JeffreyLiang3449/HFCV-Website/README.md

# Swarthmore College Shell Eco-Marathon Team

Welcome to the Quarto website for Swarthmore College's Shell Eco-Marathon team! This website is documentation for all of the work that has been done to build and maintain the hydrogen fuel cell vehicle (HFCV) that belongs to Swarthmore College's Shell Eco-Marathon team.
