JeffreyLiang3449/HFCV-Website/2024 E90 work/Chassis Model/Chassis Drawn Design.qmd

---
title: Chassis Drawn Design
resources:
  - "Chassis Drawn Design.pdf"
---

{{< pdf "Chassis Drawn Design.pdf" width="100%" height=700 >}}
