JeffreyLiang3449/HFCV-Website/Chassis/Drawings/Rear Connector Dimensions and Quantities.qmd

---
title: Rear Connector Dimensions and Quantities
resources:
  - "Rear Connector Dimensions and Quantities.pdf"
---

{{< pdf "Rear Connector Dimensions and Quantities.pdf" width="100%" height=700 >}}
