JeffreyLiang3449/HFCV-Website/2025 E90 work/Proposal/Salas.Moran.Draft_Project_Proposal.qmd

Engineering Design Project Proposal (draft)

Hydrogen Fuel-Cell Vehicle

Swarthmore College Engineering

December 2024

By Michael Moran Bojorquez '25, Gabriel Salas Carrillo '25

Advisor: Carr Everbach

**Abstract**

This project aims to revitalize the Hydrogen Fuel-Cell Vehicle through its redesign and reconstruction in preparation for the 2025 Shell-Eco Marathon competition. This work will provide key experience in vehicle designing with an emphasis in optimization and fuel-efficiency. It will also further the work into alternative fuel sources and their effectiveness. The project will be accomplished through a mix of literature review, design planning, manufacturing, assembly, and testing. This work will also make use of the research and work done in the previous year to improve the design of the vehicle while also adapting it to the 2025 competition standards. All to create the most safe, simple to drive, and fuel-efficient vehicle possible within the project's time. This project also continues the previous goal of attracting interest and participants to the Hydrogen Fuel-Cell vehicle effort and the creation of a competitive team to annually enter the Shell-Eco Marathon.

**Introduction**

Climate change has progressively become a significant crisis in today\'s world due to a councering increase in the amount of carbon dioxide emissions due to fossil fuel combustion. Gasoline powered vehicles are a major contributor to the acceleration of global warming, leading to extreme weather conditions, rising sea levels, and other economical concerns. The automotive sector being a big contributor has resulted in the advent transition into renewable energy sources, one of them being hydrogen powered vehicles. This greener alternative is a promising solution and a great alternative to gasoline and diesel engines. Through the usage of hydrogen powered vehicles, it can be expected that the contribution to climate change would be lowered.

Hydrogen fuel cells convert hydrogen gas into electricity through an electrochemical reaction. The byproduct of this energy source is water vapor, which is a great alternative to the byproduct of gasoline and fuel which results in carbon dioxide. By converting hydrogen fuel cells it targets to reduce the amount of greenhouse gasses being released into the atmosphere. This urgent

Discussion points (cont talk):

- What is the shell eco marathon competition

- What is focus of the project

- Approach we will take

- Project objective

- Long term vision/expectations (what does it mean to meet expectations)

**Discussion**

The shell eco marathon competition has changed due to new restrictions and rules implemented for the 2025 race. The hydrogen vehicle that Swarthmore College is currently in does not meet the requirements to be able to compete and be successful. To begin, there are many safety issues with the vehicle that will be addressed as the new design of the car is implemented. The vehicle is also very heavy along with having outdated design. The car is able to drive, however in order to compete and strive to win, a lot of new mechanisms need to be set in place that are lightweight and more efficient. The objective of the project is remodel the vehicle with a new design that will ensure success. The following are a list of objectives to be designed and implemented over the given time-line.

- **Chassis and Cowl**

<!-- -->

- **Steering**

<!-- -->

- **Suspencion**

<!-- -->

- **Hydraulic Breaking**

<!-- -->

- **Safety requirements**

**Requirements and Constraints**

The requirements and constraints for the Hydrogen Fuel-Cell Vehicle are defined not only by the physical constraints involved in building a vehicle, but also by the safety and regulations outlined by the Shell-Eco Marathon rules. Below is a list of the major requirements and constraints.

- ***Timeline:*** This is a semester long project, as such, we only have approximately three and a half months to complete the design and construction of the vehicle. The project completion deadline is by the end of April 24, giving enough time to prepare a presentation and a report of the results.

- ***Vehicle Dimensions Constraint:*** The vehicle must be within the specified dimensions for the Shell-Eco Marathon

- ***Vehicle Mechanics:***

  - **Power -** The vehicle is equipped with a 2019 model of Horizon's H-1000 Fuel Cell stack, due to budget and design constraints this fuel cell will not be altered throughout the project. This serves as a limiting factor on the speed and power produced by the vehicle.

  - **Suspencion -** The Shell-Eco Marathon regulations require the integration of suspensions for each wheel of the vehicle. The suspensions were already ordered during previous year's and summers project, so no other suspension will be used for this project.

  - **Steering -** The steering system has been designed, however, it has not been integrated. As such, this will be a constraint due to the need of designing the other components around the already existing steering. However, modifications for the steering system are not out of the question.

  - **Hydraulic Breaking -** Two out of the three vehicle wheels still need the integration of a hydraulic braking system.

- ***Weight Constraint:*** an objective of the project is to lower the weight of the vehicle by a minimum of \~50 lbs. The competition has weight restrictions that must be met.

- ***Budget Constraint:*** As a team of two, our budget is a combined total of 800 dollars.

- ***Safety Constraints:*** Vehicle should be able to break within a determined range and speed. Cowl and roll cage should be rigidly attached to the vehicle and not deform under pressure. Front of the vehicle must be able to crumple to a certain extent to reduce forces on the driver. A fire shield must be implemented between the driver and power cell. Vehicle must also be equipped with a fire extinguisher. Finally, the driver must be able to swiftly and safely exit the vehicle.

**Project Plan**

Timeline (Broad: exact dates TBD):

- Test if fuel-cell works

<!-- -->

- Gain experience soldering + 3D design as well as machining

- We have the chassis design, we need to construct it (important for further implementation)

  - Test integrity of chassis (is it able to hold the driver without crumbling?)

- Design suspension and steering attachments to chassis (can be done while constructing chassis)

  - Test design of suspension before integrating

- Attach the suspension to vehicle

- Integrate braking system after suspension has been implemented

  - Test design for braking systems before attaching to the car - how well does it work? How much friction does it apply before car fully stops

- Attach steering design

  - Test vehicle as a whole (is it able to run? Turn? Break?)

- Design vehicle cowl (and roll cage if needed)

  - Use cad and software to test aerodynamics of vehicle and cowl design. wind-tunnel ?

- Attach vehicle cowl and roll cage

- Run general vehicle tests

- If all is well - work on comfortability and aesthetics.

**Plan Evaluation of Prototypes:**

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

*Summary / Overview:*

- Run multiple trial laps around Whittier parking

  - See if vehicle is able to complete the lap without damage

  - Make necessary adjustments

  - Bumps around the path surrounding Singer will allow for testing suspension

    - If the bottom of the car touches the floor the suspension fails the test

- Test rigidity of suspension and wheels

  - Apply decent force to make sure neither part wiggles too much or detaches from frame

- Build a design with a goal in mind, assemble it, and check if it works

  - Minimum of 3 designs before choosing final product

  - Each design must address a different target/issue

  - Try to aim for simple design that meets requirements

- Communicate with J from the machine shop to get advice given his knowledge on ATV vehicle assembly.

- Steering system must be able to attach to suspension, frame, and wheels

  - Comfortability of use is a must given the limited space available to the driver.

  - Different heights for the steering wheel. Can it be adjusted as needed?

**Project Qualifications**

**Gabrial salas:**

Relevant coursework:

- ENGR 006

- ENGR 012

- ENGR 059

- ENGR 086

Relevant experiences:

- Soldering experience

- CAD design

- Truss Design

- Vehicle Dynamics

- Mechanical Vehicle work

Goal: Design and construct the necessary components for the vehicle to be driven safely. Also improve the performance of the vehicle, with the baseline being the end design from last year. Finally, gain experience in manufacturing and design with an emphasis on efficiency.

**Michael Moran:**

Relevant coursework:

- ENGR 006

- ENGR 012

- ENGR 060

- ENGR 086

- ENGR 087 (Future class)

- ENGR 093 (Directed Reading - Dynamical systems continuation from E86)

Relevant experiences:

- CAD design

- Knowledge on mechanics (vehicle work)

- Welding

- 3D design and printing

- Truss design

Goal: construct the necessary mechanical components of the steering for the vehicle along with the overall design of the vehicle for optimal implementation and aerodynamics of the vehicle. A minor goal is to apply knowledge of mechanics of objects to increase performance of the vehicle.

**Costs and Budget**

+:-----------------------------------------------+:------------------+:------------------+:------------------------------------------------------------------------------------------------+
| **Item**                                       | **Quantity**      | **Price**         | **Notes**                                                                                       |
+------------------------------------------------+-------------------+-------------------+-------------------------------------------------------------------------------------------------+
| Misc materials for testing and implementation: |                   | *200*             | Aluminum and carbon fiber components, bolts, and other misc materials                           |
+------------------------------------------------+-------------------+-------------------+-------------------------------------------------------------------------------------------------+
| Carbon fiber wrap                              | **20 sheets**     | *500*             | Need to wrap car in carbon fiber for lighter weight implementation (replaces aluminum chassis). |
+------------------------------------------------+-------------------+-------------------+-------------------------------------------------------------------------------------------------+
| New helmet                                     | **1**             | **\~**100         | Old helmet is missing and does not meet safety standards.                                       |
+------------------------------------------------+-------------------+-------------------+-------------------------------------------------------------------------------------------------+
| **Total Cost**                                 | **800**                                                                                                                                 |
+------------------------------------------------+-----------------------------------------------------------------------------------------------------------------------------------------+

Appendix A: source on suspension

- [[https://books.google.com/books?id=L_dqjIjOGBcC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]{.underline}](https://books.google.com/books?id=L_dqjIjOGBcC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)
