JeffreyLiang3449/HFCV-Website/2025 E90 work/Designs/Brake/Brake Stand Drawing v1.qmd

---
title: Brake Stand Drawing v1
resources:
  - "Brake Stand Drawing v1.pdf"
---

{{< pdf "Brake Stand Drawing v1.pdf" width="100%" height=700 >}}
