JeffreyLiang3449/HFCV-Website/2025 E90 work/Designs/Suspension/Suspension Plate Drawing v1.qmd

---
title: Suspension Plate Drawing v1
resources:
  - "Suspension Plate Drawing v1.pdf"
---

{{< pdf "Suspension Plate Drawing v1.pdf" width="100%" height=700 >}}
