JeffreyLiang3449/HFCV-Website/2026 Shell Eco Marathon/HFCV_ Instuctions for 11_5_.qmd

2 people will continue to drill holes to clear supports in the clips.

> Make sure drill bits are the right size. Small holes and the big holes in the middle of the bottom floor clips are different sizes

Install new suspension into frame

Top floor is placed on top of the car

Bottom floor is set on the side

Line all floor pieces with \~2in. blue tape border to mark where to drill holes for clips

Mark where flat cowl connectors will go between bottom floor pieces approx 1 connected every 3 ish inches. See diagram below

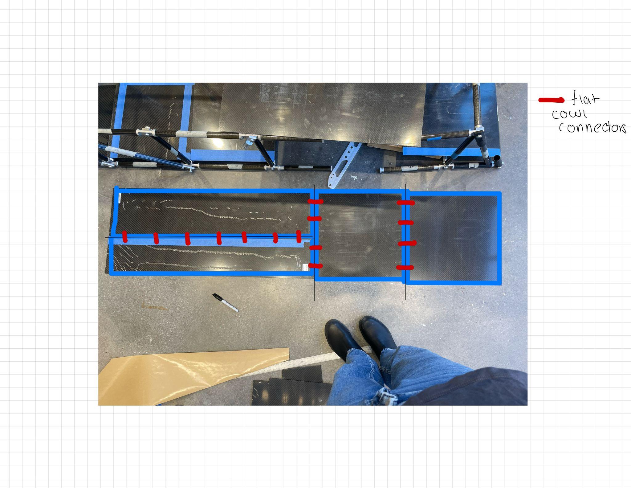
[picture p19: 2026 Shell Eco Marathon/media/media/image1.jpg]
