JeffreyLiang3449/HFCV-Website/2026 Shell Eco Marathon/HFCV_ Freshman Interviews.qmd

Notes about individuals

Questions:

Ask about themselves

Where are you from

How your classes

What are you interested in

Actual Content

What are you interested in

What prior experience do you have

How well do you take direction

How well do you work by yourself or in a team

What do they prefer

Reiterate commitment (2-3 hrs per week) (multi year)

1.  ~~Bowen Shi~~

- F1 in school - testing engineer

- Mechanical Engineering

  - aero/fluids

  - ANSIS experience

- Little to no fabrication experience

  - Some materials testing

- More interested in design

- Potentially an option for a driver

2.  **Rawasy Almaksoudi (6)**

- Not a freshman

- Career goal: Biomechanical

- Mechanical interest

- Robotics Background FRC Mojo 8085

- Interested in running the club

- Fabrication experience

  - Epoxy resin

- Would be willing to do the admin/sbc work

3.  Isabella Hemler (Izzy)

- Freshman

- Career goal: Civil Engineering

- Moldable background

  - Fabrication experience

- Maybe have joining just see if engineering is a fit

- Odyssey of the Mind (Car problem)

- Maybe driver, needs a driver license

  - We can figure that out

- Buddy

4.  **Kinley Zangmo**

- Bhutan

- E17, Physics 5, Math 15

- Engineering + Physics

  - Mechanical + Aero very moldable

- Panoptis Project

  - Build telescope

  - **Hardware + wiring**

- Driver, but is perhaps too light

- Willing to explore admin

- Jano replacement

5.  **Sean Tian**

- Freshman

- Chem 11, E17, Math 27

  - At multi

- Engineering + Physics

  - Robotics

  - Mech + Computer + Electrical

  - But doesn't really know

- FRC 6907

6.  **Stella Saad**

- Freshman

- Engineering School Background

- Engineering, Chem bio double minor, maybe neuro

  - Want to take more mechanics

  - Elecrtrical background

- Soldering experience

- Chem 10, Math 15, Econ 1, E17

- Soccer player

- Willing to contribute time

7.  Avian Pham (?)

- Texas

- Freshman

- Engineering and Astrophysics

  - Space research

  - Aero

- Fabrication

  - Engineering in HS

  - Set Crew

  - Scene Student Tech

  - Wood

  - Metal

- Has time

- Fire safety experience

8.  Magnus Julin

- Freshman

- Engineering + CS

  - ambiguous

  - Electrical - like the puzzle aspect

  - Motorsport interest

- Circuits + EE course

- Design with CAD

  - Went andover

- Rockets (?) + robotics

  - FRC

- Not a lot of work in a team

- Fabrication

  - Power tools

  - CNC

  - Epoxy resin

  - Works on cars

9.  **Matthew Kim**

- Engineering and CS

  - Mechanical + aero

- Irving California

- Swim team

  - Chooses to do IM

- Discipline

- No "prior" experience

  - Admin work (HUGE)

10. David Nuth

- Quiet

- Engineering and Japanese (minor)

  - Mechanical/Aero

- Highschool Robotics

  - Build Captain for VEX

  - FRC 6833 + VEX (VRC)

  - Cutting and bending metal

    - standard , no cnc

- Aerodynamics

- Fencing on campus

- Working on more of the car parts

  - Braking

  - Steering

11. Ben Greenberg

- Chem 11, E17, Math 25, FYS

- Mechanical Engineering

  - Just generally for now

  - No idea what career, maybe hardware

- Highschool

  - FRC 5490

    - Small team

    - Showed up everyday

    - Take direction weel

  - Ceramics + Photography

  - Tennis - Doubles

- Ceramics club here

- Research with Towles

  - Opera

- Boxing Club

- Modeling/3D printing focused

12. Jose Quiroz Mariche

- E17, Math 15, PHYS 003, Logic

- Mechanical

  - Things that move

  - Not super analytical

- Just engineering

- Prior Experience

  - EPICS projects

  - ASU

  - Build project that supports community

  - Figure out more seating arrangements

  - Made bench, materials research, budgeting

  - Woodworking

  - 3D modeling

  - Laser

- Some team sport

- Wanted to get involved in photography

13. Nathan Schwarz

- PHYS 005, Linear Algebra, Communism Class

- Physics and Engineering

  - Electrical

  - Energy science - Plasma Physics

- Prior

  - Heavy physics background

  - Circuits backgrounds

    - Radios, etc.

  - Fusion

  - Power lifting

    - Not really a team sport

  - Soccer

- All around a "good" person

- Preference for work

  - LOOKING FOR WORK

  - Fuel Cell

- Interested in how the fuel cell works

14. Auden Seigel

- E17, E11, Linear, Literature and Law (Engl)

- Engineering and Econ

  - More management

- Mechanical Design,

- Want hands on experience in a group

- Willing to admin work

- Prior Experience

  - Electrical foundations but not super interested

  - Sheet metal factory work

    - Floor worker, on **machinery**

    - Shadow main engineers, CAD design

- Highschool

  - Editor of newspaper -\> time sink, staff of 100

  - Sports: Soccer, Lacrosse, Cross Country

- Ok with commitment, expects multi year

- Receptive to how I give work

15. Fate MacAlasdair -no

16. Jasper Goldstein

- E11, E17, Linear, Philosophy

- Engineering + Physics and Math

  - Focus in aerospace/mechanical

    - Interested in space exploration

    - F1

- Prior Experience

  - Engineering and Robotics club

    - Not competitive

  - Hands on experience

  - Design and prototyping

- Aerowork + learning about fuel cell works

- Electrical experience

  - E+M in HS

- Free and happy to learn

- Highschool

  - Community Center Volunteer

  - Track and Field

- Will do track here

17. Nolan Weygandt

- In a History under Stalin and Lenin

- Swimmer 200 IM, 200 back, 200 free

- Engineering + Minor in Math or Physics

  - Nuclear (Fission)

  - Mechanical

- Likes creating

  - Ceramics

  - Leatherworking

- Woodshop certified

- 3D modeling

- Highschool

  - Rocket Club ? Robotics?

  - Swam

  - F1

  - Coaching (6-15)

- Feel comfortable putting things together

- Manufacturing

- Open to most things

18. [[Jasper Mosley]{.underline}](mailto:jmosley1@swarthmore.edu) -yes

    a.  Interested steering and other mechanical aspects

        i.  Experience with calculating steering parameter (steering radius, etc) but this work was done on a tank so slightly different, regardless good experience

        ii. Experience with machining in Jays shop (was working in there all summer) and lots of 3d printing experience

    b.  Lots of planning with multiple iterations, will build and see if it works and if it doesn\'t will rebuild, always keeps lots of documentation etc. (big into and picture taking)

    c.  Lots of engineering projects where he collaborated with people, (the tank he built was with a group),

    d.  Can dedicate several hours a week

    e.  Looking to work on this project junior and senior year and compete

19. Hans

    a.  Interests are more mechanical

        i.  Found interest when building stuff at home and he found it very fun and wanted to continue hands on stuff, excited about the chance to work on a team and have a product he and the team can be proud of

        ii. Excited to learn from others on the team

    b.  Previous projects, built multiple PC's, basic stuff

        i.  Like mounts for stuff

    c.  Skills

        i.  3d printers, soldering

    d.  Has worked on a project where he worked with a group to find an idea, design, and then execute -\> modeled it all in solid works

    e.  Just try something new and experience it, and if he enjoys it he would definitely do it the whole time, hes pretty confident he would work on it a lot

    f.  He is pretty free right now, weekend free

    g.  No preference on what to work on

20. Jonas (freshman)

    a.  Works on cars already

        i.  Usually just mainteneces

        ii. Widebody kit, cold air intake

    b.  Interested in mechanical

        i.  Internship in electrical

            1.  Sustainability consultancy in electrical engineering

            2.  Troubleshooting at project sites, testing hvac site, performed tested

        ii. More interested in elecrtriacl engineerings

        iii. No shop experience

    c.  3d modeling in school,

        i.  Over the summer modeled a prototype for a cash clock

        ii. Small alarm clock with lcd screen, outershell and front shell,

        iii. Design process, asked for a budget

        iv. Then designed it, already knew what pieces to use in that project and them designed a shell on **OnShape** and 3d printed

    d.  Teamwork work in the company that he worked in team with the company

    e.  Available in the evenings after 5pm cause of labs, 4/5 days of week available and weekend too

    f.  He looked into the club and other similar schools and is very interested in working on this for several years

    g.  Interested in aero

21. Jeffery Liang - strong maybe

    a.  Engineering major, potentially physics or cs double major

    b.  Why interested in this club?

    c.  Interested in electrical engineering

        i.  Background in arduino stuff

        ii. 

    d.  Robotics team in highschool

        i.  Vex as coder and builder

        ii. Would sketch out blueprints, based off example and modified those examples to meet thei needs

    e.  Other engineering projects

        i.  Cardboard boat race (part of enigneering) won that race

            1.  Worked on a team

            2.  Helped with calculations

    f.  Engineering team in highschool

        i.  Built lots of things there

    g.  Some engineering modeling

        i.  3d water bottle holder, has had multiple interactions

    h.  Lots of availbailtiy, wants to be part of building team but more interested in electrical componenet, looking to work on this for several years

    i.  Went to poster presentation

22. Evan 10/2

    a.  Not

    b.  No real engineering projects outside of swarthmore class

    c.  Made minesweep in a cs project

    d.  Wordshop certified

    e.  3d printing,

        i.  Mostly callibration stuff

    f.  Interested in anything

    g.  Sophomore year

23. Alex Lyu - ask judah about him

    a.  Thought project was cool, gain engineering experience

    b.  Interested in [electrical part]{.underline}

        i.  No experience

    c.  Highschool anti earthquake design

        i.  Design

            1.  Starting looking at real life models and how they work and how they could be implemented into our models

            2.  Then lots of sketching

            3.  Then started building

        ii. Group of four

            1.  All collaborative

            2.  Likes working in a group, different opinions can learn a lot from other people

    d.  3d printing

        i.  Some experience with 3d printing

    e.  CS experience, some python, some C++

        i.  Might minor in cs

    f.  Pretty much always free at night

    g.  On golf team

    h.  Could work on it all four years
