JeffreyLiang3449/HFCV-Website/2026 Shell Eco Marathon/HFVC Indiana Logistics.qmd

**Hotel:**

[[Holiday Inn Express & Suites Indianapolis W - Airport Area]{.underline}](https://www.google.com/travel/search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)

3 Rooms 4/6/2026 - 4/11/2026

1 Rooms 4/6/2026 - 4/12/2026

[Drivers]{.underline}

Mathew

Eric

Kaw

Kimaru

To Indianapolis: AA 4637, 4/6/2026 6:40pm

> Nora
>
> Kinsley
>
> Izzy H.
>
> Place Holder
>
> Driver 3
>
> Driver 4

*Two separate bookings back to Philadephia:*

AA 5285 4/11/2026 3:54pm

Nora

> Kinsley
>
> Izzy H.
>
> Place Holder
>
> Driver 1
>
> Driver 2

AA 3097 4/12/2026 7:15pm

Alexander Vasquez-Jaffe

Supplemental Funding Request

Hello,

We have recently decided to attend the Shell Eco Marathon Competition in Indianapolis this spring. The competition dates are April 7th to April 11th. The Swarthmore Engineering department has agreed to cover the cost of all flights to and from Indianapolis and all hotels in Indianapolis. They would like SBC to cover the cost of the per diems.
