JeffreyLiang3449/HFCV-Website/Editable Documents/HFCV_Goals and Expectations.qmd

1.  A permanent standing meeting per week.

- I don't see the need to meet if everyone has nothing new to share

- Will figure out a time that works for everyone

2.  Progress over the summer

- Fine tuned manufacturing techniques

- New design because Ben and Justin's did not work

- New suspension, steering, and wheels

3.  Overall Goals for this year

- Chassis

  - At least in the first semester this means mainly structural and mechanical engin. less focused on electrical

    - If have friends interested have them talk/email me

  - Electrical will come into play when chassis is built and we need to wire the new car

- Cowl

  - I have no idea if Roe still wants to do it

  - If not, someone else will

4.  Requirements for now

- Please read the literature in the folder shared

- Talk to J and get used to the manufacturing techniques that are written up

- Any questions, comments, or concerns ask me

  - Try not to bother Jano, let the guy live

5.  Things to work on

- When wheels come in, designing axel to work with suspension and steering

- Fabricating chassis
