JeffreyLiang3449/HFCV-Website/2024 E90 work/Fall _23 Prework/Prototype Rules - Hydrogen Carr.qmd

**Key Things We need to add/test:**

- Mechanicals

  - Monocoque (advantage: crumple design) or chassis

  - Turn Radius Test and Adjustment (currently in compliance)

    - Might want to improve current tie rod system

  - Dimensions of current vehicle **(Sticking with current design)**

  - Hydraulic braking system (need full outfit - possibly bike parts if routing is feasible

    - Potential frame modifications for hydraulic design

  - Single wheel suspension (thinking telescopic fork - think motorcycle suspension)

- Safety systems

  - Horn test

  - Safety belt

  - Roll bar

  - Bulkhead for division of energy and driver systems

- Competition Documentation

  - Energy supply and propulsion system block diagram

    - H2: Fuel cell, cylinder, solenoid valve, pressure regulator, flow meter, motor controller, motor, supercapacitor, vehicle cut-off mechanism

  - Electrical Schematic

  - Battery/BMS (If a Lithium-based accessory battery is included in the vehicle)

  - Brake Documentation

    - Brake Documentation: provide manufacturer's documentation at the lowest level of purchased components. See Articles 43 and 51.

  - Energy Supply and Propulsion System Diagram

  - Fuel Cell

Sources:

Steering systems - [[Steering (springer.com)]{.underline}](https://link.springer.com/content/pdf/10.1007/978-3-662-60835-7_3.pdf)

Goals: New body fuel cell vehicle running(even if crudely) by end of spring semester

- New Chassis

- Suspension + wheels

- Brakes

- Crude turning

- Electrical+Fuel Cell

Design Considerations + Constraints - Body:

Option for taller driver -\> Biomechanics for 6ft person + weight of 250+ minimum

Design for weight as well

All height/length/width specs met

Round tubing design preferred

10 cm Crumple Zone

Wiring and Hydraulic considered and space efficient

Center of gravity consistently low enough to avoid roll

Considerations for wheels + suspension:

Ideal system for speed

~~Current timelines/time estimation:~~

~~Body-\>1 month for execution~~

~~Brakes -\> 1 month for execution~~

~~Tuning -\> 2 weeks~~

~~Safety -\> 1 month for execution~~

~~Brakes/Suspension/Body/Safety/Tuning~~

Article 16: Radio Communication The use of hand-held communications is forbidden in the vehicle. However, the use of a "hands-free" kit is allowed if both hands of the driver remain on the steering system

Article 17: Overtaking a) Drivers are required to give clear passage for other vehicles wishing to overtake. b) Drivers in overtaking vehicles must sound their horn and pass with caution. The Driver of the overtaking vehicle is responsible for the safety of the manoeuvre. c) Drivers of the vehicles being overtaken must use their mirrors and must not change course suddenly. d) On the track, overtaking is authorised on both the right and the left, provided the above-mentioned safety rules are followed.

Article 20: Driver Weight a) **The minimum Driver Weight is: Prototype vehicles -- 50.0 kg**

The Driver Weight is defined as the weight of the person driving the vehicle including full driving gear and communication devices. If the Driver Weight does not meet the minimum weight requirement ballast needs to be fitted to the vehicle. This ballast must be provided by the Team, in form of weightlifting discs or rectangular metal plates. No other form of ballast is permitted. The ballast must be effectively secured to the vehicle to ensure Driver safety in the event of collision or roll-over. For Urban Concept vehicles the ballast must be outside the driver compartment. A seal will be installed around the ballast by a technical inspector and must remain in place during the event. If the seal has been tampered with or removed the vehicle will no longer be valid to compete. The ballast must be in a single pack. c) If a Team has two Drivers and one or both Drivers are underweight, the ballast weight will be based on the lightest driver.

Article 21: Helmets a) For practice and competition, Drivers must wear full-face or three-quarter helmets suitable for motorsport activities. Drivers in the Prototype category must use the three-quarter helmet variety. Helmet certification labels must be clearly readable. Helmets worn by all Drivers will be subject to inspection. Helmets should not have any indentations or cracks and should be in proper working condition as intended by the helmet manufacturer. b) All helmets must be affixed with a face shield (or visor). The face shield (or visor) must cover from the top of the face down to below the driver's nose. Tinted face shields or sunglasses to be worn under the face shield are permitted. The helmets must correctly fit the Driver and be secured by a chin strap. Visors should be free from major scratches and have clear visibility.

Article 22: Driver Clothing a) All Drivers must wear a one-piece racing suit as the outermost layer of clothing, and the racing suit must be classified as Flame Retardant Clothing (FRC) according to a recognised standard. Drivers are not allowed to wear synthetic clothing underneath the race suit because synthetic material may melt if exposed to flames. Cotton shirt and underwear are recommended. b) Socks (made from cotton or FRC material) and shoes are required. c) Fire retardant gloves are required and must completely cover all fingers. d) If Drivers wear balaclavas, they are required to be made from FRC material. e) No bare skin should be visible when the Driver is wearing the racing suit, gloves, socks and shoes.

Article 23: Driver Comfort Please note that in the event of hot weather conditions, high temperatures may affect Driver comfort and potentially cause heat stress. a) It is recommended to properly ventilate the inside of the vehicle to provide cooling to the Driver. b) It is recommended to provide sufficient drinking liquids to the driver for the duration of an attempt. **If fluid containers are provided to the driver(s), these containers must be hands-free. Camel-back style or bottles secured inside the driver's compartment with flexible feed straw are recommended.** c) It is recommended to equip the vehicle with an **effective shield from the sun**. d) For driver comfort, Teams can install fans or air-cooling type systems that are not included in the electrical measurement of the vehicle. Any fans or air-cooling systems must be self-powered by internal batteries. See Article 57i.

Article 24: Equipment and Materials Teams are required to provide and use at the event: a) Leather, canvas or other cut resistant gloves for general work, including movement of vehicle b) Chemical resistant gloves for fuel or motor oil handling c) Safety glasses for all Participants d) Hearing protection for all Participants e) Duct tape to secure cords or cables lying on the pit floor f) Lift stands or appropriate raised platform for vehicle tuning and repairs g) Tools and materials h) Effective equipment suitable to mitigate and/or control Lithium-based battery fires must be used during battery charging. The equipment must prevent or contain the spread of fire or battery event during charging. Equipment that may be used includes: i. A battery charging bag that is designed specifically for containment of a Lithium battery fire, or A fireproof blanket that can be placed over AND under the lithium battery being charged. The blanket must be big enough to fully cover and contain any potential battery fire.

) Electrical safety i. All electrical equipment used must be properly fused. ii. Electrical cables must be in good condition and appropriate for the equipment it is intended for. iii. Teams are only allowed to use the supplied single multi-plug strip with internal overcurrent protection. No further multi-plug strips or other adaptors may be used.

Article 25: Vehicle Design a) During vehicle design, construction and competition planning, participating Teams must pay attention to all aspects of safety, including the safety of the driver, participants, volunteers and spectators. i. Prototype vehicles must have three or four running wheels that are in constant contact with the road. ii. All vehicles must have a minimum crumple zone of 100 mm between the front of the vehicle body and the driver's feet

Aerodynamic appendages, which adjust or are prone to changing shape due to wind, are not allowed. c) Vehicle bodies must not include any external appendages that might be dangerous to participants; this includes pointed parts of the vehicle body. Sharp points must have a radius of 50 mm or greater or be covered with foam or a deformable material. d) Vehicle body panels and windows must be rigid and may not change shape due to wind. e) The vehicle interior must not contain any objects that might injure the Driver in the event of a collision. Windows must not shatter into sharp shards. Protective film covering the windows is allowed but must not distort the driver's visibility. f) The energy compartment (engine/motor/transmission/battery, etc.) should be easy to access for a quick inspection. g) All parts of the drive train, including fuel tank, hydrogen system components, etc. must be within the confines of the body cover. h) All objects in the vehicle must be securely mounted. Bungee cords or other elastic materials are not permitted for securing heavy objects. i) All vehicles must have a solid floor and frame that prevent any part of the driver's body from contacting the ground. j) All vehicles must be fully covered. Open top vehicles are not allowed. Vehicles that look like bicycles, tricycles or wheelchairs are not acceptable. k) The Organisers will provide all Urban Concept vehicles and selected Prototypes with a telemetry System and require them to install it in their vehicle for competition monitoring and result calculation (see Section 5). l) The use of asbestos and asbestos-containing materials is forbidden

Article 26: Chassis/Monocoque Solidity a) Teams must ensure that the vehicle chassis or monocoque will safely protect the driver's body, including crumple space in the event of a front, side, or rollover collision. A monocoque is a construction that supports structural load by using an object\'s external skin as opposed to using a frame. b) The vehicle chassis must be equipped with an effective roll bar that extends 50 mm around the driver's helmet when seated in normal driving position with the safety belts fastened. If this position impairs the driver visibility it will be deemed that the roll bar is not adequate. The effectiveness of the roll bar and driver's visibility will be validated simultaneously, i.e. the driver must not be in such position that he or she must raise their head or torso above the roll bar to pass the visibility test

**c) The roll bar must extend in width beyond the driver's shoulders whe**n seated in normal driving position with the safety belts fastened. Teams may use a tubular or panel roll bar. If a tubular roll bar is used, it must be metal. A panel roll bar is the rigid partition separating the cockpit from the energy compartment, and it must be integrated into the vehicle chassis or monocoque. d) The roll bar must be able to withstand a static load of 700 N applied in a vertical, horizontal, and/or perpendicular direction, without deforming in any direction. e) If the vehicle must be lifted at a specific place on its body, it should be clearly marked with a rectangular box stating, "LIFT HERE".

**Article 27: Propulsion and Energy Storage System Isolation a**) A rigid Bulkhead must safely isolate and seal the vehicle's propulsion and energy storage systems from the driver's compartment. A bulkhead is an upright partition separating the driver's compartment from the energy compartment. This means engines, fuel cells, fuel tanks, batteries (propulsion or accessary), hydrogen cylinders, supercapacitors, etc. must be placed outside the driver's compartment behind the bulkhead. The purpose of this bulkhead is that in the event of a fuel leak, fire or battery release incident, it prevents liquids and/or flames from reaching the driver. Avoid having any gaps or holes between the body and the bulkhead. It is recommended to seal gaps with materials such as metal/aluminium sheeting or aluminium tape. b) The bulkhead must be able to protect the driver from an open flame in the energy compartment. c) The bulkhead must prevent manual access to the energy compartment by the Driver. d) If holes are made in the bulkhead to pass through wires or cables it is essential that the wires and cables are protected by a grommet or similar protective material to prevent chafing or damage. All gaps and holes must be filled.

Article 28: Visibility a) The Driver must have access to a direct arc of visibility ahead and to 90° on each side of the longitudinal axis of the vehicle. The Driver's field of vision must be achieved without aid of any optical or electronic devices. Movement of the Driver's head within the confines of the vehicle body to achieve a complete arc of vision is allowed, but the driver's helmet must always be 50 mm below the roll bar. The side windows tinting must be light enough to allow the driver to be seen from outside the vehicle. b) The vehicle must be equipped with a rear-view mirror on each side of the vehicle, each with a minimum surface area of 2500 mm² (e.g. 50 mm x 50 mm). An electronic device may not replace a rear-view mirror

**Article 29: Safety Belts Roll Bar & Safety Belts a**) The Driver's seat must be fitted with an effective safety harness with at least five mounting points to maintain the Driver securely in his/her seat. The five independent belts must be firmly attached to the vehicle's main structure and be fitted into a single buckle, specifically designed for this purpose. b) The safety harness must prevent any upward or forward motion of the Driver's torso. Any slack in the harness must be adjusted by using the seat belt length adjuster. The adjustor must be located as close as possible to the connection point. The crotch strap mounting point must be underneath the body, and the topmost straps must be mounted below the top of the Driver's shoulder. c) The safety harness must always be worn sufficiently tight and fastened to prevent the Driver from having free movement when the vehicle is in motion. d) Each safety harness mounting point must be able to withstand a 200 N force in any direction. e) The Urban Concept vehicle safety harness must be specifically manufactured for motorsport use (e.g. certified or compliant with FIA standards).

Article 30: Vehicle Access a) It is imperative for Drivers, fully harnessed, to be able to vacate their vehicles at any time without assistance in less than 10 seconds. For Urban Concept vehicles, this is applicable for both doors. b) Prototype vehicles must be equipped with a sufficiently large opening for the cockpit. The driving position must be designed so that emergency services can easily extract the Driver from his/her vehicle, if necessary. c) The driver compartment must have a single opening mechanism per door, which must be easily and intuitively operable from both inside and outside the vehicle. The method of opening from the outside must be clearly marked by a red arrow and must not require any tools. d) It is forbidden to use adhesive tape to close the Driver's opening from the outside.

**Article 31: Horn a) Each vehicle must be equipped with an electrically powered horn typically used in current automobiles. Bike or cycling horns are no longer permitted. b) The horn must be mounted at the front of the vehicle without obstruction. c) The horn must emit sound greater than 85 dBA when measured 4 meters in front of the operating vehicle. The horn must produce a continuous single tone sound when activated \-- chirping or sirenlike tones are not permitted. d) The horn must be powered by the vehicle battery. The power consumed by the horn does not need to be measured by the Joulemeter (See Article 56:d)v).**

Article 34: Clutch and Transmission a) All vehicle propulsion must be achieved only through the friction between the wheels and the road. b) All vehicles with internal combustion engines must be equipped with a clutch system. c) For centrifugal/automatic clutches the starter motor speed must always be below the engagement speed of the clutch. d) Only Urban Concept Internal Combustion Engine vehicles are required to have idling capabilities. This means the vehicle must be able to remain stationary while the engine is running. e) For manual clutches the starter motor must not be operable with the clutch engaged. An interlock is required to facilitate this functionality. f) Please refer to Article 64:b) regarding starter motor requirements. g) Guards for transmission chains and/or belts are mandatory. This is required to protect driver or technician when working on the car in the event of the chain or belt breaking. It must be made of metal or composite material rigid enough to withstand a break.

Article 35: Exhaust System a) The exhaust gases must be evacuated outside the vehicle body. b) Exhaust pipes must not extend beyond the rear or the side of the vehicle body. c) Exhaust pipes must be solid with no signs of fatigue or leaks. d) Exhaust pipes must be appropriate for high temperatures

**Article 39: Dimensions a) The vehicle maximum height must be less than 1000 mm. b) The vehicle track width must be at least 500 mm, measured between the midpoints where the tyres of the outermost wheels touch the ground c) The ratio of height divided by track width must be less than 1.25. d) The vehicle wheelbase must be at least 1000 mm. e) The maximum total vehicle width must not exceed 1300 mm. f) The maximum total length must not exceed 3500 mm. g) The maximum vehicle weight, without the Driver is 140 kg. h) None of the body dimensions above must be achieved by design singularities such as 'stuck-on' appendages or cut-outs.**

a\) All types of tyres and wheels are allowed. b) Any type of wheel rim may be used. Rims must be compatible with the dimensions of the selected tyres to satisfy safety standards. Bicycle wheels are not generally designed to support substantial lateral cornering forces, such as may be found in Shell Eco-marathon vehicles at certain speeds. The wheel axles must be designed for cantilever loads (like in wheelchairs) rather than for load distributed equally on both sides (like in bicycles). c) Wheels located inside the vehicle body must be isolated from the Driver by a bulkhead and must not touch the chassis or body. d) Any handling or manipulation of wheels by the Driver is forbidden from the moment the vehicle is at the starting line until it crosses the finish line. e) All installations must be carried out in a way that there is no likelihood the wheels will touch other parts of the vehicle (i.e. cables, wires, hoses, and energy compartment components like batteries, etc.). These must be safely mounted/secured so that they cannot interfere with the turning wheel during driving and cause accidents.

**Article 42: Turning Radius and Steering** a) Only front wheel steering is permitted. If the Organisers are not satisfied with the effectiveness and/or control of a vehicles steering system, this vehicle will be removed from the competition. b) The turning radius must be 8 m or less. The turning radius is the distance between the centre of the circle and the external wheel of the vehicle. The external wheel of the vehicle must be able to follow a 90° arc of 8 m radius in both directions. The steering system must be designed to prevent any contact between tyre and body or chassis. c) Electrically operated indirect steering systems are permitted providing they are operated by a steering wheel or similar (rotary potentiometer), joystick operation is not permitted. If electronic steering systems are used, in the event of system failure, the vehicle must be equipped with manual steering override. d) The Organisers reserve the right to set up a vehicle handling course to verify the following when the vehicle is in motion: driver skills, turning radius and steering precision. For example, the Organisers will verify that steering is precise, with no play

**Article 43: Braking Braking a) Vehicles must have two hydraulic braking systems, one per axle. Brakes that act on the tyres a**re not permitted. i. The front brake(s) must have a single foot operated pedal controlling front wheel(s). ii. The rear brake(s) must have a single lever action attached to the steering wheel or a single pedal. iii. For each axle, a maximum of two master cylinders is allowed, but they must act on single hydraulic circuit to ensure a proper balance between right and left wheel. One master cylinder per wheel is not allowed. iv. It must be possible to activate the two brake systems at the same time without taking either hand off the steering system. b) The effectiveness of the braking systems will be tested during vehicle inspection. During the Technical Inspection, the whole brake system must be visible. The vehicle will be placed on a 20 percent incline with the driver inside. Each brake system will be activated separately, and each individual brake system must keep the vehicle immobile. c) During practice or competition runs, the brakes must be protected against any adjustments made by the driver. The effectiveness of the protection will be evaluated during technical inspection and rechecked before entering the track. In addition, vehicles will be checked at the start and/or finish area. Any system that has been compromised will invalidate that run and a penalty may be issued by the Organisers.

**Article 65: Hydrogen Fuel Cell Vehicles:**

1.  a\) Fuel system

    a.  i\. Participants must provide a description and a process flow diagram of the fuel supply system.

    b.  ii\. The fuel system must be easily accessible for inspection and measurements.

    c.  iii\. The fuel cell must run by itself. The electricity needed for temperature regulation, fan, compressor, electronic management system for the fuel cell and the electric motor must be supplied by the fuel cell and not by the accessory battery.

    d.  iv\. The hydrogen system must be designed as follows: H2 cylinder Pressure gauge Pressure regulator directly attached to the cylinder Pressure gauge Emergency shutdown valve directly attached to the outlet of the pressure regulator Flow meter Fuel Cell (note: pressure gauges may be an integral part of the regulator)

    e.  v\. The flow meter must be fixed at the inlet of the fuel cell. Both must be at the same pressure.

2.  b\) Hydrogen cylinders

    a.  i\. Fuel cell-powered vehicle must use a compressed hydrogen cylinder, referred to hereafter as a cylinder, as provided by the Organisers during the entire event. Only one cylinder may be fitted to a vehicle.

    b.  ii\. Teams must not bring their own hydrogen cylinders or cartridges. Cartridges and other means of hydrogen storage are not permitted.

    c.  iii\. The following cylinders will be provided by the Organisers: Europe and Africa: B1 cylinder, 1 litre of hydrogen at 200 bar (100 mm x 350 mm) 2.57 kg and B04 cylinder, 0.4 litres of hydrogen at 200 bar (60 mm/320 mm) 1.4 kg Americas: Exchange cylinder \~ 152 bar 5.3" x 17.1" (135 mm x 434 mm), 8.6 lbs. (3.9 kg) Aluminium Cylinder \~ 68 bar 2.5" x 9.5" (63 mm x 241 mm) Asia Pacific and Middle East: Catalina MD cylinder, 2.9 litres of hydrogen \@139 bar (111 mm x 424 mm), 2.4 kg

    d.  iv\. Only one hydrogen cylinder will be supplied at a time. A new cylinder will be provided in exchange for an empty one. All cylinders will be labelled with a specific number to ensure traceability. Cylinders must be returned to the Organisers before paddock closure. No cylinder shall remain in the pit area after paddock closure. It is recommended that a single team member, who has hydrogen experience, be identified as the person to be responsible for handling the hydrogen cylinders.

    e.  v\. All cylinders must be installed on the vehicle under the supervision of the Technical Team. Participants are not allowed to keep any cylinders in their possession overnight. The cylinders must be stored in a location designated by the Organisers suitable for hydrogen storage in the paddock. Upon arrival at the circuit, Team Managers must contact the Technical Team, who will organise all relevant logistics. A suitable location would include proper ventilation, distance away from any possible ignition sources, secured to avoid accidental damage.

    f.  vi\. The cylinder must be installed securely in the vehicle to minimise movement and stress on pipework when the vehicle is moving.

    g.  vii\. When the cylinder is not installed in the vehicle, a blind cap shall be installed on the cylinder outlet.

3.  c\) Ventilation The vehicle body must allow for ventilation at the highest point of the fuel cell compartment, providing an orifice with a minimum opening of 500 mm². Another 500 mm² opening must be provided at the highest point of the driver compartment.

4.  d\) Hydrogen detector

    a.  i\. A hydrogen sensor must be installed in the fuel cell compartment, near the main ventilation orifice mentioned above. This hydrogen sensor must drive the emergency shutdown valve and relay mentioned below. The trip level of the hydrogen sensor must be tuned to 25% of the LEL (Lower Explosive Limit) of hydrogen, i.e. 1% of hydrogen in air. A test will be carried out during the technical inspection. For commercial Fuel Cells with integrated H2 detector it is still required to fit a H2 sensor as described above.

    b.  ii\. The reset of the hydrogen detector, i.e., the hydrogen sensor and its electronics, must be done manually via a switch located in the fuel cell compartment. This switch must not be accessible by the Driver from the cockpit.

5.  e\) Emergency shutdown valve and relay

    a.  i\. The hydrogen supply circuit must be equipped with a solenoid emergency shutdown valve. This valve must be normally closed in the absence of electricity. ii. The power supply to the motor must be automatically cut off at the same time as the above emergency shutdown valve is activated. This is to be achieved by a suitable fail-safe relay.

    b.  iii\. The operation of the emergency shutdown must provide a physical removal of power to the emergency stop circuit. The use of a power controller or other logic systems to drive the emergency stop circuit is not permitted. The emergency stop circuit must be designed as failsafe. A fail-safe design makes the emergency shutdown system as tolerant as possible to likely wiring or component failures. The most common type of wiring and component failure is an "open" circuit, or broken connection. Therefore, a fail-safe design should default to its safest mode of operation in the case of an open circuit.

    c.  iv\. This valve and relay must be activated by any one of the following three scenarios: 1. Through hydrogen detection as explained above 2. Through the emergency push-button located on the outside of the vehicle. The emergency shutdown sticker provided by the Organisers must be positioned on the vehicle body to clearly indicate the place of this emergency push-button. (See Article 37:f). 3. Through another emergency push-button, accessible by the Driver in driving position

    d.  v\. In case of activation by one of these three scenarios, the valve and relay must act simultaneously.

    e.  vi\. These three scenarios will be tested during Technical Inspection and before each attempt.

6.  f\) Pipes and connections of the hydrogen circuit

    a.  i\. In all cases, piping and connectors of the hydrogen circuit must be designed for hydrogen use. The Team Manager must be able to present during the technical inspection the technical data sheets from the manufacturer of these piping and connectors to show that they are suitable for hydrogen use. The use of PTFE pipes is recommended. PU tubing should not be used as this tends to leak. Leak checks on all hydrogen piping and connectors will be performed in Technical Inspection.

    b.  ii\. If the pressure in the hydrogen circuit is higher than 1.5 bar absolute (= 0.5 bar above atmospheric pressure) piping must be made of steel and connectors must be screw/compression type.

    c.  iii\. If the pressure in the hydrogen circuit is lower than 1.5 bar absolute (= 0.5 bar above atmospheric pressure) flexible piping and unscrewed connectors are accepted.

    d.  iv\. No use of Teflon tape on the connections of the flowmeter. Teflon tape is only permitted upstream of the flowmeter if the connection to the regulator requires it for hydrogen sealing. In any case, Participants are responsible for damage to the flowmeter due to wrong connections.

    e.  v\. H2 piping and equipment must be protected from overpressure at 90% or lower of their maximum pressure rating. Documentation of the pressure settings of the relief valve must be provided, including internal relief valves built into regulators. In case of the use of pressure relief valves, they must be vented outside through the top, side, or back section of the vehicle. The exhaust tubing must be well secured to the vehicle. g) Purge pipe If a purge pipe is needed, its end must be located outside the vehicle.

7.  h\) Measurements and Equivalencies

    a.  i\. The consumption of hydrogen is measured by an embedded flow meter. The flow meter will be checked/calibrated by the Organisers before Technical Inspection.

    b.  ii\. The following calibrated flow meters are provided by the Organisers at the event: 1. For Prototype: Vögtlin Red-y compact series GCM-BIKA-BN00. 2. For Urban Concept: Vögtlin Red-y smart series Hi performance GSM-B9TA-BN00.

    c.  iii\. The volume of hydrogen consumed is posted in normal litres. The display of the flow meter must be easy to read from outside the vehicle when the vehicle body is closed. It must be inaccessible by the Driver in normal driving position.

    d.  iv\. The serial number on the hydrogen flow meter must not be covered or removed. i) Oxygen and air reserves Oxygen for the fuel cell's operation must be from the surrounding air, not from oxygen tanks or compressed air reserves.

8.  j\) Supercapacitors

    a.  i\. If an embedded electric storage device is part of the powertrain, it must be of capacitor type, referred to hereafter as 'Supercapacitor'. Other types of embedded electric storage device (Pb, NiMh, etc. batteries) are forbidden.

    b.  ii\. The state of charge of the Supercapacitor will be checked before and after each run by measuring the Supercapacitor voltage. Two measurement points (Supercapacitor voltage + and -- a labelled "Supercapacitor voltage") must be installed outside the vehicle to allow the voltage measurement on the starting line. For Urban Concept vehicles a joulemeter will be used to measure the Supercapacitor voltage. (See Article 56:d) iv)

    c.  iii\. The voltage registered after the run must be at least equal to the voltage registered before the run. In the event of the contrary, the Supercapacitor must be re-charged by running the fuel cell until their voltage is equal to the voltage registered before the run. The additional time required to recharge the Supercapacitor by running the fuel cell after the competition is added to the recorded time of the relevant run.

    d.  iv\. The maximum Supercapacitor voltage must not exceed that referenced in Article 57:a).

9.  k\) Fuel cell starter battery

    a.  i\. Accessory battery If the accessory battery can be electrically isolated from the fuel cell output, the accessory battery can be used to start the fuel cell. The battery is considered electrically isolated when energy from the accessory battery cannot contribute to vehicle propulsion.

    b.  ii\. External battery If the accessory battery cannot be isolated from the fuel cell output, an external battery must be used on the starting line to start the fuel cell system. 1. As soon as the vehicle starts to move, this battery must be unplugged. 2. Two connectors must be installed outside the vehicle to allow a quick connection and fuel cell system start on the starting line. These external connectors must be securely fastened to the vehicle.

    c.  iii\. As mentioned in Article 57:h)i, it is mandatory to power the hydrogen detector using the accessory battery when such battery is used. iv. Any battery must not be mounted directly adjacent to the hydrogen cylinder.

10. l\) Electrical circuit/Electronics

    a.  i\. All wiring associated with the accessory battery circuit must be clearly distinguishable from the propulsion system by physical isolation or the use of different wire colours.

    b.  ii\. A fuse must be installed on the positive terminal of the fuel cell stack. Its melting current (expressed in Amps) must be less than the active area (expressed in square centimetres) of one cell of the stack. For instance, if the active surface of one cell of a 20-cell stack is 60 cm², the melting current of the fuse must not exceed 60 A.

    c.  iii\. If a Supercapacitor is used in the circuit, a fuse must be installed on the positive terminal of the Supercapacitor pack. The fuse rating must be less than or equal to the maximum usable power divided by the rated voltage. m) Other equipment Compressors, fans and coolers for the fuel cell system must be powered by the fuel cell or Supercapacitor, not by the accessory battery.
