JeffreyLiang3449/HFCV-Website/2024 Summer Research/Chassis Sketches.qmd

---
title: Chassis Sketches
resources:
  - "Chassis Sketches.pdf"
---

{{< pdf "Chassis Sketches.pdf" width="100%" height=700 >}}
