JeffreyLiang3449/HFCV-Website/2024 Summer Research/Summer Notes.qmd

**[Talking to Ben and Justin]{.underline}**

Make bottom of chassis solid - giant sheet of carbon fiber or aluminum

Back half aluminium

Need

-foot break

-back break needs new spring (3 of them)

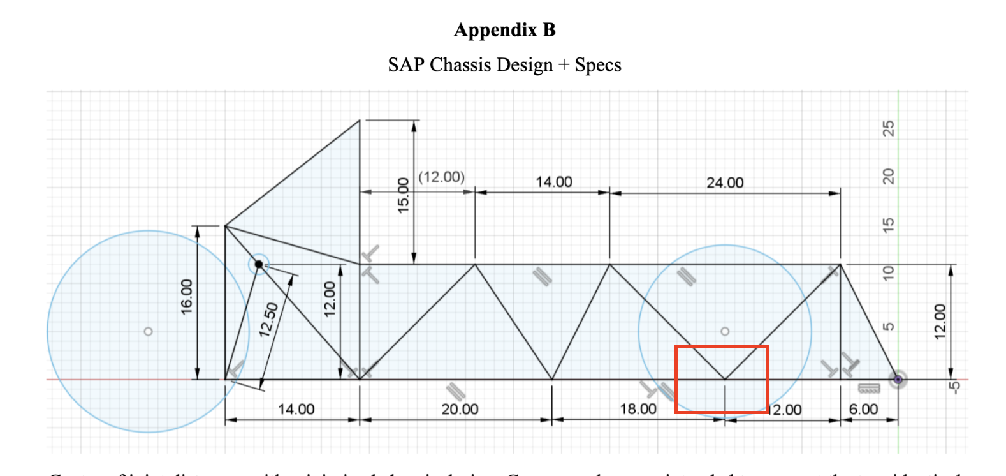
[picture p23: 2024 Summer Research/media/media/image3.png]
\-

Red box make aluminum joint and not 3D print

-tubes take a week

-mcmastercar 2 days max

-build simulation of front

-carbon fibre middle

-aluminum frame so that

-utm (ask carr/fiona)

Find diameter of wheels

Find how suspension connects onto the vehicle

Redesign front half to have suspension connect

- Most go-karts have suspension attached to one vertical member

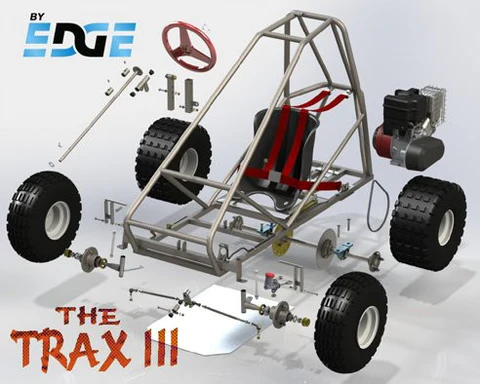
[picture p24: 2024 Summer Research/media/media/image1.png]
- 

[Steps to use markforged]{.underline}

0\. Login to computer 2

1.  Use a program called eiger.io

    a.  Pretend to be josh

2.  Export what you want to be printed in an [STL file]{.mark}

3.  Import into eiger ur stl file

4.  Have threads on z axis

5.  Material is onyx

    a.  No reinforcement necessary unless shape is wonky

6.  Export Build

7.  Put that file onto flashdrive

8.  Stick drive into printer

9.  Hit print from storage

Look into villanova sae

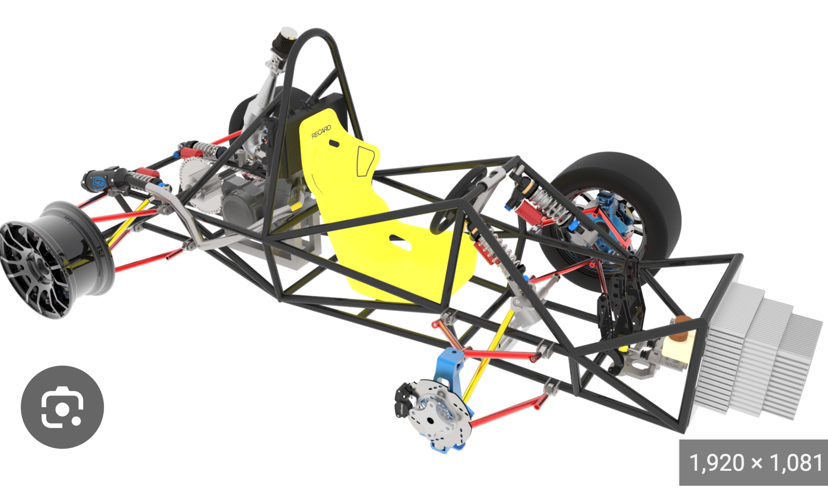
[picture p25: 2024 Summer Research/media/media/image2.png]


[[https://abhijeetscad.wordpress.com/2015/01/03/fsae-car/]{.underline}](https://abhijeetscad.wordpress.com/2015/01/03/fsae-car/)

Look into buying a...

- Gear and pinion steering system

  - [[https://www.amazon.com/dp/B0BBLRNKTD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]{.underline}](https://www.amazon.com/dp/B0BBLRNKTD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)

- Suspension system

  - https://www.amazon.com/s?k=go+kart+front+suspension+kit&ref=nb_sb_noss

  - 

- Pivot point for wheels

- Hydraulic disk brakes

- Wheels

  - \$450 [[https://www.trikexplor.com/products/20inch-completed-wheels-with-disc-brakes]{.underline}](https://www.trikexplor.com/products/20inch-completed-wheels-with-disc-brakes)

  - \$150

  - [[Aliexpress]{.underline}](https://www.aliexpress.us/item/3256806193317631.html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)

  - 

- Large piece of clear plastic for bottom trough

Progress Report for Carr

- Have learned necessary fabrication techniques

  - Welding

  - 3D print

  - Lathe

- Have started considering parts we want

  - Suspension and steering ordered

  - Wheel size and disk brake for the front wheels

  - Brakes?

- Very rough rudimentary design

- Working on powerpoint

> Final Report Notes
>
> Goals - Redesign and fabricate front half of HFCV Chassis
>
> Methods - Utilized E90 Research
>
> Results - Have part of the frame completed
>
> Significance - prepares for the fall semester and future E90s
