JeffreyLiang3449/HFCV-Website/2025 Summer Research/HFCV Summer 2025 Sigma Xi Abstract.qmd

This project continues the development of a hydrogen-powered vehicle for competition in the Shell Eco-marathon, an international program challenging students to design and build fuel-efficient vehicles. Our vehicle utilizes a hydrogen fuel cell as a clean energy source. Unlike combustion engines, which emit greenhouse gases and other pollutants, hydrogen fuel cells generate electricity through an electrochemical process whose only byproducts are water and heat. Fuel cell vehicles offer several advantages over gasoline-powered and electric vehicles, offering longer ranges than battery-powered vehicles while requiring only minutes to refuel. The primary barriers to the adoption of hydrogen fuel cell vehicles are the lack of infrastructure and the high cost of producing hydrogen.

The original vehicle, built by Swarthmore engineering students in 2013, utilized a welded aluminum chassis. The iteration of the vehicle currently in development features a primarily carbon fiber chassis, greatly reducing the vehicle's weight while maintaining strength. It is our hope that the reduced weight of the chassis will improve the vehicle's speed and fuel efficiency. The modular system of carbon fiber tubes and aluminum linkages used in the chassis also allows for the design to be modified more easily. At the time of writing, the carbon fiber chassis has been assembled, and the front and rear suspension systems are in the process of being attached. To meet competition requirements, near-term goals include completing the front and rear suspension; integrating steering and braking; installing the floor of the vehicle; mounting the power system; and building a low-drag exterior enclosure. We aim to enter the vehicle into the Shell Eco Marathon competition in the Spring.
