JeffreyLiang3449/HFCV-Website/2024 E90 work/E90 Final Report Chai Horvat 2024_.html

Shell Eco-Marathon Hydrogen Vehicle Revitalization Effort

ENGR 090 Final Design Project

Justin Chai ’24 & Benjamin Horvat ’24
Advised By: Professor Carr Everbach

Swarthmore College, Department of Engineering

May 2024

Abstract

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

Introduction

The advent of climate change pressures innovators to explore alternative energy methods beyond conventional renewable sources. As the world grapples with the urgent need to curtail global carbon emissions, transportation becomes a focal point, demanding innovative approaches to increase EV battery efficiency and disrupt industry reliance on natural gas and petroleum. This transportation imperative is emphasized by the transportation sector’s substantial emission contribution, accounting for approximately one-fifth of global carbon dioxide emissions and over a quarter of annual GHG emissions in the United States. [10]

Hydrogen vehicles powered by fuel cells offer a promising avenue for revolutionizing industrial and commercial transportation systems. A transition to hydrogen technology holds particular importance for heavy-duty applications, such as freight trains, cargo ships, or cranes, and the importance of this transition is fortified by the recognition that heavy-duty vehicles, although constituting a small fraction of the global vehicle fleet, contribute significantly to greenhouse gas emissions—23% in the case of the US. [7][15] Moreover, the continued adoption of hydrogen as a fuel could make impressive strides in transportation due to hydrogen’s energy density and versatility, surpassing that of traditional lithium batteries or diesel fuel. This specific characteristic is especially critical for long-haul transportation, where the high energy demands and weight considerations pose significant implementation challenges for alternative energy options. [16]

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

Theory

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

How Does a Hydrogen Fuel Cell Work

Understanding the mechanics of a hydrogen fuel cell vehicle provides insights into its potential as a sustainable transportation solution. At the heart of this technology lies the Proton Exchange Membrane Fuel Cell (PEMFC), a pivotal component in converting hydrogen into electricity. As pressurized hydrogen enters the anode side of the fuel cell, it undergoes a catalytic process, splitting into H+ ions and electrons (e-). Simultaneously, pressurized oxygen on the cathode side splits into oxygen atoms, each carrying a strong negative charge. The electrons released at the anode side then travel through an external circuit, generating an electric current that powers various components, ultimately returning to the cathode side. [5] Afterward, the hydrogen ions move through an electrolyte membrane that permits only positively charged ions to pass. As a result, on the cathode side, the oxygen atoms attract the H+ ions, forming water (H2O) as a byproduct of the reaction. Figure 1 depicts this hydrogen-to-electricity conversion process. 

To harness the electricity produced, individual fuel cells are combined into a stack, connected by bipolar plates. This stack is the power source for the electric motor of the vehicle. The fuel cell stack sends electricity to the motor, allowing it to turn the wheels and propel the vehicle forward.[8] For reference, the fuel cell stack typically used for the Shell-Eco Marathon is the Horizon XP PEM fuel cell which features 30 fuel cells stacked together for an advertised max power of 1000W [17]. This stack implementation showcases the versatility of hydrogen fuel cell technology in delivering power for practical transportation needs as fuel cell units are incredibly small and can compound on top of one another to meet electricity demands compared to battery electric vehicles [18]. See Figure 2 for a diagram of how a fuel cell vehicle’s systems typically interact with each other to propel it forward. [4] The pros of hydrogen fuel cell vehicles are noteworthy. Beyond offering emission-free driving and quick refueling, these vehicles provide an extended range compared to some battery-powered counterparts. However, challenges persist, such as the limited hydrogen fueling infrastructure, high production costs of high-efficiency fuel cells, and unsustainable hydrogen production methods. 

Physics of Fuel-Efficient Design

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

As our focus will be primarily on mechanical systems attached to the chassis, such as the suspension and brakes, putting in the necessary effort to get all systems right is critical. Suspension systems play a role in both the stability and the energy return when the vehicle faces uneven conditions. Minimizing flex and fatigue in the chassis material will help receive more out of the suspension system and allow it to act more ideally. When designing a successful suspension and steering system, the vehicle must be able to adapt and respond to impulses while also maintaining the reaction of the vehicle to mitigate large amounts of energy loss in the process. With modern Shell-Eco Marathon rules now requiring suspension on the rear wheel, we have taken the opportunity to design the full system to our liking. Explored suspension systems were inspired by modern motorbikes’ telescopic fork suspension, modern Formula One vehicles’ wishbone system, and recumbent trike suspension. Regardless of methods, the interaction between the suspension system and the steering system must be considered to ensure safety and high performance. [11] [19] 

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

Strain and Stress on Tubes

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

\(\tau = \frac{F}{A}\)

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

Additionally, the shear modulus can be calculated using the equation below.

\(G = \frac{F/A}{\bigtriangleup x/l} = \frac{Fl}{A \bigtriangleup x}\)

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

\(D = \frac{PL^{3}}{48EI}\)

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

Hydraulic Brakes 101

As stated in the Shell Eco-Marathon rules, the HFCV must have two hydraulic brakes acting on the two axles of the vehicle. The HFCV, with the driver inside of it, must also be able to come to a full stop with the front and rear brakes, individually, at a 20° incline. These rule changes emphasize the need for a safety update from the current Swarthmore HFCV, a vehicle that still uses mechanical rim brakes. In previous iterations of the vehicle, mechanical rim brakes were rational choices to hydraulic disc brakes because of their easy maintenance and installation, aerodynamic nature, and lighter weight. Furthermore, although the vehicle is incredibly unlikely to be running in wet conditions or high-speed scenarios, mechanical rim brakes are known for sporting reduced energy dissipation after unideal contact with the bike rim, either by slipping or rim deterioration from friction heating [20]. Comparatively, hydraulic disc brake systems are widely adopted in mountain bikes and cars due to their numerous advantages [3]; specifically, the ability to modulate the braking force with minimal effort is particularly advantageous. In cars, hydraulic brake systems provide efficient and reliable braking, contributing to safety and stability. See Figure 4 of the schematic of a disk brake system acting on a standard automobile. [9] 

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

Methods

Design Constraints & Goals

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

Benchmarking the Current Vehicle

During the beginning of the development process, we were eager to begin calculations on new design changes concerning chassis weight, fuel cell power, and the efficiency ratings of the current HFCV. As the Shell Eco-Marathon focuses on testing fuel efficiency in miles per cubic meter of hydrogen, we knew that we would want to start with an understanding of how new designs may affect efficiency before beginning any fabrication or materials research. However, we quickly learned that because previous teams focused on completing any design constraints hindering them from entering the current HFCV into the competition, they never had the opportunity to do any quantitative benchmarking of the vehicle’s capabilities. Thus, the team decided to begin the project by revitalizing the current HFCV into its former glory, making it operational and running for the first time in 4 years. 

The original goals of the baseline tests were to establish a final weight of the current HFCV in its competition state, to test the front and rear mechanical rim brake responses, to find the maximum speed the current vehicle can traverse in outside and inside conditions, and to find the maximum power exerted by the 2019 Horizon H-1000 Fuel Cell. As seen in Figure 5, the current HFCV was weighed on a heavy-duty scale built for measuring the weight of concrete blocks. This was done after clearing old electrical wiring and cleaning up the floor of the car’s chassis. Additionally, a current sophomore, Jano Vasquez ’25, assisted in revitalizing the current HFCV by installing a steering column and swapping out denser springs into the front suspension system to realize additional final design changes from the 2018 team. The vehicle was then able to be weighed after being propped onto a basket on its center of gravity which was the location of its firewall. This weight of the square aluminum chassis can now be compared with other theoretical chassis built out of alternative materials such as round chrome-moly, round aluminum, wrapped carbon fiber tubes, and round stainless steel. 

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

However, in the act of running these speed tests to ascertain the fuel cell stack’s capabilities, the team had to readjust the rear wheel to stop potential startup errors from the car’s safety system. By adjusting the wheel, the rear wheel did not have enough clearance from the chassis to safely reattach the rear mechanical rim brake, so the team decided to remove the rear mechanical rim brake entirely from the current vehicle. The team concluded that current 2024 and 2025 Eco-Marathon rules dictated the replacement of the mechanical rim brakes with hydraulic disc brakes, and as a result, we did not move forward with testing the mechanical rim brake responses in the outside and inside scenarios as there was no need to do quantitative comparisons with the disc brakes in the future. 

Building a Fuel Efficiency Comparison & Prediction Model

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

\(D = \frac{⍴v(Cd)A}{2}\)

Eq 4. The formula used for the drag forces. ⍴ is the density of air. V is the average velocity of the vehicle. Cd is the coefficient of drag of the vehicle. A is the frontal area of the vehicle.

\(F = \mu N\)

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

\(V = \frac{E}{⍴*J}\)

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

\(E = \frac{D}{V}\)

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

Load Determination with SAP Model

To estimate the approximate forces that the members of a chassis will take on, we will treat the entire system as a truss with the primary purpose of supporting the load of the driver. In this model, wheels will act as our anchor, as in true application the loads that are being supported by the chassis frame must be supported from the ground. To avoid static indeterminacy in our model, we will treat the points where the wheel is likely to connect to the body as fixed attachment points with moment resistance. While we realize that the wheelbase likely has slight shifts in position depending on the load and the elongation or shortening of the individual members, we will treat these points in space to be entirely fixed so that we can develop a practical baseline. 

Tensile Testing with Carbon Fiber Members

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

3-Point Beam Bending Analysis

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

Designing a New Rear Suspension System

As the back suspension with constant contact is a new requirement for the competition, we decided to take inspiration from bike suspension and other single-wheel suspension systems for our design. We considered using a prefabricated fork suspension intended for the front of a mountain bike, however, we believed that this design would allow for wobble along the axis or uneven suspension response between the two sides. For this reason, we continued to search. We eventually settled on a lever arm suspension design similar to a motorbike. This type of suspension is active as soon as the driver sits in the vehicle and is intended for a drive wheel, so the parallels in function fit our vehicle model well. 

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

Hydraulic Disc Brake Installation

As stated in the hydraulic disc brake theory section, the Shell Eco-Marathon requires us to install hydraulic disc brake systems to pass technical inspections moving forward. Because we had no prior experience with installing hydraulic brakes or using disc brakes, the team decided to buy a Shimano Deore RT66 6-Bolt 180mm disc rotor because of its ease of installation onto the current rear wheel hub motor. The hydraulic brake system was explored near the end of the E90 design timeline, so the team could not justify an exploration of a pedal brake system or learn how to bleed the hydraulic brake systems. As a result, the team decided to also purchase a Shimano Bl-Mt200(R) Hydraulic brake system that was pre-bled and made for down-hill trikes. With both of these quick purchases and installations, the team was able to effectively remove the rear mechanical rim brake and replace it with a handle-lever hydraulic disc brake system. Moreover, the installation of the disc brakes coincided with the implementation of the new rear suspension system, so there was necessary maneuvering to ensure that the disc brake calipers would have a stable place to be bolted to while having enough clearance to not fully interfere with free tire movement. As seen in Figure 9, an external piece was 3D printed to fit on top of the left lever arm of the suspension system. The piece was designed to extend off of the lever arm to allow the brake calipers to rest perpendicular to the disc rotor. 

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

Results & Discussion

Current Vehicle Benchmarks

To compare any new vehicle with the current vehicle, the current vehicle’s base capabilities were quantified. As the team hypothesized that weight reduction would be one of the most important aspects for increased efficiency for the new vehicle, Table 2 reveals the weight breakdown of the most important components of the current HFCV. The table reveals that there are two main components that future designs should address for weight reduction: the front suspension system and the chassis. The front suspension system is currently 19.11% of the current vehicle’s weight which is over 50% of the non-chassis related weight. Nonetheless, a redesign of the front suspension could be a viable next option for weight reduction after swapping out the square aluminum chassis with a different lighter-weight material. The table makes it clear that it is still a top priority that chassis weight needs to be reduced in a redesign of the vehicle.  

This leads us to Figure 10 which compares the total weight of a new chassis made of 4 different materials. We are comparing 4 different types of round tubing against the current 0.75-inch square tubing. The simulated weight comparisons reveal that our intuition of swapping the square tubes for round tubes already shaves off considerable weight, but the comparison also reveals that similar “lighter” metals like stainless steel and chrome moly also provide a rough 33% chassis weight reduction. We were then able to properly confirm that wrapped carbon fiber tubing would be a significant weight reducer, dropping the weight of a new chassis by almost 66%. This helped build even more confidence that if a new chassis could be made out of carbon fiber, the new vehicle could be incredibly effective. 

Finally, both Tables 3 and 4 reveal the inside and outside top speeds of the current vehicle. We were able to find that the vehicle averages 6.53 meters per second in inside conditions and 9.57 meters per second in outside conditions. This roughly translates to 14.6 miles per hour and 21.1 miles per hour, respectively. This is likely due to the differing amount of grip the inside and outside flooring provided for the car to accelerate. We were also able to confirm using the acceleration data that the hydrogen fuel cell is outputting power slightly under its 1000W rating which provides a higher amount of confidence for continued usage of the 2019 fuel cell stack. We hope that with a weight reduction and newer tires, the top speed of the car should increase as we can capitalize on the fuel cell’s power. 

Comparisons of Design Choice Effects on Efficiency

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



The results from the simulation model as seen in Figure 12’s waterfall chart also display the compounding effect that a chassis weight reduction would have on the vehicle's overall fuel efficiency. While the weight reduction would yield great efficiency gains, the additional fuel efficiency gains that can be realized from other potential changes make the weight reduction design more enticing as a first focus point for an HFCV overhaul. We want to point out that the (1) +(2) synergized efficiency gain is nearly the same magnitude as the efficiency gain of just implementing (2) by itself. In this case, the pursuit of chassis weight reduction almost doubles the gains that can be realized by a frontal area decrease, and although the synergy effect is less prominent for a (1) +(3) implementation, an increase by 45 MPGe is still nearly a third of the increases realized by (3) alone. 

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

SAP Model Analysis and Chassis Shape Analysis 

The loading that we used for our SAP model was a 200 lb driver sitting at the ideal location within the chassis. The “X” cross along the bottom indicates where the driver is seated. The load was simulated to be applied as 100 lbs on each member at the point that they crossed. The wheels’ attachment points are modeled as fixed supports with internal moment resistance. This assumption helps avoid static indeterminacy in the structure and is fairly accurate to the anticipated construction of the chassis with plate attachment points for suspension and wheels. 

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

Maximum moments occur at the wheels and the center of gravity of the driver. The maximum positive moment that must be resisted is approximately 500 lb-in and the maximum negative moment is approximately 600 lb-in. Many of the vertically oriented members experience lower moments in comparison to the horizontal members. 

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

Comparisons of Carbon Fiber Configurations in Tension





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



For the 3D-printed collar with drilled holes and an M3 bolt running through it, we were able to survive the epoxy loss of strength and begin to load directly on the aluminum bolt once the epoxy let go. The sharp drops in the profile for the test on the right show points where the epoxy lets go, and then it proceeds to load directly onto the bolt itself. The somewhat flat behavior is due to mild crushing or internal shear of the carbon fiber tube, something that was also found to occur in a cylinder compression test. Below is an image of the shear region caused by the bolt. 

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

3-Point Beam Bending Results 

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

Chassis Joint Member Cost Analysis

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



Notably, as expected, the 3D printed collar connectors are more than double the weight reduction effectiveness of the aluminum inserts for every combination of the prints and carbon fiber type. Furthermore, the following Table 8 displays the potential mileage gain for the combinations of different connection types. We noted that the potential fuel efficiency gains from the 3D printed connectors more than any aluminum insert counterpart quadrupled. Thus, the 3D printed collars should not be ruled out as a connection method as they are heavily beneficial towards the design goal of reducing weight and increasing the fuel efficiency of the overall vehicle. Even when considering the cost per pound saved and cost per mileage gained, two key metrics for the cost-effectiveness of the new vehicle, the 3D prints heavily outperformed the aluminum inserts. This led us to believe that a hybrid connection method would be the best line of action to pursue. We could take advantage of the structural strengths of the aluminum inserts and the weight reduction of the 3D-printed units. 

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



Rear Suspension Forces and Design 

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

In the process of fabrication, there was a realization that the bolt for the suspension would not be able to be fed into the eye of the suspension in its current triangular shape. Additionally, the angles of coping for triangular shapes were extremely difficult to get to proper dimensions. There was a mid-fabrication audible to have a ladder support structure, adding only the weight of another 5” large diameter chrome moly tube. This change gives us the flexibility to use multiple springs on the lever arm while improving the design's maintenance and flexibility. Additionally, the attachment brackets intended to connect the rod end eyes of the suspension to the chassis were intended to be welded aluminum plates, but the large filler rod and the difficult heat behavior of small aluminum pieces proved to make the task impossibly difficult. J. Johnson was incremental in helping CNC the parts out of aluminum blocks to provide the design specifications without needing to weld. 

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

Hydraulic Braking Installation 

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

Conclusion & Future Considerations

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

Acknowledgments

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

Appendix

Appendix A

Technical Drawings for Aluminum Inserts and 3D Printed Collars



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

Appendix B

SAP Chassis Design + Specs



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

Appendix C

Compact Design of Fuel Cell & Tank Area



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

Appendix D

Shell Eco-Marathon Technical Inspection Review [19]

Braking

- Vehicles must have two hydraulic braking systems, one per axle.

- Front brake(s) must have a single foot-operated pedal controlling the front wheel(s).

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

- Each brake system must keep the vehicle immobile on a 20% incline during inspection.

Turning Radius

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

- The steering system must prevent any contact between tire and the body or chassis.

Dimensions

- Maximum vehicle height: Less than 1000 mm.

- Minimum vehicle track width: At least 500 mm.

- Maximum height divided by track width ratio: Less than 1.25.

- Minimum wheelbase: At least 1000 mm.

- Maximum total vehicle width: Not exceed 1300 mm.

- Maximum total length: Not exceed 3500 mm.

- Maximum vehicle weight (without the Driver): 140 kg.

Hydrogen Fuel Cell Vehicle

- Fuel System

- Participants must provide a description and process flow diagram of the fuel supply system.

- Fuel system must be easily accessible for inspection and measurements.

- Fuel cell must run independently.

- Hydrogen system design specifications.

- Hydrogen Cylinders

- Use of supplied hydrogen cylinders only.

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

- Ventilation

- Vehicle body must allow for specific ventilation points in the fuel cell and driver compartments.

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

- Hydrogen Detector & Emergency Shutdown

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

- Operation and activation requirements for emergency shutdown valve and relay.

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

- Vehicle Design

- Vehicle bodies must not include any external appendages that might be dangerous to participants;

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

or be covered with foam or a deformable material.

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

contacting the ground.

- Prototype vehicles must have three or four running wheels that are in constant contact with

the road.

Appendix E

E14 Report Results and Discussion (Noah Edgar ’25)

     

 

Resources

1. “About Shell Eco-marathon.” Shell Eco-marathon, https://www.shellecomarathon.com/about.html. Accessed 15 December 2023.
2. Constant, Charlie. “Suspension design: definitions and effects on vehicle behavior – Car Engineer.” Car Engineer, https://www.car-engineer.com/suspension-design-definitions-and-effects-on-vehicle-behavior/. Accessed 15 December 2023.
3. Dille, Ian, and Step Guide. “How Your Hydraulic Disc Brakes Work | Bicycling.” Bicycling Magazine, 30 April 2010, https://www.bicycling.com/repair/a20019608/how-your-hydraulic-disc-brakes-work/. Accessed 15 December 2023.
4. Di Paolo, M. “Hydrogen: What's the Attraction?” EE Times Asia, 16 March 2020, https://www.eetasia.com/hydrogen-whats-the-attraction/. Accessed 15 December 2023.
5. Fulcher, Jonathan. “How do hydrogen fuel cells produce electricity?” Lexology, 23 July 2019, https://www.lexology.com/library/detail.aspx?g=af37fe74-4987-4116-a861-8d2ebc210138. Accessed 15 December 2023.
6. “H-1000 XP Fuel Cell Stack.” Horizon Educational, https://www.horizoneducational.com/h-1000-xp-fuel-cell-stack/p1407. Accessed 15 December 2023.
7. “Heavy-duty vehicles an ideal entry into hydrogen fuel cell use | ORNL.” Oak Ridge National Laboratory, 23 April 2021, https://www.ornl.gov/news/heavy-duty-vehicles-ideal-entry-hydrogen-fuel-cell-use. Accessed 15 December 2023.
8. “How does a hydrogen vehicle work?” Renault Group, https://www.renaultgroup.com/en/news-on-air/news/how-does-a-hydrogen-vehicle-work/. Accessed 15 December 2023.
9. “Hydraulic Braking | Definition, Components, Applications | by Vehicle Parts Supplier.” Medium, 12 February 2023, https://medium.com/@andrew_85986/hydraulic-braking-definition-components-applications-cc96c500aaae. Accessed 15 December 2023.
10. “Hydrogen's Role in Transportation.” Department of Energy, 25 February 2022, https://www.energy.gov/eere/vehicles/articles/hydrogens-role-transportation. Accessed 15 December 2023.
11. Mees, Huibert. “Our Suspension Engineer Explains Why This One Suspension Design Parameter Has Such A Huge Effect On Ride, Handling, And Body Roll.” The Autopian, 3 March 2023, https://www.theautopian.com/our-suspension-engineer-explains-why-this-one-suspension-design-parameter-has-such-a-huge-effect-on-ride-handling-and-body-roll/. Accessed 15 December 2023.
12. Mercer, Liam. “How do hydraulic brakes work? | off-road.cc.” off.road.cc, 18 October 2023, https://off.road.cc/content/feature/how-do-hydraulic-brakes-work-13655. Accessed 15 December 2023.
13. Muir, Alex. “How the braking system works.” How a Car Works, https://www.howacarworks.com/basics/how-the-braking-system-works. Accessed 15 December 2023.
14. “Technical Data Sheet.” 3M, https://multimedia.3m.com/mws/media/2365743O/3M-Scotch-Weld-Epoxy-Adhesive-DP420-Black.pdf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. Accessed 9 May 2024.
15. Ritchie, Hannah. “Cars, planes, trains: where do CO2 emissions from transport come from?” Our World in Data, 6 October 2020, https://ourworldindata.org/co2-emissions-from-transport. Accessed 15 December 2023.
16. “Why Study Fuel Cells.” Department of Energy,
17. “Horizon XP PEM Fuel Cell – 500W |,” Horizon Fuel Cell. Available: https://www.fuelcellearth.com/fuel-cell-products/horizon-xp-500w-pem-fuel-cell/. [Accessed: May 10, 2024]
18. Office of Energy Efficiency & Renewable Energy, “Fuel Cells,” Energy.gov. Available: https://www.energy.gov/eere/fuelcells/fuel-cells
19. “Shell Eco-marathon Global Rules & Regulations | Shell Eco-marathon,” www.shellecomarathon.com. Available: https://www.shellecomarathon.com/about/global-rules.html
20. “Disc Brake vs Rim Brake: Is There A Clear Winner?,” Disc Brake vs Rim Brake: Is There A Clear Winner? Available: https://www.lightbicycle.com/newsletter/Disc-brake-vs-rim-brake--is-there-a-clear-winner-.html
21. C. H. | T. Writer, “Disc brakes vs. rim brakes: Everything you need to know,” Cyclist, Nov. 17, 2022. Available: https://www.cyclist.co.uk/buying-guides/disc-brakes-vs-rim-brakes-everything-you-need-to-know
