JeffreyLiang3449/HFCV-Website/2025 E90 work/E90 Mid-Semester Presentation (GS, MM).pptx

## E90 Project: Hydrogen Fuel Cell Vehicle

Gabriel Salas, Michael Moran

## Table of Contents

Purpose and Background

Requirements and Constraints

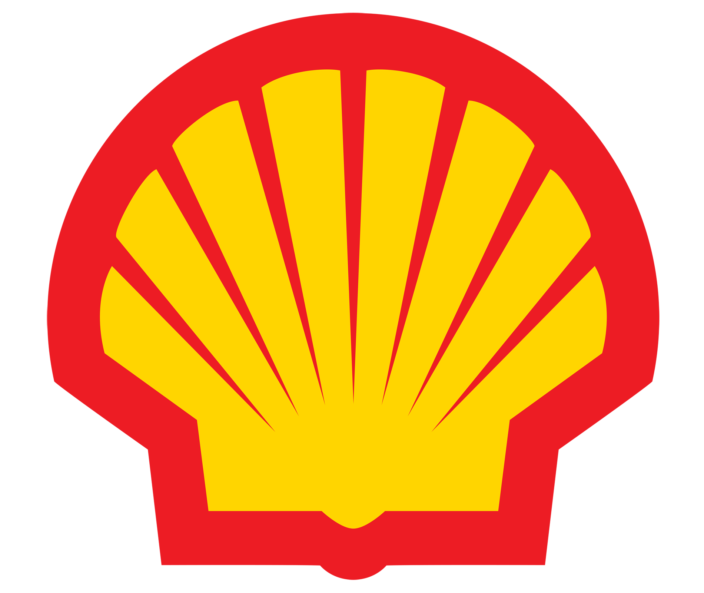
[picture p115: figure]
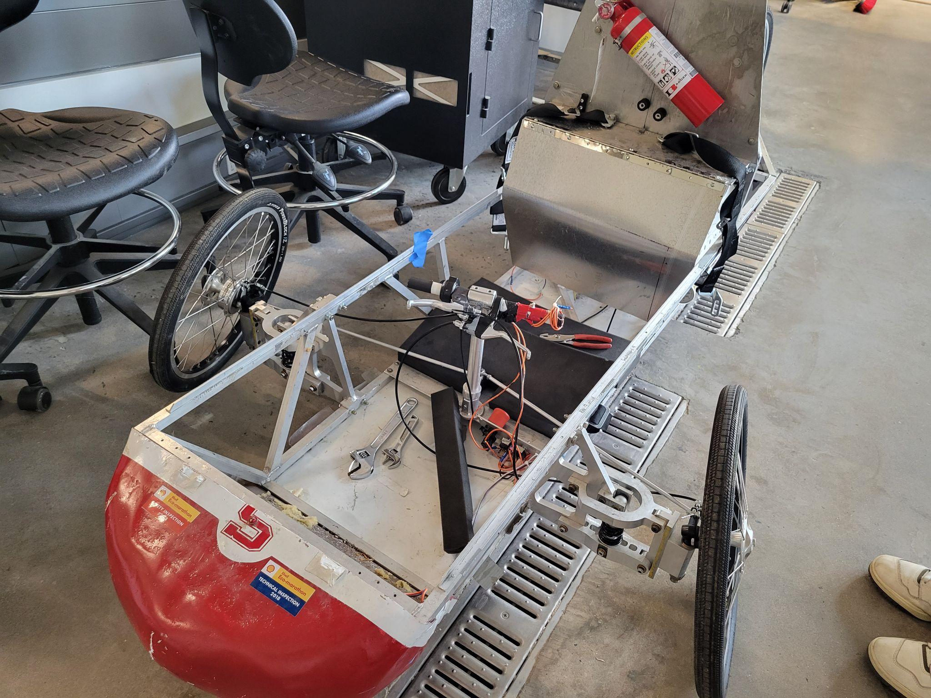
[picture p116: figure]

Goals and Current Work

Next Steps

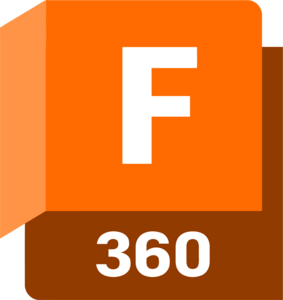
[picture p117: figure]
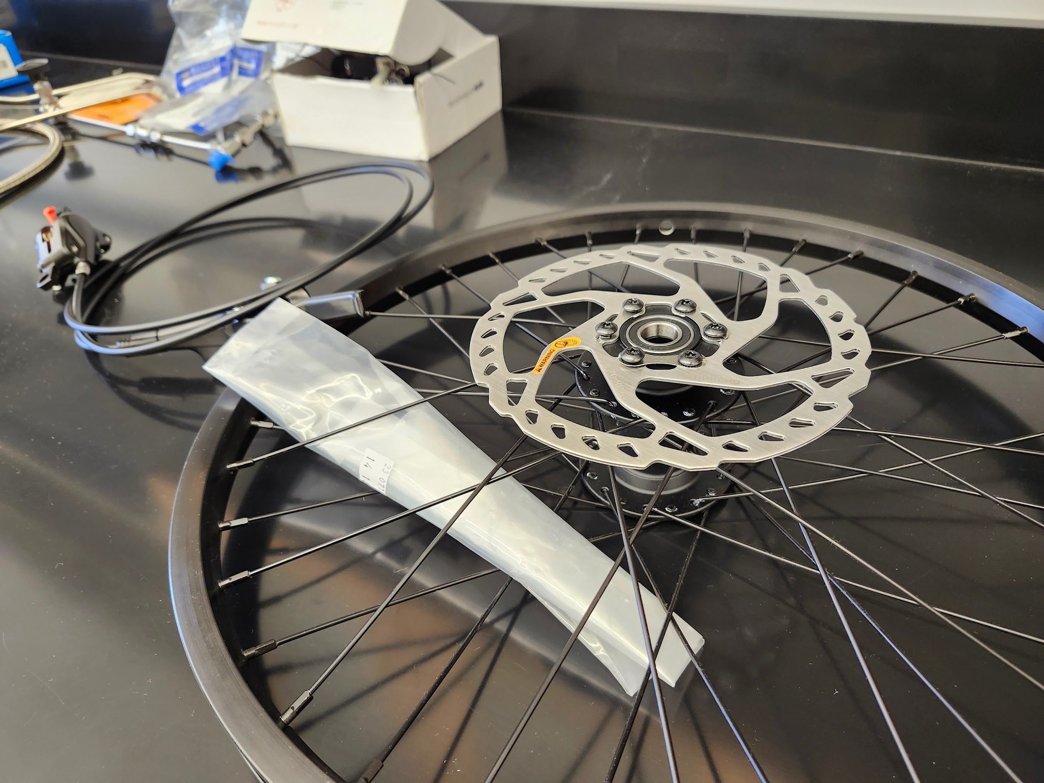
[picture p118: figure]

## PURPOSE

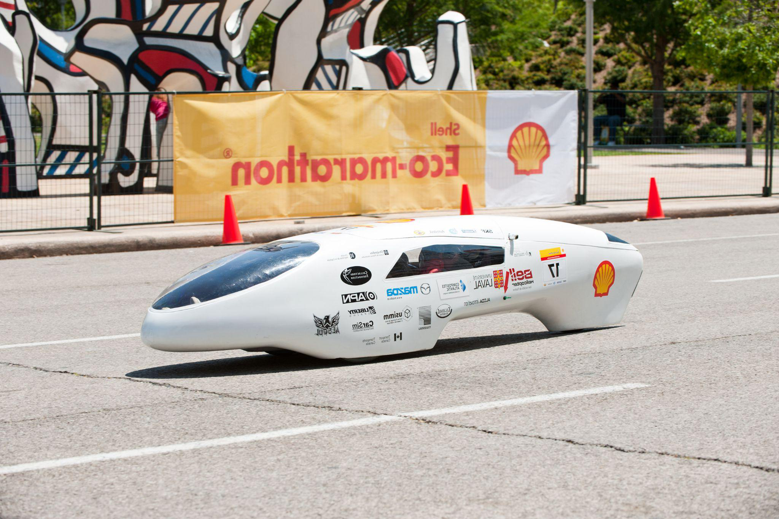
[picture p119: figure]

The goal is to continue the work of past senior classes as well as research done by underclassmen.
Deep interest in motosport, vehicle development, and the search for alternative fuel sources

## REQUIREMENTS & CONSTRAINTS

Requirements | Constrains
CAD / Fusion 360 Design and Development | Ordering materials + Arrival
MIG Welding | Machine Shop Availability
Manufacturing / Machining | Current Frame
3D Print RULES OF RACE | Prior Development(s) + Parts

## CURRENT WORK

Suspension

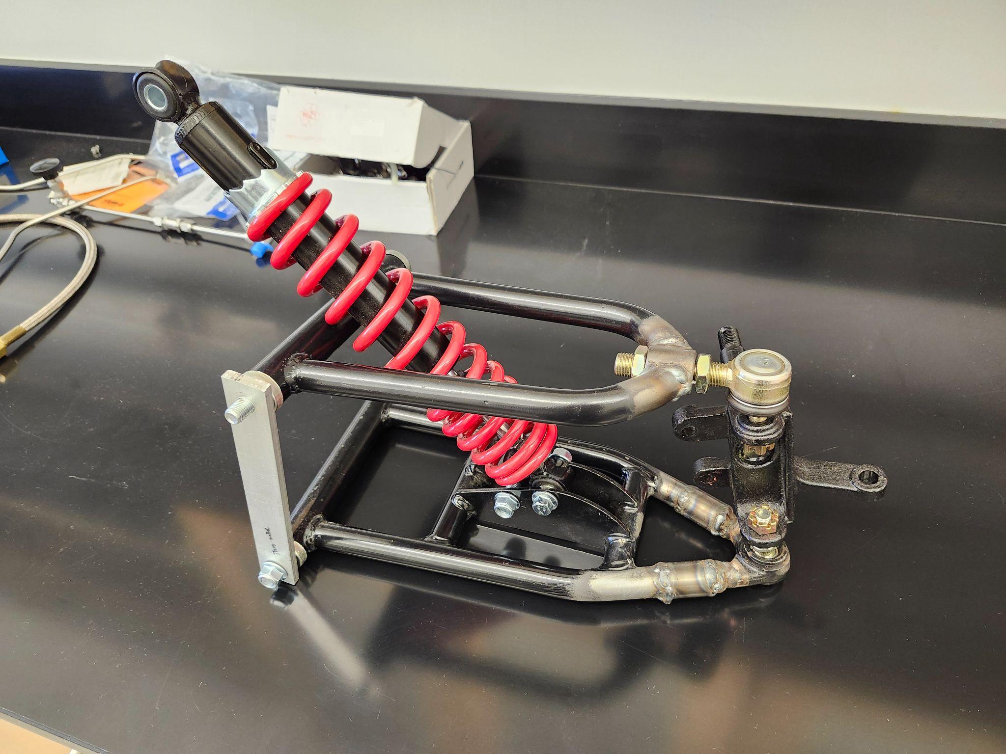
[picture p120: figure]
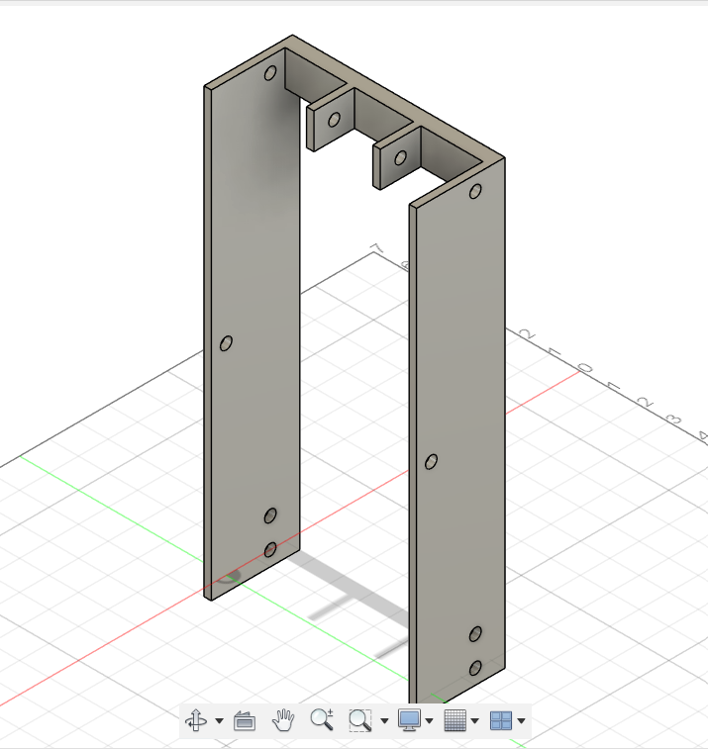
[picture p121: figure]
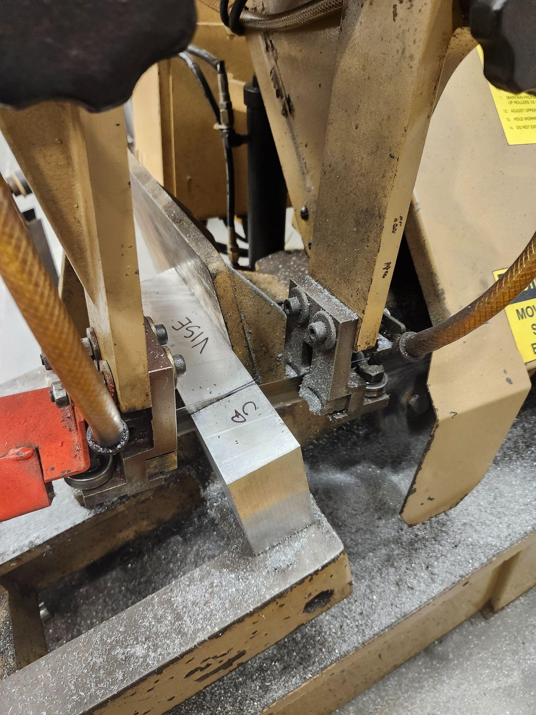
[picture p122: figure]
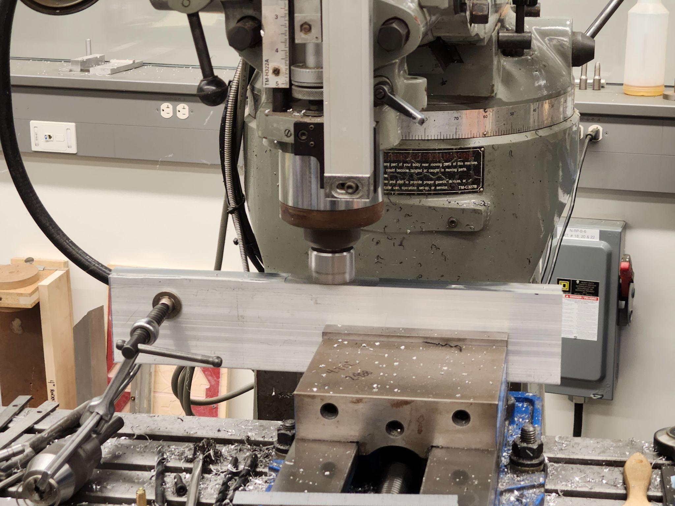
[picture p123: figure]

## CURRENT WORK

Brakes

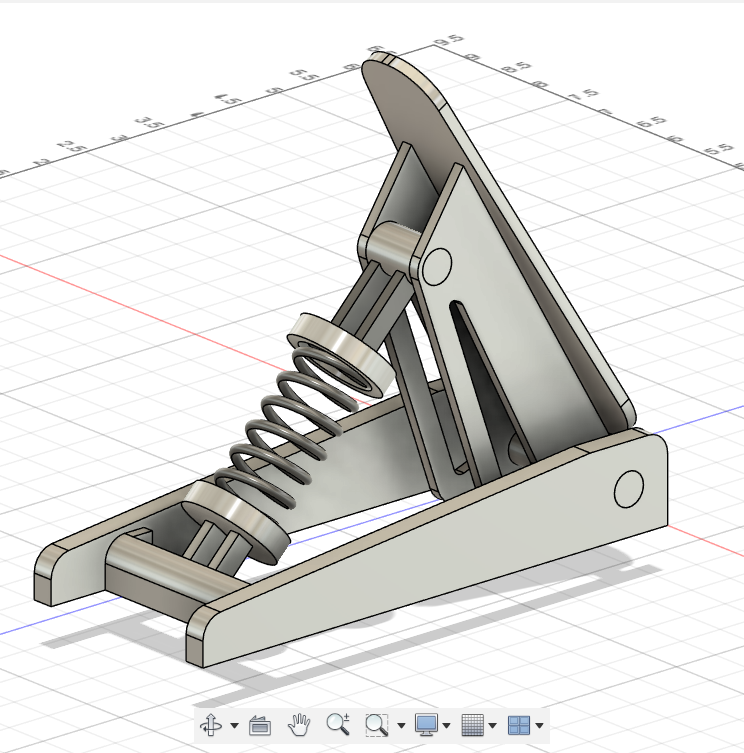
[picture p124: figure]
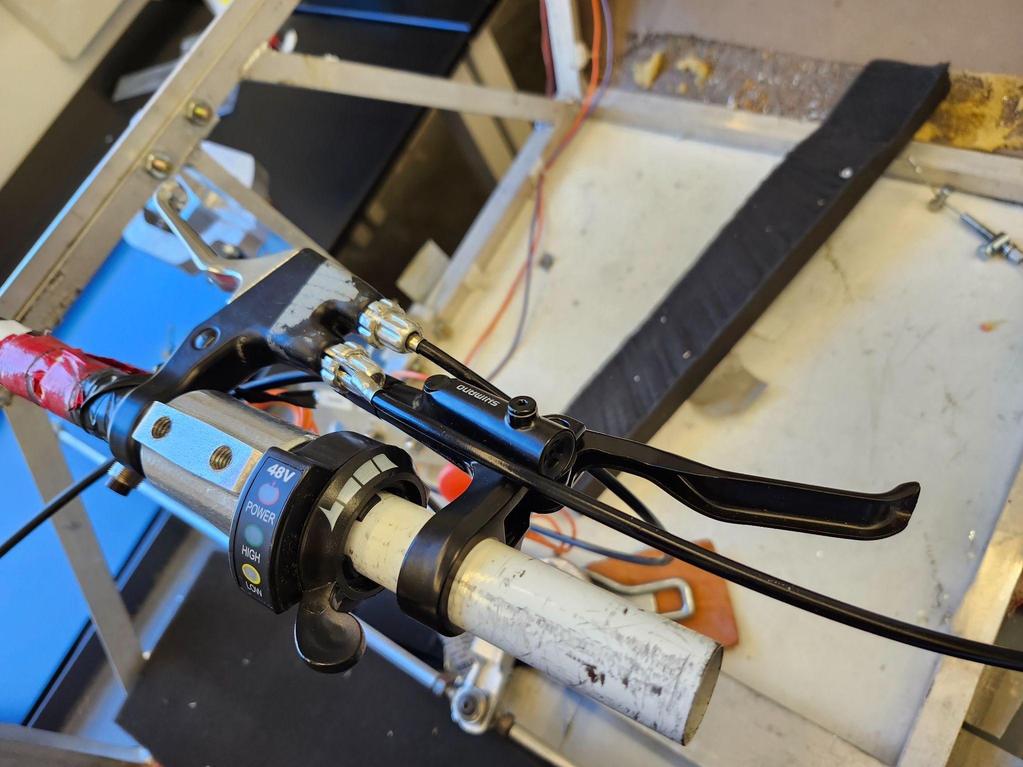
[picture p125: figure]
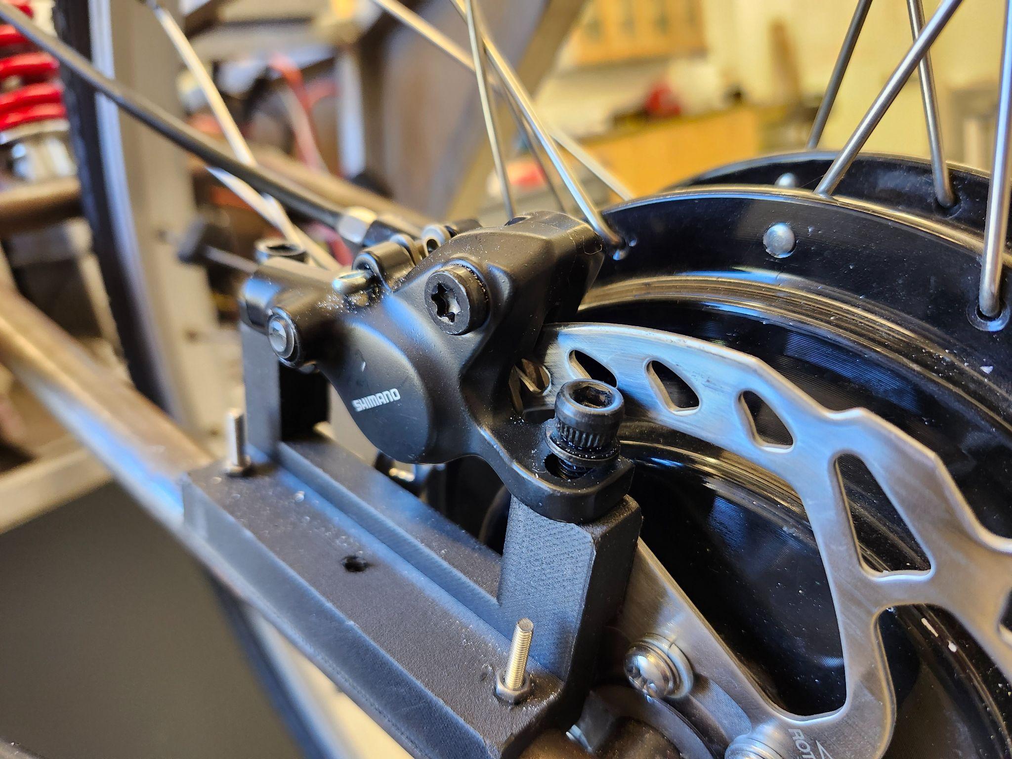
[picture p126: figure]

## CURRENT WORK

Steering: Rack + pinion

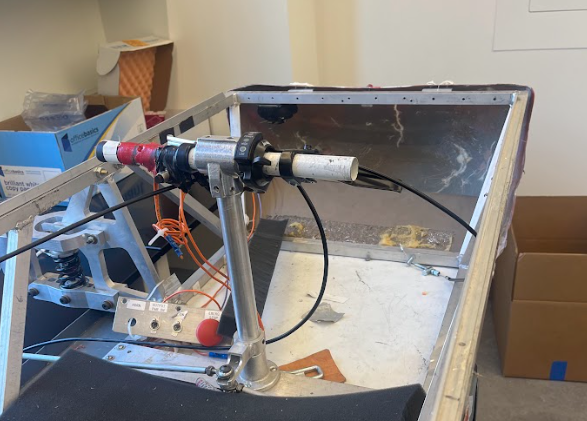
[picture p127: figure]
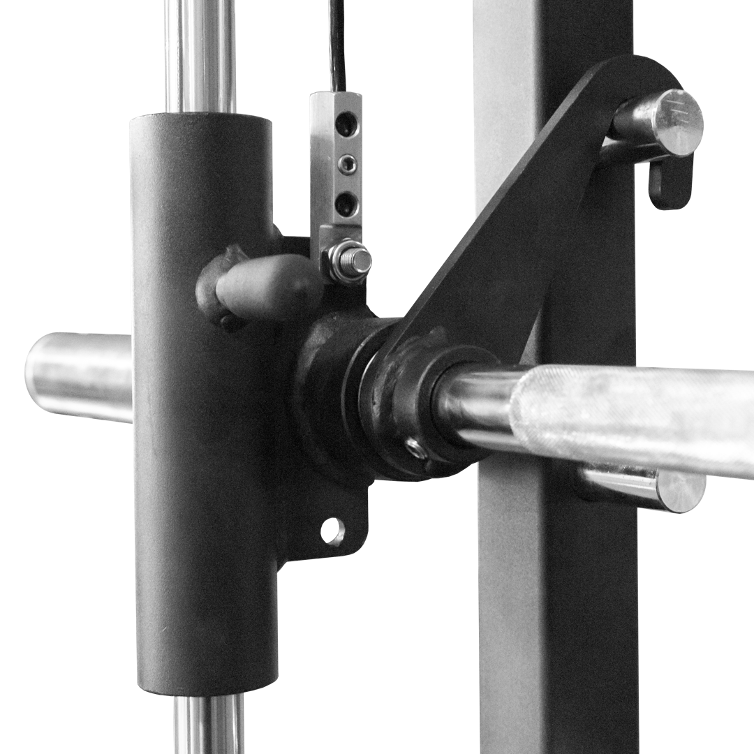
[picture p128: figure]

Rack + pinion support inspiration: Link_Image (https://www.renouffitnessequipment.com.au/product/functional-trainer-smith-machine-3/)

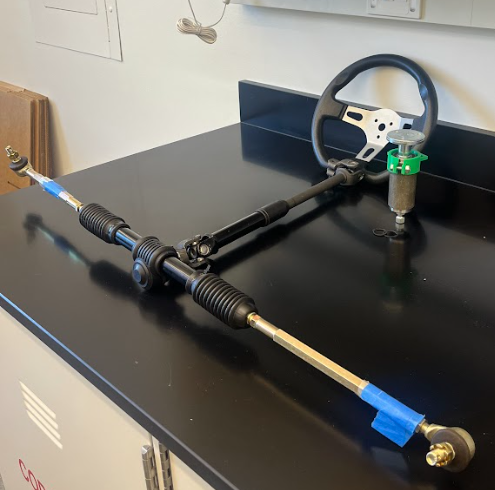
[picture p129: figure]

## CURRENT WORK

Steering Wheel: Quick Release

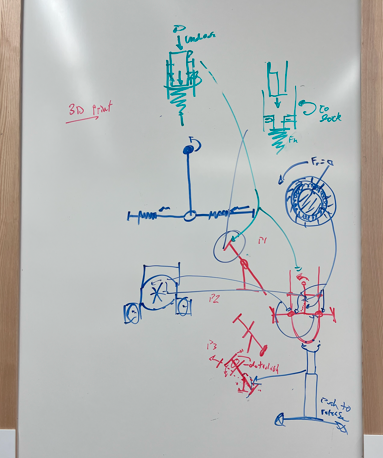
[picture p130: figure]
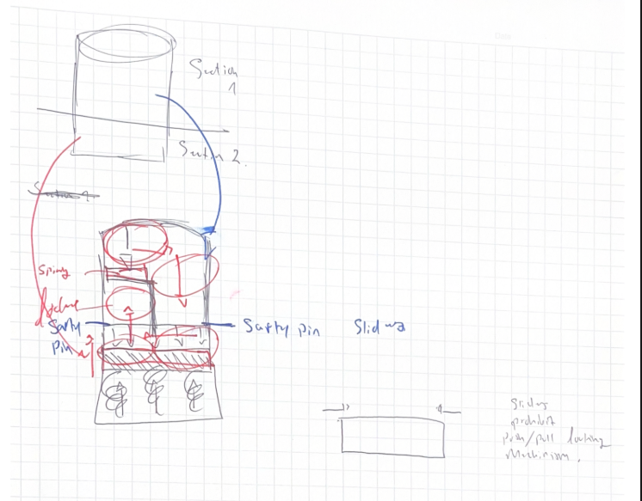
[picture p131: figure]
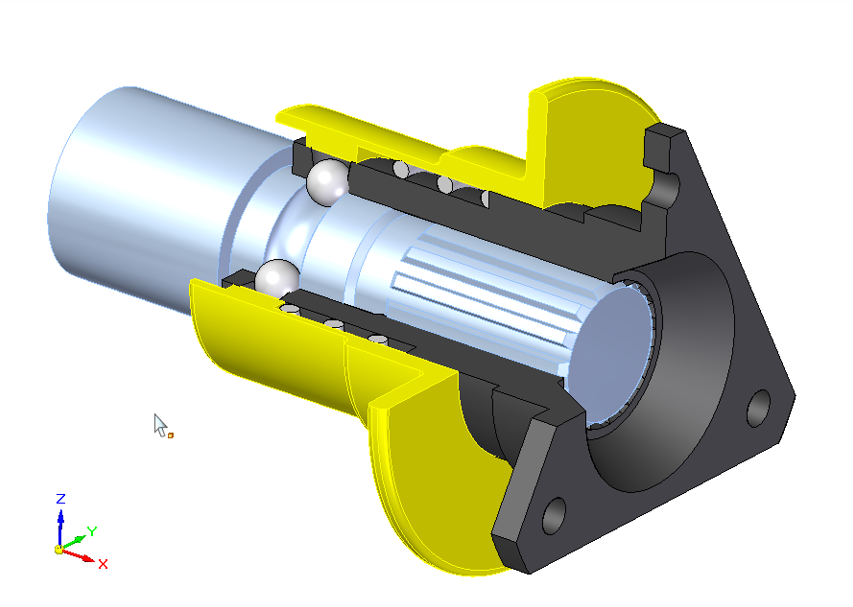
[picture p132: figure]

Frank Miller (https://grabcad.com/library/quick-release-steering-hub--1)

## NEXT STEPS

Finish brake system

Fit Rack & Pinion System + Steering Wheel

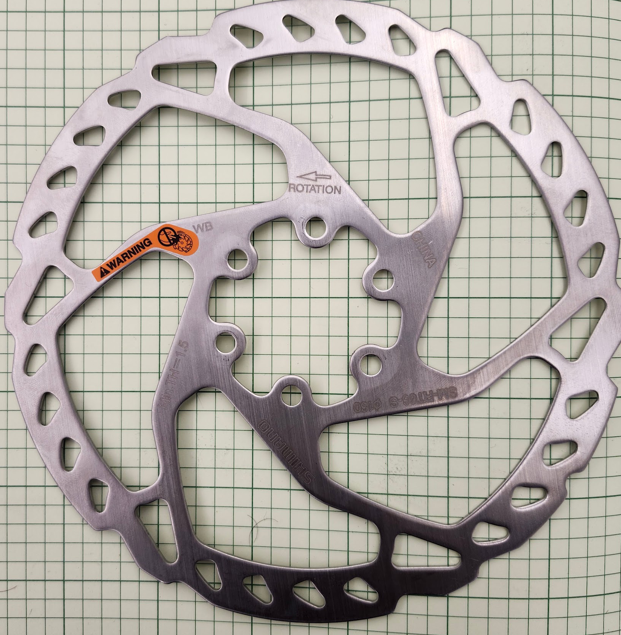
[picture p133: figure]
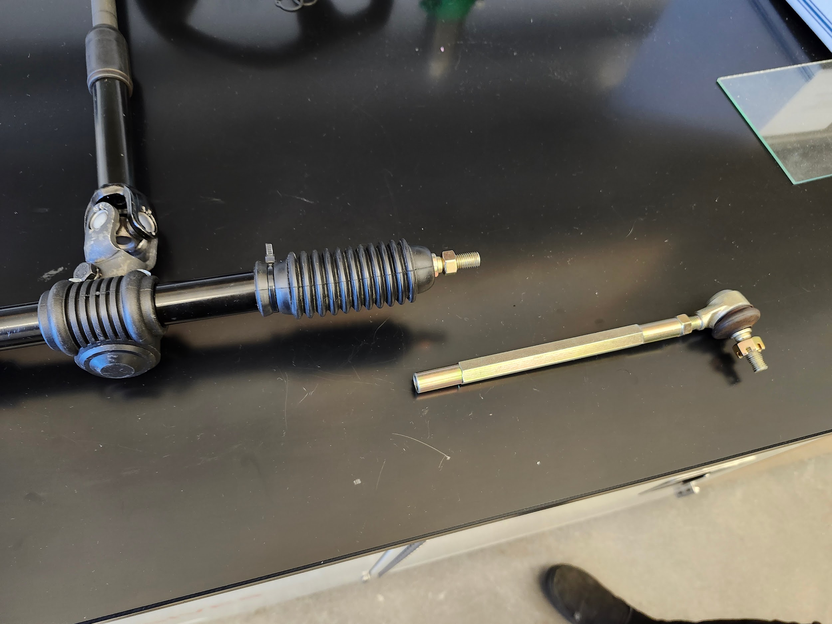
[picture p134: figure]
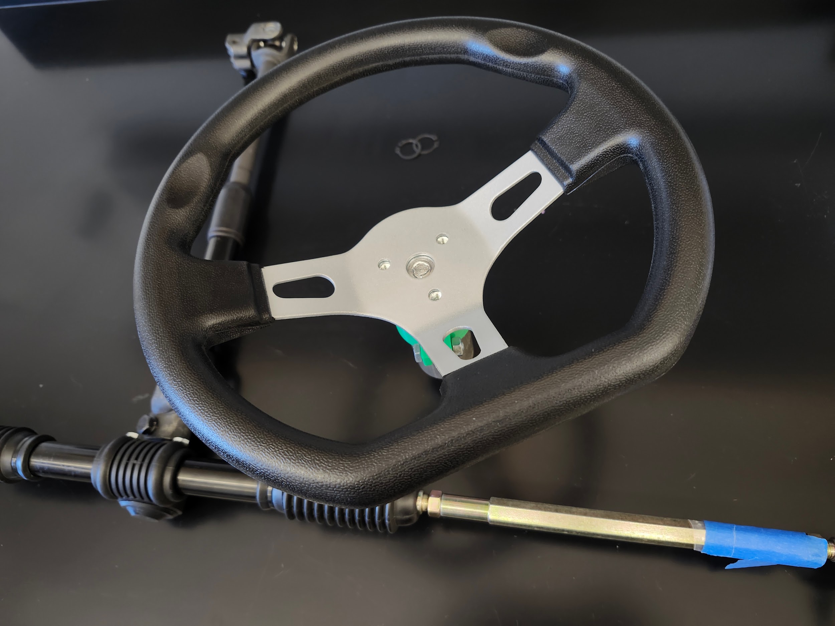
[picture p135: figure]

Modify Power into Pedal

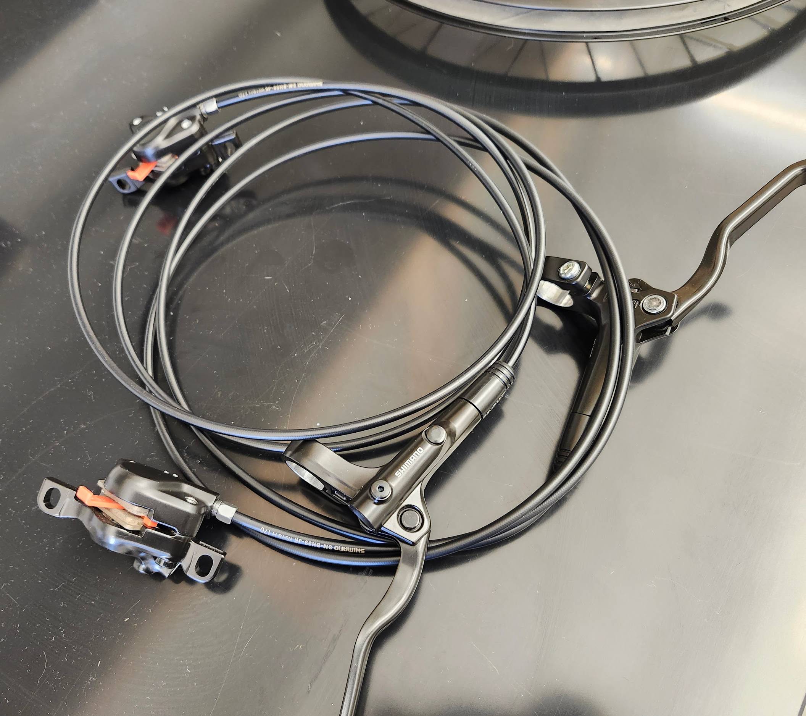
[picture p136: figure]
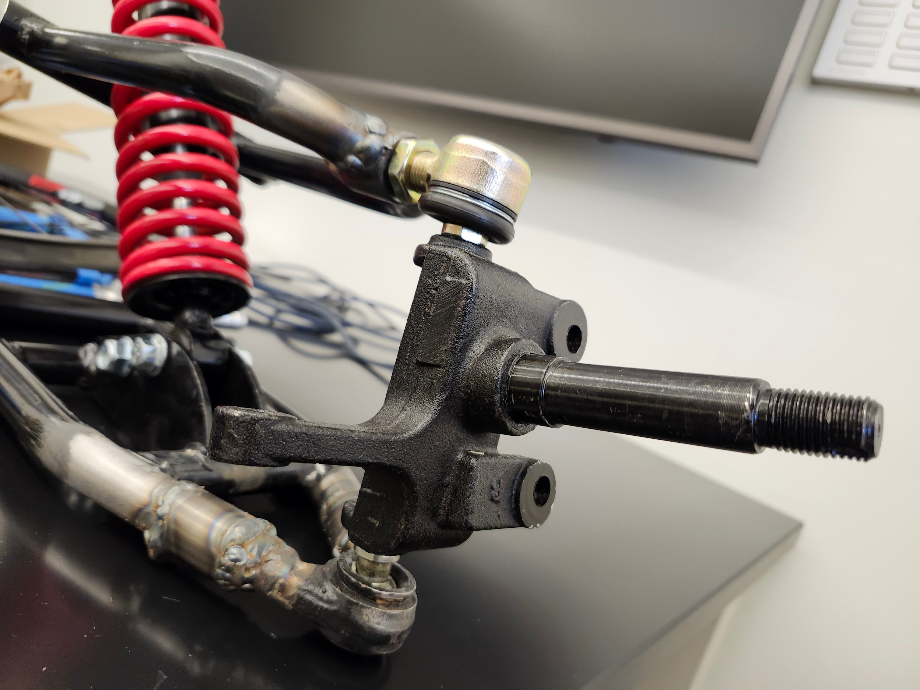
[picture p137: figure]
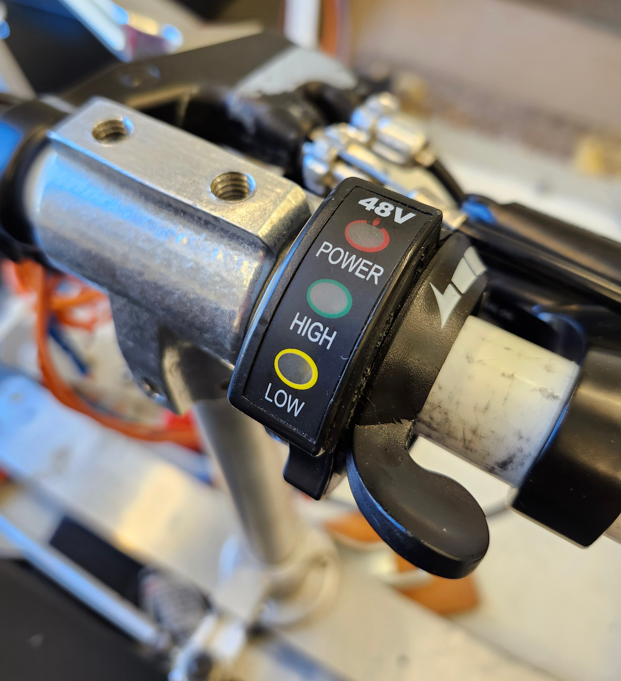
[picture p138: figure]

Finish Suspencion

## Questions?

Thank You
