JeffreyLiang3449/HFCV-Website/2024 Summer Research/HFCV SummerPresentation.pptx

## Hydrogen Fuel Cell Vehicle

Nora Jiang
Professor Carr Everbach

## Table of contents 03 01 02

Introduction

Current
Project

Future
Considerations

## Introduction 01

What is a HFCV? And why is there one sitting in the High Bay?

## What you need to know first

Hydrogen (H2) as a fuel?

- H2 is an energy carrier (like gasoline)
- Energy is produced through electrolysis
- Stored as a liquid before entering the fuel cell

Why switch to H2

- H2 is incredibly energy dense
- Clean in comparison to gas
- Large range before needing to refuel

## Slide 5

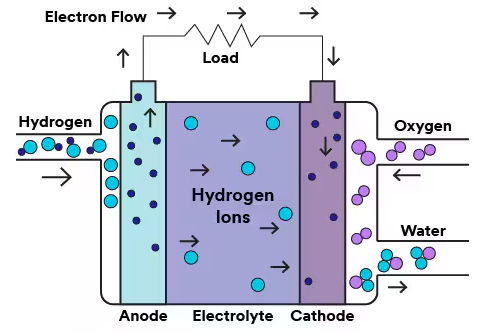
[picture p141: figure]

Inside the Fuel Cell

Our Actual Fuel Cell

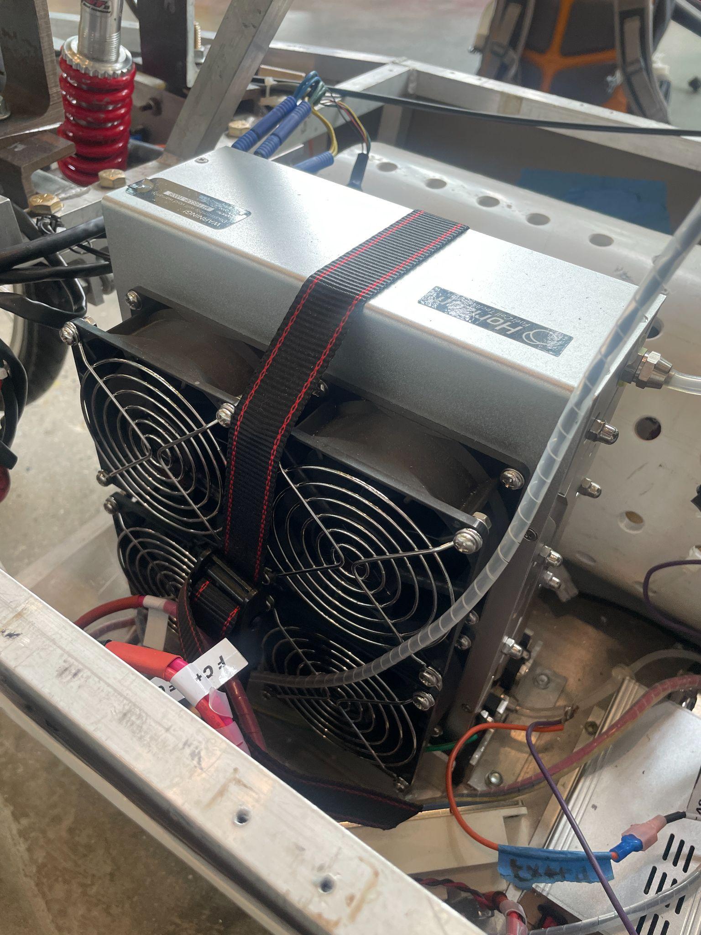
[picture p142: figure]

Photo Courtesy of 3M

## Shell Eco Marathon

What Is It?

Competition to make the most energy efficient vehicle

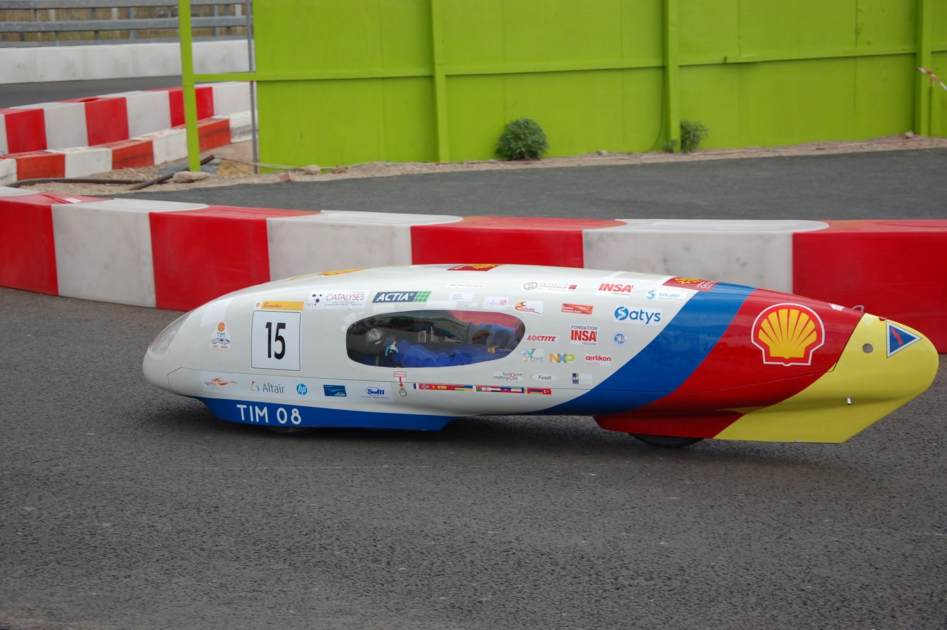
[picture p143: figure]

Why Compete?

Gives a target for our work on the vehicle

Photo Courtesy of Shell Eco Marathon

## Current Project 02

Rebuilding the Chassis

## Before This Summer

- Previous vehicle
  - No longer adheres to Shell’s safety standards
  - Needs a complete rebuild before competition ready
- Revitalization w/ Ben, Jano, and Justin
  - Materials testing
  - Preliminary Chassis Design
  - Rear Brakes and Suspension system


## Rough Design From Ben and Justin


## Goal: New Front End

## What will that take?

Choosing Components

What suspension to use? What size of wheels to use?

Construction

Actually putting together the front end

2

4

1

Fabrication Techniques

Learning how to weld, 3D print, and Lathe

3

Front Chassis Design

Using the general idea left by Ben and Justin, create a new design

5

Completion

## Future Considerations 03

Rebuilding the rest of the HFCV

## Fall 2024

Rear of Chassis

Build and fit the rear wheel + suspension system

Floor of Vehicle

Purchase components and assemble

Electrical Components

Wire the new car and put in the hydrogen system

## Spring 2025

Cowl Design and Build

Compete

Transport Team and Car to Indiana

Build the Cowl for the vehicle so that its not a skeleton

Testing

Testing entire system to the Shell Eco Marathon Requirements

## Thank you for listening

Questions, Comments, Concerns?

njiang1@swarthmore.edu
avasque1@swarthmore.edu
ceverba1@swarthmore.edu
