JeffreyLiang3449/HFCV-Website/2025 Summer Research/HFCV SummerPresentation_Jun25.pptx

## Hydrogen Fuel Cell Vehicle

Nora Jiang and Matthew Shiley
Professor Carr Everbach

## Table of contents 03 01 02

Introduction

Current
Project

Future
Considerations

## Introduction 01

What is a HFCV? And why is there one sitting in the hallway?

## What you need to know first

Hydrogen (H2) as a fuel?

- H2 is an energy carrier (like gasoline)
- Energy is produced through electrolysis
- Stored as a liquid before entering the fuel cell

Why switch to H2

- H2 is incredibly energy dense
- Clean in comparison to gas
- Large range before needing to refuel

## Slide 5


Inside the Fuel Cell

Our Actual Fuel Cell


Photo Courtesy of 3M

## Shell Eco Marathon

What Is It?

Competition to make the most energy efficient vehicle


Why Compete?

Gives a target for our work on the vehicle

Photo Courtesy of Shell Eco Marathon

## Current Project 02

Rebuilding the Chassis, pt. 2

## Before This Summer

- Previous vehicle
  - No longer adheres to Shell’s safety standards
  - Needs a complete rebuild before competition ready
- Revitalization: 2023-2025
  - Materials testing
  - Preliminary Chassis Design
  - Rear Brakes and Suspension system
  - New Braking system
  - Steering components


## Progress So Far!

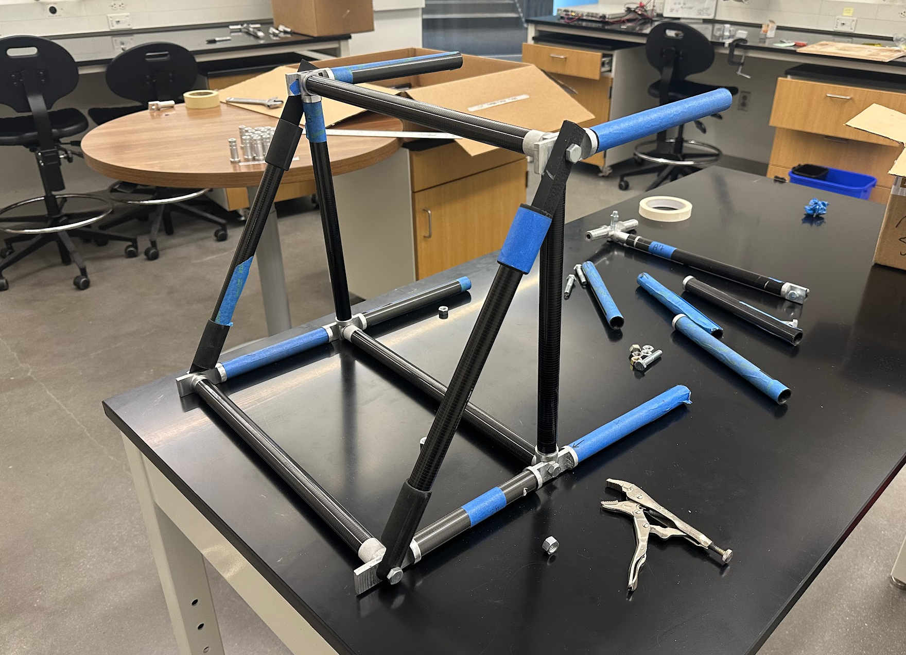
[picture p148: figure]

## Rough Chassis Design Plan

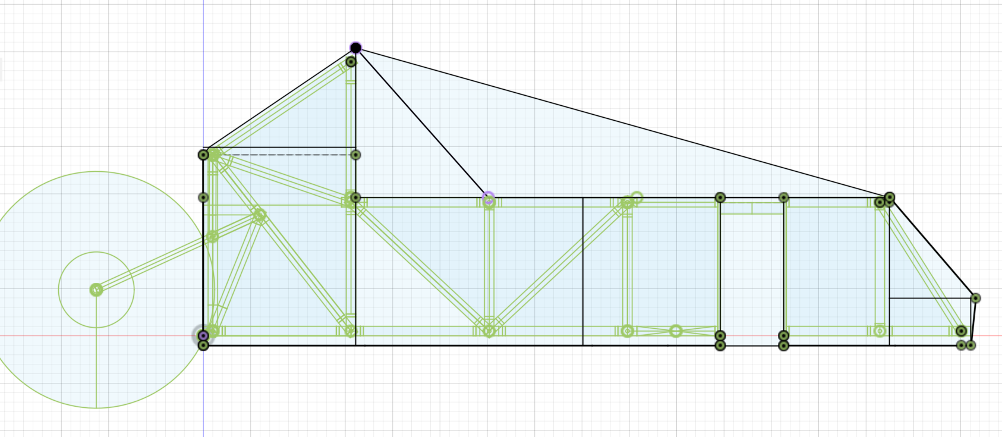
[picture p149: figure]

## 3D Printed Clips

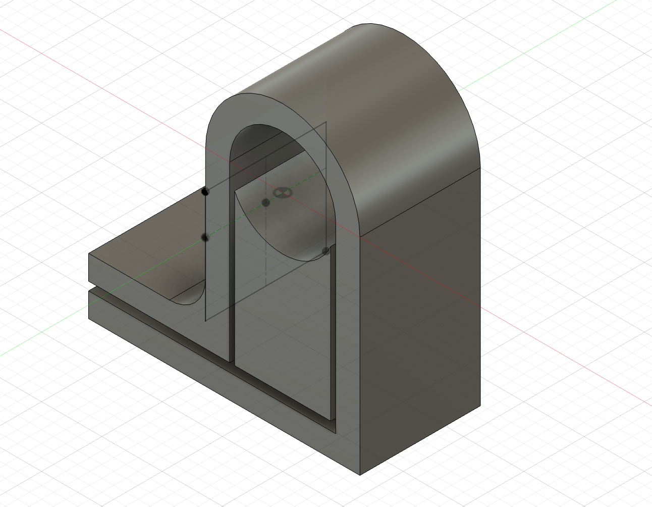
[picture p150: figure]
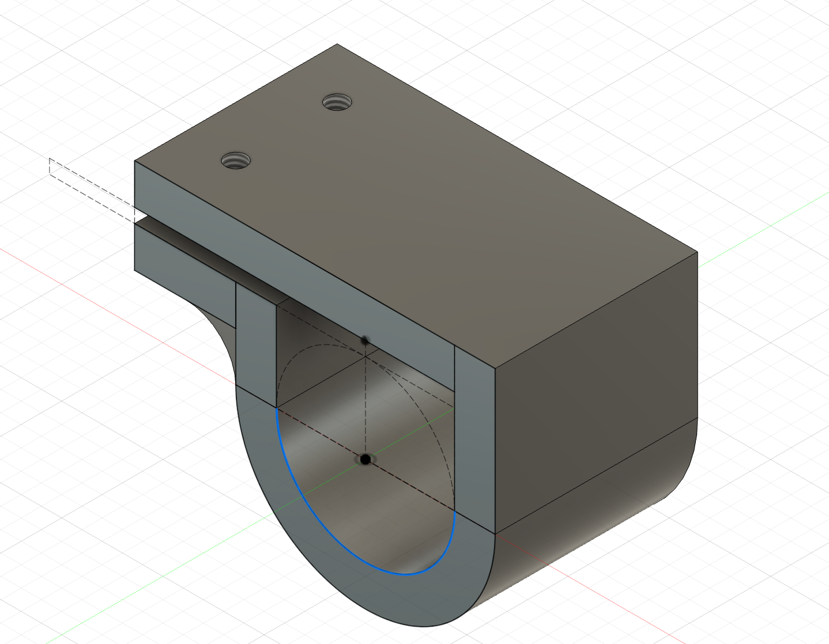
[picture p151: figure]

## Future Considerations 03

Rebuilding the rest of the HFCV

## The Next Year (or so)

Putting it all together

Compete

Transport Team and Car to Indiana

Chassis + Cowl
+
Mechanical Components

Testing

Testing entire system to the Shell Eco Marathon Requirements

## Thank you for listening

Questions, Comments, Concerns?

njiang1@swarthmore.edu
mshiley1@swarthmore.edu
avasque1@swarthmore.edu
ceverba1@swarthmore.edu
