JeffreyLiang3449/HFCV-Website/docs/2026 E90 work/Mid-Semester Presentation.pdf

# Shell Eco-Marathon

# Jano Vasquez-Jaffe & Kimaru Boruett

# Shell Eco-Marathon

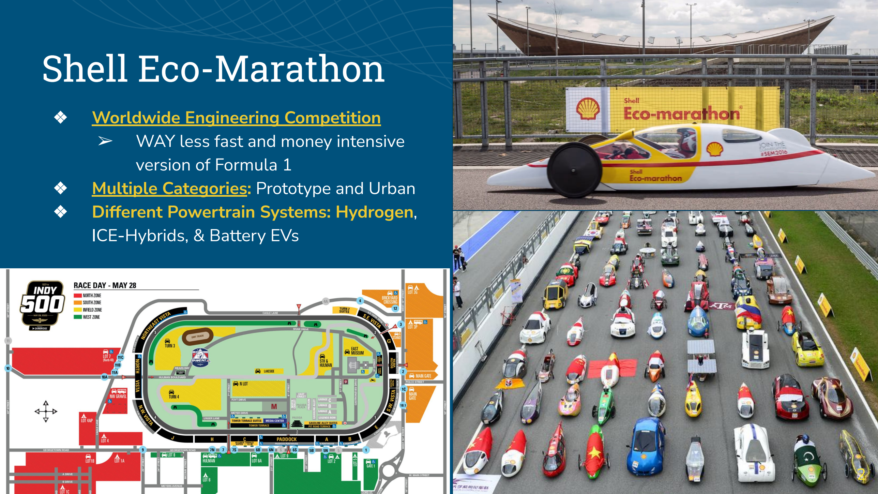
[picture p159: page 2]

2

❖ | Worldwide Engineering Competition
| ➢ WAY less fast and money intensive
| version of Formula 1
❖ | Multiple Categories: Prototype and Urban
❖ | Different Powertrain Systems: Hydrogen,
| ICE-Hybrids, & Battery EVs

# Prior

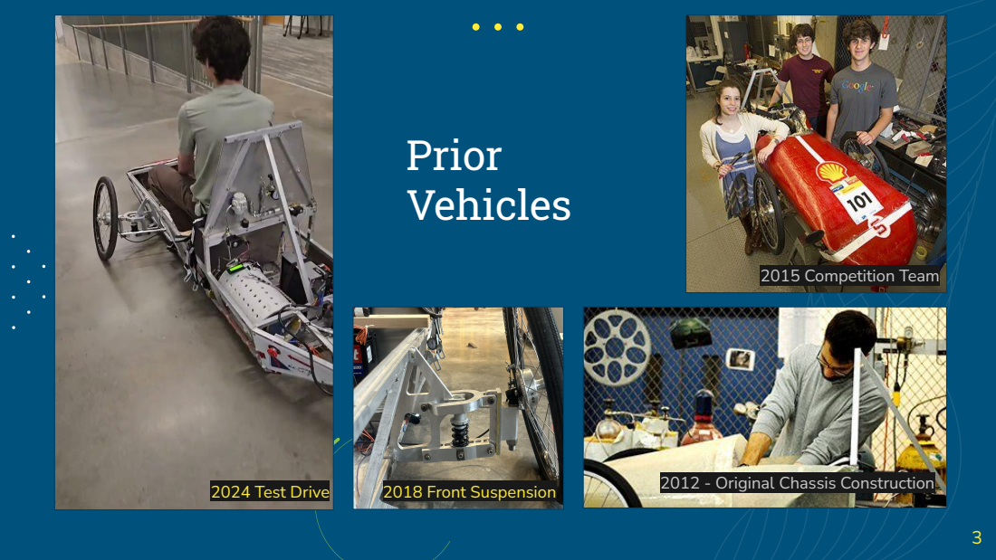
[picture p160: page 3]
Vehicles; 2015 Competition Team; 2012 - Original Chassis Construction 2024 Test Drive; 2018 Front Suspension

# Past 3

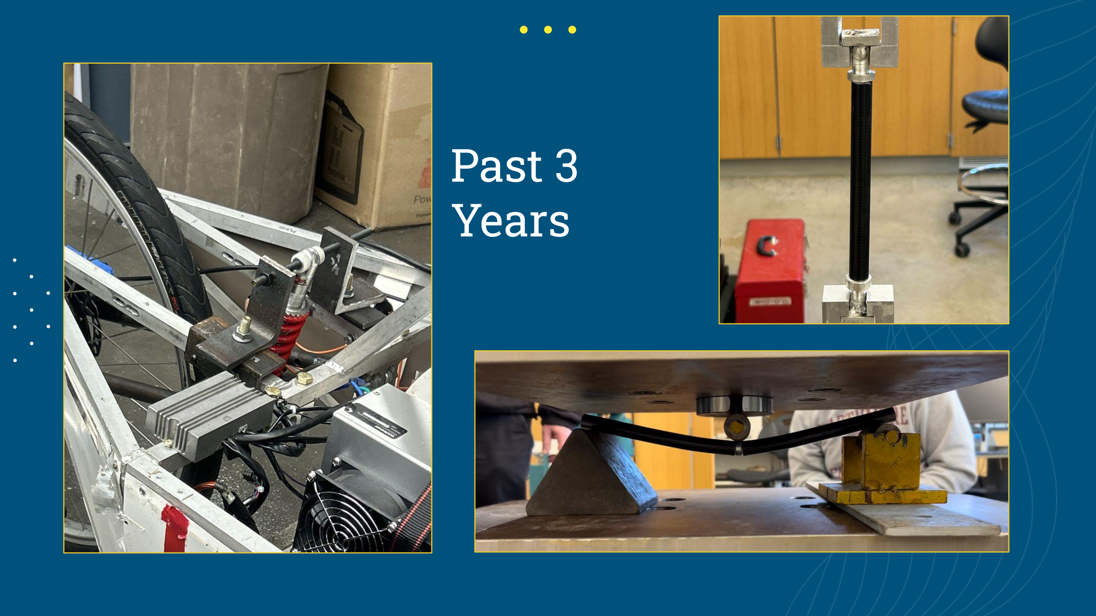
[picture p161: page 4]

# Years

# Current

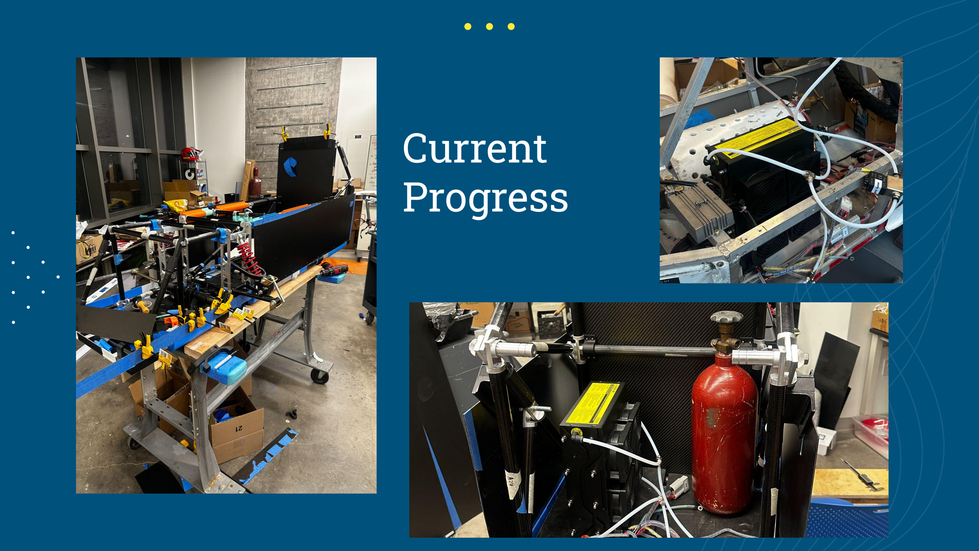
[picture p162: page 5]

# Progress

# Motivation

We need a telemetry system that is simple to operate, fast to iterate, and tailored to the signals that matter.

- Competition software introduces overhead: setup complexity, extra dependencies, and workflow friction for a student team.
- The car produces raw data streams that still need decoding and interpretation before they become useful engineering information.
- We need one pipeline that supports development now with simulation data and then transitions cleanly to live sensors already installed on the car.

Design requirements

Low
overhead

No unnecessary platform complexity — just capture, decode, process, and display.

Structured
telemetry

Convert raw hex data into consistent fields for fuel-cell health, dynamics, driver input, and position.

Real-time
streaming

Push updates quickly enough for a live dashboard and future testing sessions.

Sensor-ready
architecture

Keep the transport and frontend stable so only the input layer changes when real sensors are connected.

Motivation Summary: Build a lean telemetry workflow the team can control end-to-end.

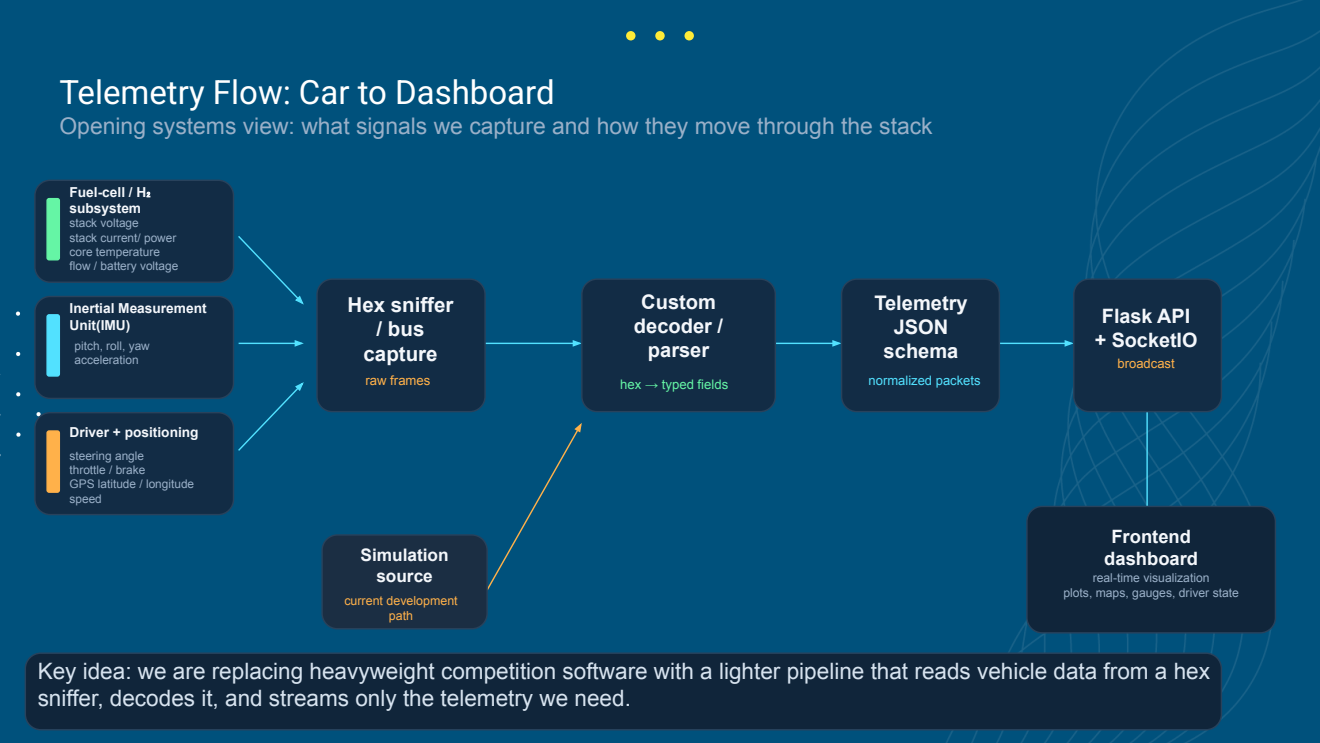
[picture p163: page 7]
Inertial Measurement Unit(IMU); Hex sniffer / bus capture; raw frames; Custom decoder / parser; Telemetry JSON schema; normalized packets; Flask API + SocketIO; broadcast; Frontend dashboard; Simulation source; current development path

Telemetry Flow: Car to Dashboard
Opening systems view: what signals we capture and how they move through the stack

Fuel-cell / H₂

subsystem
stack voltage stack current/ power core temperature flow / battery voltage

pitch, roll, yaw
acceleration

hex → typed fields

Driver + positioning

steering angle throttle / brake GPS latitude / longitude speed

real-time visualization
plots, maps, gauges, driver state

Key idea: we are replacing heavyweight competition software with a lighter pipeline that reads vehicle data from a hex
sniffer, decodes it, and streams only the telemetry we need.

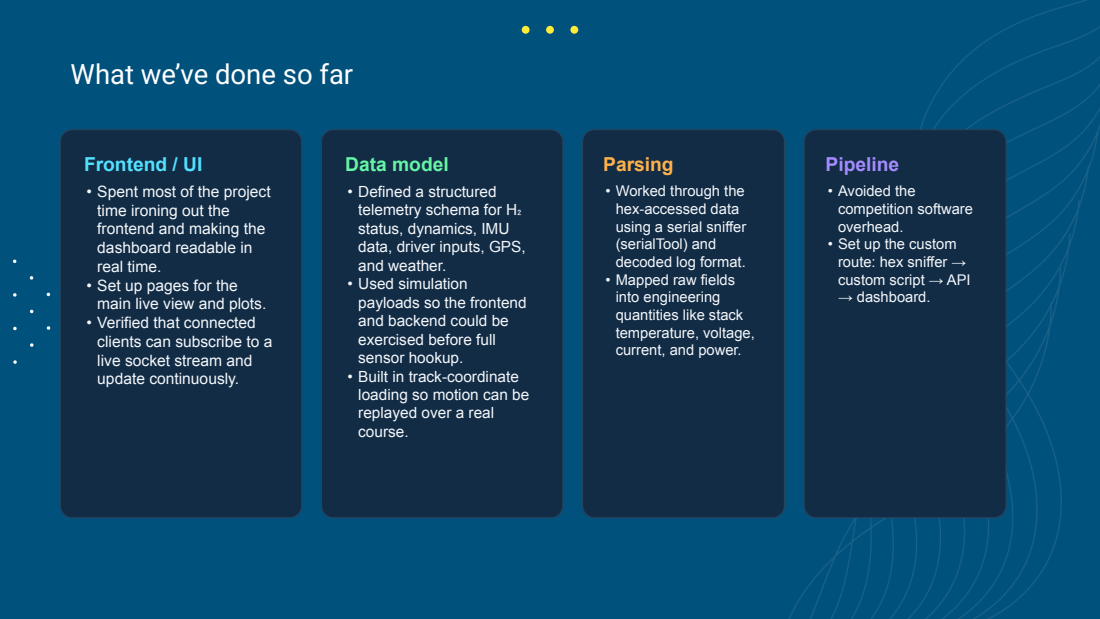
[picture p164: page 8]
Frontend / UI; Data model; Parsing; Pipeline

What we’ve done so far

• Spent most of the project
time ironing out the
frontend and making the
dashboard readable in
real time.
• Set up pages for the
main live view and plots.
• Verified that connected
clients can subscribe to a
live socket stream and
update continuously.

• Defined a structured
telemetry schema for H₂
status, dynamics, IMU
data, driver inputs, GPS,
and weather.
• Used simulation
payloads so the frontend
and backend could be
exercised before full
sensor hookup.
• Built in track-coordinate
loading so motion can be
replayed over a real
course.

• Worked through the
hex-accessed data
using a serial sniffer
(serialTool) and
decoded log format.
• Mapped raw fields
into engineering
quantities like stack
temperature, voltage,
current, and power.

• Avoided the
competition software
overhead.
• Set up the custom
route: hex sniffer →
custom script → API
→ dashboard.

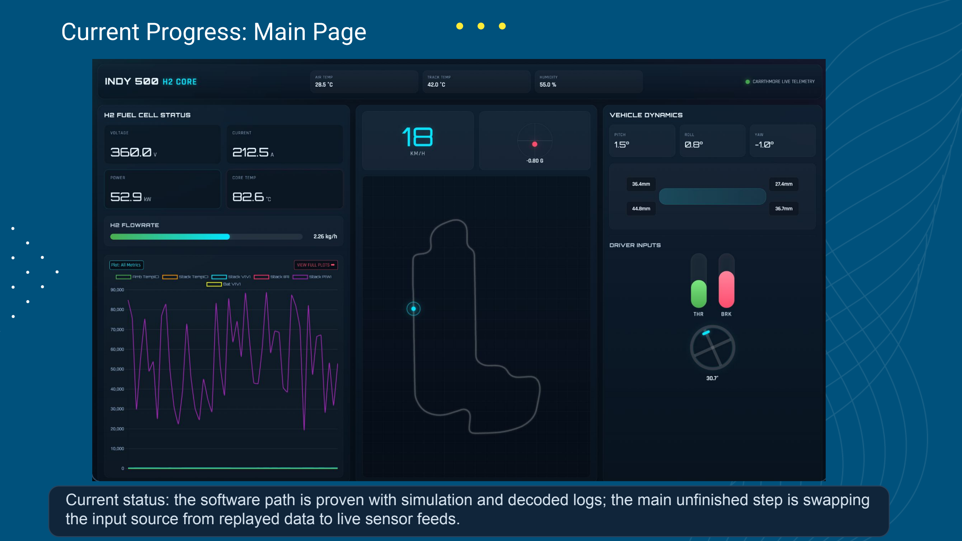
[picture p165: figure]
Current Progress: Main Page

Current status: the software path is proven with simulation and decoded logs; the main unfinished step is swapping the input source from replayed data to live sensor feeds.

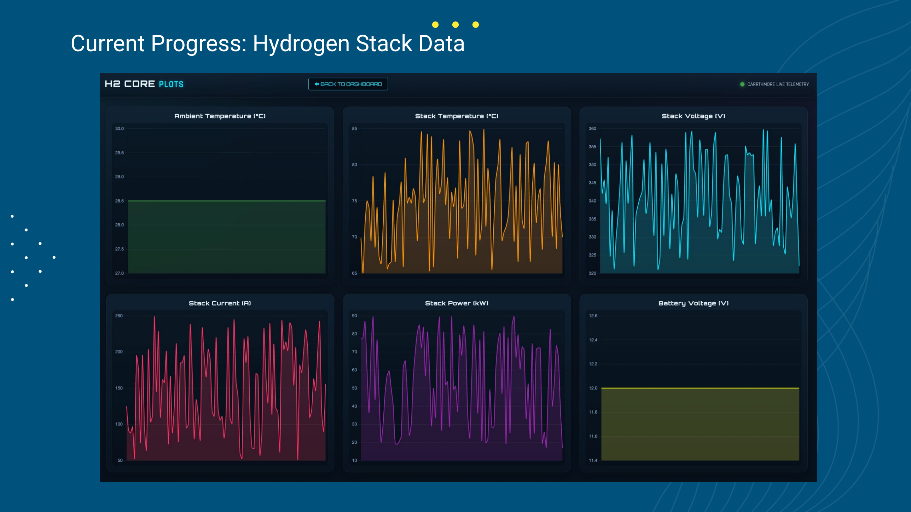
[picture p166: page 10]

Current Progress: Hydrogen Stack Data

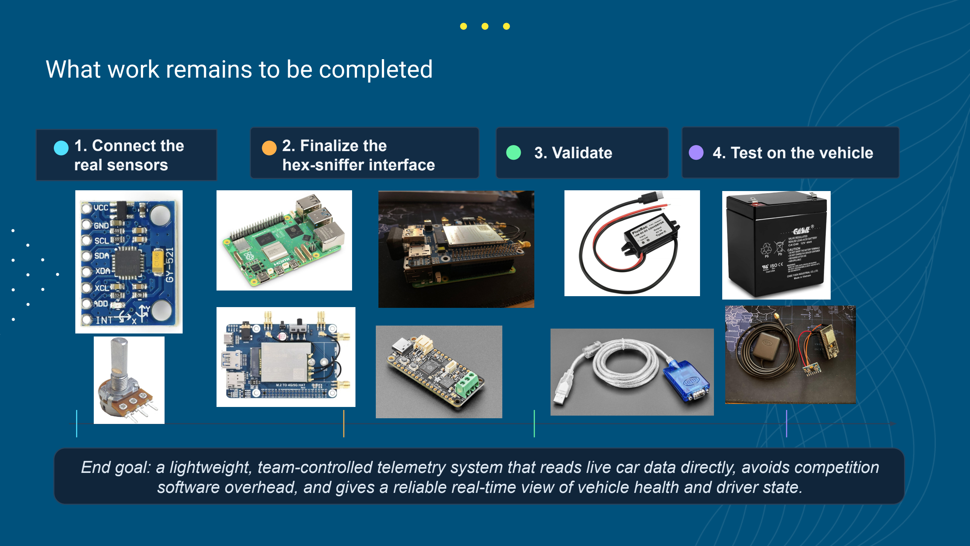
[picture p167: figure]
What work remains to be completed; 1. Connect the real sensors; 2. Finalize the hex-sniffer interface; 3. Validate; 4. Test on the vehicle

End goal: a lightweight, team-controlled telemetry system that reads live car data directly, avoids competition software overhead, and gives a reliable real-time view of vehicle health and driver state.

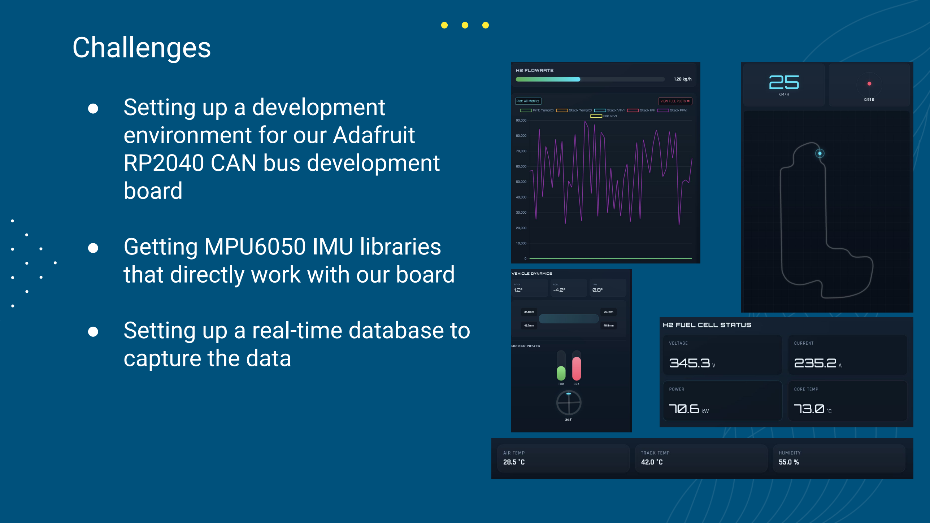
[picture p168: page 12]

### Challenges

- Setting up a development environment for our Adafruit RP2040 CAN bus development board
- Getting MPU6050 IMU libraries that directly work with our board
- Setting up a real-time database to capture the data

- Finish moving power train to new vehicle
- Add tires
- Perform mock inspection

# Preparation for Race Day

- April 7-11th
- Vehicle Transport by van, others by air
- Rotating van drivers/ air travelers
- Hotel near track
- Meals paid for by OSE

# This Year’s Race: Logistics
