JeffreyLiang3449/HFCV-Website/2026 Shell Eco Marathon/Fall 25 Budget HFCV.qmd

**Fall 2025 Budget Request for Shell-Eco Marathon Club**

\[Student 2\] Treasurer

> Alexander Vasquez-Jaffe
>
> President

  ----------------------------- --------------------- ------------------------------------------
   **Subcode Number and Name**   **Requested Funds**   **Actual Allocation (For SBC Use Only)**

      7310: Food/ Catering              \$50          

         7011: Supplies              \$2,482.18       

                                                      

            **Total**                \$2,532.18       
  ----------------------------- --------------------- ------------------------------------------

**GROUP INFORMATION**

  --------------------------------------------------------------------------------- ------------
  Total Number of Members in Group (approx.)                                        5

  Of that number, how many participate in all or most of your group's activities?   5

  How many participate in some of your group's activities?                          5

  About how many non-members participate in your regular activities?                5

  How much time, per week, do your most active members spend on group activities?   \-

  How much time, per week, does your average member spend on group activities?      \-
  --------------------------------------------------------------------------------- ------------

In brief, can you describe what the regular activities of your group are?

Our club is focused on designing, building, and refining a hydrogen fuel cell vehicle to compete in the Shell Eco-marathon. Members gain hands-on experience in engineering areas such as hydrogen systems, electrical design, aerodynamics, and vehicle mechanics. The club emphasizes innovation, collaboration, and sustainability, providing opportunities for students to contribute to cutting-edge renewable energy projects while developing technical and problem-solving skills.

[\[\*\*\*\*\] \_\_\_\_ Group APPROVED for - -]{.mark}

- \[7310\]: \[Food/Catering\]:

**\$50 - Snacks for the team**

- \[7011\]: \[Supplies\]:

+---------------------------------------------------------------------------------------------------------------------------------------------------------------------------------------------------------------------------------------------------------------------------------------------------------------------------------------------------------------------------------------------------------------------------------------------------------------------------------------------------------------------------------------------------------------------------------------------------------------------------------------------------------------------------------------------------------------------------------+
| **Supplies Budget**                                                                                                                                                                                                                                                                                                                                                                                                                                                                                                                                                                                                                                                                                                             |
+-------------------------------------------------------------------------------------------------------------------------------------------------------------------------------------------------------------------------------------------------------------------------------------------------------------------------------------------------------------------------------------------------------------------------------------------------------------------------------------------------------------------------------------------------------------------------------------------------------------------------------------------------------------------------------------------+-------------------------------------+
| **Product**                                                                                                                                                                                                                                                                                                                                                                                                                                                                                                                                                                                                                                                                               | **Cost (USD)**                      |
+-------------------------------------------------------------------------------------------------------------------------------------------------------------------------------------------------------------------------------------------------------------------------------------------------------------------------------------------------------------------------------------------------------------------------------------------------------------------------------------------------------------------------------------------------------------------------------------------------------------------------------------------------------------------------------------------+-------------------------------------+
| [[Hydration Pack]{.underline}](https://www.backcountry.com/b/osprey-packs-katari-3l-backpack-osp00d4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)                         | 74.99                               |
+-------------------------------------------------------------------------------------------------------------------------------------------------------------------------------------------------------------------------------------------------------------------------------------------------------------------------------------------------------------------------------------------------------------------------------------------------------------------------------------------------------------------------------------------------------------------------------------------------------------------------------------------------------------------------------------------+-------------------------------------+
| [[Walkie Talkie]{.underline}](https://www.rei.com/product/895968/midland-t10-2-way-radios-pair?sku=8959680001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)                                                                                                                                                                                                                                                            | 30.00 x 5                           |
+-------------------------------------------------------------------------------------------------------------------------------------------------------------------------------------------------------------------------------------------------------------------------------------------------------------------------------------------------------------------------------------------------------------------------------------------------------------------------------------------------------------------------------------------------------------------------------------------------------------------------------------------------------------------------------------------+-------------------------------------+
| [[Clip-on Battery Fan]{.underline}](https://www.amazon.com/Treva-Inch-Battery-Powered-Multi-Directional/dp/B075QP4Q17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)                                                                                                                                                                                                                                                     | 18.99                               |
+-------------------------------------------------------------------------------------------------------------------------------------------------------------------------------------------------------------------------------------------------------------------------------------------------------------------------------------------------------------------------------------------------------------------------------------------------------------------------------------------------------------------------------------------------------------------------------------------------------------------------------------------------------------------------------------------+-------------------------------------+
| [[Fire Extinguisher]{.underline}](https://www.homedepot.com/pep/Kidde-Home-and-Workshop-5-B-C-Class-BC-2-35-lb-Fire-Extinguisher-21031882-21031882/312602847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) | 21.97                               |
+-------------------------------------------------------------------------------------------------------------------------------------------------------------------------------------------------------------------------------------------------------------------------------------------------------------------------------------------------------------------------------------------------------------------------------------------------------------------------------------------------------------------------------------------------------------------------------------------------------------------------------------------------------------------------------------------+-------------------------------------+
| [[Heat Shrink Butt Connectors]{.underline}](https://www.homedepot.com/p/Lukyamzn-330-Pieces-Heat-Shrink-Butt-Connectors-Copper-Insulated-Marine-Grade-Waterproof-Electrical-Crimp-Wire-Connectors-Kit-SA17-227B04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)                                                                                                                                                                                                                                                                                                                                                                                                                                                             | 135.65                              |
+-------------------------------------------------------------------------------------------------------------------------------------------------------------------------------------------------------------------------------------------------------------------------------------------------------------------------------------------------------------------------------------------------------------------------------------------------------------------------------------------------------------------------------------------------------------------------------------------------------------------------------------------------------------------------------------------+-------------------------------------+
| [[Heat Shrinking Tubing]{.underline}](https://www.homedepot.com/p/K-Tool-International-Heat-Shrink-Tube-Assortment-235-Piece-KTI07740/207038145)                                                                                                                                                                                                                                                                                                                                                                                                                                                                                                                                          | 18.69                               |
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
