JeffreyLiang3449/HFCV-Website/Chassis/Drawings/Rear Connector Dimensions and Quantities.html

Connector Dimensions Legend Quantity Dimensions (in)

                                                                                                        ·

Encard Chole 0 5 from Ended (hole edgel center)

                                                                                                          able
                                                                                                                                                     Lathe

                                                                                                                   in

~ .

                                                                                away
                                                                                                                                                     Mill
                                                                                 0 5 in
                                                                                  .

              III                                                               T                                                MisC
                                      Length
                                                                                                                             g    cross   member
          Quantity                Length                                        Sin)

               2                  3 25            .
                                                                                                                                   III
               1                      2                   .       5

               3                      2 3             .

                                      2                       0

               ↳
                                                          .

                                      1 90    .

               1                 1 75 .
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
