JeffreyLiang3449/HFCV-Website/2024 E90 work/Chassis Model/0b11f6816497d8c7261c3bc484ae6491.png

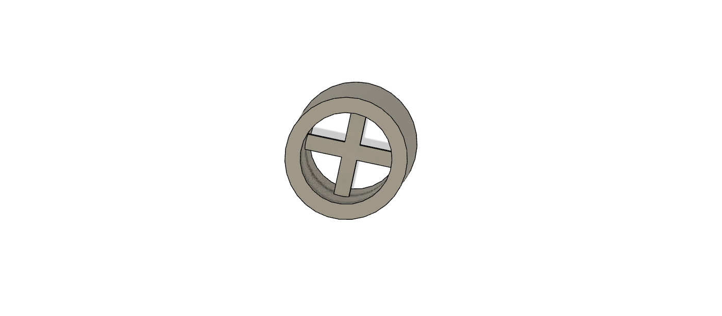
2024 E90 work/Chassis Model/0b11f6816497d8c7261c3bc484ae6491.png
