JeffreyLiang3449/HFCV-Website/2024 E90 work/Chassis Model/8ed2c39a44c8dd76476ae3f5b32cedae.png

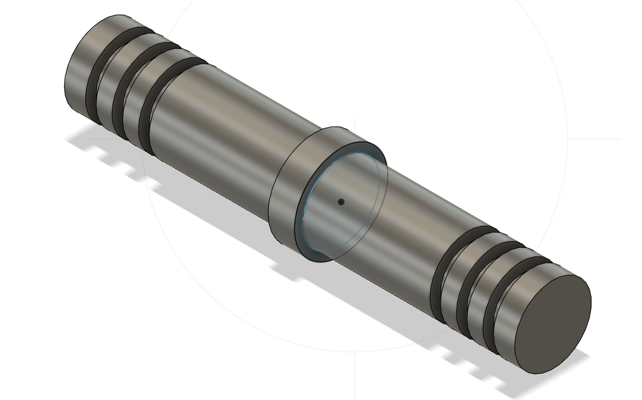
2024 E90 work/Chassis Model/8ed2c39a44c8dd76476ae3f5b32cedae.png
