JeffreyLiang3449/HFCV-Website/2024 E90 work/Chassis Model/309eee8e1b35b9fa25cdcde8a360374b.png

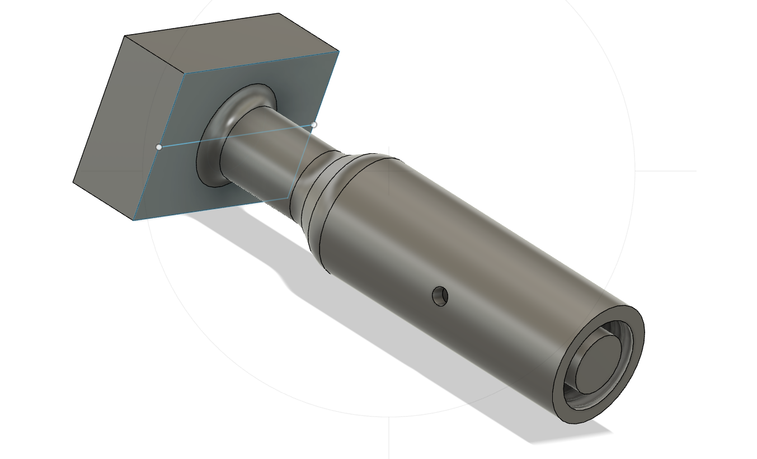
2024 E90 work/Chassis Model/309eee8e1b35b9fa25cdcde8a360374b.png
