JeffreyLiang3449/HFCV-Website/2024 E90 work/Chassis Model/282411266173532de2b6b86b18ff9c15.png

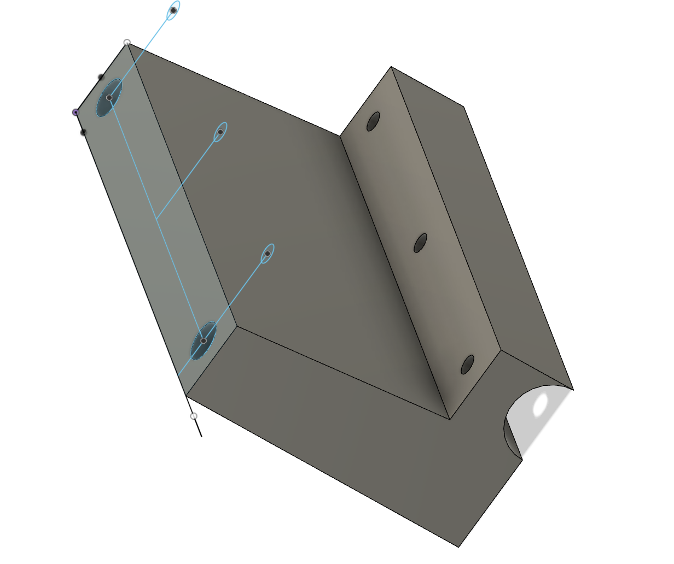
2024 E90 work/Chassis Model/282411266173532de2b6b86b18ff9c15.png
