JeffreyLiang3449/HFCV-Website/2024 E90 work/Chassis Model/b25c7bee6291727c5879477805d6510c.png

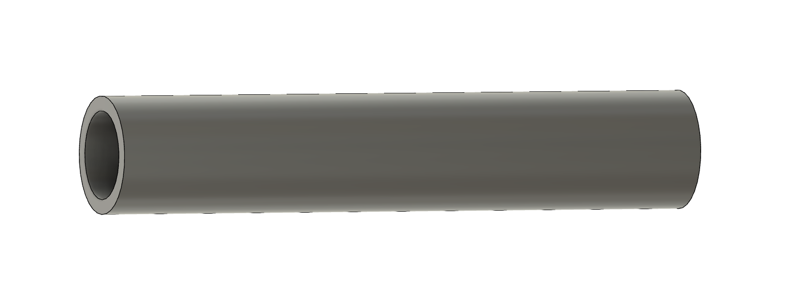
2024 E90 work/Chassis Model/b25c7bee6291727c5879477805d6510c.png
