JeffreyLiang3449/HFCV-Website/2024 E90 work/Chassis Model/brake attachment.png

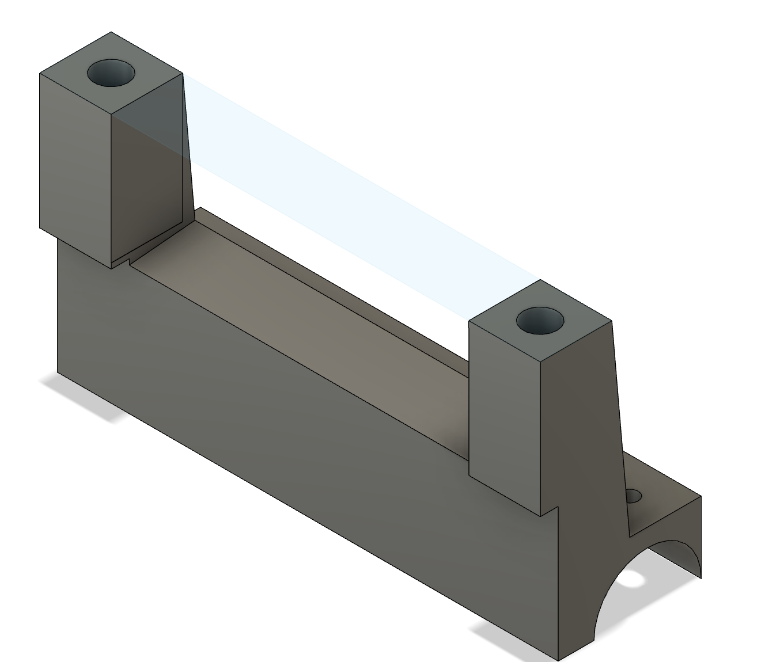
2024 E90 work/Chassis Model/brake attachment.png
