JeffreyLiang3449/HFCV-Website/2024 E90 work/Chassis Model/f8249817b7cf0b21c43965e5375a44eb.png

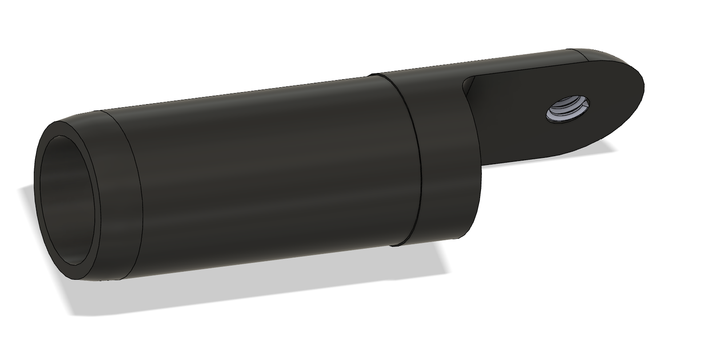
2024 E90 work/Chassis Model/f8249817b7cf0b21c43965e5375a44eb.png
