JeffreyLiang3449/HFCV-Website/2024 E90 work/Chassis Model/FrameJoints.PNG

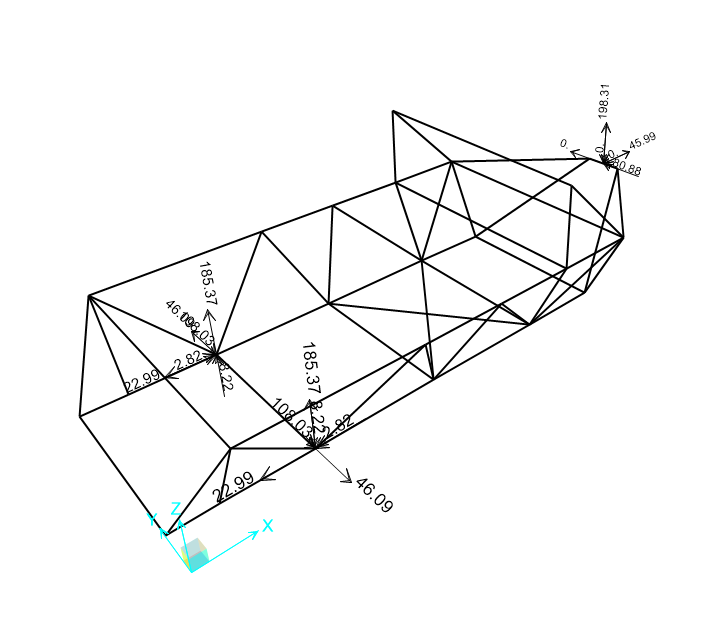
2024 E90 work/Chassis Model/FrameJoints.PNG
