JeffreyLiang3449/HFCV-Website/2024 E90 work/Chassis Model/Numbers.PNG

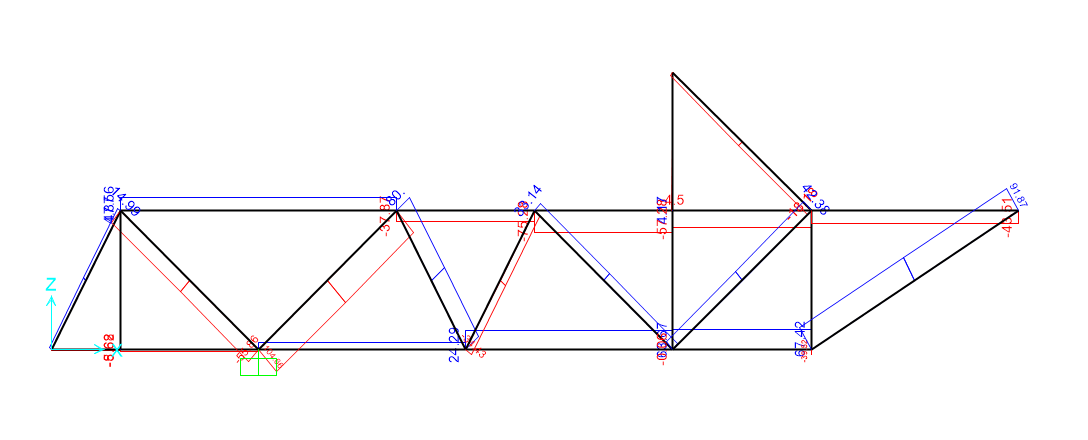
2024 E90 work/Chassis Model/Numbers.PNG
