JeffreyLiang3449/HFCV-Website/2024 E90 work/img/E90 HFCV Final Presentation2.jpg

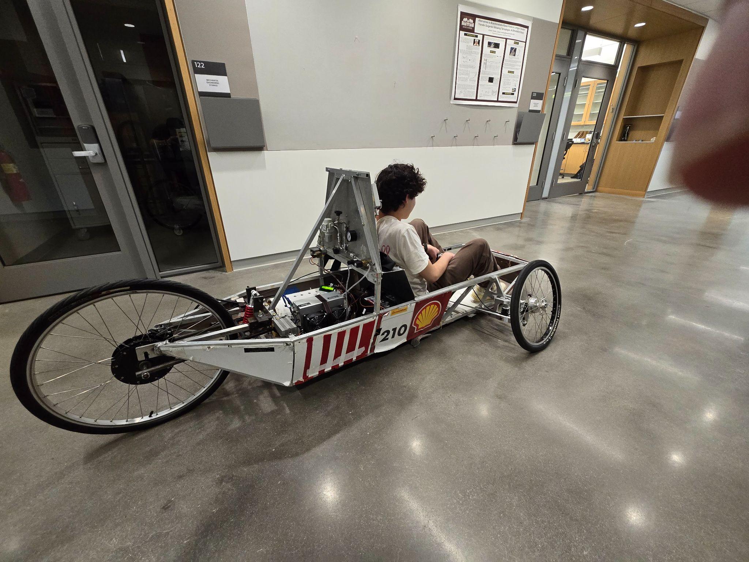
2024 E90 work/img/E90 HFCV Final Presentation2.jpg
