JeffreyLiang3449/HFCV-Website/2024 E90 work/Photos and videos/20240308_135947.jpg

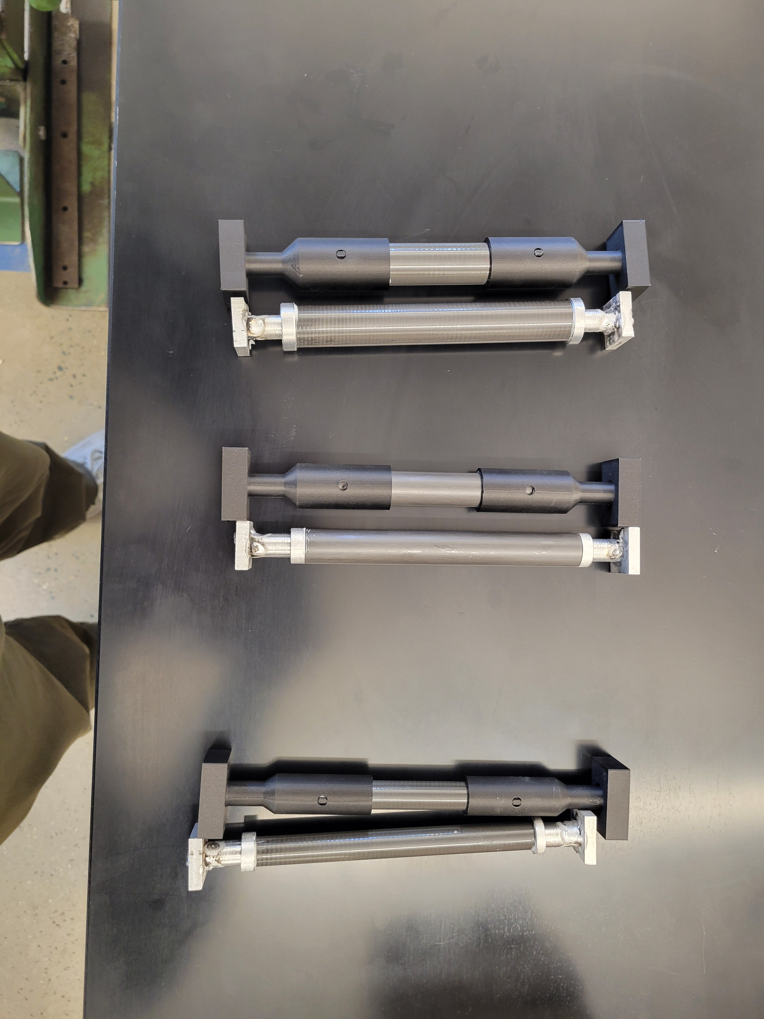
2024 E90 work/Photos and videos/20240308_135947.jpg
