JeffreyLiang3449/HFCV-Website/2024 E90 work/Photos and videos/20240430_174115.jpg

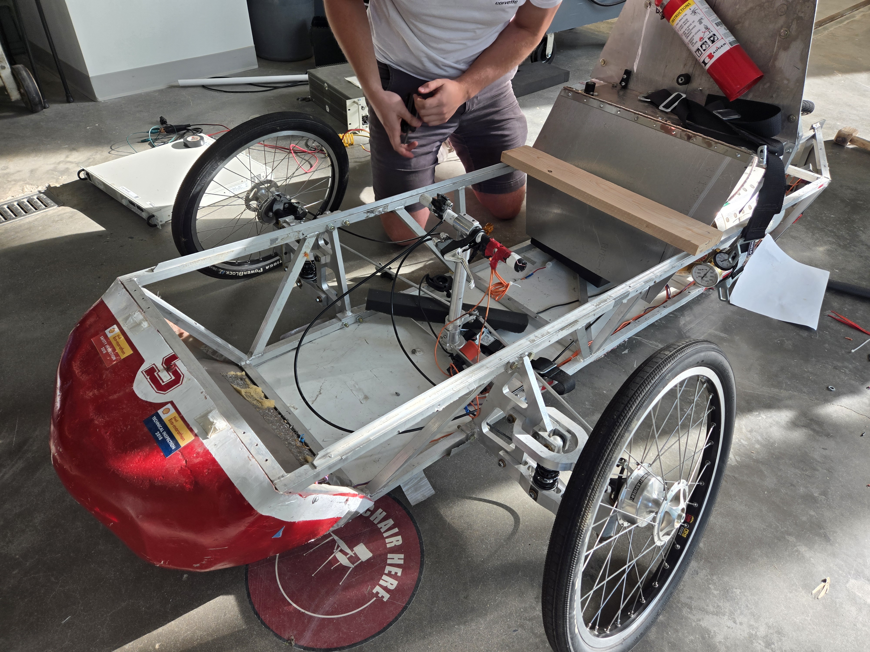
2024 E90 work/Photos and videos/20240430_174115.jpg
