JeffreyLiang3449/HFCV-Website/2024 E90 work/Photos and videos/Final pres/IMG-20240507-WA0007.jpg

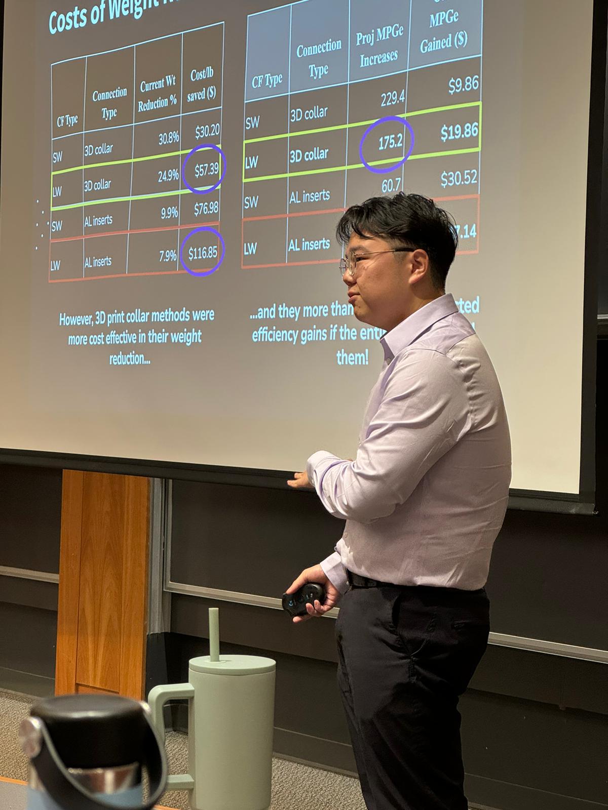
2024 E90 work/Photos and videos/Final pres/IMG-20240507-WA0007.jpg
