JeffreyLiang3449/HFCV-Website/2024 E90 work/She_ll eco marathon/IMG_8493.JPG

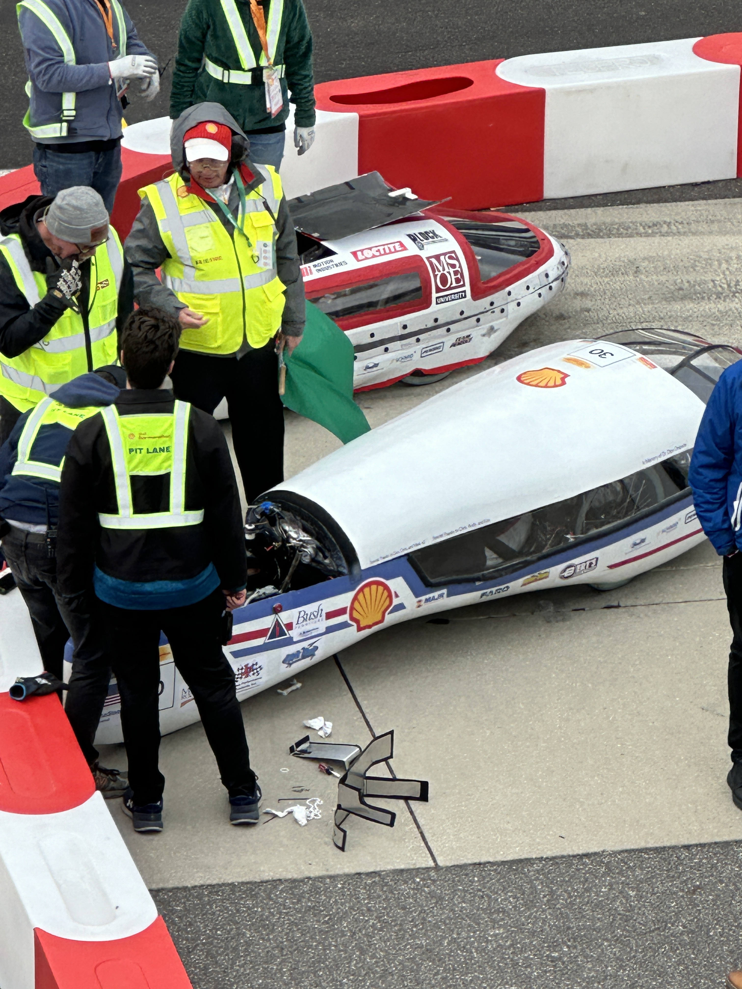
2024 E90 work/She_ll eco marathon/IMG_8493.JPG
