JeffreyLiang3449/HFCV-Website/2024 Summer Research/img/HFCV SummerPresentation0.png

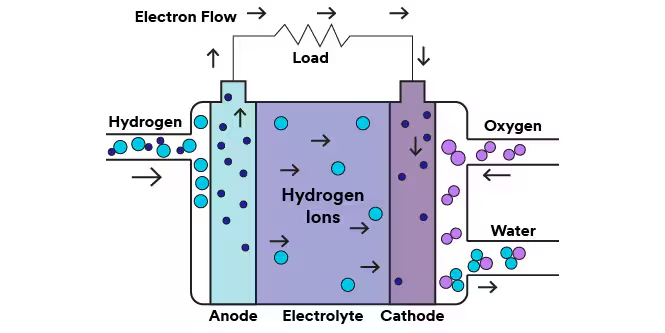
2024 Summer Research/img/HFCV SummerPresentation0.png
