JeffreyLiang3449/HFCV-Website/2025 E90 work/img/E90 Mid-Semester Presentation (GS, MM)21.jpg

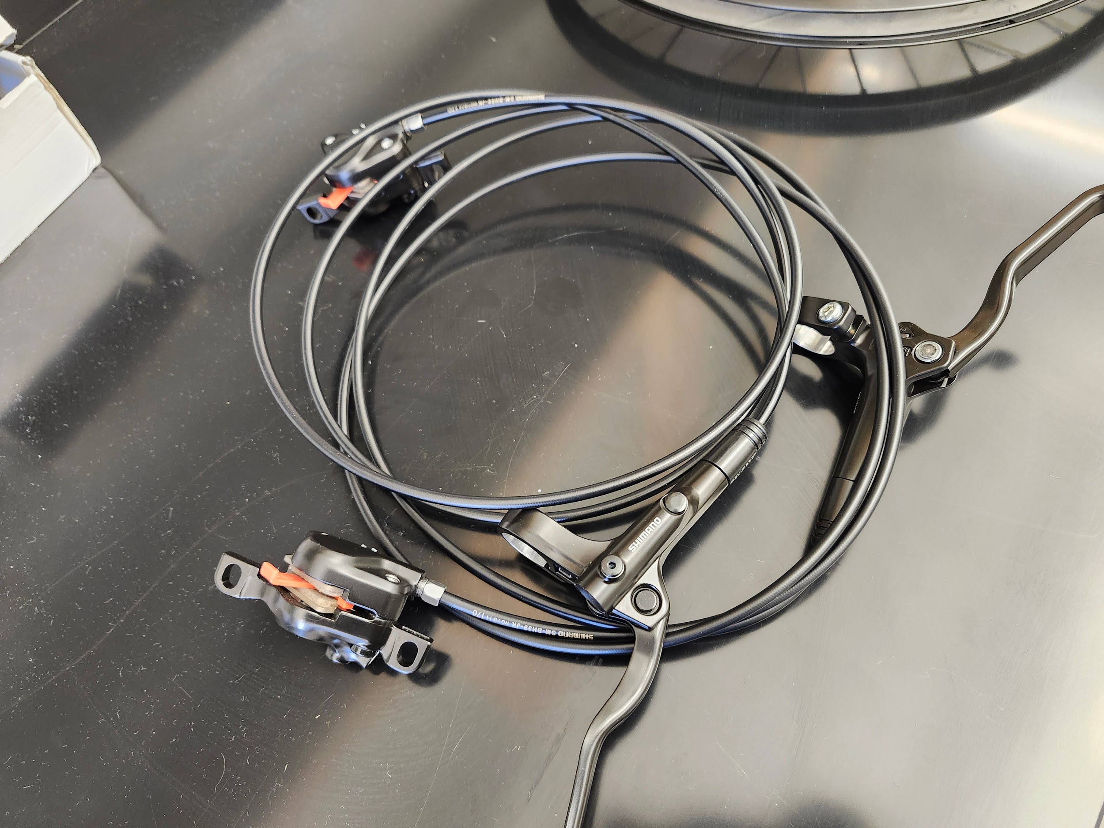
2025 E90 work/img/E90 Mid-Semester Presentation (GS, MM)21.jpg
