JeffreyLiang3449/HFCV-Website/2025 E90 work/media/media/image8.png

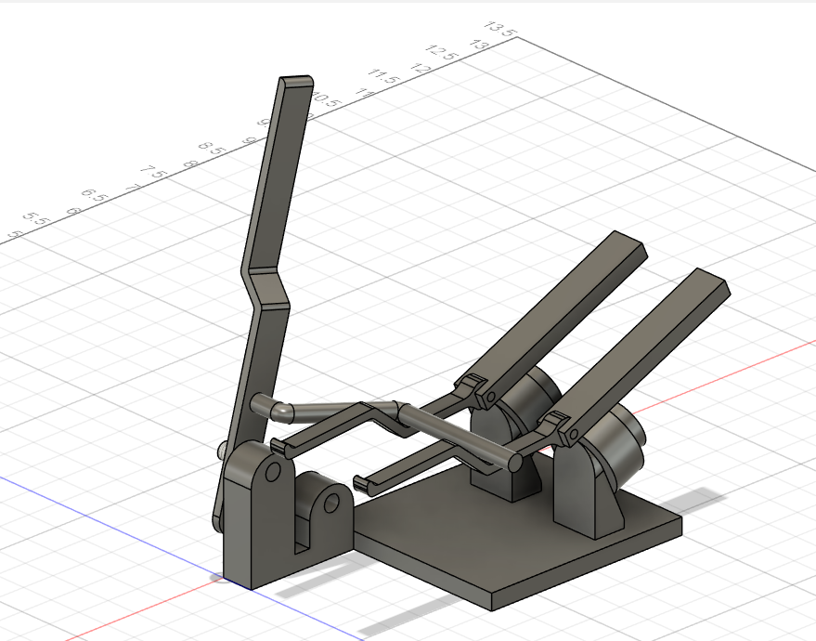
2025 E90 work/media/media/image8.png
