JeffreyLiang3449/HFCV-Website/2025 E90 work/media/media/image9.png

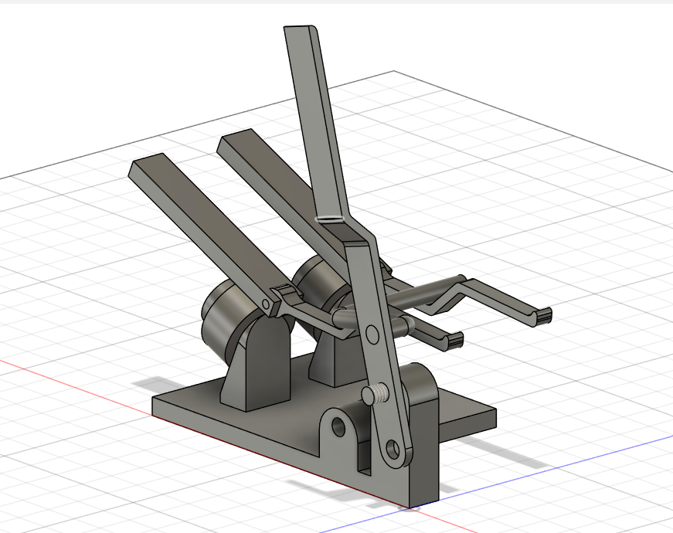
2025 E90 work/media/media/image9.png
