JeffreyLiang3449/HFCV-Website/2025 E90 work/media/media/image14.png

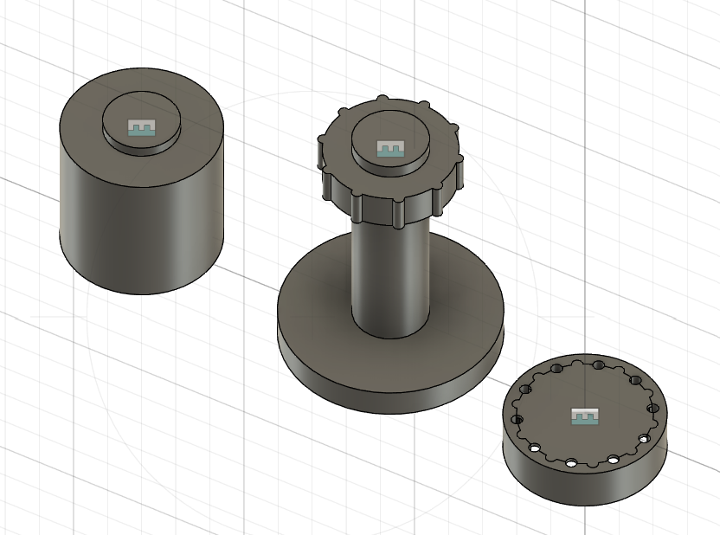
2025 E90 work/media/media/image14.png
