JeffreyLiang3449/HFCV-Website/2025 E90 work/media/media/image25.png

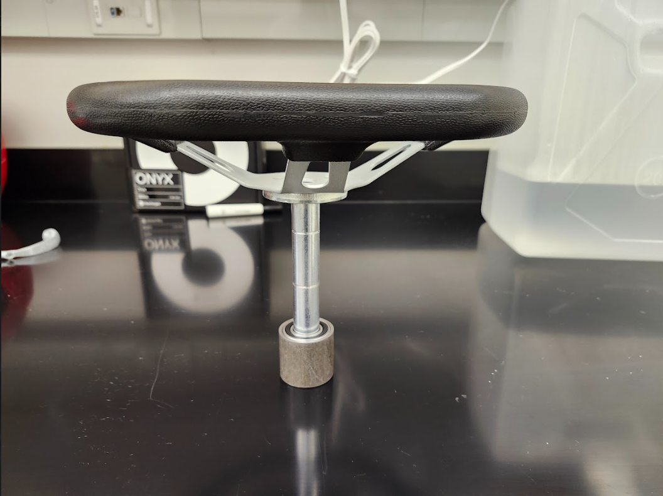
2025 E90 work/media/media/image25.png
