JeffreyLiang3449/HFCV-Website/2025 E90 work/media/media/image42.jpg

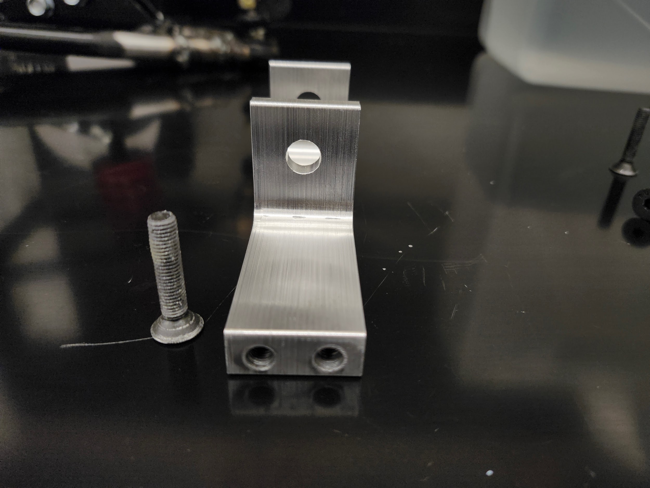
2025 E90 work/media/media/image42.jpg
