JeffreyLiang3449/HFCV-Website/2025 E90 work/media/media/image45.jpg

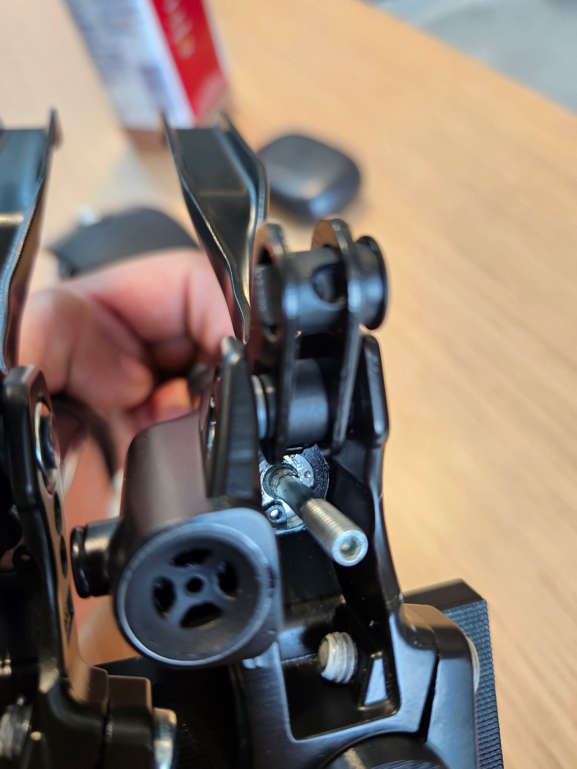
2025 E90 work/media/media/image45.jpg
