JeffreyLiang3449/HFCV-Website/2025 E90 work/Photos/20250502_114422.jpg

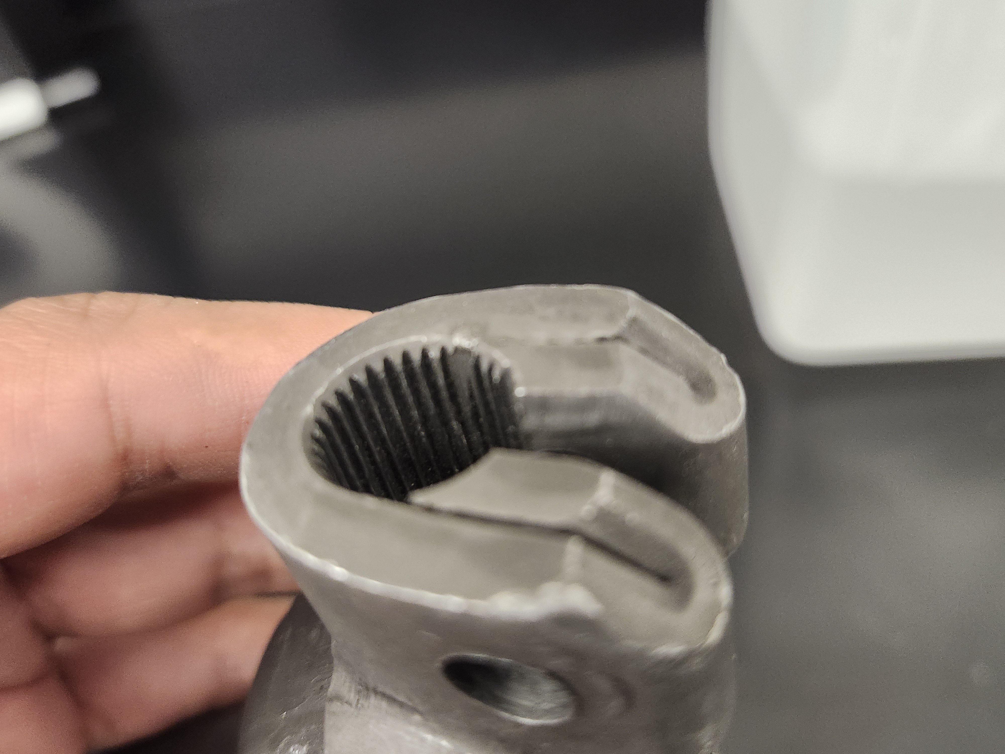
2025 E90 work/Photos/20250502_114422.jpg
