JeffreyLiang3449/HFCV-Website/2025 E90 work/Photos/20250504_131611.jpg

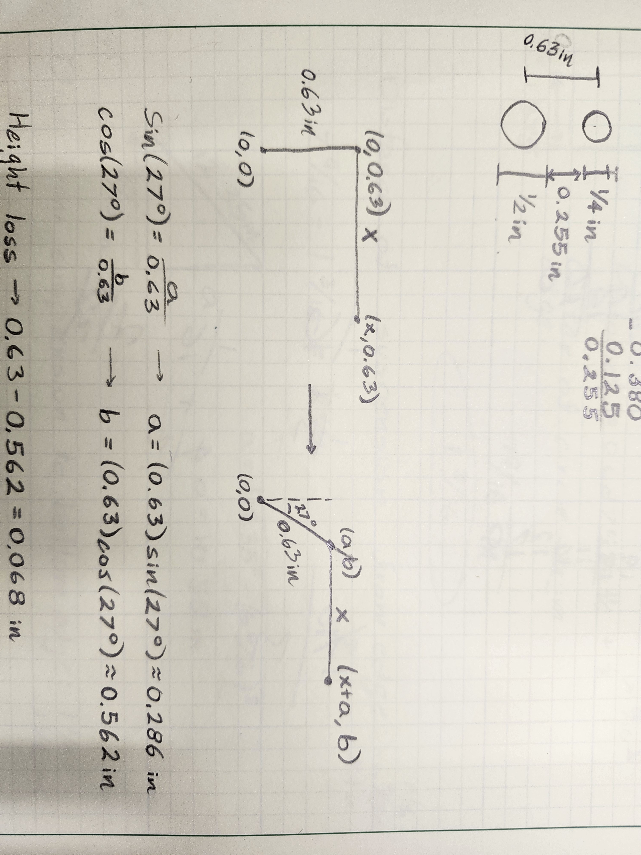
2025 E90 work/Photos/20250504_131611.jpg
