JeffreyLiang3449/HFCV-Website/2025 E90 work/Photos/20250513_150839.jpg

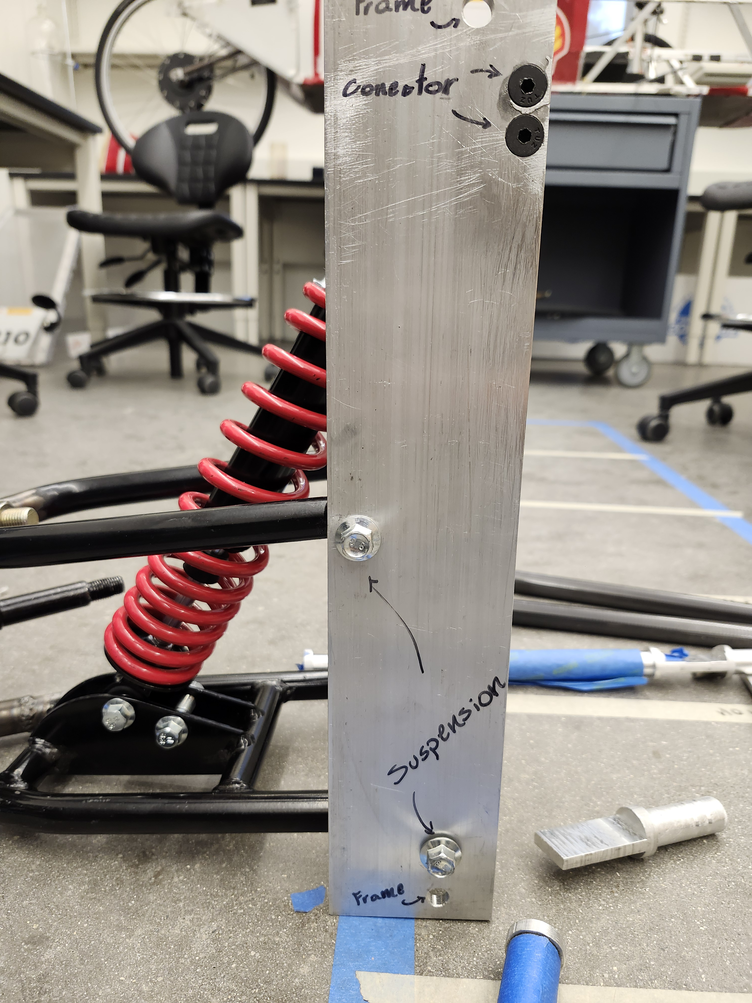
2025 E90 work/Photos/20250513_150839.jpg
