JeffreyLiang3449/HFCV-Website/2025 E90 work/Photos/20250513_150859.jpg

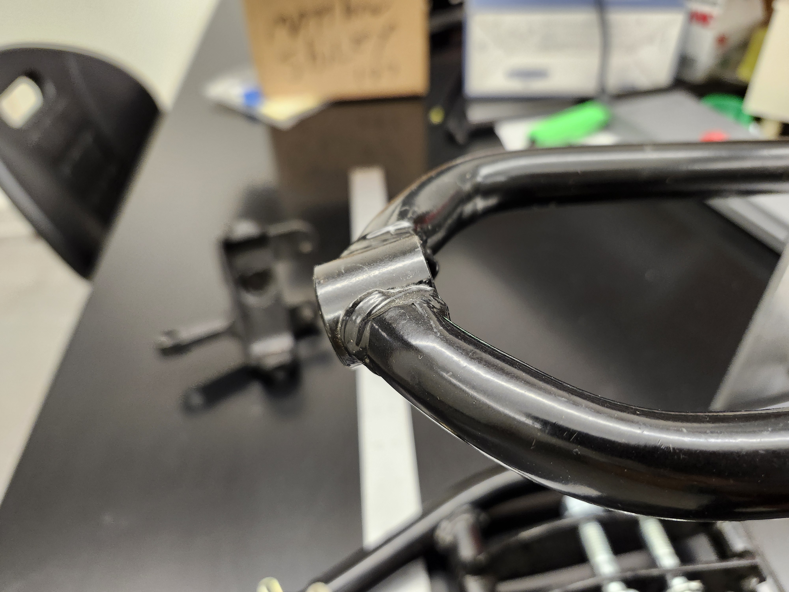
2025 E90 work/Photos/20250513_150859.jpg
