JeffreyLiang3449/HFCV-Website/2025 E90 work/Photos/IMG_9595.PNG

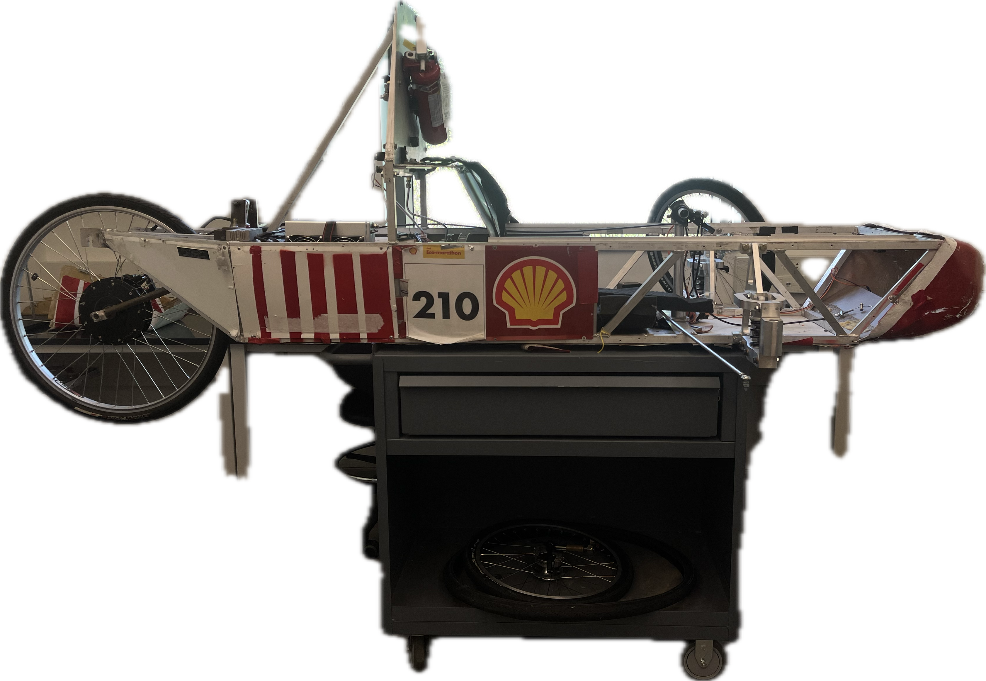
2025 E90 work/Photos/IMG_9595.PNG
