JeffreyLiang3449/HFCV-Website/2025 Summer Research/img/HFCV SummerPresentation_Jun255.png

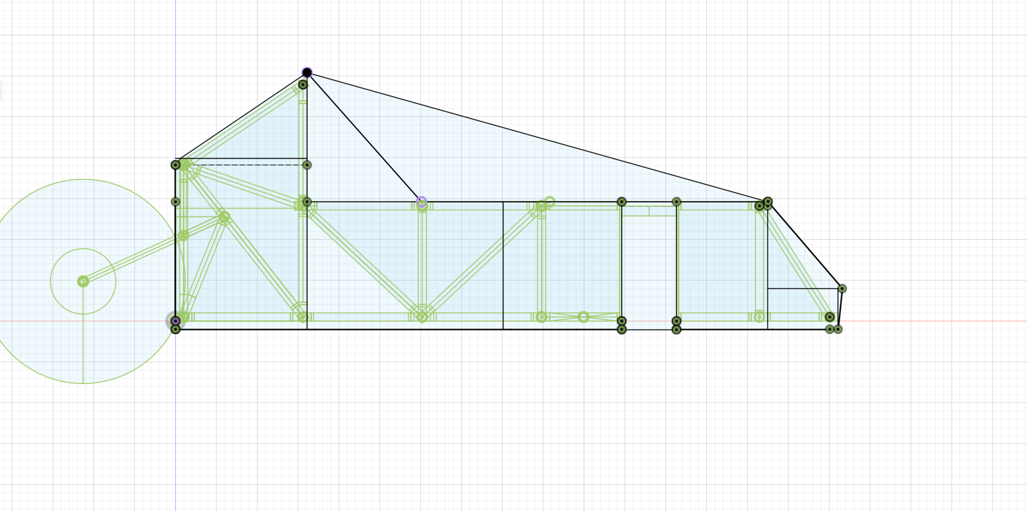
2025 Summer Research/img/HFCV SummerPresentation_Jun255.png
