JeffreyLiang3449/HFCV-Website/2026 E90 work/img/Mid-Semester Presentation1.png

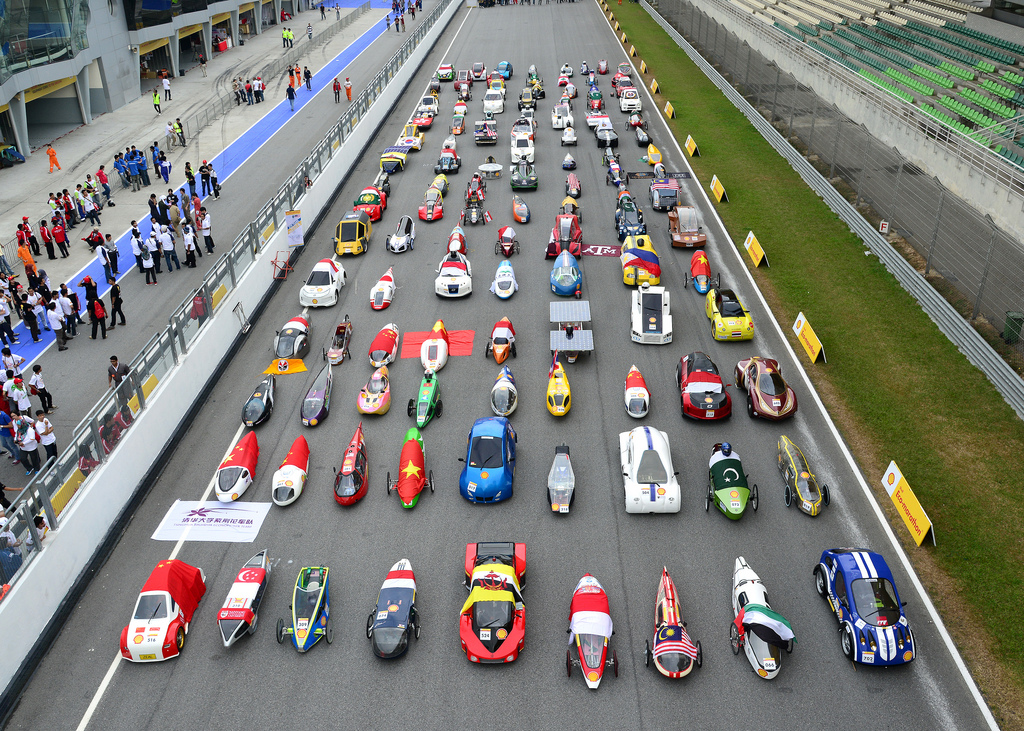
2026 E90 work/img/Mid-Semester Presentation1.png
