JeffreyLiang3449/HFCV-Website/2026 E90 work/img/Mid-Semester Presentation4.jpg

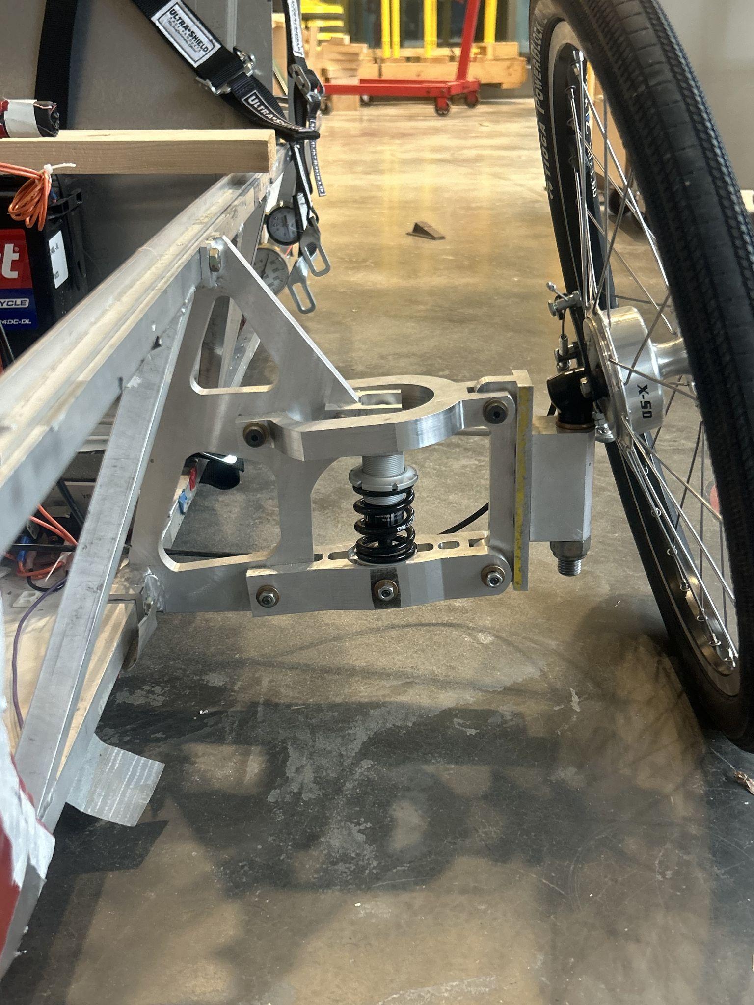
2026 E90 work/img/Mid-Semester Presentation4.jpg
