JeffreyLiang3449/HFCV-Website/docs/Literature/media/image2.png

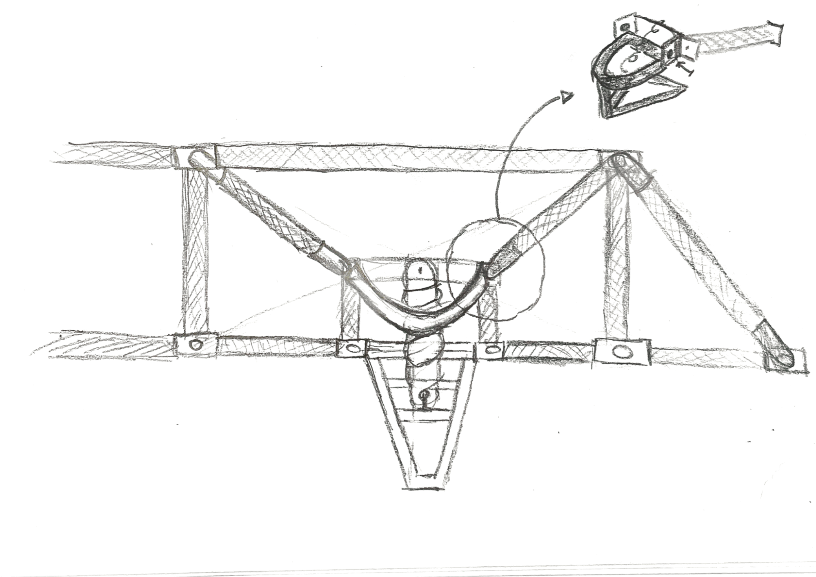
docs/Literature/media/image2.png
