JeffreyLiang3449/HFCV-Website/docs/Literature/media/media2/image3.jpg

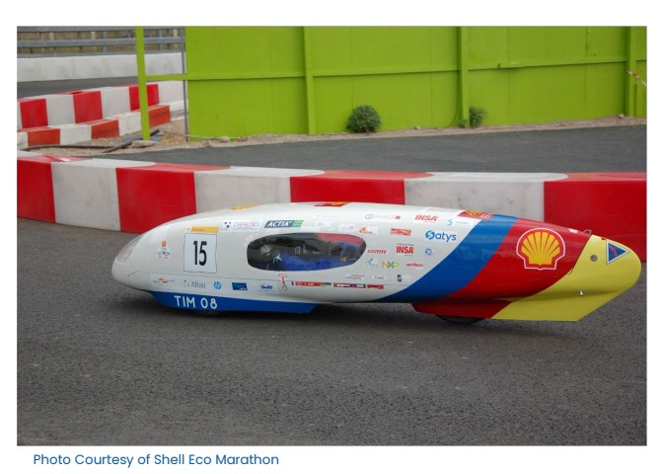
docs/Literature/media/media2/image3.jpg
