JeffreyLiang3449/HFCV-Website/Literature/media/media2/image4.jpg

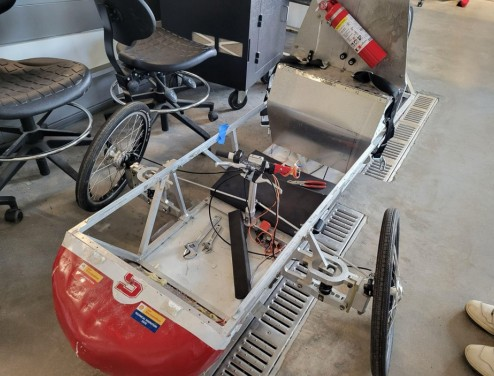
Literature/media/media2/image4.jpg
