JeffreyLiang3449/HFCV-Website/media/media/image4.png

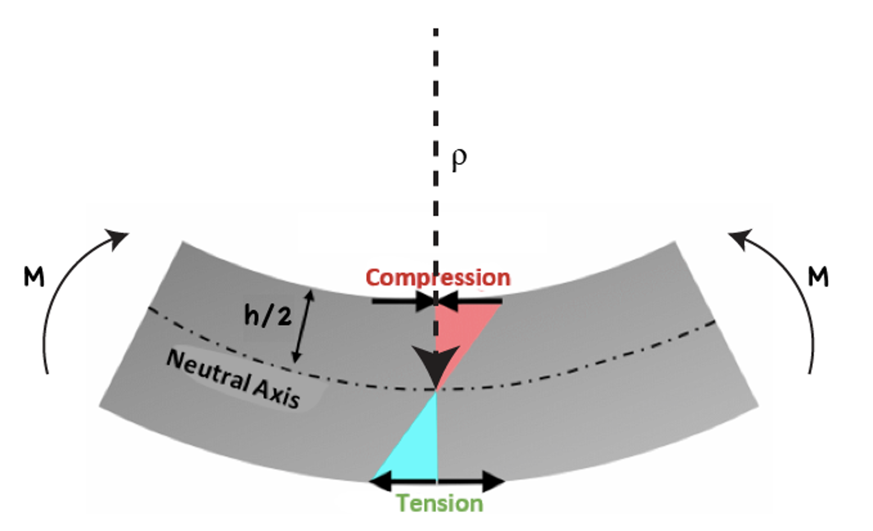
media/media/image4.png
