JeffreyLiang3449/HFCV-Website/HFCV PartsList.xlsx

Sheet: Items
Type | Manufacturer/Company ordered from | Item Name | Item Number | Link | Notes
Carbon Fibre Tubes | Goodwinds Composites | WCT .750" x 60" Wrapped Carbon Tube | WCT750060 | https://goodwinds.com/product/wct-750-x-60-wrapped-carbon-tube/
Aluminium Connectors | Swarthmore | 1 in Stock Round |  |  | If need more ask J to order
Suspension | Amazon | 2'' Front Suspension Shock Swing Arm Full Kit Upper Lower Steering Knuckle Spindle Kit For ATV Quad Bike Go Kart Buggy DIY Parts Front Suspension Swingarm Assembly 3 Holes Flange |  | https://www.amazon.com/gp/product/B0CH77CL6Y/ref=ox_sc_act_title_3?smid=AEJS3TTKF0L7A&th=1 | Not custom, so that in future if need be can replace
Suspension (new) | Amazon | Front Suspension Swingarm Assembly Upper & Lower Swing Arm Suspension Shock Kit For DIY Buggy Electric ATV Quad Bike Buggy Go Kart Parts 220mm |  | https://www.amazon.com/Front-Suspension-Swingarm-Assembly-Electric/dp/B0BL18TYFT?th=1 | Smaller and lighter than the previous kit
Steering Kit | Amazon | 270mm Steering Wheel Steel Kit Gear Rack Pinion Adjustable Shaft Set DIY Parts for Go Kart Go Cart Golf Cart ATV UTV 110cc 125cc 140cc 150cc Buggy Drift Trike Off Road Kart (440mm Gear Rack) |  | https://www.amazon.com/gp/product/B0CM9HDGXD/ref=ox_sc_act_title_1?smid=A3882WZCJFKWU8&th=1 | Not custom, so that in future if need be can replace
Wheels | Cycle Sport (Media) | Custom 20in Wheels fit for hydraulic disk brakes |  |  | Phone: 610-565-6023 or 610-565-9535
Bolts for Suspension | McMaster Carr | High-Strength Class 10.9 Steel Hex Head Screw M10 x 1.50 mm Thread, 140 mm Long | 90447A370 |  | So that we can attach the suspension through a one inch aluminium sqaure tube
Carbon Fibre Plates for floor | Dragon plate | DPL High Performance Twill 0/90 Lam. ~ 1/16" Satin |  | https://dragonplate.com/solid-carbon-fiber-sheets-plates#/pagesize=90&orderby=5
Carbon Fibre Plates for Cowl | Elevate | Carbon fiber sheet, plain weave, 1/16" thick | Sizes starting at 12130051 | https://www.elevatedmaterials.com/product-category/carbon-fiber-sheet/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
Polycarbonate
Screws for floor and cowl | McMaster Carr | Passivated 18-8 Stainless Steel Pan Head Phillips Screw | 91772A911
Taps for floor and cowl | McMaster Carr | Press-Fit Studs | 93580A721
Hardware for windshield (Hinge)
Hardware for windshield (Bracket)
Hardware for windshield (Latch)
Shoulder Screw | McMaster Carr | 1/2" Shoulder Diameter, 4 and 1/4" Shoulder length. For connecting pedal to pedal stand. | 91259A729 (https://www.mcmaster.com/91259A729)
Ball Joint Rod | McMaster Carr | M4 internally threaded shoulder screw. For directly connecting pedal to Shimano brakes. Need two. | 59935K14 (https://www.mcmaster.com/59935K14)
Screws | McMaster Carr | 6-32 Screws 1/2" long. For attaching all components of the pedal itself together. | 91263A516 (https://www.mcmaster.com/91263A516)
Screws | McMaster Carr | 1/4" Screws 1/2" long. For attaching the brake holder to the base of the pedal. | 91263A560 (https://www.mcmaster.com/91263A560)
Shoulder Screw for Ball Joint Rod | McMaster Carr | 12 mm long shoulder screw with 4mm shoulder diameter. For attaching the 4mm Ball joint to the pedal. Need two. | 92981A143 (https://www.mcmaster.com/92981A143)
 |  |  |  |  | For plastic to metal
Epoxy | McMaster Carr | Epoxy, 3M DP110, 1.64 FL. oz. Cartridge, Gray | 7467A23

Sheet: Cost
Item | Quatity | Price per unit | Shipping/Misc Fees | Total Cost
Carbon Fibre tubes | 17 | varies | 44.10+72.95 | 970.31
Suspension | 1 | 124.99 | approx 24.78 | 149.77
Steering | 1 | 135.99 | 8.16 | 144.15
Epoxy | 2 | 32.98 | 12.64 | 78.6
Bolts | 1 | 14.42 | 10.3 | 24.72
 |  |  |  |  | Final Cost | 1367.55
