JeffreyLiang3449/HFCV-Website/2024 E90 work/E90 Budget + Cost Analysis.xlsx

Sheet: Sheet1
Item | Project | Cost
Goodwinds - Carbon Fiber Tubing | Materials | $228.69
Amazon - Tips + Dispenser | Materials | 40.38
McMaster Carr - Metal Rods + Plates | Materials | $71.08
McMaster Carr - Epoxy + Gap Filler + Dispensing Gun | Materials | $74.35
Chassis Engineering - Chrome Moly Tubing | Materials | 77.48
Suspension and back brake | Materials | 140
 | TOTAL | $631.99
 | REMAINING | $168.01
Potential Buys | QTY | COST | TOTAL
Tube ends | 2 | 5 | 10
Eyes | 2 | 10 | 20
Bolts | 1 | 10 | 10
Nuts | 1 | 10 | 10
Wrapped CF | 1 | $61.36 | $61.36
Aluminum Rod - 3ft | 1 | 23.69 | 23.69
Top Bolt - Suspension (M8) | 1 | 5 | 5
~~Bottom Bolt - Suspension (M8)~~ | ~~1~~ | ~~5~~
Brake | 1 | 34.75 | 34.75
Rotor | 1 | 30 | 30
TOTAL |  |  | 204.8
WITHOUT E14 |  |  | $119.75

Sheet: Itemized Breakdown
Item | Purchased from | Subtotal | Additional Fees | Total | Total Volume (in^3) | Cost per in^3 | Surface Area | Volume of 6" | Cost of 6" member | Volume of 2" | Cost of 2" member | Weight of Each member
.5" x 60" Wrapped Carbon Tube | Goodwinds Composite | $37.68 | $11.97 | $49.66 | 19.43 | $2.56 | 0.3238333333 | 1.943 | $4.97 |  |  | 0.027202
.750" x 60" Wrapped Carbon Tube | Goodwinds Composite | $61.36 | $11.97 | $73.33 | 41.63 | $1.76 | 0.6938333333 | 4.163 | $7.33 |  |  | 0.058282
.5" x 48" Pultruded Carbon Tube | Goodwinds Composite | $35.75 | $11.97 | $47.73 | 13.54 | $3.52 | 0.2334482759 | 1.400689655 | $4.94 |  |  | 0.01960965517
.750" x 48" Pultruded Carbon Tube | Goodwinds Composite | $46.00 | $11.97 | $57.98 | 44.71 | $1.30 | 0.9124489796 | 5.474693878 | $7.10 |  |  | 0.07664571429
.750" x 24" Aluminium Rod | McMaster Carr | $12.28 | $2.26 | $14.54 | 43.09 | $0.34 | 1.795416667 |  |  | 3.590833333 | $1.21 | 0.3590833333
.500" x 24" Aluminium Rod | McMaster Carr | $4.10 | $2.26 | $6.36 | 19.69 | $0.32 | 0.8204166667 |  |  | 1.640833333 | $0.53 | 0.1640833333
Multipurpose 6061 Aluminum | McMaster Carr | $47.92 | $2.26 | $50.18
Toughened Epoxy | McMaster Carr | $49.28 | $2.26 | $51.54
Glass Resin FIller | McMaster Carr | $20.55 | $2.26 | $22.81
Dispensing Gun | McMaster Carr | $135.23 | $2.26 | $137.49 |  |  |  |  |  |  | Density of Pultruded CF | 0.015
Dispensing Gun | Amazon | $18.59 | $1.01 | $19.60 |  |  |  |  |  |  | Density of Wrapped CF | 0.014
Application Tips | Amazon | $21.79 | $1.01 | $22.80
M3 x 0.5 mm Thread, 40 mm Long | McMaster Carr | $3.95 |  | $3.95
Low-Strength, M3 x 0.5 mm Thread | McMaster Carr | $2.23 |  | $2.23
3/4" OD, .058" Chrome Moly | Chassis Engineering | $33.20 | $7.14 | $40.34
1/2" OD, .058" Chrome Moly | Chassis Engineering | $30.00 | $7.14 | $37.14

Sheet: Test Unit Costs
Tension Units |  |  |  |  | Density of AL (lb/in^3) | 0.1 |  |  | Density of Onyx (lb/in^3) | 0.043 |  |  |  | (1-5)
Sizing | Type | Subtotal | With Carbon Fiber Tube | With Epoxy/Resin | Total | Volume of Unit (cm^3) | 75% of max Tensile Load | Cost/lbf | V in (in^3) | Volume/Cost (in^3/$) (OF 6" MEMBERS) | Cost/Volume | Weight of Member (OF 6" MEMBERS) | Time Taken (hrs) | Effort Needed | Learning Curve Rating | TimexEffort Rating
SP | 3D prints | $3.38 | $4.94 | $5.41 | $13.72 | 14.24 |  |  | 0.868977488 | 0.06 | $15.79 | 0.05697568716 | 3.76 | 1 | 1.5 | 5.26
LP | 3D prints | $3.89 | $7.10 | $5.41 | $16.39 | 16.39 |  |  | 1.000178443 | 0.06 | $16.39 | 0.1196533873 | 4.63 | 1.5 | 1.5 | 8.445
SW | 3D prints | $3.64 | $4.97 | $5.41 | $14.01 | 15.31 | 167.175 | $0.08 | 0.934272847 | 0.07 | $15.00 | 0.06737573242 | 3.92 | 1 | 1.5 | 5.42
LW | 3D prints | $4.16 | $7.33 | $5.41 | $16.90 | 17.51 | 96.79 | $0.17 | 1.068524987 | 0.06 | $15.82 | 0.1042285744 | 4.8 | 1.5 | 1.5 | 8.7
SP | AL | $1.21 | $4.94 | $5.41 | $11.55 |  |  |  | 3.590833333 | 0.31 | $3.22 | 0.3786929885 | 2 | 4 | 3 | 11
LP | AL | $1.21 | $7.10 | $5.41 | $13.72 |  | 316.75 | $0.04 | 3.590833333 | 0.26 | $3.82 | 0.4357290476 | 2 | 3 | 3 | 9
SW | AL | $1.21 | $4.97 | $5.41 | $11.58 |  | 420.87 | $0.03 | 3.590833333 | 0.31 | $3.23 | 0.3862853333 | 2 | 4 | 3 | 11
LW | AL | $1.21 | $7.33 | $5.41 | $13.95 |  | 447.27 | $0.03 | 3.590833333 | 0.26 | $3.89 | 0.4173653333 | 2 | 3 | 3 | 9
Compression
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
SP | AL | 0.3786929885 | 60.59087816 | 107.5908782 | 25.29102184 | 19.03%
LP | AL | 0.4357290476 | 69.71664762 | 116.7166476 | 16.16525238 | 12.17%
SW | AL | 0.3862853333 | 61.80565333 | 108.8056533 | 24.07624667 | 18.12%
LW | AL | 0.4173653333 | 66.77845333 | 113.7784533 | 19.10344667 | 14.38%
