JeffreyLiang3449/HFCV-Website/2024 E90 work/E90 Calc Excel NEW.xlsx

Sheet: Material Deflection
Material (rods) | Modulus (GPa) | Density (grams/cm^3) | Thickness | OD (inches) | I (in^4) | Pressure (Psi) | Displacement (inches) | Weight(per member) | Total W of Chassis (lbs) | Total Weight | Difference in weight(lbs) | Reduction | Weight with Driver (lbs)
Chrome Moly (4130) | 210 | 7.85 | 0.03 | 0.75 | 0.03741913665 | 30457924.98 | 0.02632250271 | 2.354487269 | 37.67179631 | 84.7 | 48.2 | 36.28041418% | 194.9
Aluminum (6061) | 69 | 2.7 | 0.1 | 0.75 | 0.1082515 | 10007603.92 | 0.02769218493 | 2.57086872 | 41.13389952 | 88.1 | 44.7 | 33.67501554% | 198.4
Wrapped CF | 260 | 0.388289 | 0.2 | 0.625 | 0.0941705625 | 37709811.88 | 0.008447957577 | 0.5545778025 | 8.873244839 | 55.9 | 77.0 | 57.95270474% | 166.1
S. Steel (304) | 193 | 7.93 | 0.03 | 0.75 | 0.03741913665 | 27992283.43 | 0.02864106512 | 2.378482044 | 38.05571271 | 85.1 | 47.8 | 35.99149869% | 195.3
CURRENT (Square Aluminum) | 193 | 7.93 | 0.125 | 0.75 | 0.03515625 | 27992283.43 | 0.03048459177 | 5.36761875 | 85.8819 | 132.9 |  |  | 243.1
Current Total (lbs) | 131.9
Fuel Cell | 7.5
Tires | 7 |  |  |  |  |  |  |  |  |  | Chrome Moly (4130) | 194.9217963
Electronics | 2.5 |  |  |  |  |  |  |  |  |  | Aluminum (6061) | 198.3838995
Suspension | 25 |  |  |  |  |  |  |  |  |  | Wrapped CF | 166.1232448
Safety+Etc | 5 |  |  |  |  |  |  |  |  |  | S. Steel (304) | 195.3057127
Rest of Vehicle (lbs) | 47 |  |  |  |  |  |  |  |  |  | CURRENT (Square Aluminum) | 243.1319
Member Length (in) | 60
Load (lbs) | 400
Estimate Chassis Tubing (ft) | 80
Estimated Length
Min Weight (Driver) | 110.25
Max Weight (Car) | 308.7
NO MIN WEIGHT
Suspension Weight Calculations | Chrome Moly | Weight (lbs)
Conservative Amt of Material (ft) | 20 | 9.417949078
Aggressive Amt of Material (ft) | 15 | 7.063461808
Component of the Current Vehicle | Estimated Weight (lbs) | Percentage of Total Weight |  |  |  | Test Trial | Max Velocity (m/s) | Max Acceleration (m/s^2) | Power Exerted
Fuel Cell | 7.2 | 5.46% |  |  |  | 1 | 6.25 | 1.28 | 408.4312005
Tires | 6.8 | 5.16% |  |  |  | 2 | 6.62 | 4.04 | 1103.399375
Electronics | 1.5 | 1.14% |  |  |  | 3 | 6.75 | 3 | 867.3426618
Suspension | 25.2 | 19.11% |  |  |  | 5 | 6.5 | 6.2 | 1598.847531
Safety+Etc | 2.3 | 1.74% |  |  |  | Average | 6.53 | 3.63 | 994.505192
Non-Chassis Systems | 43 | 32.60% |  |  |  |  |  |  | 0.55%
Chassis | 88.9 | 67.40% |  |  |  | Test Trial | Max Velocity (m/s) | Max Acceleration (m/s^2) | Estimated Power Rating (J/s)
Total Vehicle Weight | 131.9 |  |  |  |  | 1 | 9.205 | 0 | 168.9712
 |  |  |  |  |  | 2 | 10.6 | 0.1 | 233.4941515
 |  |  |  |  |  | 3 | 8.9 | 4.1 | 1503.026818
 |  |  |  |  |  | Average | 9.568333333 | 1.4 | 635.1640565
 |  |  |  |  |  |  |  |  | 36.48%

Sheet: Cost Analysis
 | Cost of Single Joint Members | Aluminum | Cost of Epoxy | Collar Material Cost | Cost of Glass Resin | Cost of Welding * | *Referencing Tension Tests | Cost vs Tensile Strength
 |  | SW
 |  | LP
 |  | LW
 |  | 3D printed | Cost of Epoxy | Cost of Print Material | Cost of Glass Resin
 |  | SW
 |  | LP
 |  | LW
 |  | SP
*Referencing Comp Tests | Cost vs Compressive Strength |  |  |  |  |  |  | Cost Vs Time of Production
 | Cost Vs Effort

Sheet: Spring Calculations
Control Panel (front) |  | Control Panel (back)
Total Current Weight (lbs) | 243.1 | Total Current Weight (lbs) | 243.1
Total Current Carbon Weight (lbs) | 166.1 | Total Current Carbon Weight (lbs) | 166.1
% weight carried by front | 0.6 | % weight carried by back | 0.4
Unsprung weight of front (lbs) | 16 | Unsprung weight of back (lbs) | 16
Distance from chassis to spring (in) |  | Distance from chassis to spring (in)
Distnace from chassis to center of wheel (in) |  | Distnace from chassis to center of wheel (in)
Spring Angle |  | Spring Angle
Chosen Natural Frequencies (Hz) |  | Chosen Natural Frequencies (Hz)
Current |  | Current
Corner Weights (lbs) | 72.93957 | Corner Weight (just back wheel) (lbs) | 97.25276
Individual Corner Sprung Weight (lbs) | 36.469785 | Individual Corner Sprung Weight (lbs) | 97.25276
Motion Ratio of Front | #DIV/0! | Motion Ratio of Back | #DIV/0!
Front Wheel Spring Rate (N/mm) | #NAME? | Back Wheel Spring Rate (N/mm) | #NAME?
Effective Spring Rate Needed (N/mm) | #NAME? | Effective Spring Rate Needed (N/mm) | #NAME?
Carbon |  | Carbon
Corner Weights (lbs) | 49.83697345 | Corner Weight (just back wheel) (lbs) | 33.22464897
Individual Corner Sprung Weight (lbs) | 24.91848673 | Individual Corner Sprung Weight (lbs) | 33.22464897
Motion Ratio of Front | #DIV/0! | Motion Ratio of Back | #DIV/0!
Front Wheel Spring Rate (N/mm) | #NAME? | Back Wheel Spring Rate (N/mm) | #NAME?
Effective Spring Rate Needed (N/mm) | #NAME? | Effective Spring Rate Needed (N/mm) | #NAME?

Sheet: Fuel Model (v2)
MODEL 2
 | Control Panel |  |  | Fuel Efficiency Calculations | CF | Current
 | % of hydrogen leaked | 0 |  | Required energy from fuel cell (kJ) | 1856.398206 | 2465.746716
 | Fuel Cell Thermo-Efficiency | 35% |  | Hydrogen Needed (m^3) | 0.1848019875 | 0.2454618263
 | Distance Traveled (m) | 15330 |  | Gasoline Equivalency (kJ/m^3 of gas) | 32801340 | 32801340
 | Average Speed (kph) | 30 |  | Amount of equivalent unlead. Gas consumed (m^3) | 5.659519416e-05 | 7.517213371e-05 |  |  |  | 0.01547901448
 | Density of hydrogen (kg/m^3) | 0.0838 |  | Fuel Efficiency (mi/m^3) (IN GASOLINE) | 168311.4189 | 126717.4012
 | Asphalt Kinetic Friction Coefficient | 0.5000 |  | Fuel Efficiency (MPGe) | 637.1281546 | 479.677639
 | Estimated Drag Coefficient | 0.6500 |  | Fuel Efficiency (km/m^3) (H2) | 82.95365328 | 62.45370302 | 12.36062126
 | Esimtated Frontal Area (m^2) | 0.5000 |  | Fuel Efficiency (mi/m^3) (of H2) | 51.54499449 | 38.8069199
 | Density of Unlead. Gas (kg/L) | 0.765
 | Net Caloric Value (H2) (kJ/kg) | 119930 |  |  |  |  |  | BASE | 479.677639
 | Maximum power of HFC (J/s, W) | 1000 |  | Increased Efficiency (mi/m^3) (H2) | 12.73807459 |  |  | 1 | 637.1281546 | 157.4505156
 | Density of air (kg/m^3) | 1.294 |  | Increased Efficiency (mpge) | 157.4505156 |  |  | 1+2 | 697.2463826 | 217.5687436
 | Net Caloric Value (Unlead. Gas) (kJ/kg) | 42900 |  |  |  |  |  | 1+2+3 | 896.4596347 | 416.7819957
 | Total Mass of Wrapped CF (lbs) | 162.0879333 |  |  |  |  |  | 2 | 512.9958882 | 33.3182492
 | Total Mass of Current (lbs) | 243.13 |  |  |  |  |  | 3 | 616.728393 | 137.050754
 |  |  |  |  |  |  |  | 2+3 | 659.566142 | 179.888503
 | Energy Used Calculations | CF | Current |  |  |  | Increased fuel efficiency | 1+3 | 819.1647702 | 339.4871312
 | Mass (kg) | 73.52 | 110.28 |  | Chrome Moly (4130) | 194.9217963 | 82.7
 | KE at avg vel. (J) | 2552.84 | 3829.26 |  | Aluminum (6061) | 198.3838995 | 75.8
 | Time taken until avg kph (secs) | 2.55 | 3.83 |  | Wrapped CF | 166.1232448 | 147.2
 | Acceleration of vehicle (m/s^2) | 1.63 | 1.09 |  | S. Steel (304) | 195.3057127 | 81.9
 | Distance accelerated(m) | 5.32 | 7.98 |  | CURRENT (Square Aluminum) | 243.1319
 | Distance at avg vel (m) | 15324.68 | 15322.02
 | Drag Force Losses (J/s) | 121.69 | 121.69 |  |  | Fuel Efficiency Increase (MPGe)
 | Friction losses (J/s) | 229.76 | 344.63 | Chassis Weight Reduction 33% | (1) | 157.45 | 32.8%
 | Time to complete track (sec) | 1841.51 | 1842.47 | Frontal Area Reduced by 25% | (2) | 33.32 | 6.9%
 | Total Frictional energy lost (J) | 647186.53 | 859182.09 | Thermal Efficiency Increased by 10% | (3) | 137.05 | 28.6%
 | Total energy used(J) | 649739.37 | 863011.35 |  | (1) + (2) | 217.57 | 45.4%
 |  |  |  |  | (2) + (3) | 179.89 | 37.5%
 |  |  |  |  | (1) + (3) | 339.49 | 70.8%
 |  |  |  |  | (1) + (2) + (3) | 416.78 | 86.9%
 |  |  |  |  | W/o synergy | Synergy increases |  |  | (1) | 157.5
 |  |  |  | (1) + (2) | 190.77 | 26.80 |  |  | (2) | 33.3
 |  |  |  | (1) + (3) | 294.50 | 44.99 |  |  | (1)+(2) Synergy | 26.8
 |  |  |  | (2) + (3) | 170.37 | 9.52 |  |  | (3) | 137.1
 |  |  |  | (1) + (2) + (3) | 327.82 | 88.96 |  |  | (1) + (3) Synergy | 45.0
 |  |  |  |  |  |  |  |  | (2) + (3) Synergy | 9.5
 |  |  |  |  |  |  |  |  | All Synergy | 7.66

Sheet: COST ANALYSIS AND EFFICIENCY AN
Tension Units |  |  |  |  | Density of AL (lb/in^3) | 0.1 |  |  | Density of Onyx (lb/in^3) | 0.043 |  |  |  | (1-5)
Sizing | Type | Subtotal | With Carbon Fiber Tube | With Epoxy/Resin | Total | Volume of Unit (cm^3) | 75% of max Tensile Load | Cost/lbf | V in (in^3) | Volume/Cost (in^3/$) (OF 6" MEMBERS) | Cost/Volume | Weight of Member (OF 6" MEMBERS) | Time Taken (hrs) | Effort Needed | Learning Curve Rating | TimexEffort Rating
SP | 3D prints | $3.38 | $4.94 | $5.41 | $13.72 | 14.24 |  |  | 0.868977488 | 0.06 | $15.79 | 0.05697568716 | 3.76 | 1 | 1.5 | 5.26
LP | 3D prints | $3.89 | $7.10 | $5.41 | $16.39 | 16.39 |  |  | 1.000178443 | 0.06 | $16.39 | 0.1196533873 | 4.63 | 1.5 | 1.5 | 8.445
SW | 3D prints | $3.64 | $4.97 | $5.41 | $14.01 | 15.31 | 167.175 | $0.08 | 0.934272847 | 0.07 | $15.00 | 0.06737573242 | 3.92 | 1 | 1.5 | 5.42
LW | 3D prints | $4.16 | $7.33 | $5.41 | $16.90 | 17.51 | 96.79 | $0.17 | 1.068524987 | 0.06 | $15.82 | 0.1042285744 | 4.8 | 1.5 | 1.5 | 8.7
SP | AL | $1.21 | $4.94 | $5.41 | $11.55 |  |  |  | 3.590833333 | 0.31 | $3.22 | 0.3786929885 | 2 | 4 | 3 | 11
LP | AL | $1.21 | $7.10 | $5.41 | $13.72 |  | 316.75 | $0.04 | 3.590833333 | 0.26 | $3.82 | 0.4357290476 | 2 | 3 | 3 | 9
SW | AL | $1.21 | $4.97 | $5.41 | $11.58 |  | 420.87 | $0.03 | 3.590833333 | 0.31 | $3.23 | 0.3862853333 | 2 | 4 | 3 | 11
LW | AL | $1.21 | $7.33 | $5.41 | $13.95 |  | 447.27 | $0.03 | 3.590833333 | 0.26 | $3.89 | 0.4173653333 | 2 | 3 | 3 | 9
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
 |  |  |  |  |  |  | LW | AL | 769.0448327 | 47.35445944 | 2.478843754 | $47.14
 | CF Type | Connection Type | Chassis + Driver Weight (lbs) | Current Wt Reduction % | Cost/lb saved ($)
 | SP | 3D collar | 170.5 | 29.9% | $35.32
 | LP | 3D collar | 183.6 | 24.5% | $54.99
 | SW | 3D collar | 168.3 | 30.8% | $30.20
 | LW | 3D collar | 182.5 | 24.9% | $57.39
 | SP | AL inserts | 217.8 | 10.4% | $73.10
 | LP | AL inserts | 227.0 | 6.6% | $135.76
 | SW | AL inserts | 219.1 | 9.9% | $76.98
 | LW | AL inserts | 224.0 | 7.9% | $116.85
 | CF Type | Connection Type | Proj. Mi/M^3 Increases | Proj MPGe Increases | Cost/MPGe Gained ($)
 | SP | 3D collar | 17.8 | 220.6 | $11.64
 | LP | 3D collar | 13.9 | 171.3 | $19.11
 | SW | 3D collar | 18.6 | 229.4 | $9.86
 | LW | 3D collar | 14.2 | 175.2 | $19.86
 | SP | AL inserts | 5.2 | 64.0 | $28.86
 | LP | AL inserts | 3.2 | 39.7 | $55.32
 | SW | AL inserts | 4.9 | 60.7 | $30.52
 | LW | AL inserts | 3.8 | 47.4 | $47.14

Sheet: Copy of Itemized Breakdown
Item | Purchased from | Subtotal | Additional Fees | Total | Total Volume (in^3) | Cost per in^3 | Surface Area | Volume of 6" | Cost of 6" member | Volume of 2" | Cost of 2" member | Weight of Each member
.5" x 60" Wrapped Carbon Tube | Goodwinds Composite | $37.68 | $11.97 | $49.66 | 19.43 | $2.56 | 0.3238333333 | 1.943 | $4.97 |  |  | 0.027202
.750" x 60" Wrapped Carbon Tube | Goodwinds Composite | $61.36 | $11.97 | $73.33 | 41.63 | $1.76 | 0.6938333333 | 4.163 | $7.33 |  |  | 0.058282
.5" x 48" Pultruded Carbon Tube | Goodwinds Composite | $35.75 | $11.97 | $47.73 | 13.54 | $3.52 | 0.2334482759 | 1.400689655 | $4.94 |  |  | 0.01960965517
.750" x 48" Pultruded Carbon Tube | Goodwinds Composite | $46.00 | $11.97 | $57.98 | 44.71 | $1.30 | 0.9124489796 | 5.474693878 | $7.10 |  |  | 0.07664571429
.750" x 24" Aluminium Rod | McMaster Carr | $12.28 | $2.26 | $14.54 | 43.09 | $0.34 | 1.795416667 |  |  | 3.590833333 | $1.21 | 0.3590833333
.500" x 24" Aluminium Rod | McMaster Carr | $4.10 | $2.26 | $6.36 | 19.69 | $0.32 | 0.8204166667 |  |  | 1.640833333 | $0.53 | 0.1640833333
Multipurpose 6061 Aluminum | McMaster Carr | $47.92 | $2.26 | $50.18
Toughened Epoxy | McMaster Carr | $49.28 | $2.26 | $51.54
Glass Resin FIller | McMaster Carr | $20.55 | $2.26 | $22.81
Dispensing Gun | McMaster Carr | $135.23 | $2.26 | $137.49 |  |  |  |  |  |  | Density of Pultruded CF | 0.015
Dispensing Gun | Amazon | $18.59 | $1.01 | $19.60 |  |  |  |  |  |  | Density of Wrapped CF | 0.014
Application Tips | Amazon | $21.79 | $1.01 | $22.80

Sheet: Fuel Efficiency (v1)
MODEL 1 | Control Panel |  | Fuel Efficiency Calculations (total energy expended)
 | Amount of hydrogen used (m^3) | 0.001 | Energy from H2 (kJ) | 10.05
 | % hydrogen leaked | 0% | Gasoline Conversion (kJ/m^3 of gas) | 32801340.00
 | Fuel Cell Thermo-efficiency | 15% | Amount of equivalent unlead. Gas consumed (m^3) | 3.06247757e-07
 | Time (min) | 30 | Fuel Efficiency of CF (km/m^3 of gasoline) | 1175331.83
 | Density of hydrogen (kg/m^3) | 0.0838 | Fuel Efficiency of Current (km/m^3 of gasoline) | 971166.22
IN KG/L | Density of Unlead. Gas (kg/L) | 0.765 | Increased Effiency (km/m^3): | 204165.61
 | Net Caloric Value (H2) (kJ/kg) | 119930
 | Net Caloric Value (Unlead. Gas) (kJ/kg) | 42900 | CF in MPG | 2762.03
 | Total Mass of Wrapped CF (lbs) | 166 | Current in MPG | 2282.24 | 603767.3601
 | Total Mass of Current (lbs) | 243.1319 | Increased Effiency (in MPG): | 479.79
 | Distance Traveled Calculations
 | Hydrogen Into Fuel Cell (m^3) | 0.001
 | Potential Energy into Fuel Cell (kJ) | 0.0100453368
 | Converted Energy to Electrical (kJ) | 0.00150680052
 | Time Ran (seconds) | 1800
 | Weight Conversion (CF) (kg) | 75.364
 | Weight Conversion (Alum) (kg) | 110.3818826
 | Distance by CF (km) | 0.3599427357
 | Distance by Current (km) | 0.297417477
