JeffreyLiang3449/HFCV-Website/Chassis/Drawings/Parts Implementation Drawing ROUGH.qmd

---
title: Parts Implementation Drawing ROUGH
resources:
  - "Parts Implementation Drawing ROUGH.pdf"
---

{{< pdf "Parts Implementation Drawing ROUGH.pdf" width="100%" height=700 >}}
