JeffreyLiang3449/HFCV-Website/2024 E90 work/Presentation materials (old)/E90 Mid-Semester Reivew.pptx

## Hydrogen Car Renewal

Justin Chai and Ben Horvat
Advisor: Prof. Everbach
Swarthmore College E90
Spring 2024


Notes: JC add advisor

## Presentation Outline 01 02 04 03 05 06

Shell Eco-Marathon/ Previous Projects

Existing Conditions/ Motivation

Relevant Theory

Progress

Struggles

Future Plans

Notes: JC
Shell and existing -> 2 minutes each
Relevant theory and progress -> ~3 mins each
Struggles and future plan-> ~1 min each

## Shell Eco-Marathon


- Worldwide Engineering Competition for Energy Efficiency and Low Carbon Transportation Solutions!
  - NA: Indianapolis Motor Speedway
  - Like the less fast innovation F1
- Multiple Categories: Prototype and Urban
- Different Powertrain Systems: Hydrogen, Combustion, Battery EVs

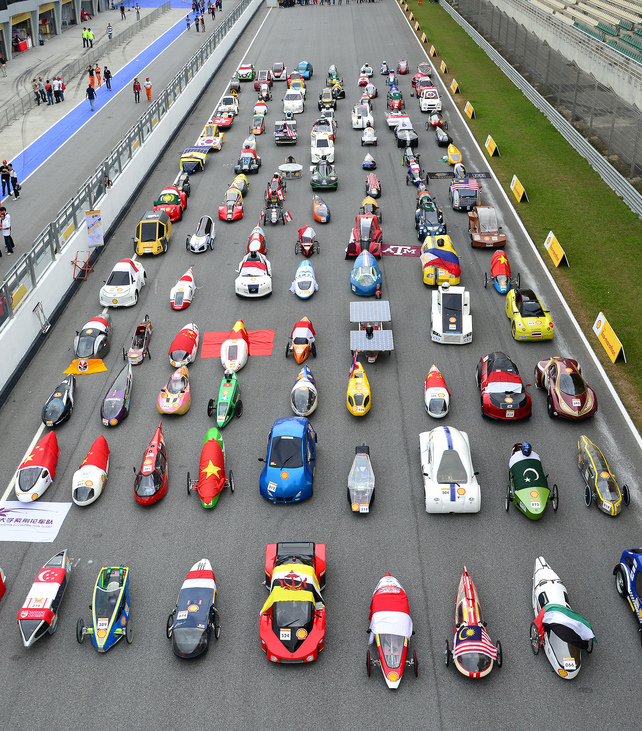
[picture p255: figure]

Notes: JC: What is the shell eco marathon(specifically for hydrogen fuel cell!) Motivation and cool opportunities
Pedagogical benefits of the shell eco marathon ADD WAY MORE REASONS FOR THE INTERDISCIPLINARY NATURE OF THE PROJECT

## Technical Inspections

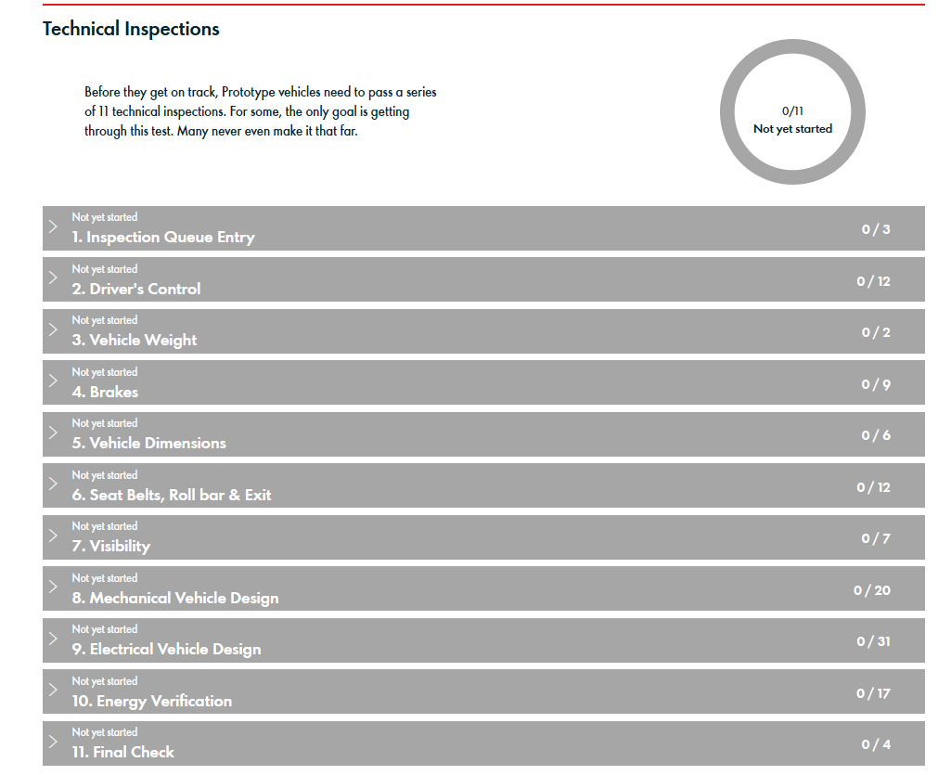
[picture p256: figure]

BEFORE RACING, need to pass the 11 rounds of testing -> lots of design constraints:
- Turning radius
- Dimensions of car
- Hydrogen FC integration
- Braking tests at different intensity
- Safety/Visibility of driver

Notes: JC: What is the shell eco marathon(specifically for hydrogen fuel cell!) Motivation and cool opportunities
JUMP INTO HOW THE INTERDISCPLINARY ASPECTS

## Prior Vehicles and Past Troubles


2015 Competition Team

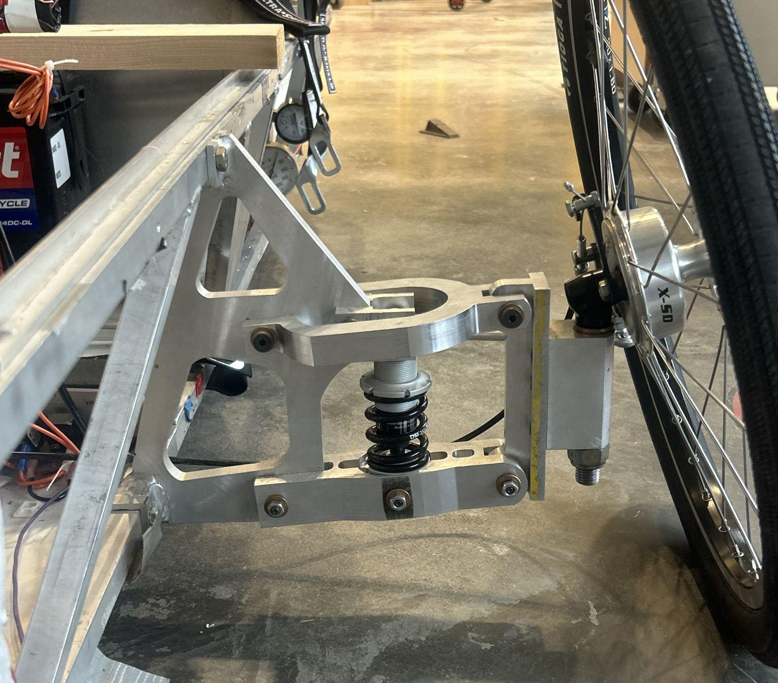
[picture p257: figure]

Current Status

2018 Front Suspension

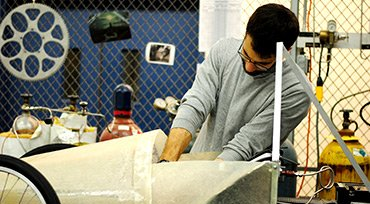
[picture p258: figure]

2012 - Original Chassis Construction

Notes: BH -> i’ll add pics if needed (by sunday/monday)

## Motivations for an Overhaul

Outdated Chassis Model | Current chassis was made in ‘13 No aerodynamic considerations New size requirements
Hydraulic Brakes | Hydraulic disk-pad brakes are standardized and required
Outdated Materials | Aluminum chassis adds unnecessary weight and is restricting performance
New front and rear suspension | Front suspension is hefty and complicates steering No rear suspension system
Steering and Driver Safety Systems | Steering columns need to be redesigned for turning radius requirements Safety electronics need an update
Fuel Cell Woes | Current FC is inconsistent and needs to be assessed for further use

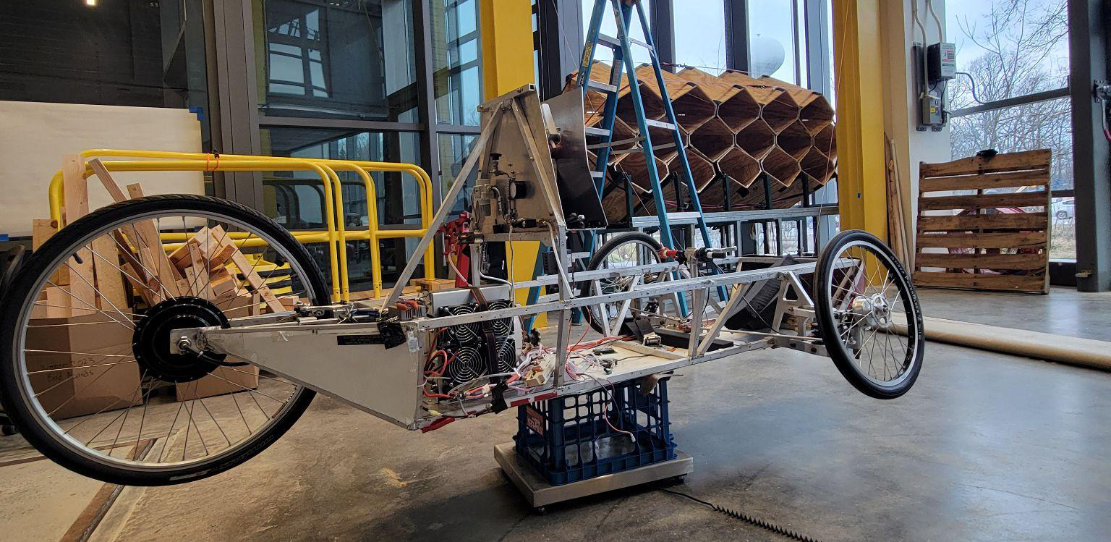
[picture p259: figure]
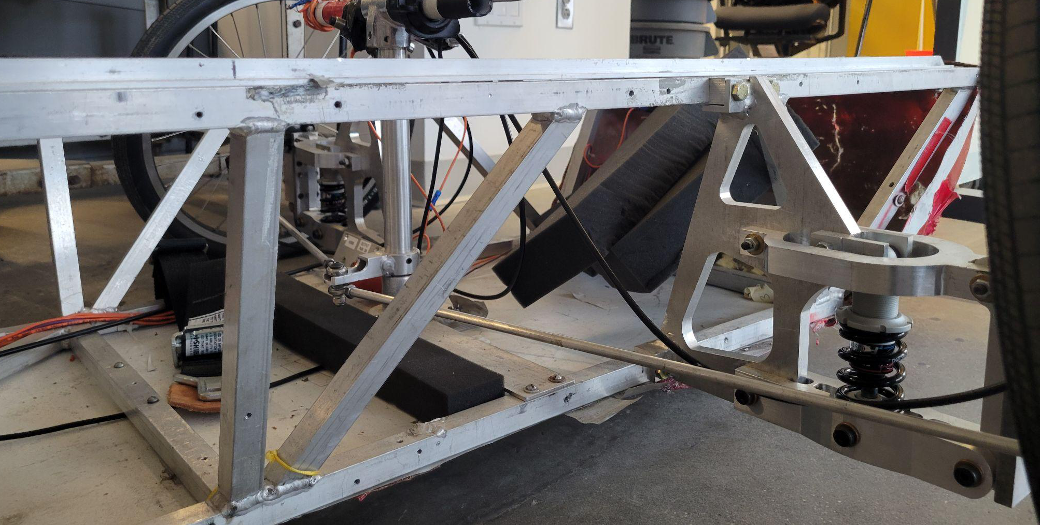
[picture p260: figure]
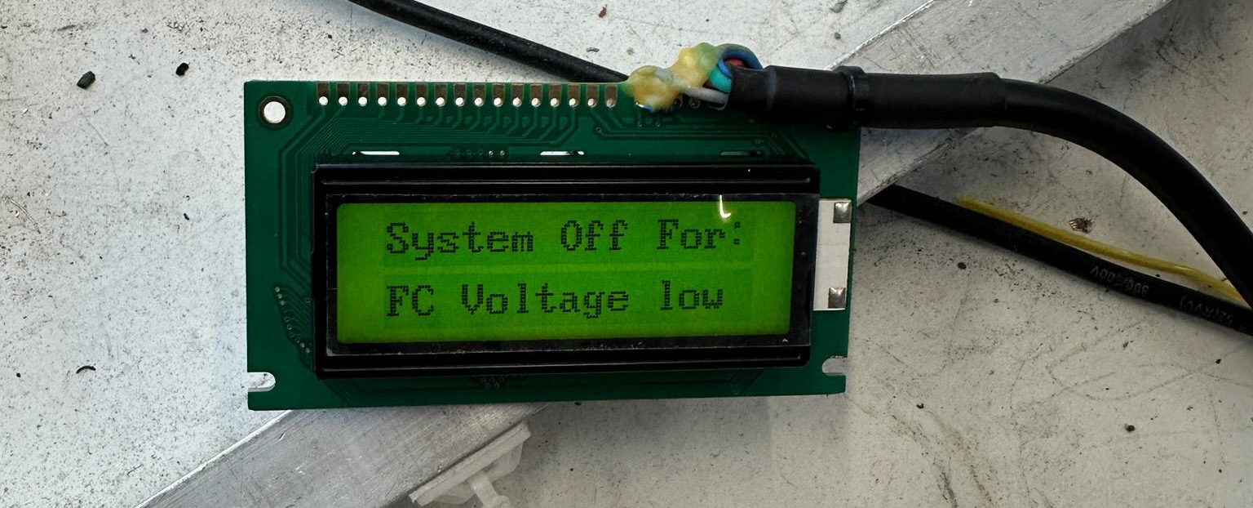
[picture p261: figure]

Notes: BH-> Ben will probably mention a bunch of stuff concerning the problems with the old car -> this is to connect the new design constraints, the trends for redesigns of the vehicles, and parts of the old car that needed to be rebuilt
-> ALSO ADD Motivations for learning how to design a vehicle, 3D printing + machining, how to design for energy efficiency -> where the world is going sustainability wise

## Main Goals: How do we get more efficient? 01

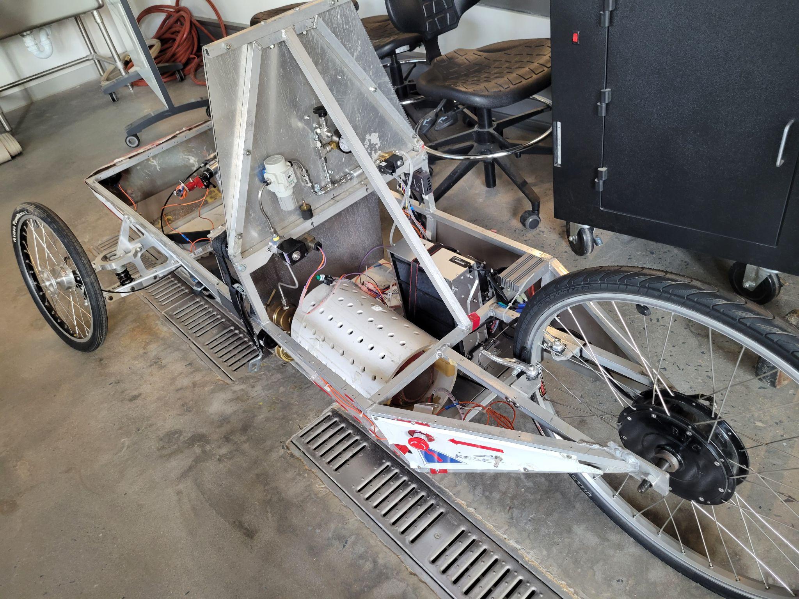
[picture p262: figure]

FROM CURRENT


Work cut out for us?

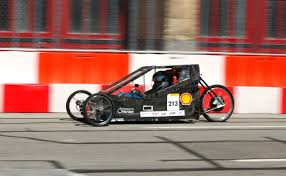
[picture p263: figure]
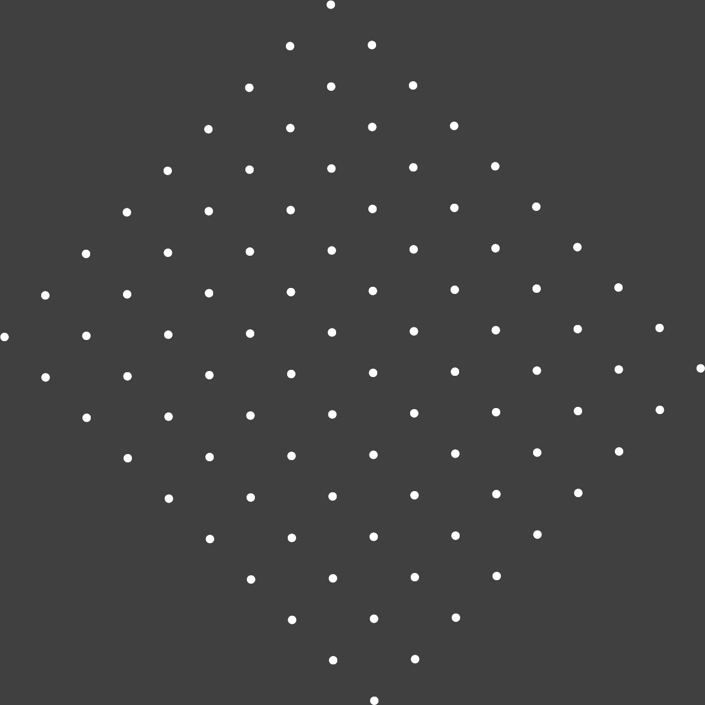
[picture p264: figure]

To New Standard

Notes: -> speaking JC

## Fuel Cell Renewal & Feasibility Assessment

How does a HFCV work?

- H2 gas moves along a membrane where it merges with O2 gas to make water and electricity
- An electric motor powers the vehicle -> 0 emission kinematic propulsion!

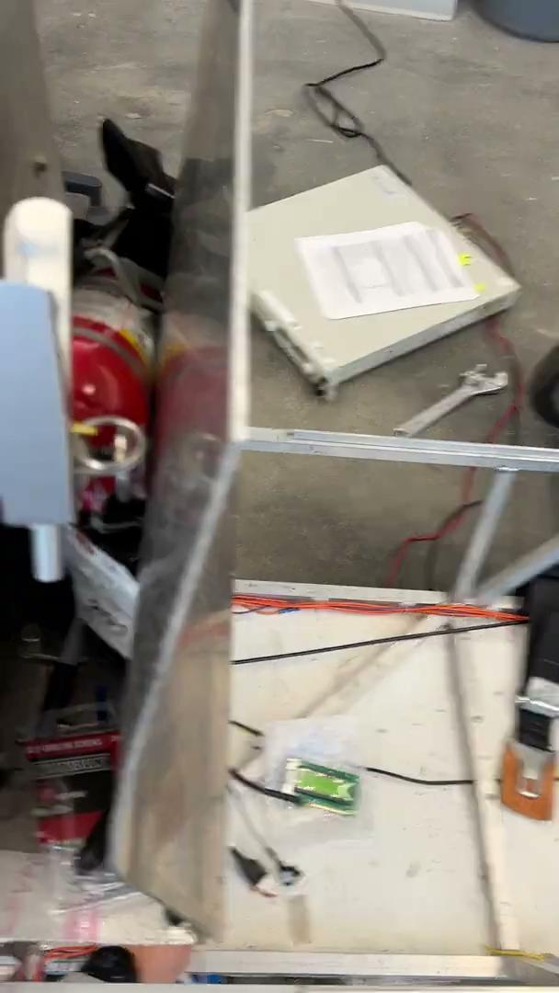
[picture p265: figure]

Current FC woes

- FC was bought in ‘19 and has had multiple start-up issues
- Possible need for FC rehydration & system renewals
- No benchmarking of potential power

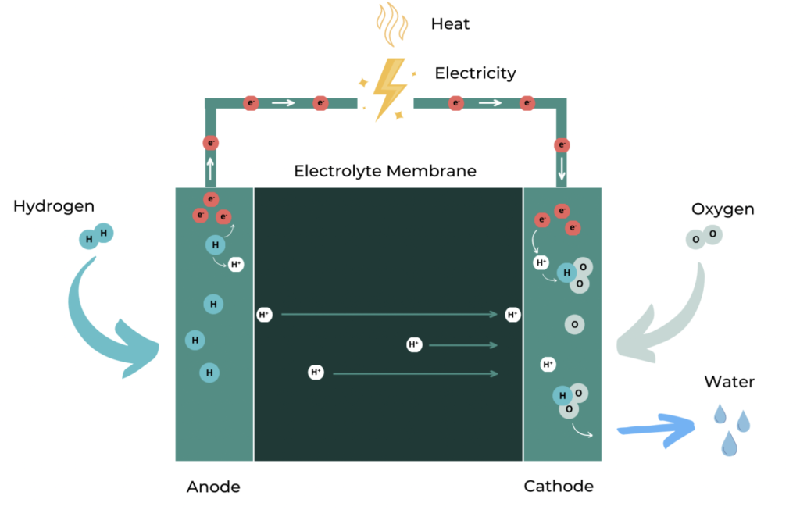
[picture p266: figure]

Notes: JC [how a hydrogen fuel cell works + necessary checks/troubleshooting with the fuel cell engine works]

TALK MORE ABT THE SUSTAINABILITY ASPECTS AND ELECTRONICS

## Weight kills efficiency Fuel Efficiency is King! 240+ MPG Gained

Shell Eco-Marathon measures the amount of hydrogen used to drive 3.9kms in less than 35 mins.

Our fuel efficiency model estimates ~3-4 MPGe gained per pound reduced.

A potential >20% fuel efficiency increase by swapping to lighter material!

Notes: JC [how fuel efficiency is calculated for the competition and how the model works + future plans for complications if needed] -> would be a good place to link the fuel efficiency calculations to the material changes/joint change [maybe next slide in next iteration]

## Material Impacts CF Tube Δ Suspension

Overall Weight (Including Driver):
243 ➔ 166 lbs (31% Decrease)
Fuel Efficiency:
1288➔ 1598MPGe (24% Increase)

Overall Weight:
25 ➔ ~12 lbs (With Added Back)

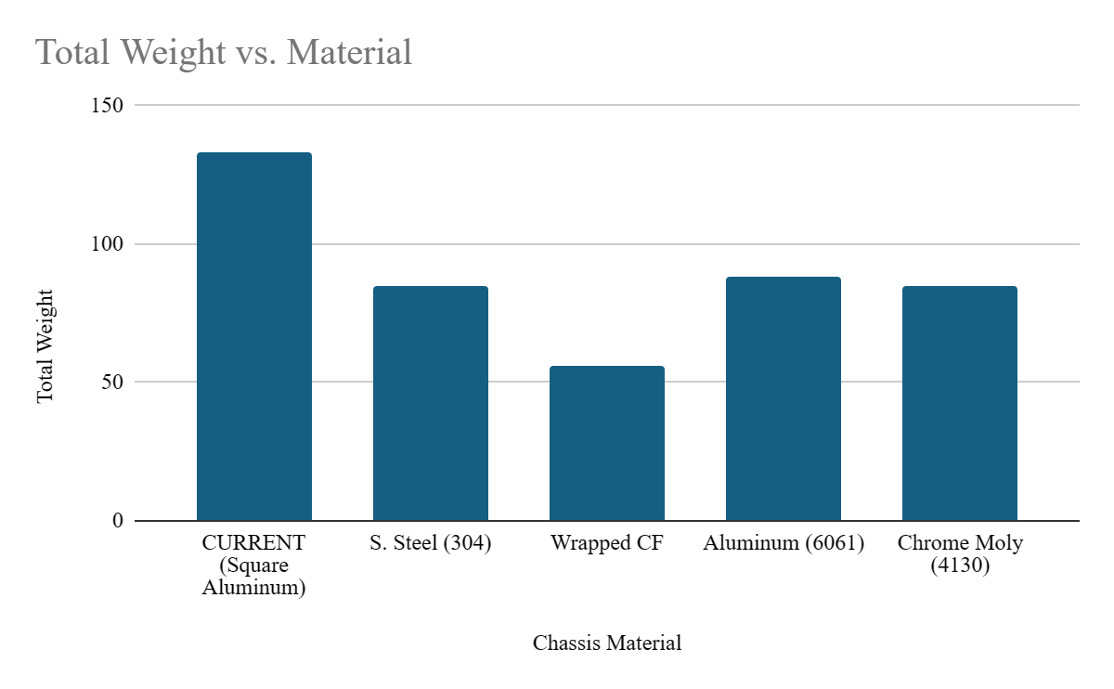
[picture p267: figure]

Notes: BH

## 2: New Chassis & Materials Research


Notes: BH - Insert SAP model

## Connection Methods: Carbon Fiber Tubes

Aluminum Inserts

Benefits:
- Reliable material strength
- Machining Constraints
Drawbacks:
- Heavier
- Welding is difficult
Potential Additional Strength:
- Cable/String through rod

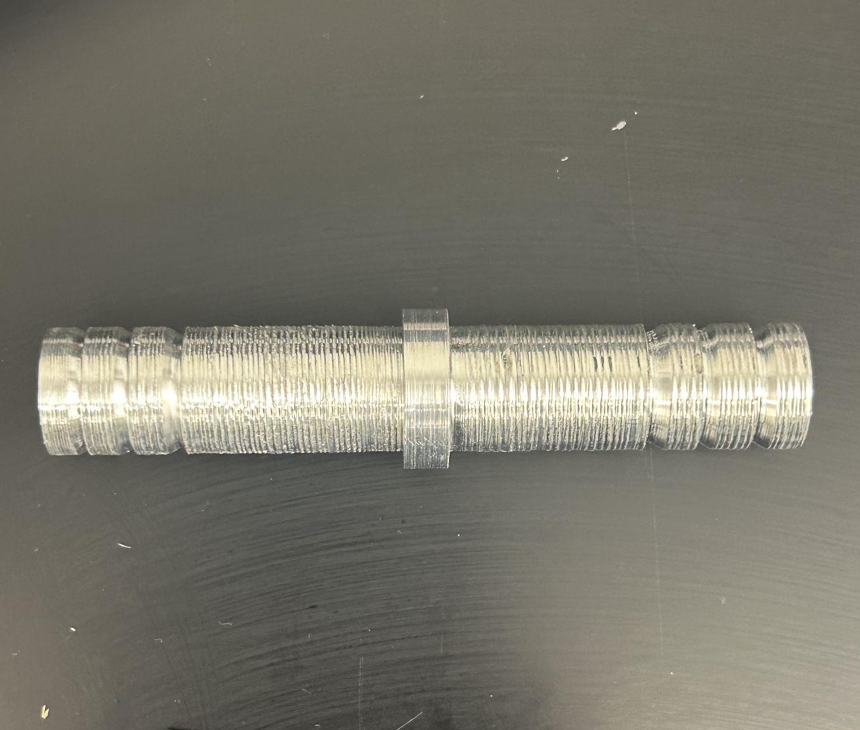
[picture p268: figure]
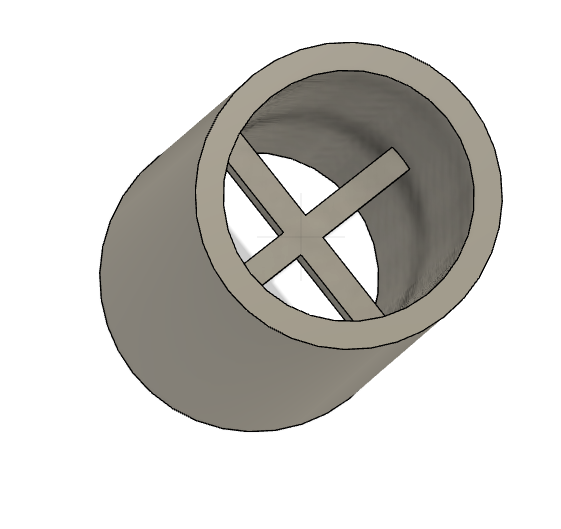
[picture p269: figure]

3D Printed Collars

Benefits:
- Lightweight and strong
- Flexible in design
Drawbacks:
- Layer Shear Failure
- Misprints
Potential Additional Strength:
- Screw Connections

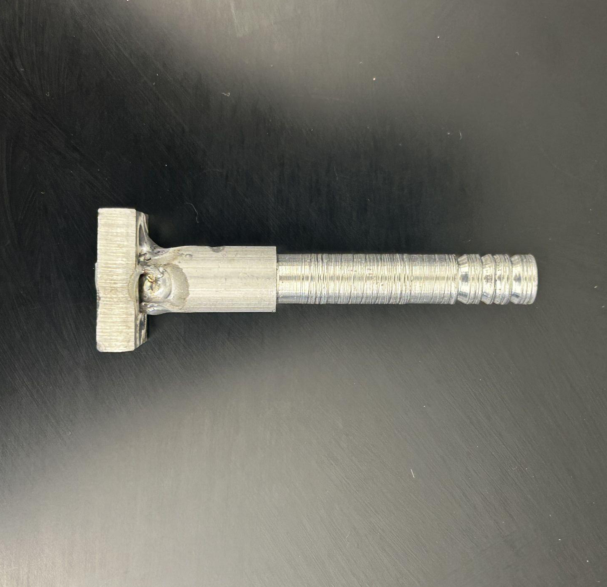
[picture p270: figure]
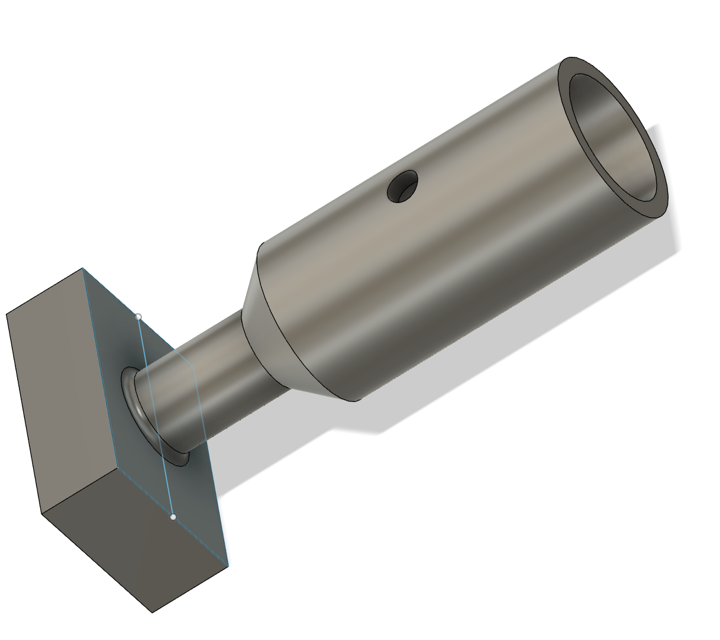
[picture p271: figure]

Notes: BH

## Tension Tests

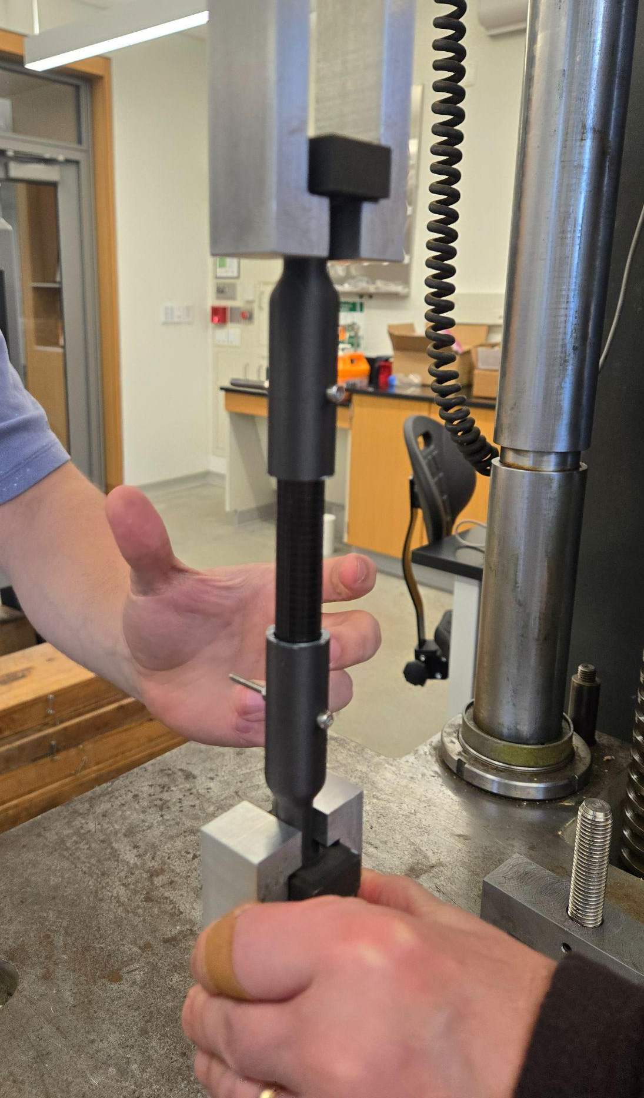
[picture p272: figure]
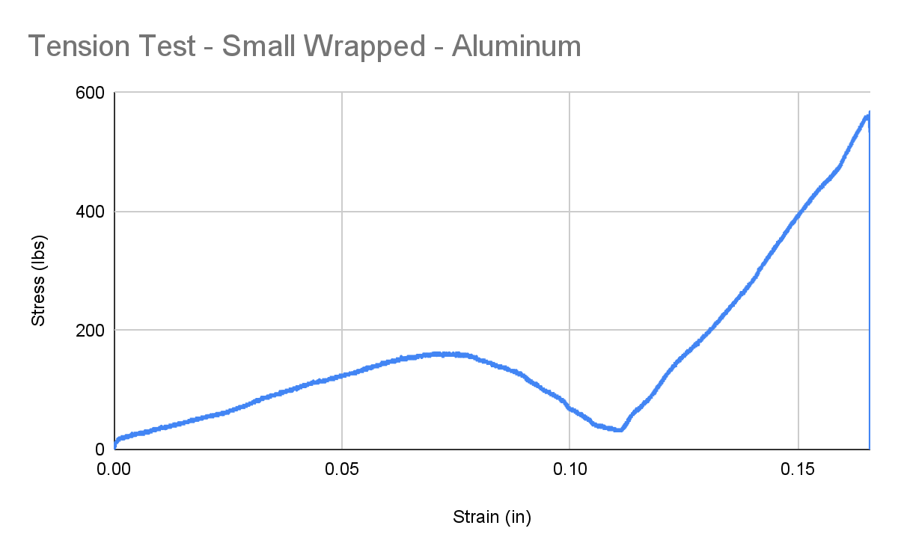
[picture p273: figure]
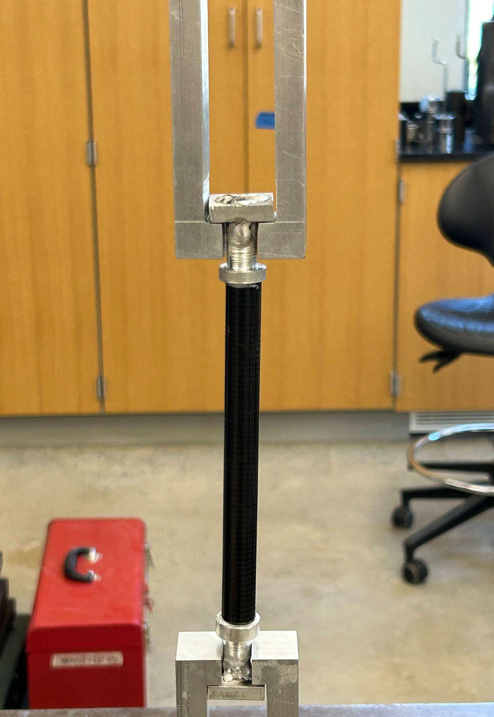
[picture p274: figure]
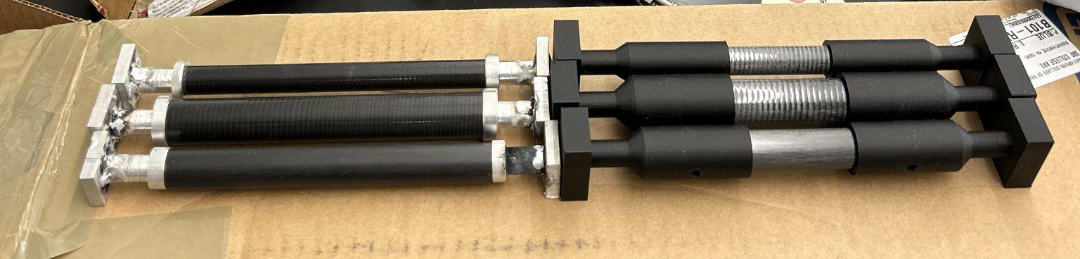
[picture p275: figure]

Notes: BH - 2 versions of carbon fiber - similar results with just epoxy. More confidence in the wrapped CF with how it is made. Approximately 400 lbs to rip out metal insert, initially 100-200 for plastic -> at least 400 lbs with hardware. Sloppy weld

## Failures so far

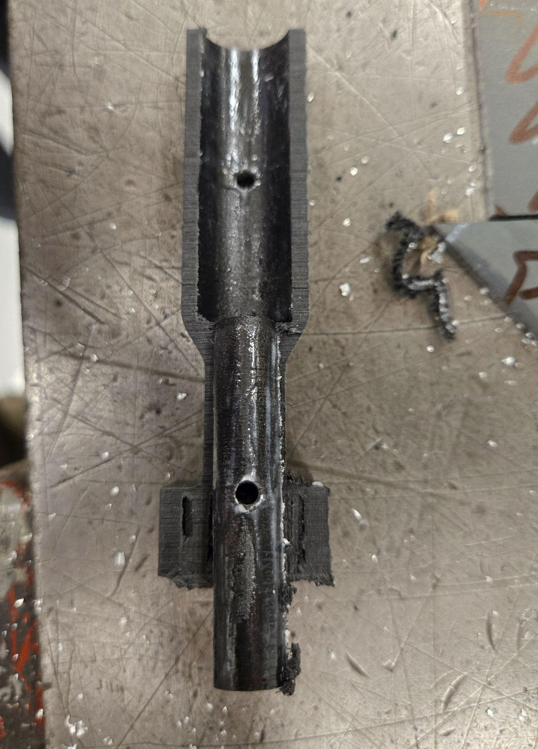
[picture p276: figure]
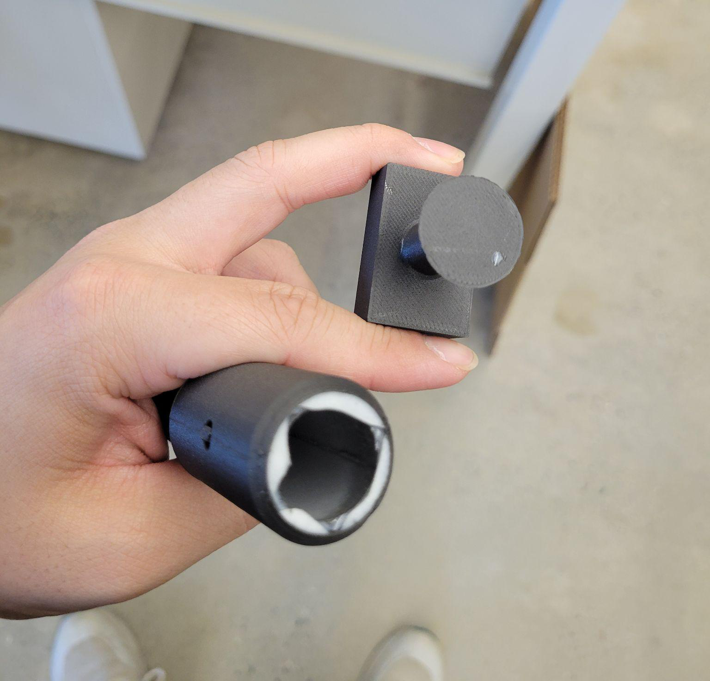
[picture p277: figure]
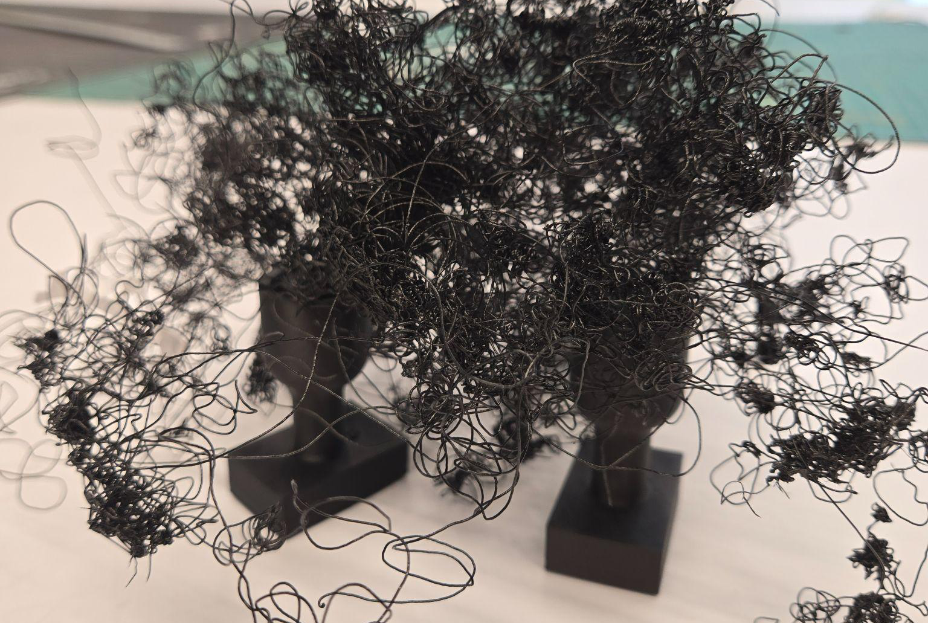
[picture p278: figure]
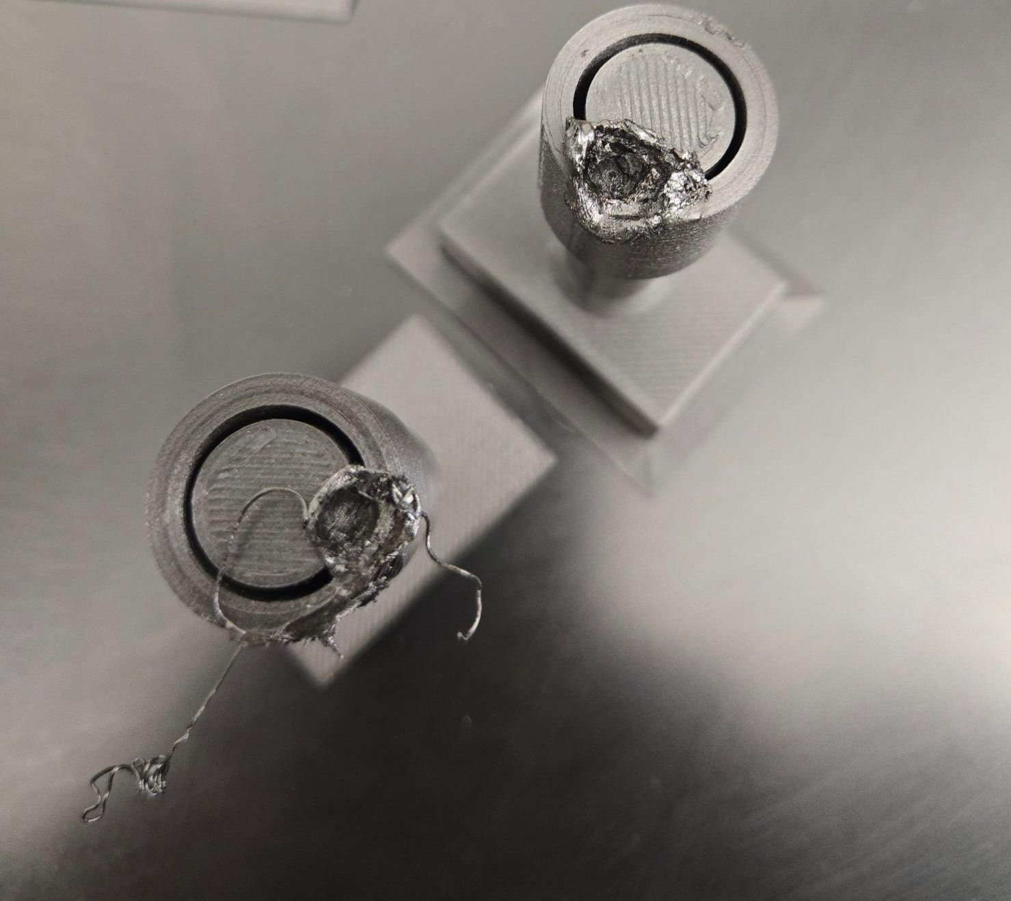
[picture p279: figure]

Notes: JC -> pictures of failed prints, failures from the fuel cell troubleshoots, testing moments

## Timeline and Next Steps

Conduct joint compression test/ 2nd round of material iterations

CAD design for back and front suspension of current vehicle

Fabricate suspensions from Chrome Moly tube

Final Joinery Designs

Draft Report

Installation + Adjustments to Previous Vehicle

Practice Presentations + Final Report

Graduate!

Notes: BH

## Thanks!

Do you have any questions?

Please keep this slide for attribution
