JeffreyLiang3449/HFCV-Website/2024 E90 work/Presentation materials (old)/E90 Mid-Semester Reivew.qmd

---
title: E90 Mid-Semester Reivew
resources:
  - "E90 Mid-Semester Reivew.pdf"
---

{{< pdf "E90 Mid-Semester Reivew.pdf" width="100%" height=700 >}}
