JeffreyLiang3449/HFCV-Website/2024 E90 work/Chassis Model/brake attachment v8.stl

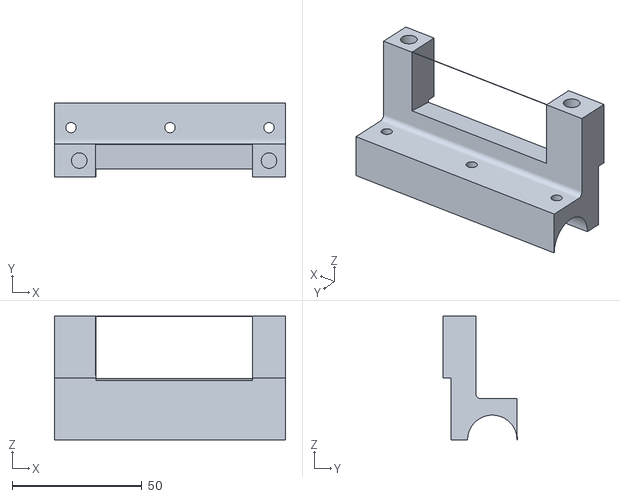
[picture p280: CAD file, 2026-09-14]
2024 E90 work/Chassis Model/brake attachment v8.stl
88.9 x 28.6 x 47.6
