JeffreyLiang3449/HFCV-Website/Chassis/Components/Angle Connectors/Interior Angle Connector v2.stl

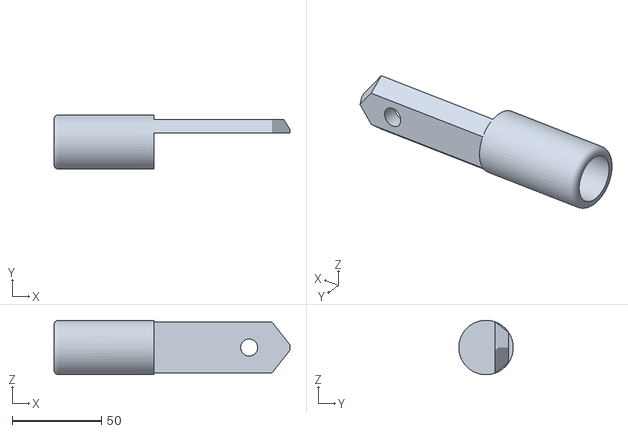
[picture p281: CAD file, 2026-09-14]
Chassis/Components/Angle Connectors/Interior Angle Connector v2.stl
132.1 x 30.5 x 30.5
