JeffreyLiang3449/HFCV-Website/Chassis/Components/Cowl Corners/STL/corner_rearmost v1.stl

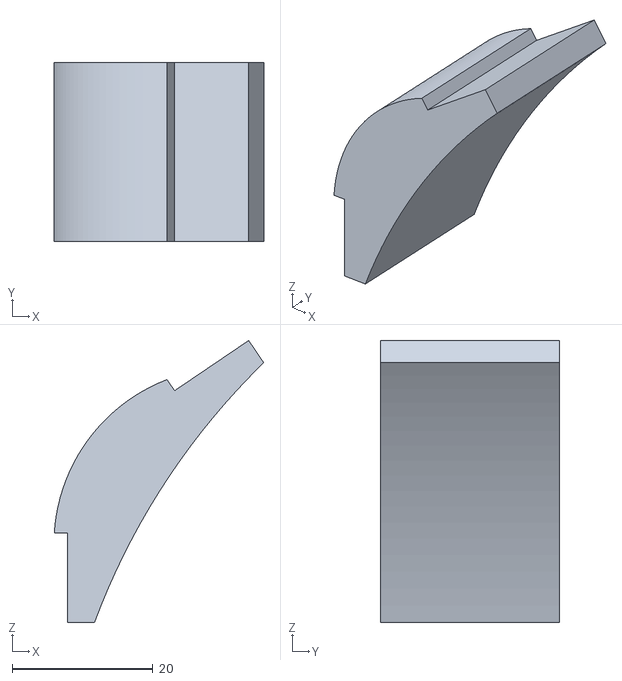
[picture p282: CAD file, 2026-09-14]
Chassis/Components/Cowl Corners/STL/corner_rearmost v1.stl
29.7 x 25.4 x 40.0
