JeffreyLiang3449/HFCV-Website/Chassis/Components/Floor Chassis Clips/Individual STL/floorcowl_flat_2.stl

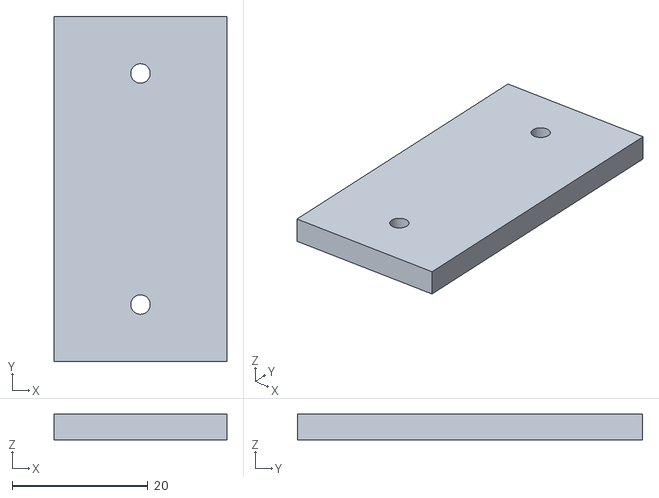
[picture p283: CAD file, 2026-09-14]
Chassis/Components/Floor Chassis Clips/Individual STL/floorcowl_flat_2.stl
25.4 x 50.8 x 3.81
