JeffreyLiang3449/HFCV-Website/Chassis/Components/Steering Bracket/Steering bracket v2.stl

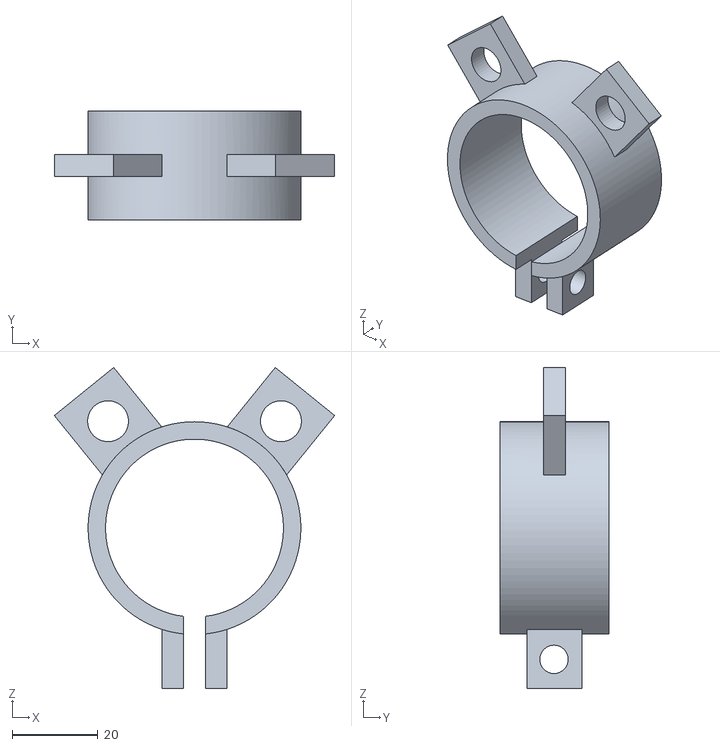
[picture p284: CAD file, 2026-09-14]
Chassis/Components/Steering Bracket/Steering bracket v2.stl
65.3 x 25.4 x 74.7
