JeffreyLiang3449/HFCV-Website/Chassis/Components/Angle Connectors/Regular modular tube connectors v2_Jun4 v3.stl

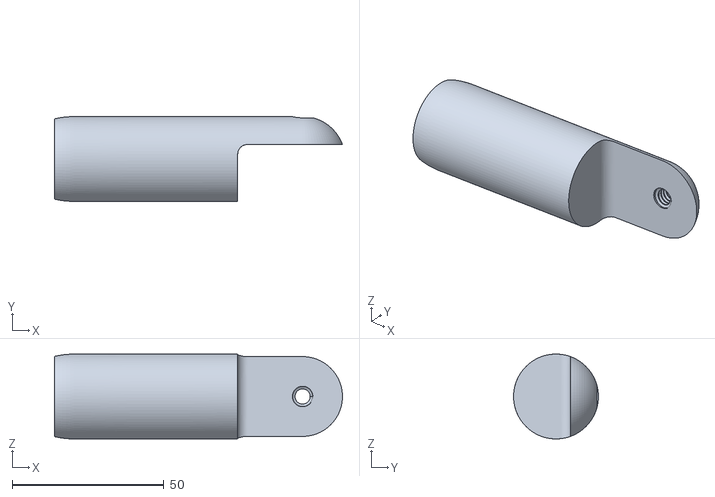
[picture p285: CAD file, 2026-09-14]
Chassis/Components/Angle Connectors/Regular modular tube connectors v2_Jun4 v3.stl
94.8 x 27.9 x 27.9
