JeffreyLiang3449/HFCV-Website/Chassis/Components/Cowl Corners/STL/corner_frontmost v1.stl

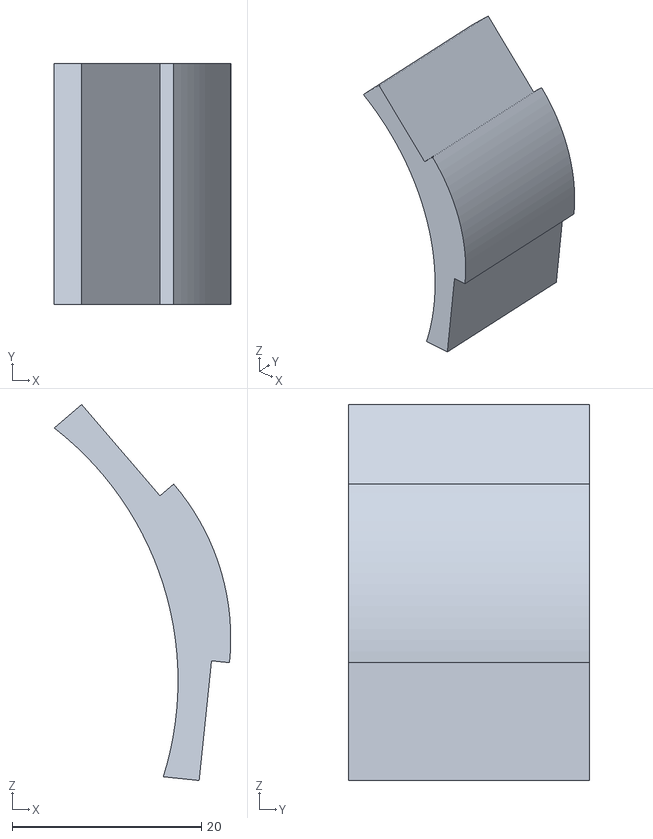
[picture p286: CAD file, 2026-09-14]
Chassis/Components/Cowl Corners/STL/corner_frontmost v1.stl
18.6 x 25.4 x 39.7
