JeffreyLiang3449/HFCV-Website/Chassis/Components/Cowl Corners/STL/corner_90deg v3.stl

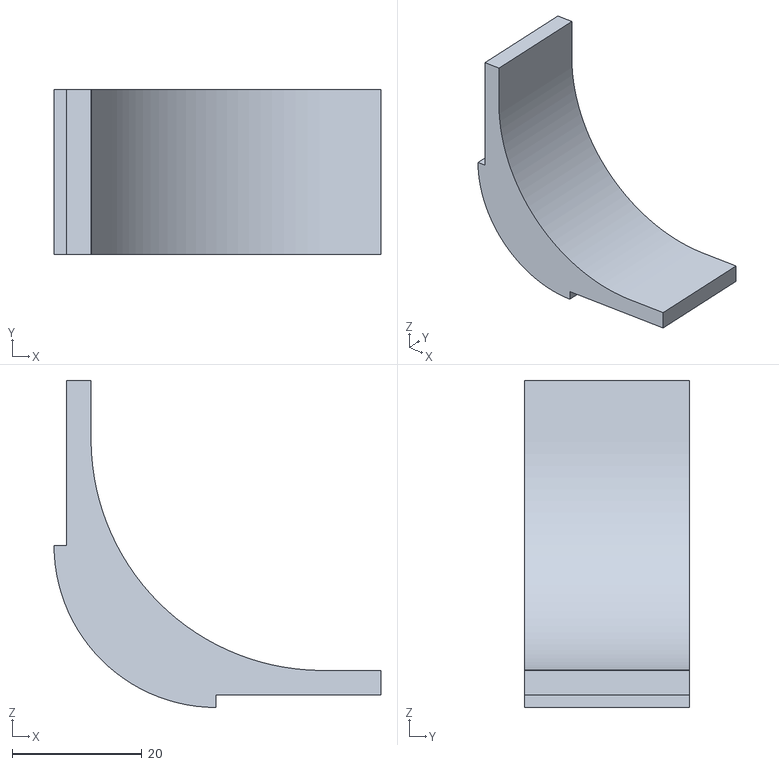
[picture p288: CAD file, 2026-09-14]
Chassis/Components/Cowl Corners/STL/corner_90deg v3.stl
50.4 x 25.4 x 50.4
