JeffreyLiang3449/HFCV-Website/Chassis/Components/Floor Chassis Clips/Individual STL/floorcowl_bottomfloor_2.stl

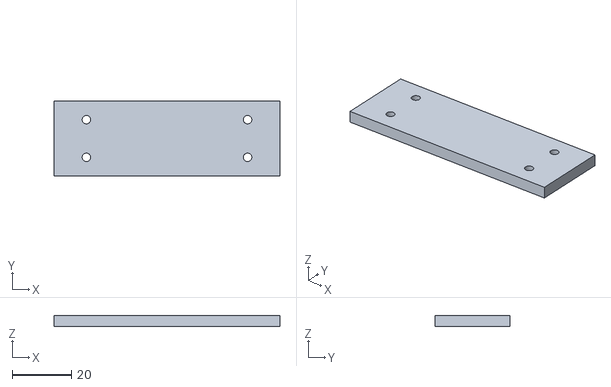
[picture p289: CAD file, 2026-09-14]
Chassis/Components/Floor Chassis Clips/Individual STL/floorcowl_bottomfloor_2.stl
76.2 x 25.4 x 3.81
