JeffreyLiang3449/HFCV-Website/Chassis/Components/Cowl Corners/STL/corner_frontbottom v1.stl

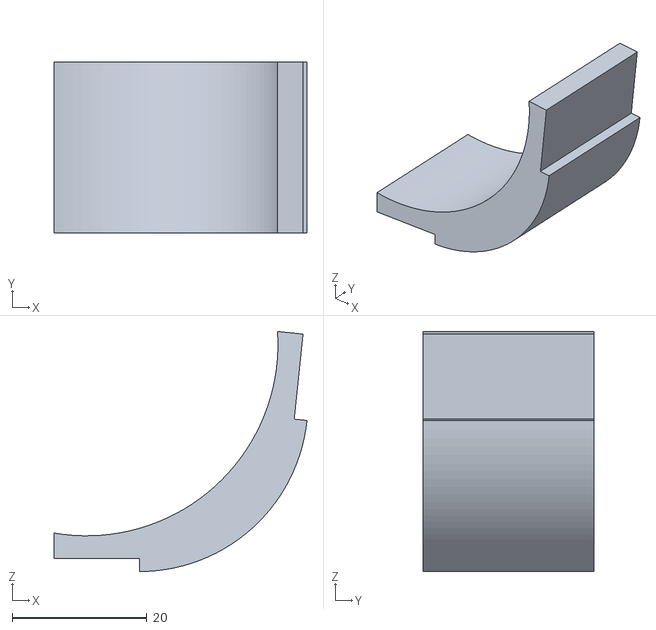
[picture p290: CAD file, 2026-09-14]
Chassis/Components/Cowl Corners/STL/corner_frontbottom v1.stl
37.6 x 25.4 x 35.6
