JeffreyLiang3449/HFCV-Website/Chassis/Components/Floor Chassis Clips/Individual STL/floorcowl_bottomfloor_edge_3.stl

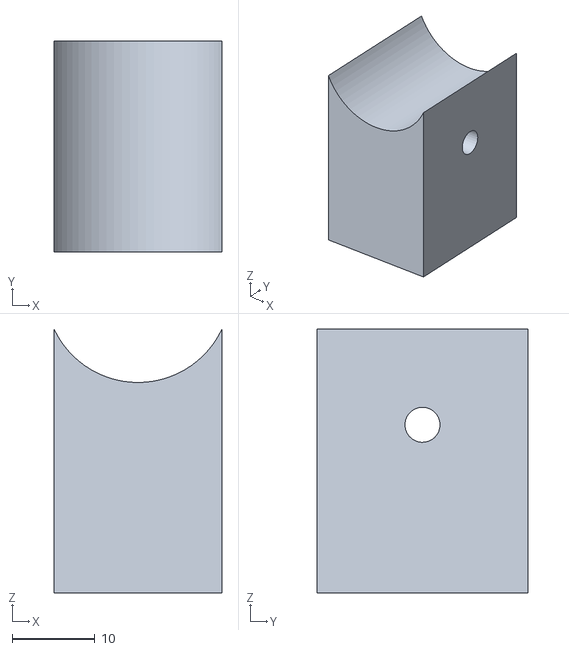
[picture p291: CAD file, 2026-09-14]
Chassis/Components/Floor Chassis Clips/Individual STL/floorcowl_bottomfloor_edge_3.stl
20.3 x 25.4 x 31.9
