JeffreyLiang3449/HFCV-Website/Chassis/Components/Floor Chassis Clips/Individual STL/floorcowl_topfloor_edge_1.stl

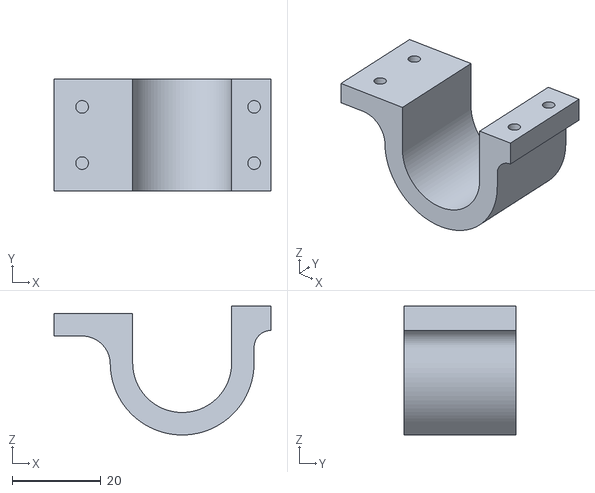
[picture p292: CAD file, 2026-09-14]
Chassis/Components/Floor Chassis Clips/Individual STL/floorcowl_topfloor_edge_1.stl
49.0 x 25.4 x 29.1
