JeffreyLiang3449/HFCV-Website/Chassis/Components/Floor Chassis Clips/Individual STL/floorcowl_topfloor_2.stl

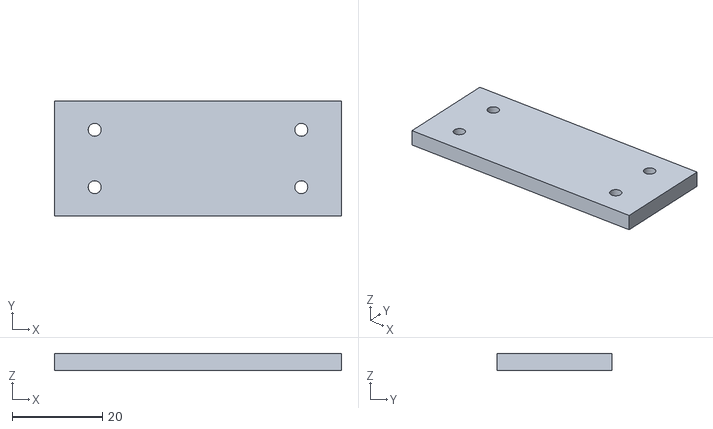
[picture p293: CAD file, 2026-09-14]
Chassis/Components/Floor Chassis Clips/Individual STL/floorcowl_topfloor_2.stl
63.5 x 25.4 x 3.81
