JeffreyLiang3449/HFCV-Website/Chassis/Components/Floor Chassis Clips/Individual STL/floorcowl_bottomfloor_3.stl

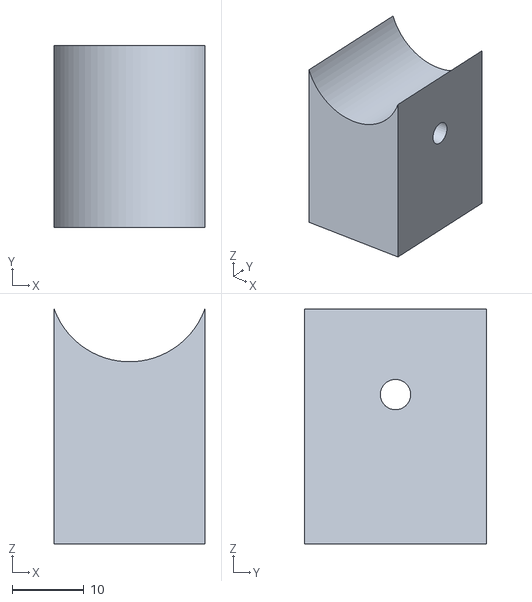
[picture p294: CAD file, 2026-09-14]
Chassis/Components/Floor Chassis Clips/Individual STL/floorcowl_bottomfloor_3.stl
21.0 x 25.4 x 32.8
