JeffreyLiang3449/HFCV-Website/Chassis/Components/Floor Chassis Clips/Individual STL/floorcowl_bottomfloor_edge_2.stl

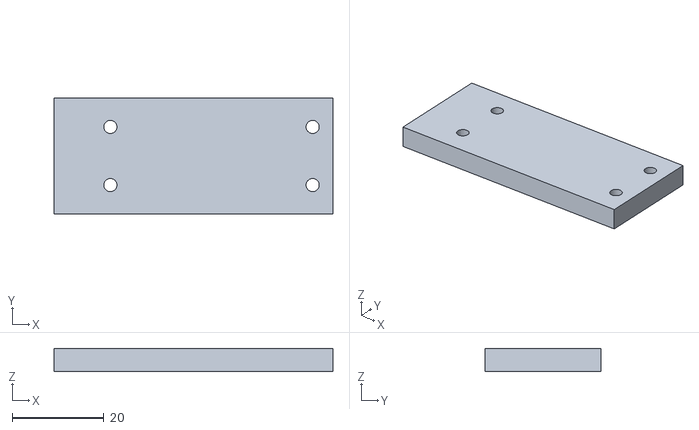
[picture p295: CAD file, 2026-09-14]
Chassis/Components/Floor Chassis Clips/Individual STL/floorcowl_bottomfloor_edge_2.stl
61.0 x 25.4 x 5.08
