JeffreyLiang3449/HFCV-Website/Chassis/Components/Floor Chassis Clips/Individual STL/floorcowl_bottomfloor_1.stl

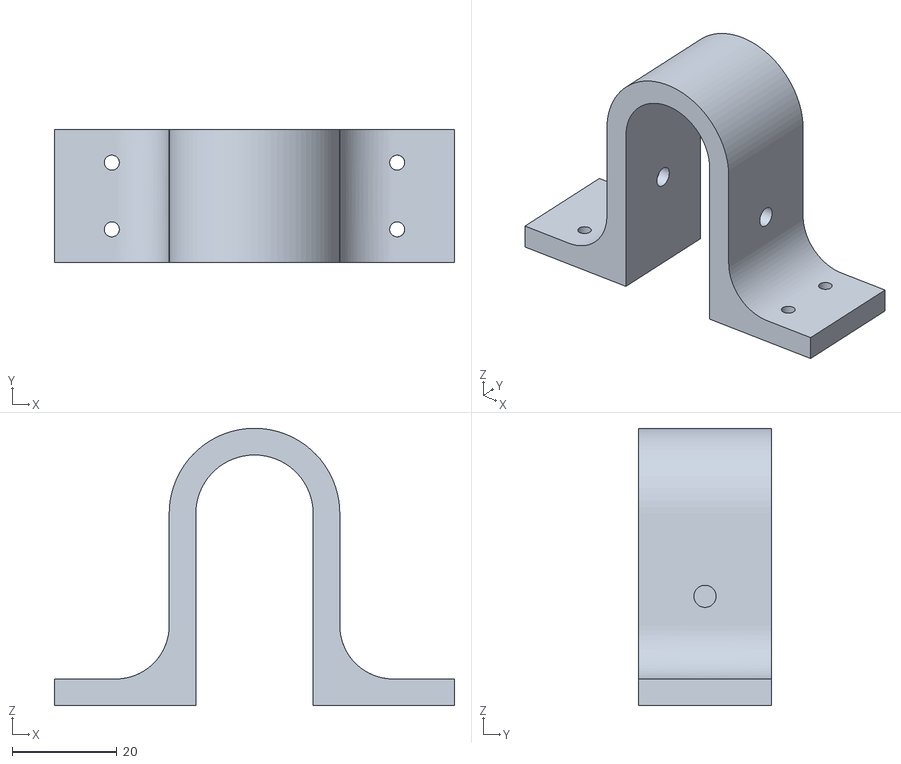
[picture p296: CAD file, 2026-09-14]
Chassis/Components/Floor Chassis Clips/Individual STL/floorcowl_bottomfloor_1.stl
76.2 x 25.4 x 52.8
