JeffreyLiang3449/HFCV-Website/(list of files, cad)

Other CAD files:
Chassis/Components/Floor Chassis Clips/Individual STL/floorcowl_flat_1.stl
2024 E90 work/Chassis Model/3D collar Large Wrapped with clevis v1.f3d
2024 E90 work/Chassis Model/Angled Modular Tube Connectors v1 v1.f3d
2024 E90 work/Chassis Model/Plate w hole v2.f3d
2024 E90 work/Chassis Model/Regular modular tube connectors v1 v1.f3d
2024 E90 work/Chassis Model/Small wrapped collar design _24 v3.f3d
2024 E90 work/Chassis Model/brake attachment v2.f3d
2024 E90 work/Chassis Model/brake attachment v7.f3d
2024 E90 work/Chassis Model/plate with trench v1.f3d
2025 E90 work/Designs/Brake/Brake Stand v22.f3d
2025 E90 work/Designs/Brake/FINAL BRAKE ASSEMBLY v4.f3z
2025 E90 work/Designs/Brake/FINAL PEDAL v7.f3d
2025 E90 work/Designs/Brake/Pedal Stand v39.f3d
2025 E90 work/Designs/Steering/Rack + Pinion v2.f3d
2025 E90 work/Designs/Steering/Steering_Quick_Release v3.f3d
2025 E90 work/Designs/Suspension/Suspension Assembly v14.f3z
2025 E90 work/Designs/Suspension/Suspension Plate v10.f3d
Chassis/Components/Angle Connectors/Interior Angle Connector v1.f3d
Chassis/Components/Angle Connectors/Regular modular tube connectors v2_Jun4.f3d
Chassis/Components/Cowl Corners/f.3d/corner_90deg v3.f3d
Chassis/Components/Cowl Corners/f.3d/corner_frontbottom v1.f3d
Chassis/Components/Cowl Corners/f.3d/corner_frontmost v1.f3d
Chassis/Components/Cowl Corners/f.3d/corner_rearmost v1.f3d
Chassis/Components/Floor Chassis Clips/F3D/floorcowl_bottomfloor v13.f3d
Chassis/Components/Floor Chassis Clips/F3D/floorcowl_bottomfloor_edge v14.f3d
Chassis/Components/Floor Chassis Clips/F3D/floorcowl_flat v7.f3d
Chassis/Components/Floor Chassis Clips/F3D/floorcowl_topfloor v17.f3d
Chassis/Components/Floor Chassis Clips/F3D/floorcowl_topfloor_edge v11.f3d
Chassis/Components/Steering Bracket/Steering bracket v2.f3d
Chassis/Components/Suspension Plate/Suspension Plate (2).f3d
Chassis/Components/Suspension Plate/Suspension+Plate.f3d
Chassis/Whole Car CAD/Cowl_Jul18.f3d
Chassis/Whole Car CAD/Cowl_Jun23.f3d
Chassis/Whole Car CAD/HFCV Chassis_Jun23.f3d
Chassis/Whole Car CAD/Sketch of Rear of HFCV v48.f3d
Jeffrey Liang 3D Models/L hold.f3d
Jeffrey Liang 3D Models/L shape elbow.f3d
Jeffrey Liang 3D Models/T connector.f3d
Jeffrey Liang 3D Models/Tube Holder.f3d
Jeffrey Liang 3D Models/Ziptied T connector.f3d
Jeffrey Liang 3D Models/battery mount.f3d
Jeffrey Liang 3D Models/box for hfcv.f3d
Jeffrey Liang 3D Models/car scoop.f3d
Jeffrey Liang 3D Models/e button holder.f3d
Jeffrey Liang 3D Models/tank holder.f3d
