JeffreyLiang3449/HFCV-Website/Literature/Markforged Printer Instructions.qmd

---
title: Markforged Printer Instructions
resources:
  - "Markforged Printer Instructions.pdf"
---

{{< pdf "Markforged Printer Instructions.pdf" width="100%" height=700 >}}
