JeffreyLiang3449/HFCV-Website/Chassis/[HFCV] Front of Car Fabrication Quantity.xlsx

Sheet: Front of Car
Carbon Fibre | Member Number | Length | Status | Aluminium Connectors | Type of Connector | Quantity Needed | Inventory
 | A1 | 12.26 | TRUE |  |  | 4 | 4
 | A2 | 6 | TRUE |  |  | 6 | 5
 | A3 | 12 | TRUE |  |  | 18 | 2
 | A4 | 8.25 | TRUE |  |  | 8 | 8
 | A5 | 8.25 | TRUE |  |  |  | Total length needed: 10 ft
 | A6 | 8.25 | TRUE
 | A7 | 12 | TRUE
 | A8 | 8.25 | TRUE
 | B1 | 12.26 | TRUE
 | B2 | 6 | TRUE
 | B3 | 12 | TRUE
 | B4 | 8.25 | TRUE
 | B5 | 8.25 | TRUE
 | B6 | 8.25 | TRUE
 | B7 | 12 | TRUE
 | B8 | 8.25 | TRUE
Convention: [Letter Corresponding to Half, Number]

Sheet: Back of Car
Aluminium Connectors | Type of Connector | Quantity Needed | Inventory
 |  | 20 | 0
 |  | 5 | 0
 |  | 8 | 0
 |  | 8 | 8
 |  |  | Total length needed: 10 ft
