JeffreyLiang3449/HFCV-Website/Literature/New Drawing and Manufacturing progress.qmd

Drawing:

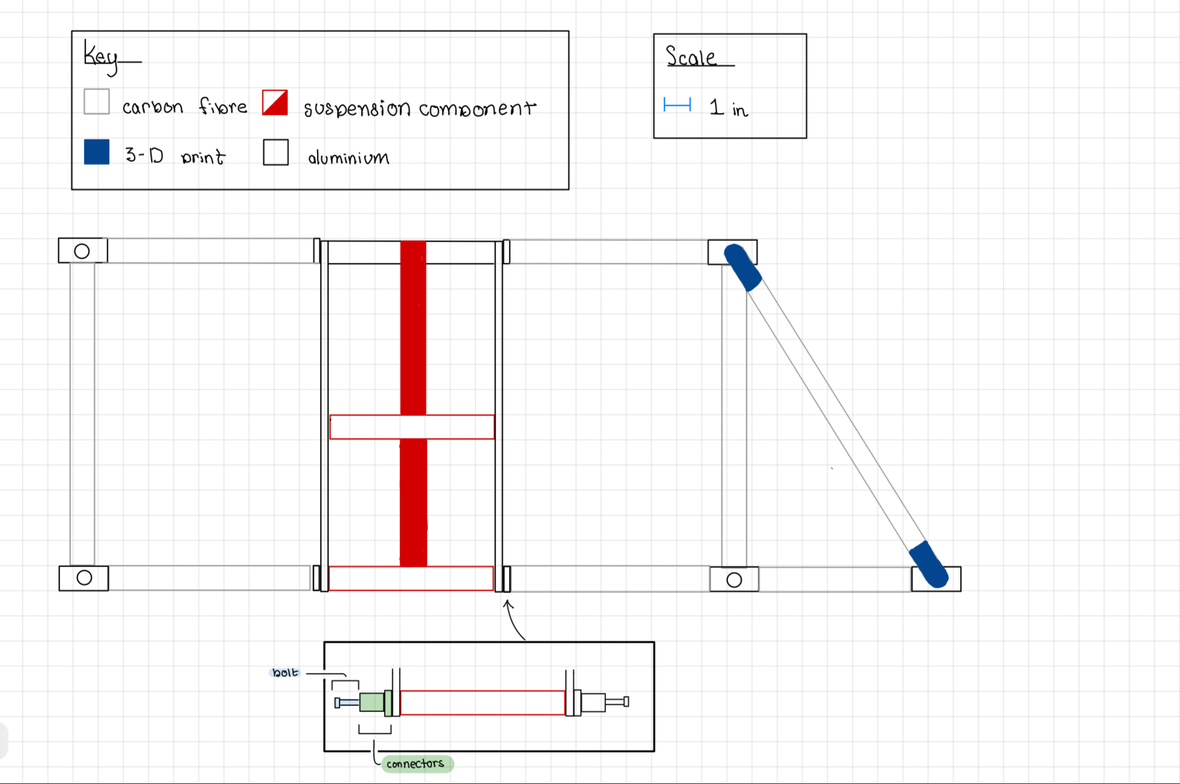
[picture p317: Literature/media/image1.jpg]


Progress
