JeffreyLiang3449/HFCV-Website/2024 E90 work/First Tension Test (3-8)/carbonfiber8Mar24.xlsx

Time | Load (lb) | Position (in) | AxialStrain (in) | Control Out (V) | Stress (psi)
0 | 0 | 0.00016666668 | 0.00027621083 | -0.89421964 | 0
0.01000000164 | -1.9552716 | 0.00016666668 | 0.00027621083 | -0.89421964 | -9.958126
0.01999999955 | 0 | 0.00016666668 | 0.00027621083 | -0.89421964 | 0
0.03000000119 | -1.9552716 | 0.00016666668 | 0.00027621083 | -0.89421964 | -9.958126
0.03999999911 | -1.9552716 | 0.00016666668 | 0.00028725926 | -0.89421964 | -9.958126
0.04999999702 | -1.9552716 | 0.00016666668 | 0.00027621083 | -0.89421964 | -9.958126
0.06000000238 | 0 | 0.00016666668 | 0.00027621083 | -0.89421964 | 0
0.0700000003 | 0 | 0.00016666668 | 0.00028725926 | -0.89421964 | 0
0.07999999821 | 0 | 0.00016666668 | 0.00028725926 | -0.447415 | 0
0.09000000358 | 0 | 0.00016666668 | 0.00027621083 | -0.447415 | 0
0.1000000015 | 0 | 0.00016666668 | 0.00027621083 | -0.447415 | 0
0.1099999994 | -1.9552716 | 0.00016666668 | 0.00027621083 | -0.447415 | -9.958126
0.1200000048 | -1.9552716 | 0.00016666668 | 0.00027621083 | -0.447415 | -9.958126
0.1299999952 | -1.9552716 | 0.00016666668 | 0.00027621083 | -0.447415 | -9.958126
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
