JeffreyLiang3449/HFCV-Website/2024 E90 work/First Tension Test (3-8)/Material Tension and Compression Tests.xlsx

Sheet: Summary
GOAL IN TENSION: 1000 LBS
Performance of Aluminum Inserts |  |  |  |  |  |  | SW | LP | LW | Average
 | SW | LP (REMOVE?) | LW | Average Wrapped |  | 75% of max (lbs) | 420.872175 | 316.75401 | 447.2683875 | 434.0702813
Maximum (lbs) | 561.1629 | 422.33868 | 596.35785 | 578.760375
Modulus | 9425 | 5666.666667 | 9297.626316 | 9361.313158
Est. Displacement | 0.05 | 0.06 | 0.055
Inner Circumference | 1.5386 | 1.64222 | 2.3236
Modulus per " of Engagement | 6125.698687 | 3450.6136 | 4001.388499
Performance of CF |  |  |  |  |  |  | SW | LP | LW | Average
 | SW | LP (REMOVE?) | LW | SP (Broken) |  | 75% of max (lbs) | 167.17572 | 0 | 96.7859475 | 153.75
Maximum | 222.90096 |  | 129.04793 | 205
Modulus | 3866.666667 |  | 2850 | 5750
Est. Displacement | 0.051 |  | 0.04 | 0.037
Inner Circumference
Aluminum
SW
LP
LW
3D printed
SW
LP
LW
SP
Material (rods) | Modulus (GPa) | Density (grams/cm^3) | Thickness | OD (inches) | I (in^4) | Pressure (Psi) | Displacement (inches) | Weight(per member) | Total W of Chassis (lbs) | Total Weight | Difference in weight(lbs) | Reduction | Weight with Driver (lbs)
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
