JeffreyLiang3449/HFCV-Website/2024 E90 work/First Tension Test (3-8)/carbonfiber-2024-03-08-14-05-13.csv

Time | Load (lb) | Position (in) | AxialStrain (in) | Control Out (V) | Stress (psi)
0.0 | 0.0 | 1.6666668E-4 | 2.7621083E-4 | -0.89421964 | 0.0
0.010000001639127731 | -1.9552716 | 1.6666668E-4 | 2.7621083E-4 | -0.89421964 | -9.958126
0.019999999552965164 | 0.0 | 1.6666668E-4 | 2.7621083E-4 | -0.89421964 | 0.0
0.030000001192092896 | -1.9552716 | 1.6666668E-4 | 2.7621083E-4 | -0.89421964 | -9.958126
0.03999999910593033 | -1.9552716 | 1.6666668E-4 | 2.8725926E-4 | -0.89421964 | -9.958126
0.04999999701976776 | -1.9552716 | 1.6666668E-4 | 2.7621083E-4 | -0.89421964 | -9.958126
0.06000000238418579 | 0.0 | 1.6666668E-4 | 2.7621083E-4 | -0.89421964 | 0.0
0.07000000029802322 | 0.0 | 1.6666668E-4 | 2.8725926E-4 | -0.89421964 | 0.0
0.07999999821186066 | 0.0 | 1.6666668E-4 | 2.8725926E-4 | -0.447415 | 0.0
0.09000000357627869 | 0.0 | 1.6666668E-4 | 2.7621083E-4 | -0.447415 | 0.0
0.10000000149011612 | 0.0 | 1.6666668E-4 | 2.7621083E-4 | -0.447415 | 0.0
0.10999999940395355 | -1.9552716 | 1.6666668E-4 | 2.7621083E-4 | -0.447415 | -9.958126
0.12000000476837158 | -1.9552716 | 1.6666668E-4 | 2.7621083E-4 | -0.447415 | -9.958126
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
