JeffreyLiang3449/HFCV-Website/2024 E90 work/First Tension Test (3-8)/carbonfiber-2024-03-08-14-15-00.csv

Time | Load (lb) | Position (in) | AxialStrain (in) | Control Out (V) | Stress (psi)
0.0 | 1.9552716 | 0.0 | 4.4193733E-4 | 6.103888E-4 | 9.958126
0.009999999776482582 | 1.9552716 | 0.0 | 4.308889E-4 | 6.103888E-4 | 9.958126
0.020000001415610313 | 0.0 | 0.0 | 4.4193733E-4 | 6.103888E-4 | 0.0
0.029999999329447746 | 1.9552716 | 0.0 | 4.1984045E-4 | 6.103888E-4 | 9.958126
0.04000000096857548 | 0.0 | 0.0 | 4.308889E-4 | 6.103888E-4 | 0.0
0.04999999888241291 | 0.0 | 0.0 | 4.308889E-4 | 6.103888E-4 | 0.0
0.05999999679625034 | 1.9552716 | 0.0 | 4.308889E-4 | 6.103888E-4 | 9.958126
0.07000000216066837 | 1.9552716 | 0.0 | 4.4193733E-4 | 6.103888E-4 | 9.958126
0.0800000000745058 | 1.9552716 | 0.0 | 4.308889E-4 | 6.103888E-4 | 9.958126
0.08999999798834324 | 1.9552716 | 0.0 | 4.1984045E-4 | 0.447415 | 9.958126
0.10000000335276127 | 1.9552716 | 0.0 | 4.308889E-4 | 0.447415 | 9.958126
0.1100000012665987 | 0.0 | 0.0 | 4.4193733E-4 | 0.447415 | 0.0
0.11999999918043613 | 0.0 | 0.0 | 4.308889E-4 | 0.447415 | 0.0
0.13000000454485416 | 1.9552716 | 0.0 | 4.308889E-4 | 0.447415 | 9.958126
0.139999995008111 | 1.9552716 | 0.0 | 4.308889E-4 | 0.447415 | 9.958126
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
