JeffreyLiang3449/HFCV-Website/2024 E90 work/First Tension Test (3-8)/carbonfiber-2024-03-08-14-20-46.csv

Time | Load (lb) | Position (in) | AxialStrain (in) | Control Out (V) | Stress (psi)
0.0 | 3.9105432 | 0.0 | 1.10484325E-5 | 6.103888E-4 | 19.916252
0.010000000009313226 | 3.9105432 | 0.0 | 1.10484325E-5 | 6.103888E-4 | 19.916252
0.019999999785795808 | 1.9552716 | 0.0 | 0.0 | 6.103888E-4 | 9.958126
0.03000000142492354 | 3.9105432 | 0.0 | 0.0 | 6.103888E-4 | 19.916252
0.03999999933876097 | 1.9552716 | 0.0 | 0.0 | 6.103888E-4 | 9.958126
0.0500000009778887 | 1.9552716 | 0.0 | 0.0 | 6.103888E-4 | 9.958126
0.059999998891726136 | 1.9552716 | 0.0 | -1.10484325E-5 | 6.103888E-4 | 9.958126
0.06999999680556357 | 1.9552716 | 0.0 | 0.0 | 6.103888E-4 | 9.958126
0.0800000021699816 | 1.9552716 | 0.0 | 0.0 | 6.103888E-4 | 9.958126
0.09000000008381903 | 3.9105432 | 0.0 | -1.10484325E-5 | 6.103888E-4 | 19.916252
0.09999999799765646 | 1.9552716 | 0.0 | 0.0 | 0.447415 | 9.958126
0.1100000033620745 | 3.9105432 | 0.0 | 0.0 | 0.447415 | 19.916252
0.12000000127591193 | 1.9552716 | 0.0 | 0.0 | 0.447415 | 9.958126
0.12999999918974936 | 3.9105432 | 0.0 | 0.0 | 0.447415 | 19.916252
0.1400000045541674 | 3.9105432 | 0.0 | 0.0 | 0.447415 | 19.916252
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
