JeffreyLiang3449/HFCV-Website/2024 E90 work/First Tension Test (3-8)/carbonfiber-2024-03-08-14-29-43.csv

Time | Load (lb) | Position (in) | AxialStrain (in) | Control Out (V) | Stress (psi)
0.0 | 0.0 | 0.0 | 0.0 | 6.103888E-4 | 0.0
0.010000000009313226 | 0.0 | 0.0 | 2.2096865E-5 | 6.103888E-4 | 0.0
0.019999999785795808 | 0.0 | 0.0 | 0.0 | 6.103888E-4 | 0.0
0.03000000142492354 | 0.0 | 0.0 | -1.10484325E-5 | 6.103888E-4 | 0.0
0.03999999933876097 | 1.9552716 | 0.0 | 0.0 | 6.103888E-4 | 9.958126
0.0500000009778887 | 0.0 | 0.0 | -1.10484325E-5 | 6.103888E-4 | 0.0
0.059999998891726136 | 1.9552716 | 0.0 | 1.10484325E-5 | 6.103888E-4 | 9.958126
0.06999999680556357 | 0.0 | 0.0 | 0.0 | 6.103888E-4 | 0.0
0.0800000021699816 | 1.9552716 | 0.0 | 0.0 | 6.103888E-4 | 9.958126
0.09000000008381903 | 0.0 | 0.0 | 1.10484325E-5 | 6.103888E-4 | 0.0
0.09999999799765646 | 0.0 | 0.0 | 0.0 | 0.447415 | 0.0
0.1100000033620745 | 0.0 | 0.0 | 1.10484325E-5 | 0.447415 | 0.0
0.12000000127591193 | 0.0 | 0.0 | 0.0 | 0.447415 | 0.0
0.12999999918974936 | 0.0 | 0.0 | 1.10484325E-5 | 0.447415 | 0.0
0.1400000045541674 | 1.9552716 | 0.0 | 0.0 | 0.447415 | 9.958126
0.14999999501742423 | 0.0 | 0.0 | 1.10484325E-5 | 0.447415 | 0.0
0.16000000038184226 | 0.0 | 0.0 | 1.10484325E-5 | 0.447415 | 0.0
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
