JeffreyLiang3449/HFCV-Website/2024 E90 work/First Tension Test (3-8)/carbonfiber-2024-03-08-14-38-26.csv

Time | Load (lb) | Position (in) | AxialStrain (in) | Control Out (V) | Stress (psi)
0.0 | 5.8658147 | 0.29466668 | 2.2096865E-5 | 6.103888E-4 | 29.87438
0.010000000009313226 | 7.8210864 | 0.29466668 | 2.2096865E-5 | 6.103888E-4 | 39.832504
0.019999999785795808 | 5.8658147 | 0.29466668 | 1.10484325E-5 | 6.103888E-4 | 29.87438
0.03000000142492354 | 5.8658147 | 0.29466668 | 2.2096865E-5 | 6.103888E-4 | 29.87438
0.03999999933876097 | 5.8658147 | 0.29466668 | 3.31453E-5 | 6.103888E-4 | 29.87438
0.0500000009778887 | 5.8658147 | 0.29466668 | 2.2096865E-5 | 6.103888E-4 | 29.87438
0.059999998891726136 | 5.8658147 | 0.29466668 | 2.2096865E-5 | 6.103888E-4 | 29.87438
0.06999999680556357 | 5.8658147 | 0.29466668 | 1.10484325E-5 | 6.103888E-4 | 29.87438
0.0800000021699816 | 5.8658147 | 0.29466668 | 2.2096865E-5 | 6.103888E-4 | 29.87438
0.09000000008381903 | 5.8658147 | 0.29466668 | 2.2096865E-5 | 6.103888E-4 | 29.87438
0.09999999799765646 | 5.8658147 | 0.29466668 | 2.2096865E-5 | 0.447415 | 29.87438
0.1100000033620745 | 5.8658147 | 0.29466668 | 3.31453E-5 | 0.447415 | 29.87438
0.12000000127591193 | 5.8658147 | 0.29466668 | 1.10484325E-5 | 0.447415 | 29.87438
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
