JeffreyLiang3449/HFCV-Website/2024 E90 work/Photos and videos/Tension test (3-27)/20240327_174949.jpg

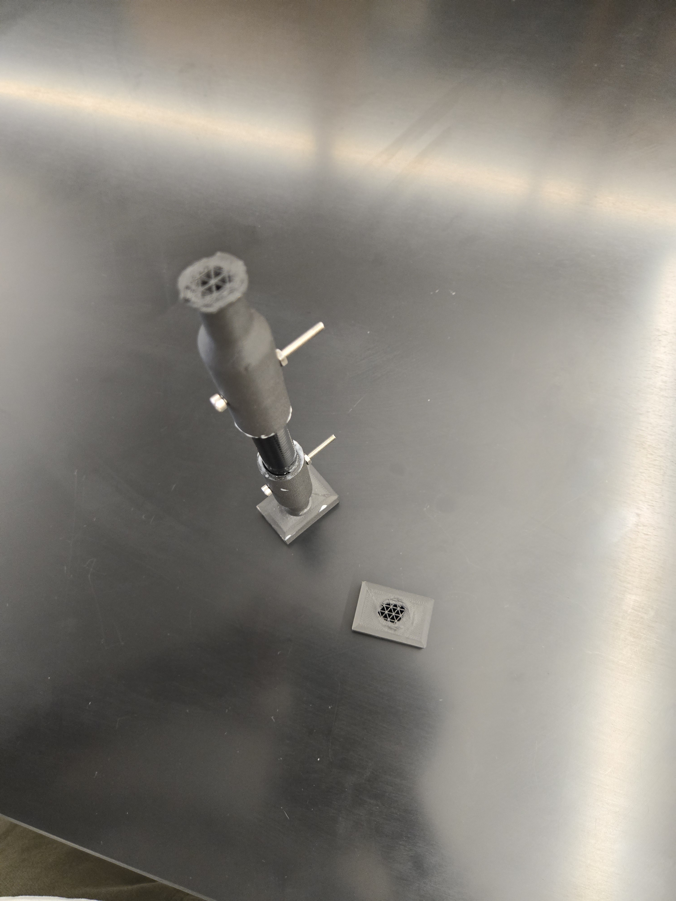
2024 E90 work/Photos and videos/Tension test (3-27)/20240327_174949.jpg
