JeffreyLiang3449/HFCV-Website/2024 E90 work/Testing Videos - Speed/Test2-Accel.png

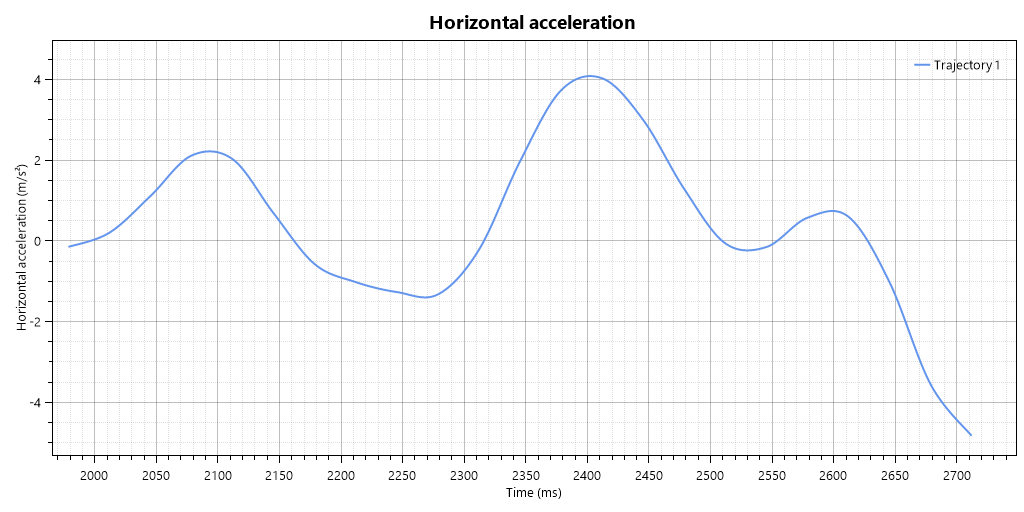
2024 E90 work/Testing Videos - Speed/Test2-Accel.png
