JeffreyLiang3449/HFCV-Website/2024 E90 work/Testing Videos - Speed/Test3-Accel.png

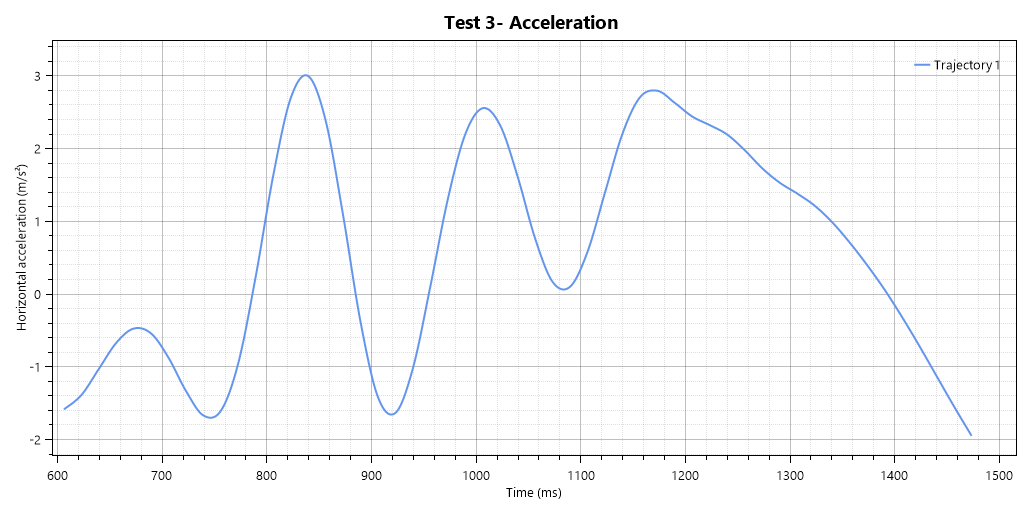
2024 E90 work/Testing Videos - Speed/Test3-Accel.png
