JeffreyLiang3449/HFCV-Website/2024 E90 work/Testing Videos - Speed/Test4-Accel.png

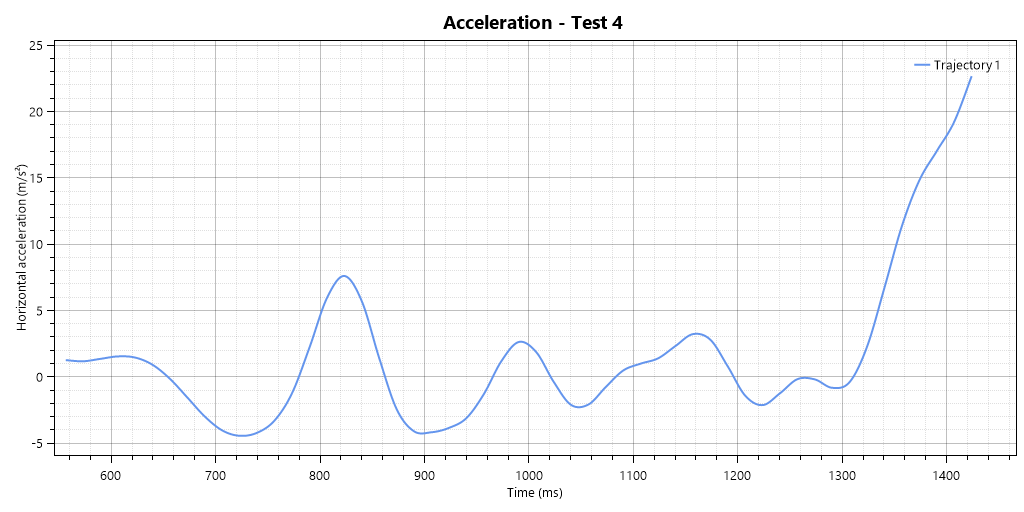
2024 E90 work/Testing Videos - Speed/Test4-Accel.png
