JeffreyLiang3449/HFCV-Website/2024 E90 work/Testing Videos - Speed/Test4-Speed.png

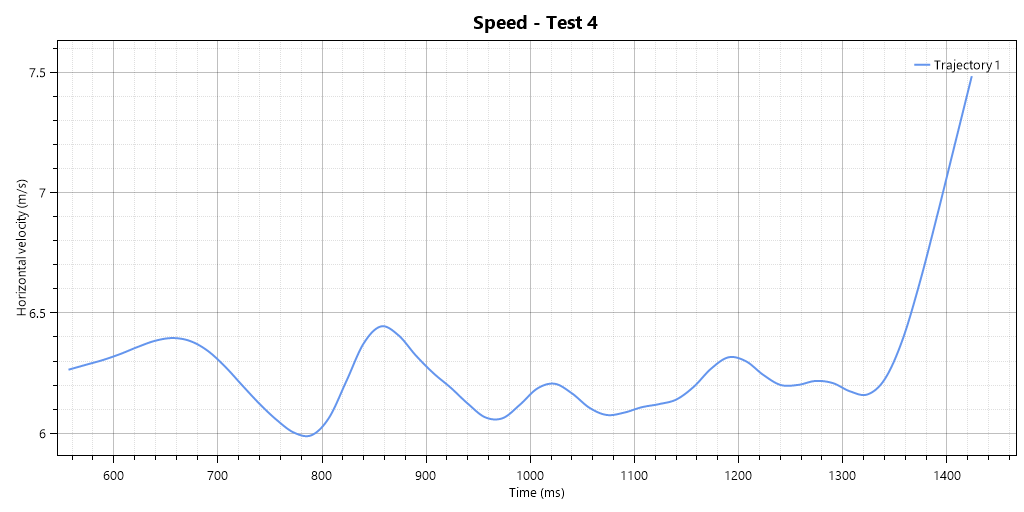
2024 E90 work/Testing Videos - Speed/Test4-Speed.png
