JeffreyLiang3449/HFCV-Website/2024 E90 work/Testing Videos - Speed/Test5-Accel.png

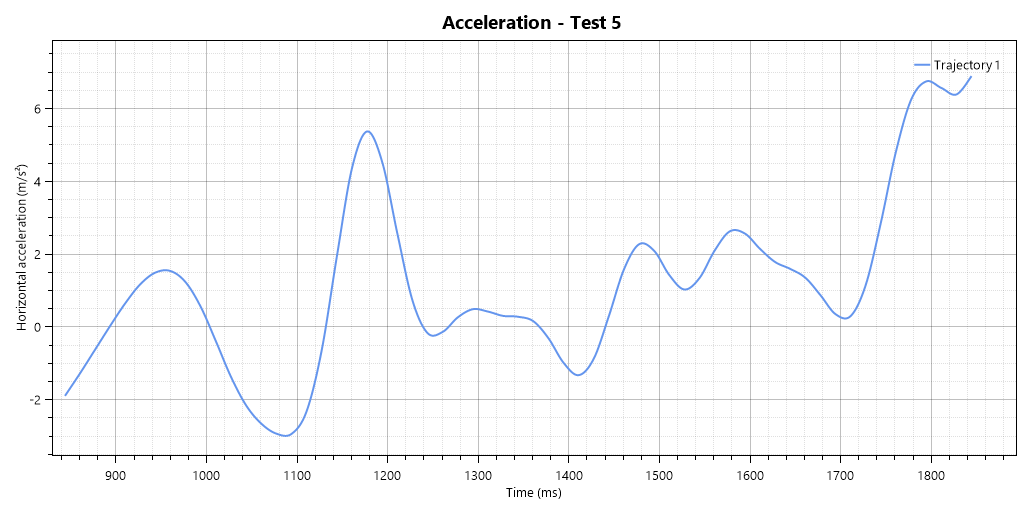
2024 E90 work/Testing Videos - Speed/Test5-Accel.png
