JeffreyLiang3449/HFCV-Website/2024 E90 work/Testing Videos - Speed/Test 2/20240410_172639.jpg

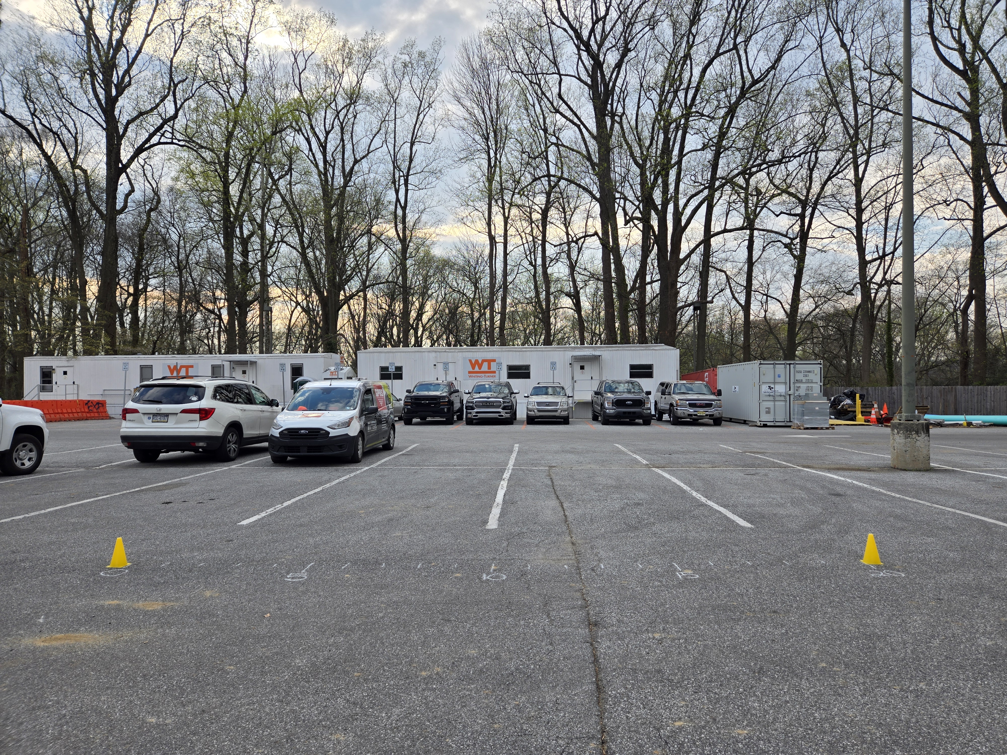
2024 E90 work/Testing Videos - Speed/Test 2/20240410_172639.jpg
