JeffreyLiang3449/HFCV-Website/2024 E90 work/Testing Videos - Speed/Test 2/Day2Test1Accel.png

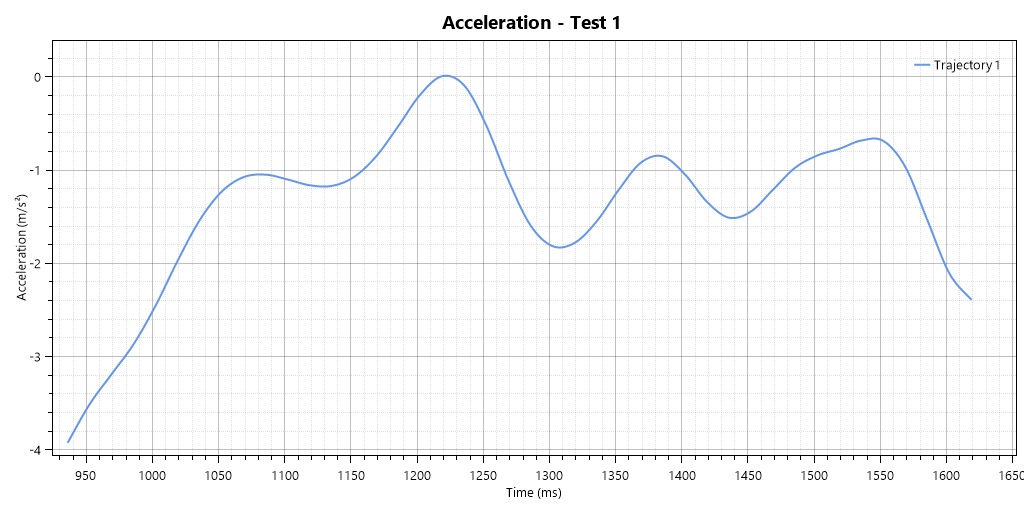
2024 E90 work/Testing Videos - Speed/Test 2/Day2Test1Accel.png
