JeffreyLiang3449/HFCV-Website/2024 E90 work/Testing Videos - Speed/Test 2/Day2Test3-Speed.png

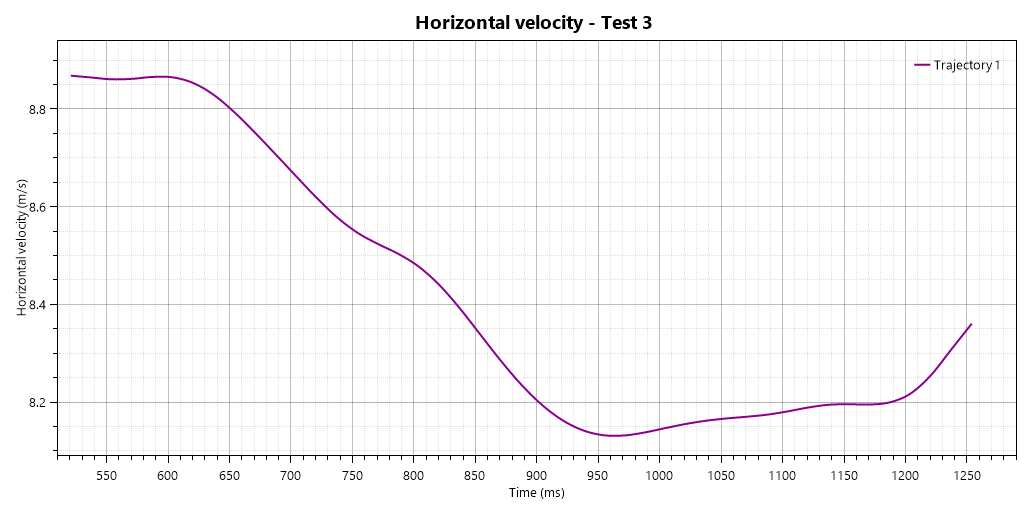
2024 E90 work/Testing Videos - Speed/Test 2/Day2Test3-Speed.png
