JeffreyLiang3449/HFCV-Website/Chassis/Drawings/Carbon Fiber Sheet Dimensions and Quantities.pdf

Carbon | Fiber Sheet | Pieces | + | Dimensions | Legend
| | | | | Dimensions (in .

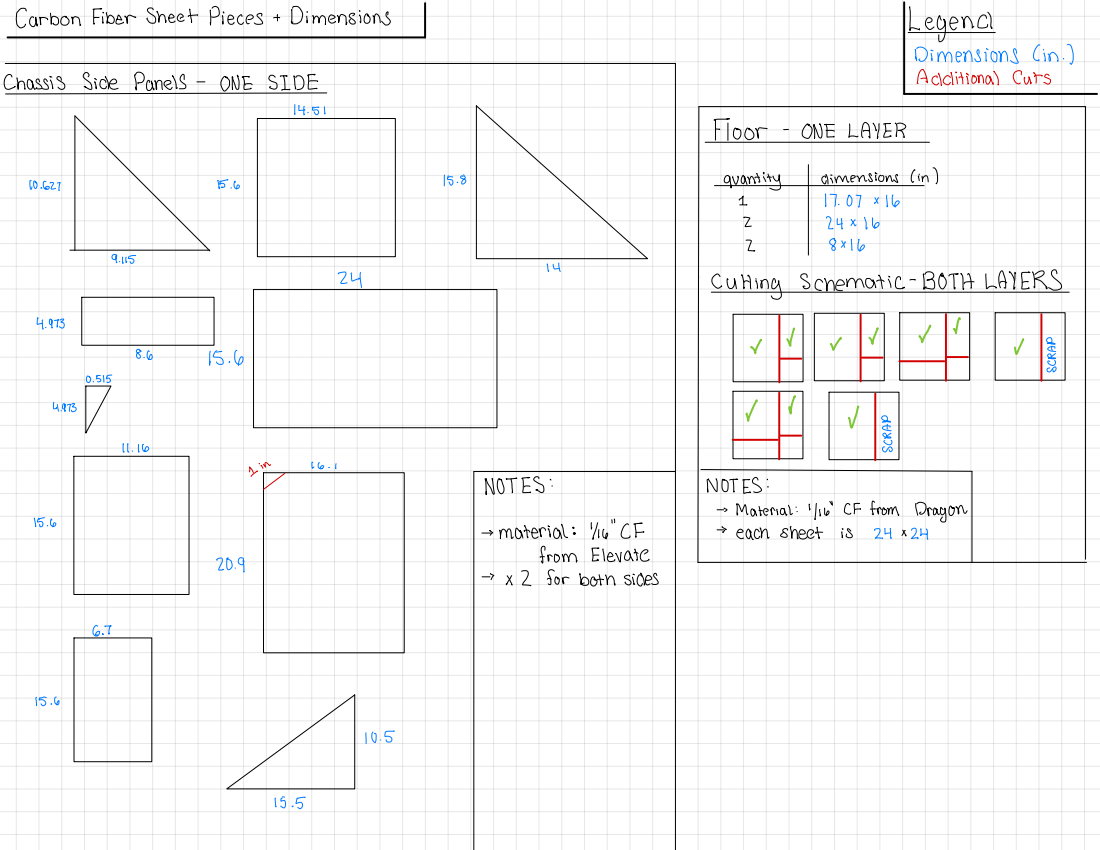
[picture p350: page 1]
Chassis Side; Panels; ONE; SIDE; Additional Cuts; oor; LAYER; quantity; dimensions; Cutting; Schematic-BOTH LAYERS; NOTES :; Material :; CF from; Dragon 15 .; material :; each sheet; from; Elevate; for both sides
