JeffreyLiang3449/HFCV-Website/Chassis/Drawings/Rear Connector Dimensions and Quantities.pdf

Connector | Dimensions | Legend Quantity

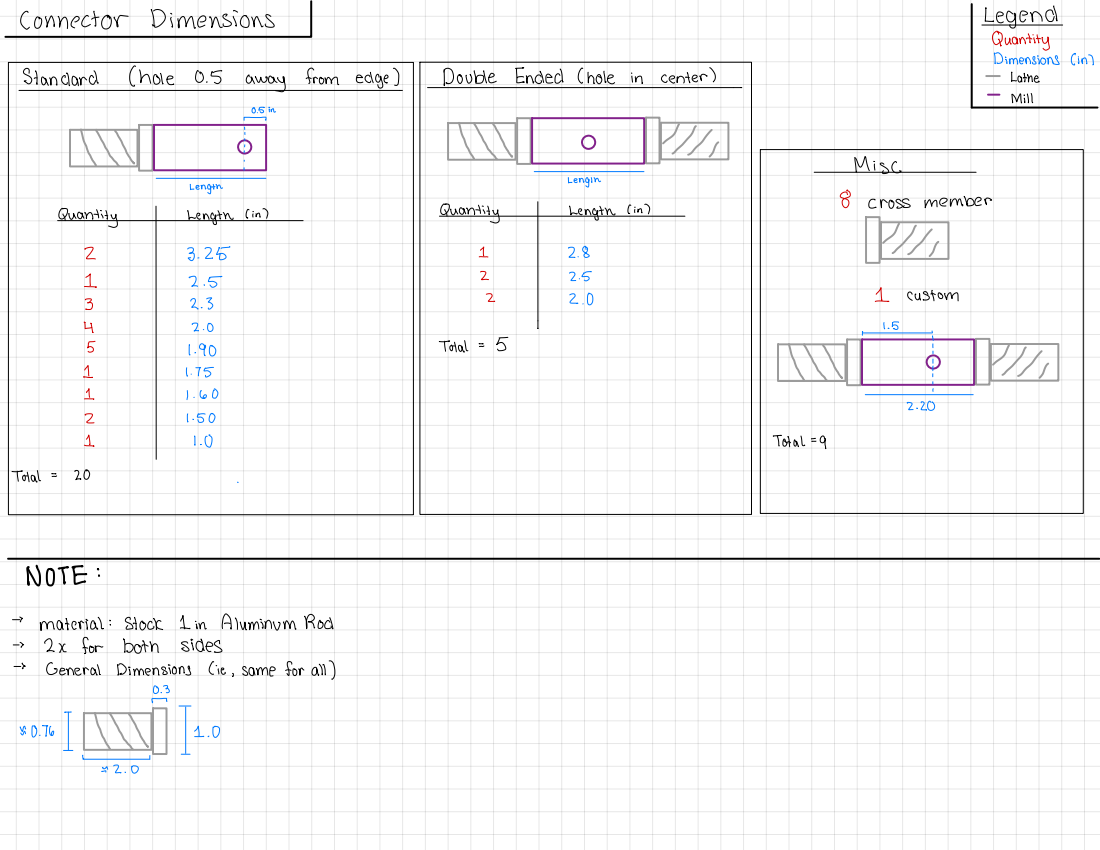
[picture p351: page 1]
Dimensions; Encard; Chole; center); Lathe; away; from; edgel; able; Ended (hole; Mill; III; MisC; Length; cross; member; Quantity; Sin); Total; NOTE; material; Stock; Aluminum Rob; 2x for; both; sides; General; same for; all) 0.
