JeffreyLiang3449/HFCV-Website/2025 E90 work/Designs/Suspension/Suspension Plate Drawing v1.pdf

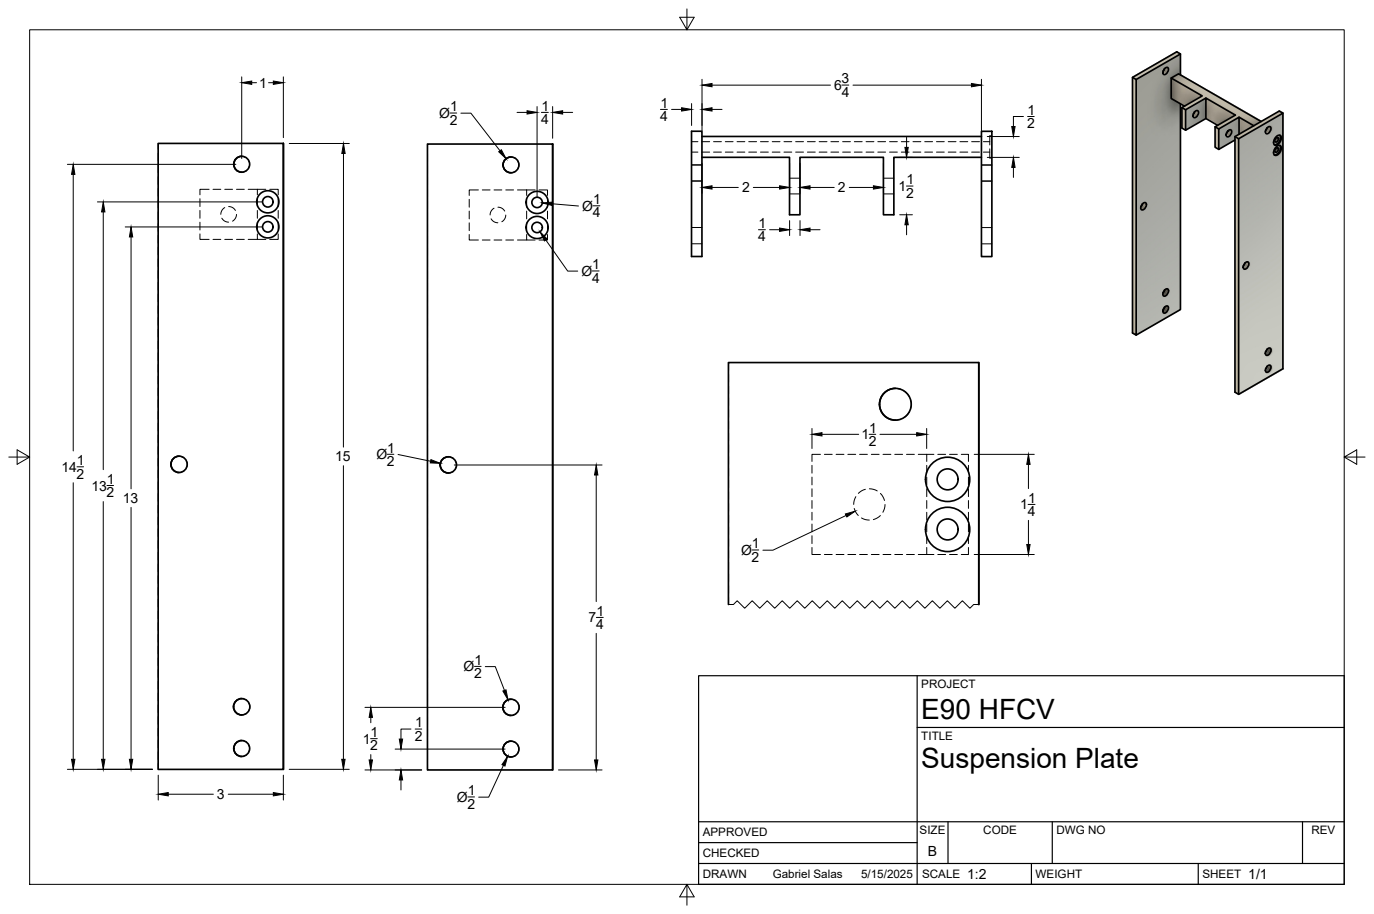
[picture p352: page 1]
SIZE; CODE; DWG NO; REV; Gabriel Salas; E90 HFCV; Suspension Plate
