JeffreyLiang3449/HFCV-Website/docs/Chassis/Drawings/Parts Implementation Drawing ROUGH.pdf

# Steering

## Battery

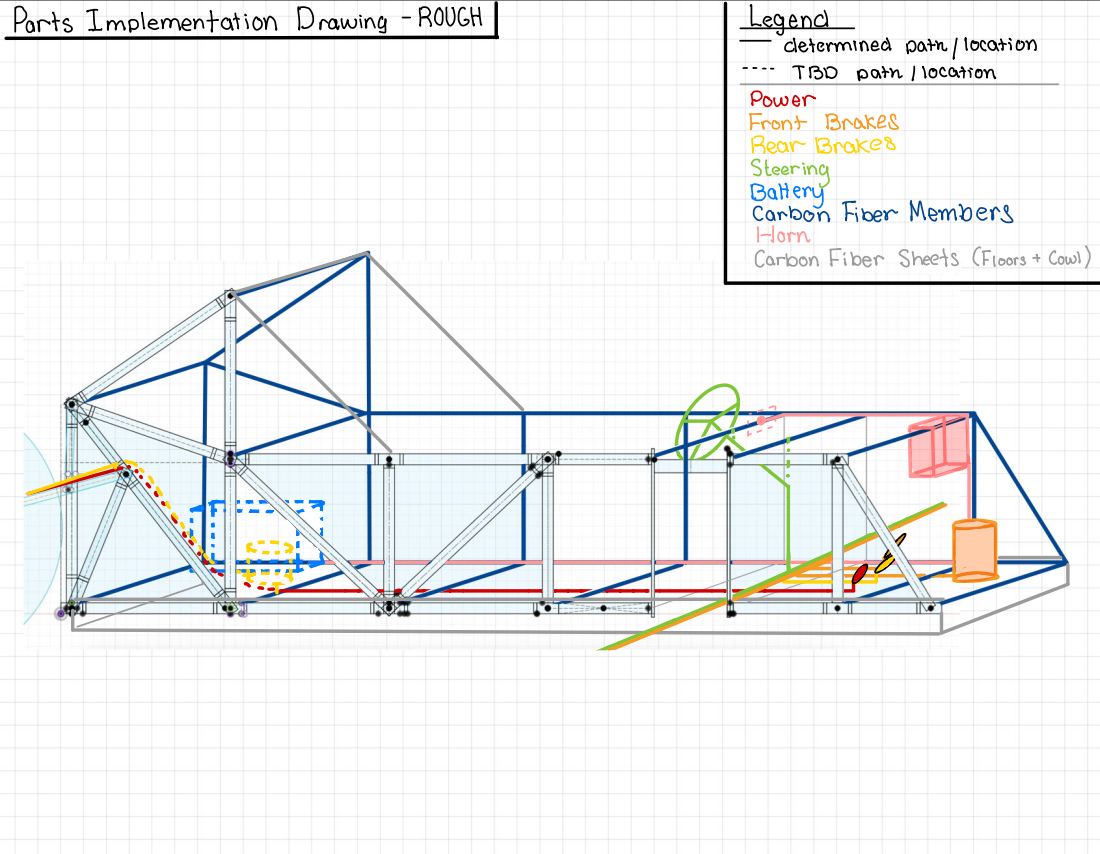
[picture p353: page 1]
-Arts Implementation Drawing ROUGH; Legend determined path/location ----; TBD; path/location; Power Front Brakes Rear Brakes ~

Carbon Fiber Members
Horn
Carbon Fiber Sheets (Floors + Cowl) ·
