JeffreyLiang3449/HFCV-Website/docs/Chassis/Drawings/Windshield Design ROUGH.pdf

↓ ⑰*

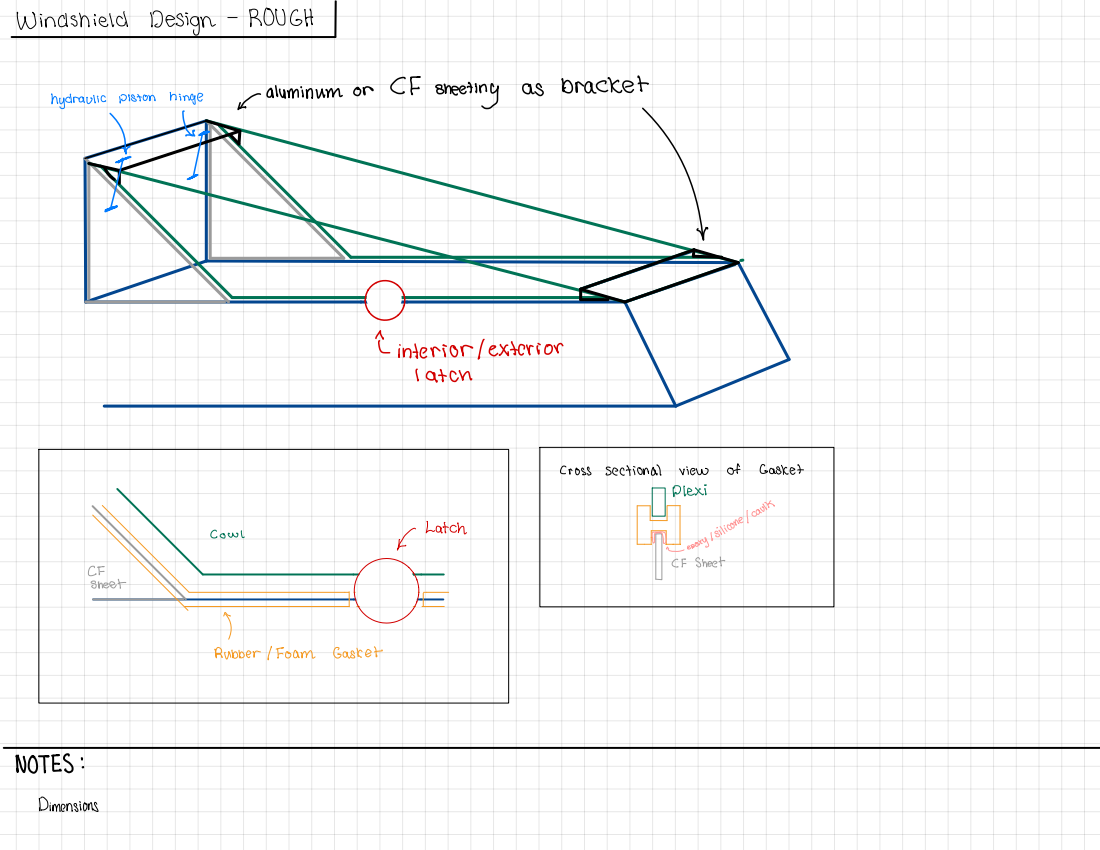
[picture p354: page 1]
Windshield; Design; ROUGH; hydraulic; piston; hingealuminum or; sheeting; bracket; interior/exterior; latch; Cross; Sectional; view; Gasket; Plexi; Cowl; Latch; CF Sneet; CF Sheet; NOTES :; Dimensions

&enoxy/silicone/cavik

Rubber/Foam Gasket
