JeffreyLiang3449/HFCV-Website/docs/2025 E90 work/Designs/Brake/Brake Stand Drawing v1.pdf

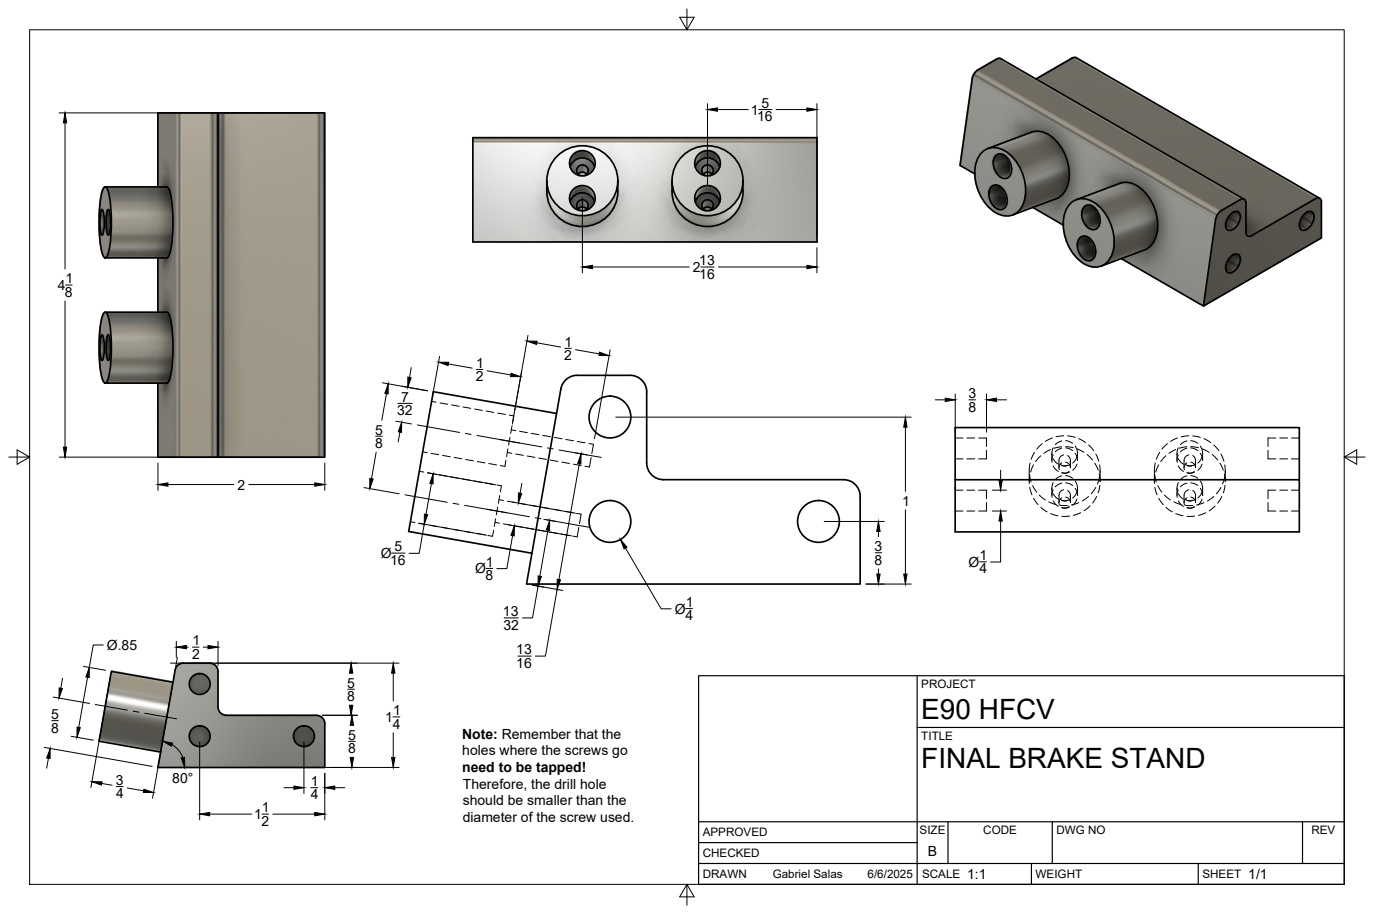
[picture p355: page 1]
SIZE; CODE; DWG NO; REV; Gabriel Salas

PROJECT
E90 HFCV
FINAL BRAKE STAND

Note: Remember that the
holes where the screws go
need to be tapped!
Therefore, the drill hole
should be smaller than the
diameter of the screw used.
