JeffreyLiang3449/HFCV-Website/docs/2025 E90 work/Designs/Brake/FINAL PEDAL DRAWING v3.pdf

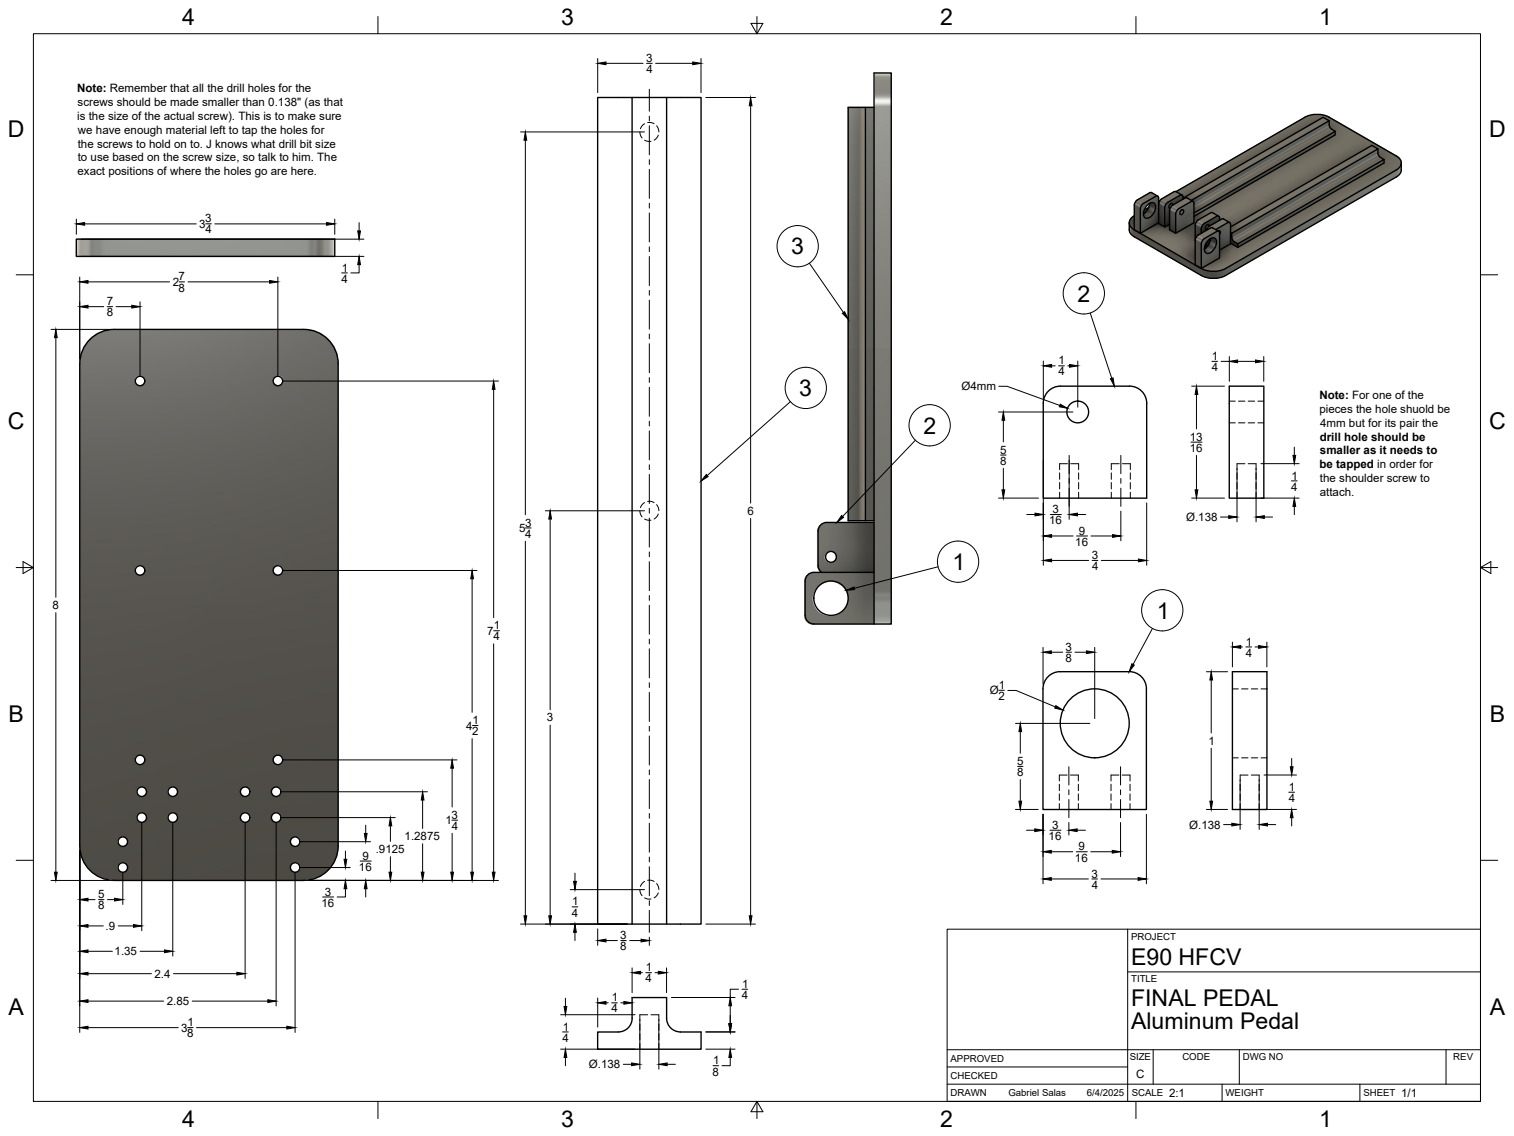
[picture p356: page 1]
BACD BACD; SIZE; CODE; DWG NO; REV; Gabriel Salas; E90 HFCV; Aluminum Pedal; FINAL PEDAL 2; attach. 3

Note: Remember that all the drill holes for the
screws should be made smaller than 0.138" (as that
is the size of the actual screw). This is to make sure
we have enough material left to tap the holes for
the screws to hold on to. J knows what drill bit size
to use based on the screw size, so talk to him. The
exact positions of where the holes go are here.

Note: For one of the
pieces the hole shuold be
4mm but for its pair the
drill hole should be
smaller as it needs to
be tapped in order for
the shoulder screw to
