JeffreyLiang3449/HFCV-Website/2025 E90 work/E90 Mid-Semester Presentation (GS, MM).pdf

# E90 Project:

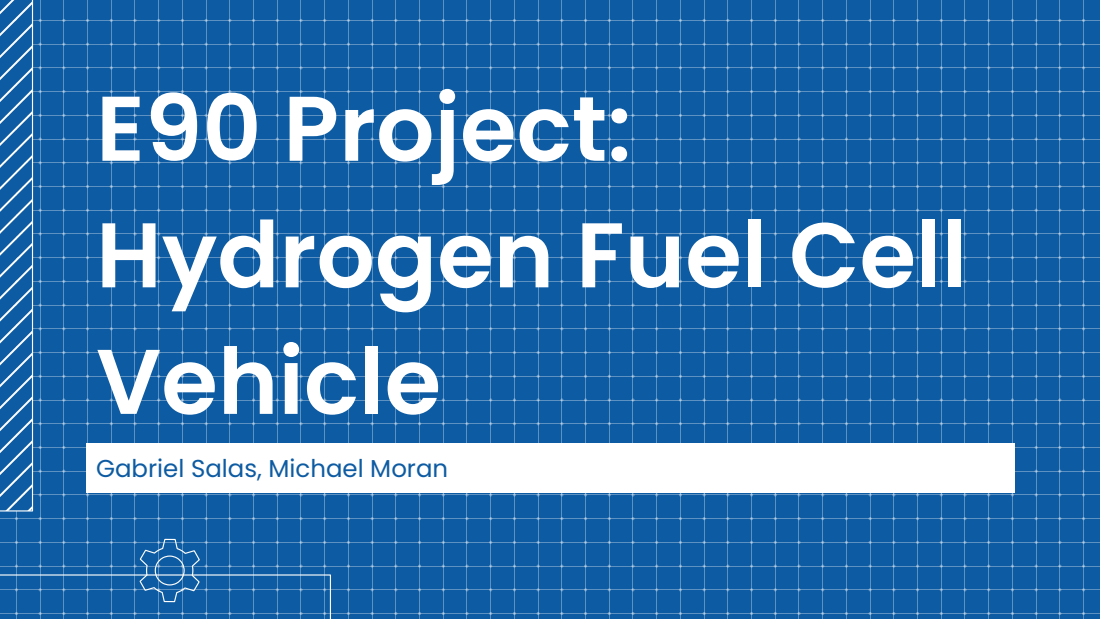
[picture p357: page 1]

Hydrogen Fuel Cell
Vehicle

Gabriel Salas, Michael Moran

# Table of Contents

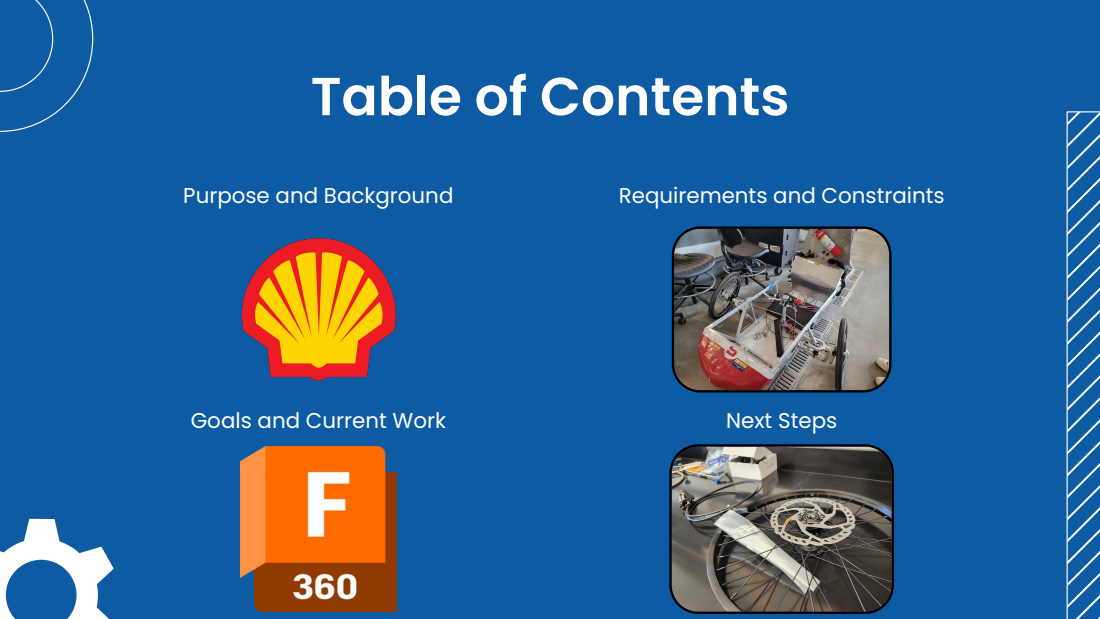
[picture p358: page 2]
Purpose and Background; Requirements and Constraints; Goals and Current Work; Next Steps

# PURPOSE

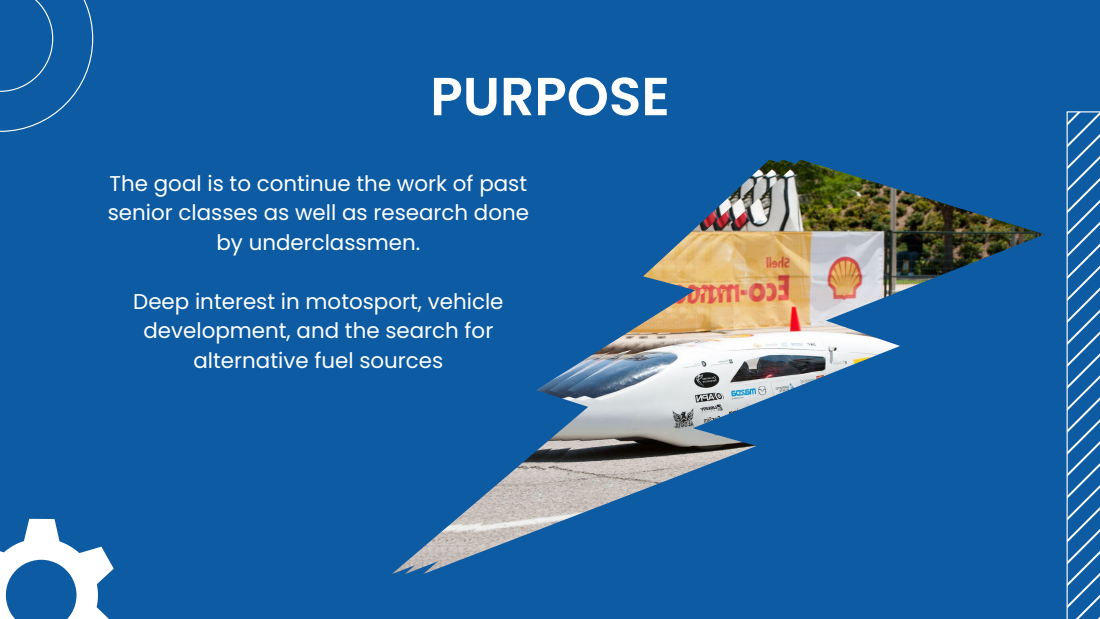
[picture p359: page 3]
by underclassmen.

The goal is to continue the work of past
senior classes as well as research done

Deep interest in motosport, vehicle
development, and the search for
alternative fuel sources

# REQUIREMENTS & CONSTRAINTS

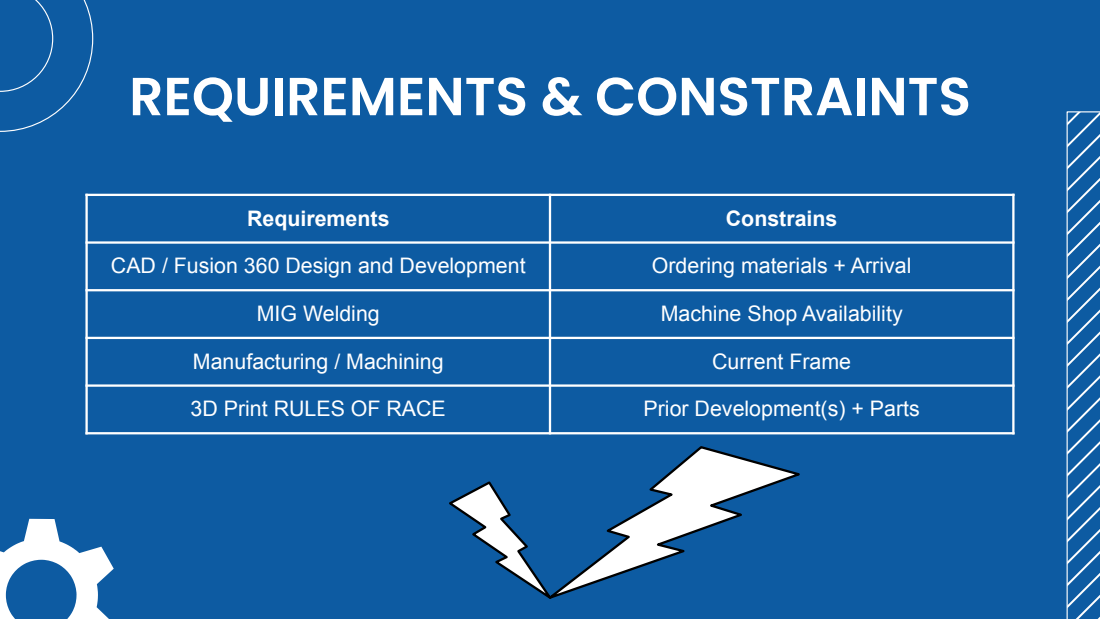
[picture p360: page 4]

Requirements | Constrains

CAD / Fusion 360 Design and Development | Ordering materials + Arrival

MIG Welding | Machine Shop Availability

Manufacturing / Machining | Current Frame

3D Print RULES OF RACE | Prior Development(s) + Parts

# CURRENT WORK

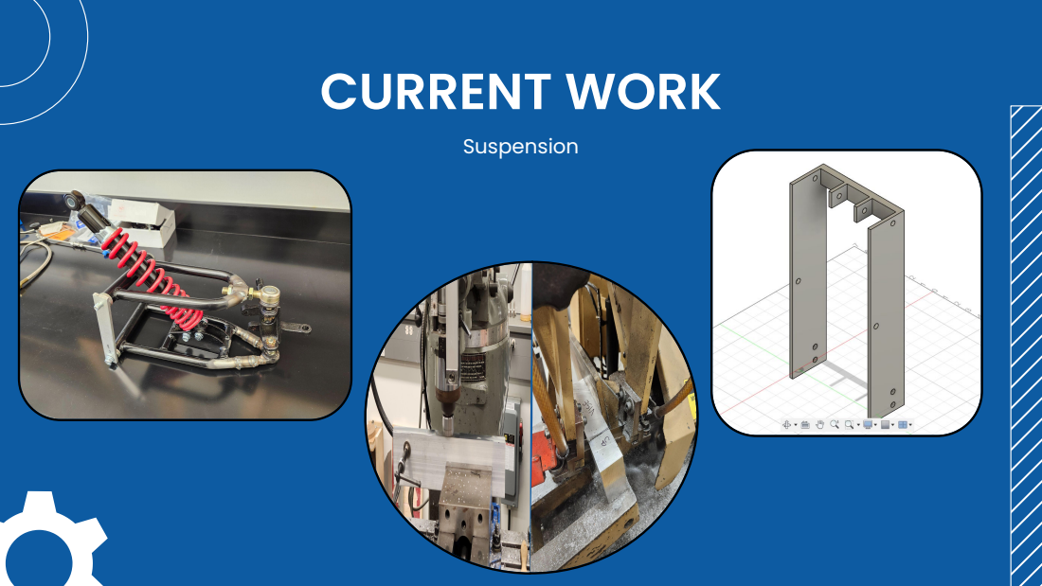
[picture p361: page 5]
Suspension

# CURRENT WORK

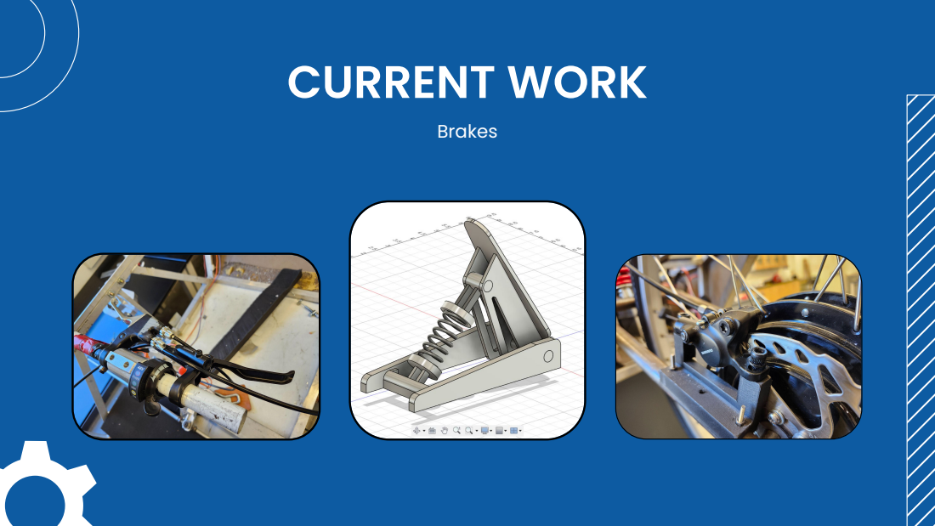
[picture p362: page 6]
Brakes

# CURRENT WORK

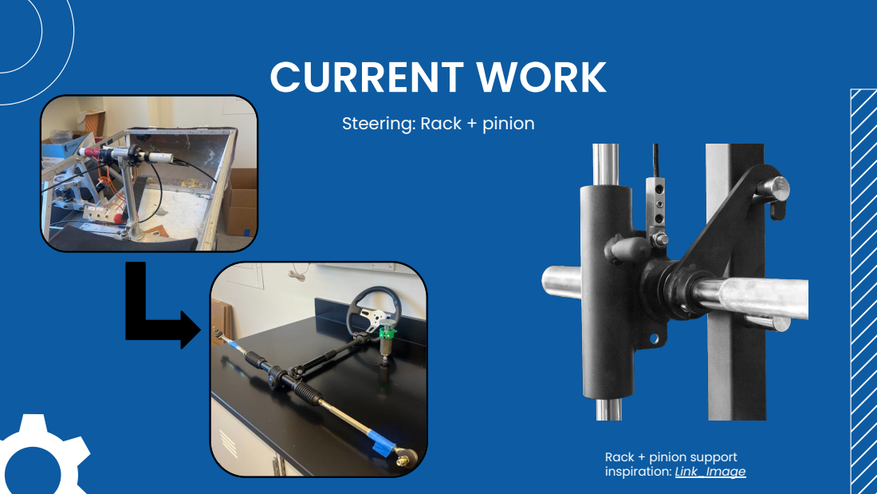
[picture p363: page 7]

Steering: Rack + pinion

Rack + pinion support
inspiration: Link_Image (https://www.renouffitnessequipment.com.au/product/functional-trainer-smith-machine-3/)

# CURRENT WORK

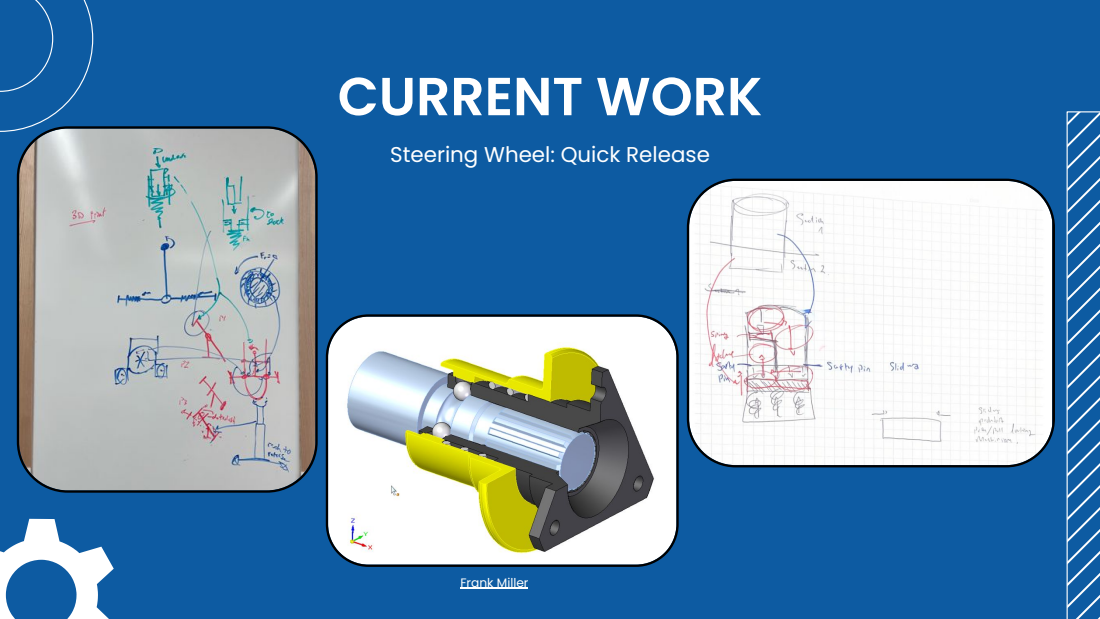
[picture p364: page 8]
Frank Miller

Steering Wheel: Quick Release

# NEXT STEPS

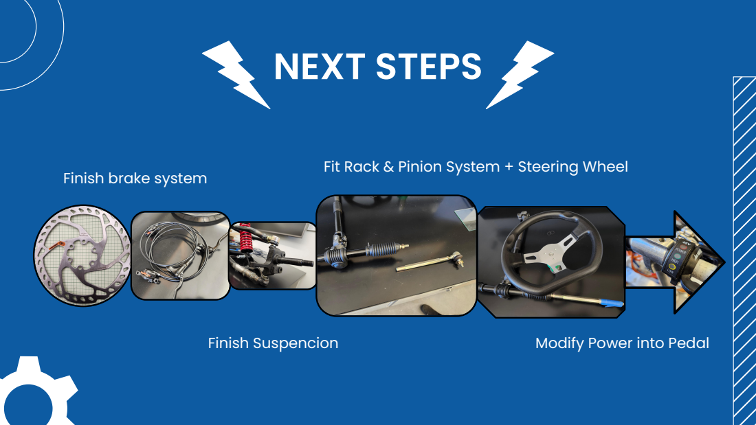
[picture p365: page 9]
Finish Suspencion

Fit Rack & Pinion System + Steering Wheel

Finish brake system

Modify Power into Pedal

# Questions?

Thank You
