JeffreyLiang3449/HFCV-Website/docs/2024 E90 work/E90 HFCV Final Presentation.pdf

# Hydrogen

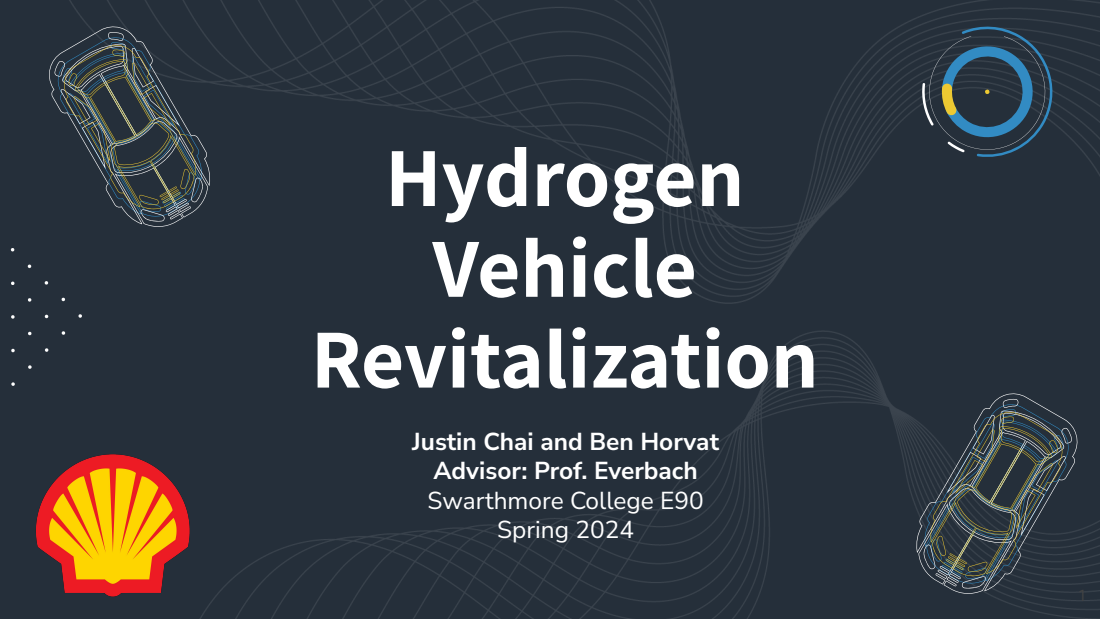
[picture p366: page 1]
Vehicle Revitalization

Justin Chai and Ben Horvat
Advisor: Prof. Everbach
Swarthmore College E90
Spring 2024

# That Thing In the

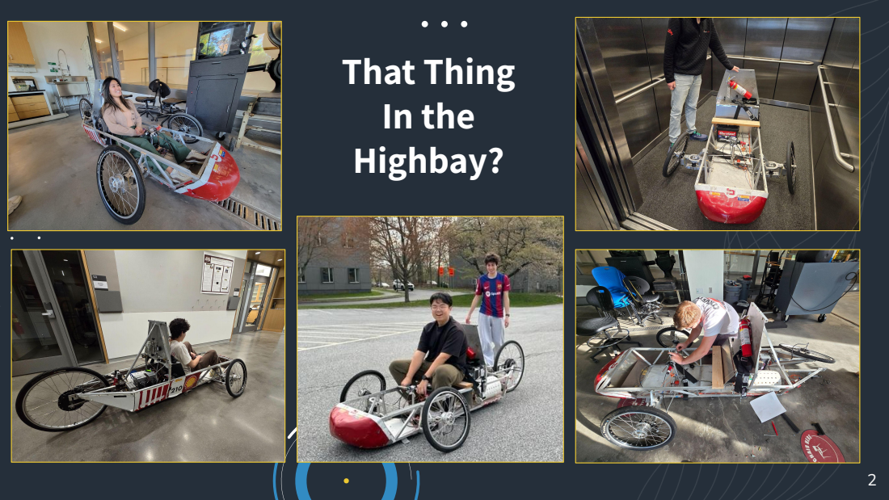
[picture p367: page 2]
Highbay?

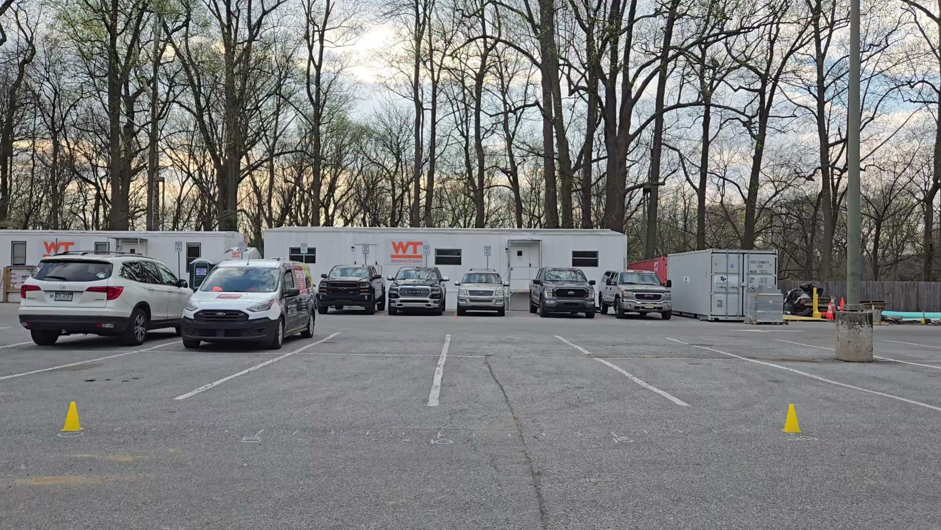
[picture p368: page 3]

# Shell Eco-Marathon

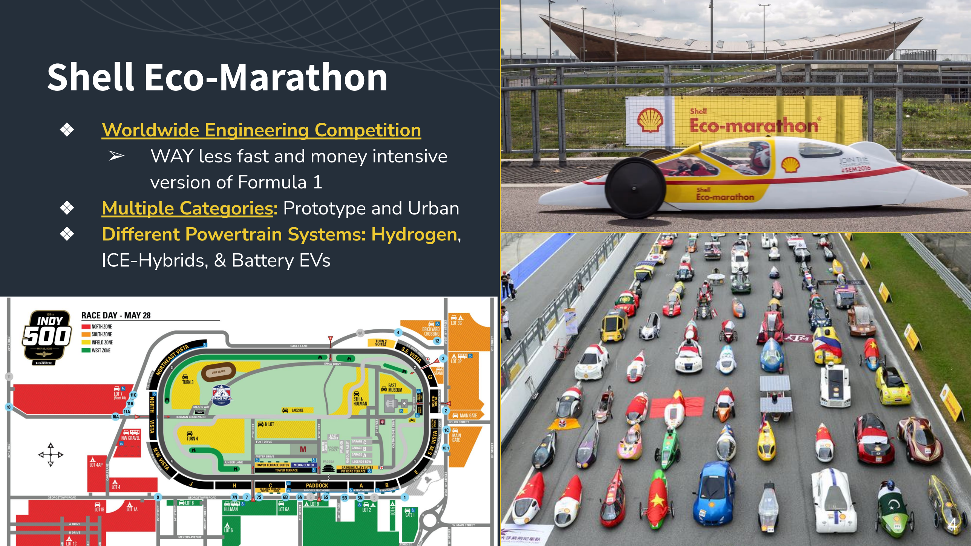
[picture p369: page 4]

❖ | Worldwide Engineering Competition
| ➢ WAY less fast and money intensive
| version of Formula 1
❖ | Multiple Categories: Prototype and Urban
❖ | Different Powertrain Systems: Hydrogen,
| ICE-Hybrids, & Battery EVs

# Why Did We Do This As an E90?

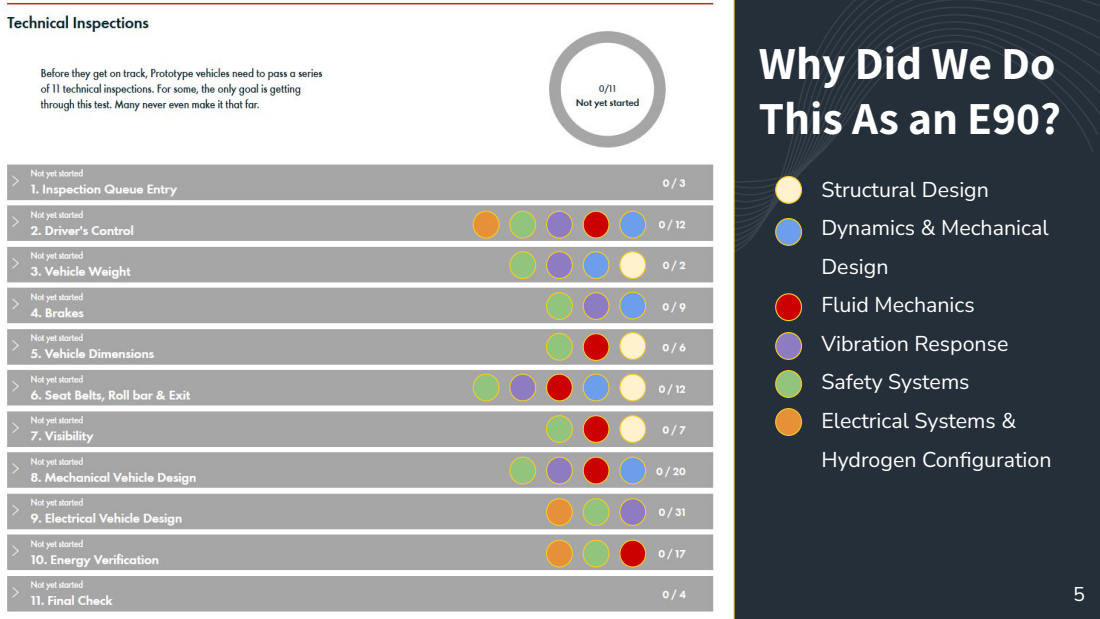
[picture p370: page 5]
● Structural Design ● Dynamics & Mechanical Design ● Fluid Mechanics ● Vibration Response ● Safety Systems ● Electrical Systems & Hydrogen Configuration

# Prior Vehicles and

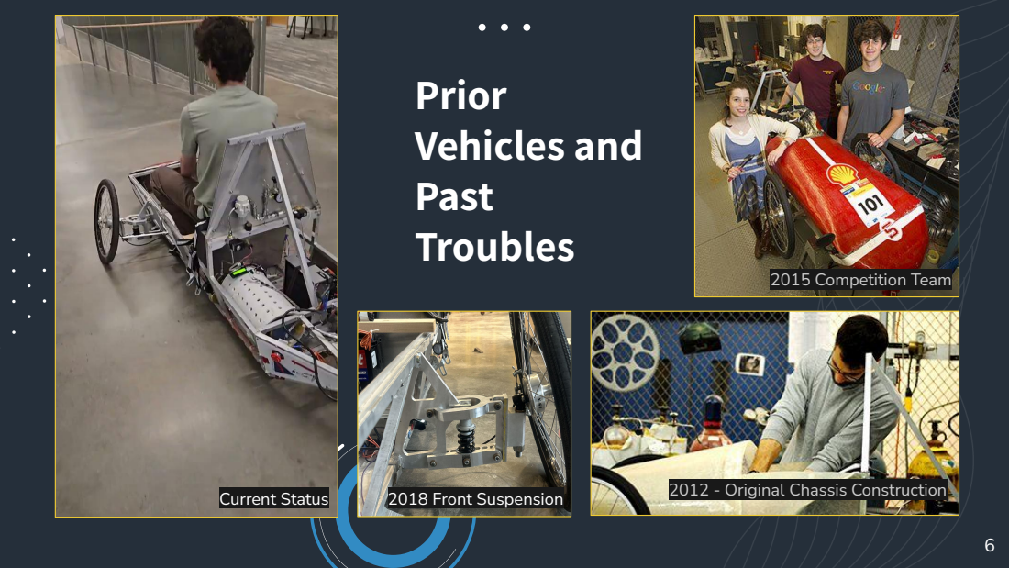
[picture p371: page 6]
Past Troubles; 2015 Competition Team; 2012 - Original Chassis Construction Current Status; 2018 Front Suspension

# 2018 and 2024 are different times

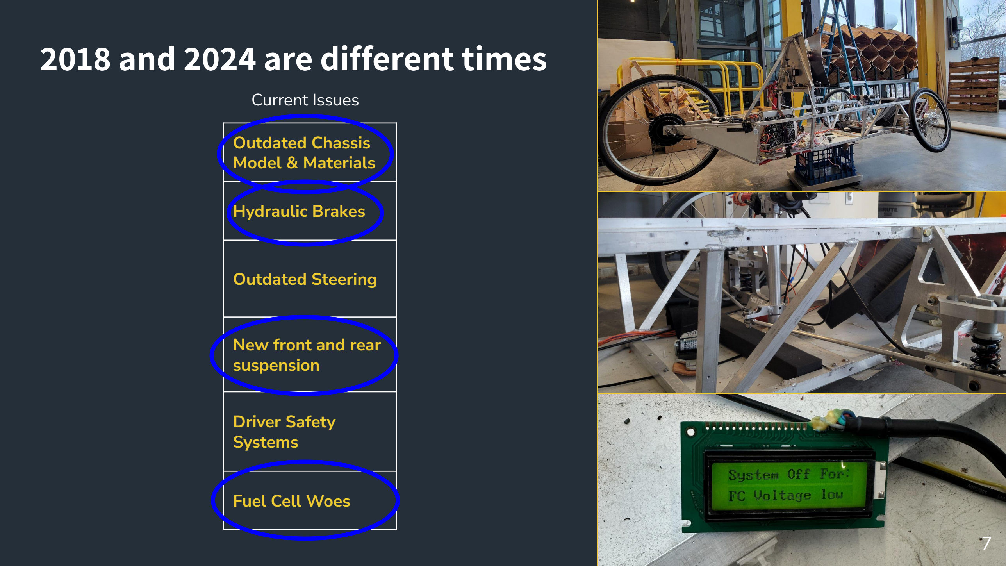
[picture p372: page 7]

Outdated Chassis
Model & Materials

Hydraulic Brakes

Outdated Steering

New front and rear
suspension

Driver Safety
Systems

Fuel Cell Woes

Current Issues

01

## FROM

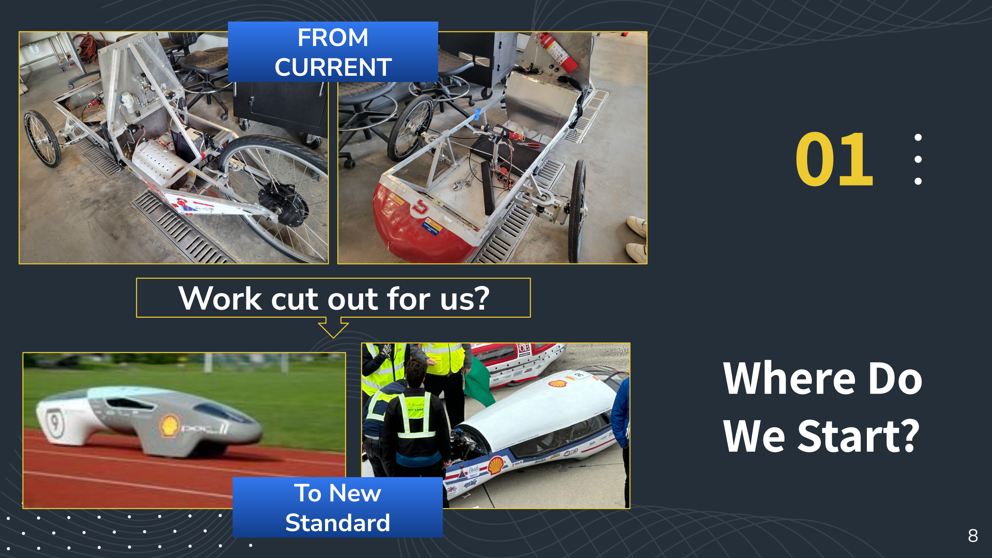
[picture p373: page 8]

# Where Do We Start?

# Work cut out for us?

## CURRENT

## To New

Standard | 8

# Fuel Efficiency is King!

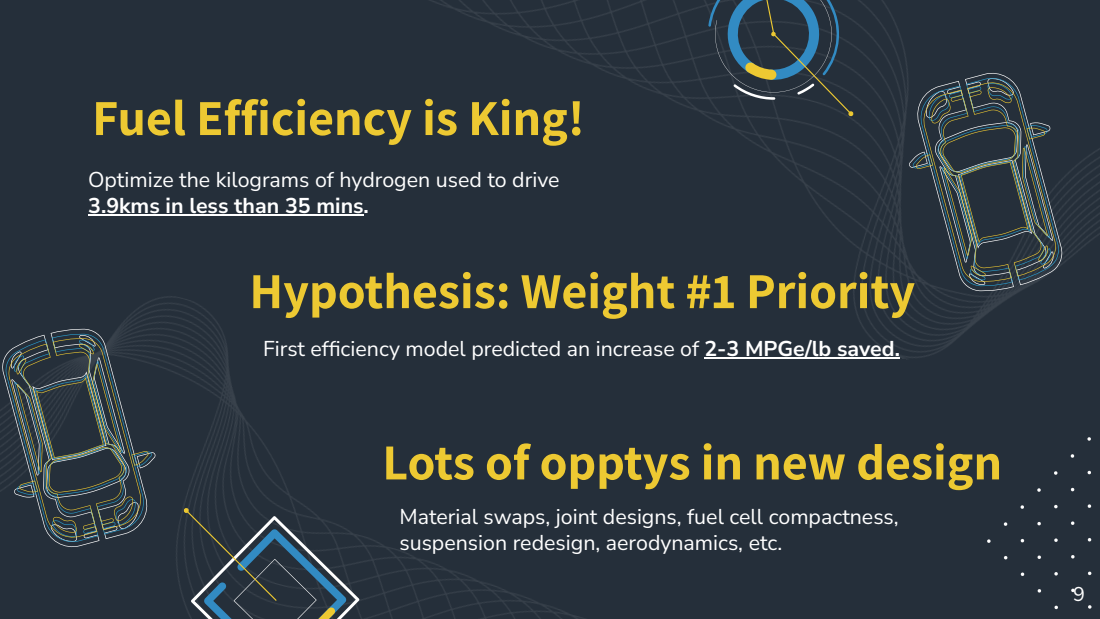
[picture p374: page 9]

Optimize the kilograms of hydrogen used to drive
3.9kms in less than 35 mins.
Hypothesis: Weight #1 Priority

First efficiency model predicted an increase of 2-3 MPGe/lb saved.
Lots of opptys in new design

Material swaps, joint designs, fuel cell compactness,
suspension redesign, aerodynamics, etc.

# Designing the Best Implementation Order

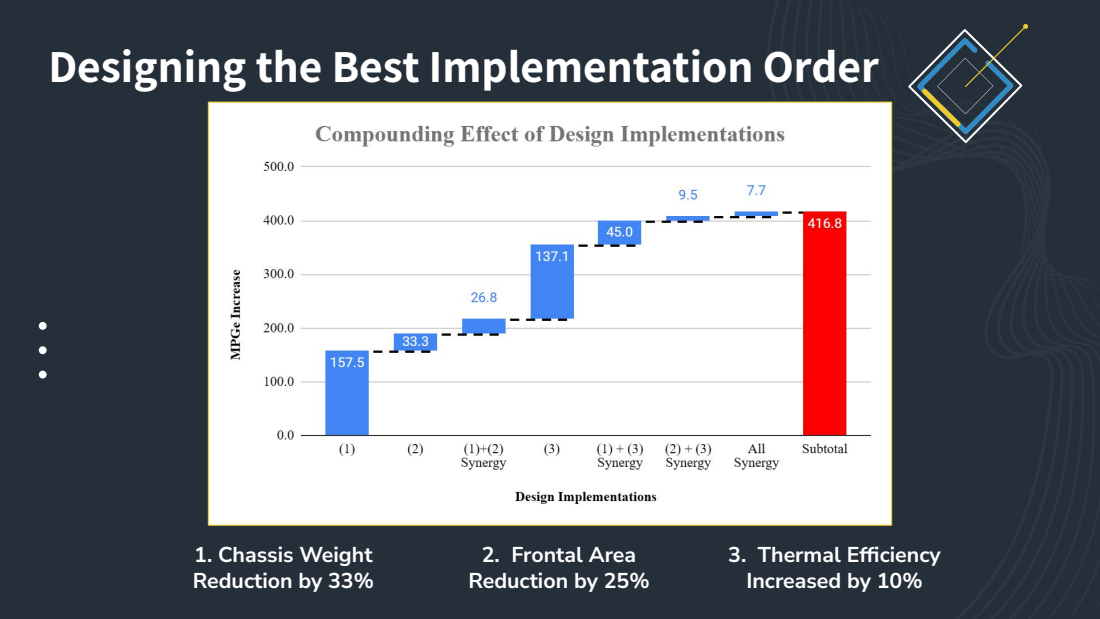
[picture p375: page 10]
1. Chassis Weight Reduction by 33%; 2. Frontal Area Reduction by 25%; 3. Thermal Efficiency Increased by 10%

# What material makes the most sense?

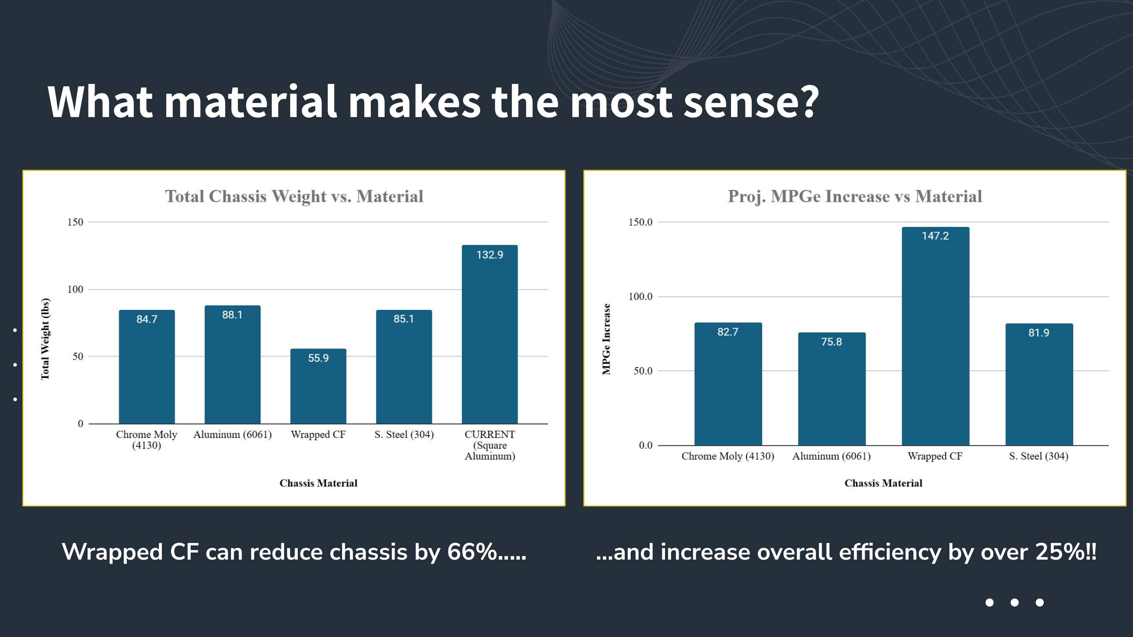
[picture p376: page 11]

Wrapped CF can reduce chassis by 66%..... …and increase overall efficiency by over 25%!!

02:

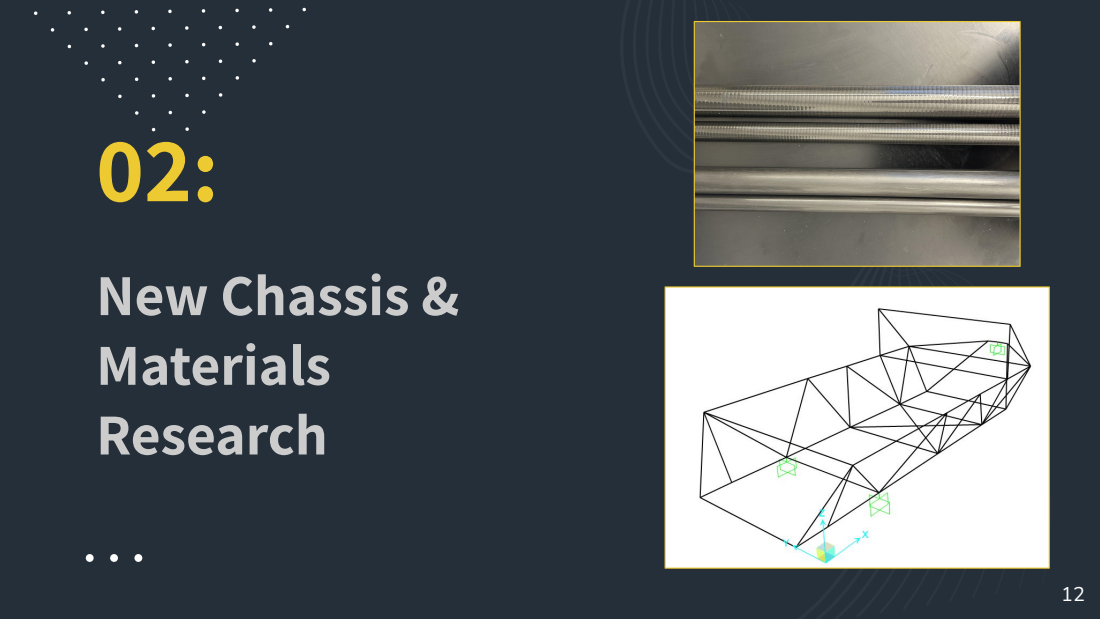
[picture p377: page 12]
New Chassis & Materials Research

# SAP Model

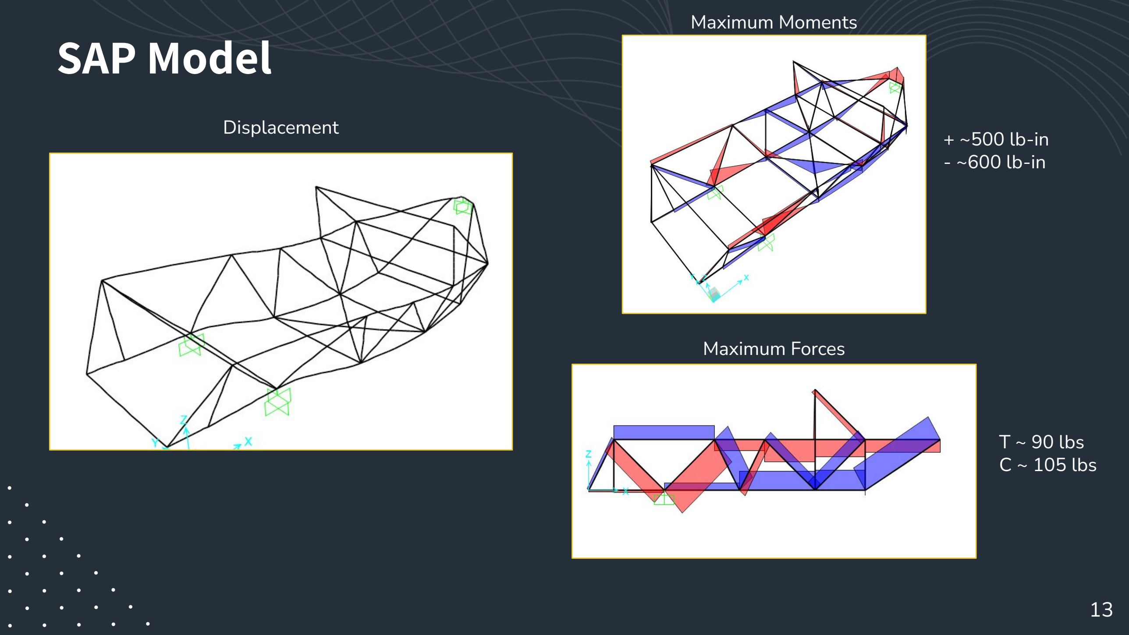
[picture p378: page 13]

Maximum Moments

Maximum Forces

Displacement | + ~500 lb-in
- ~600 lb-in

T ~ 90 lbs
C ~ 105 lbs

# Connection Methods: Carbon Fiber Tubes

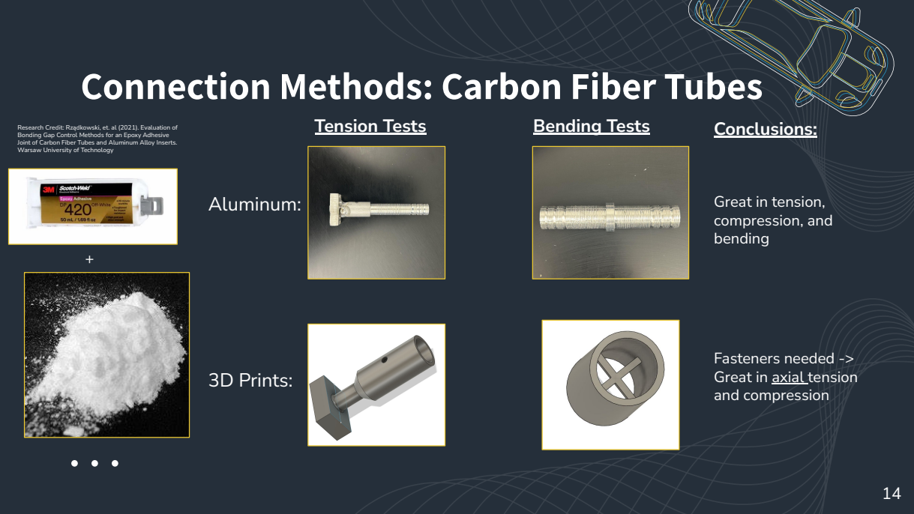
[picture p379: page 14]
Aluminum:; 3D Prints:; Tension Tests; Bending Tests; Conclusions:

Research Credit: Rządkowski, et. al (2021). Evaluation of
Bonding Gap Control Methods for an Epoxy Adhesive
Joint of Carbon Fiber Tubes and Aluminum Alloy Inserts.
Warsaw University of Technology

Great in tension,
compression, and
bending

Fasteners needed ->
Great in axial tension
and compression

# Tension Tests

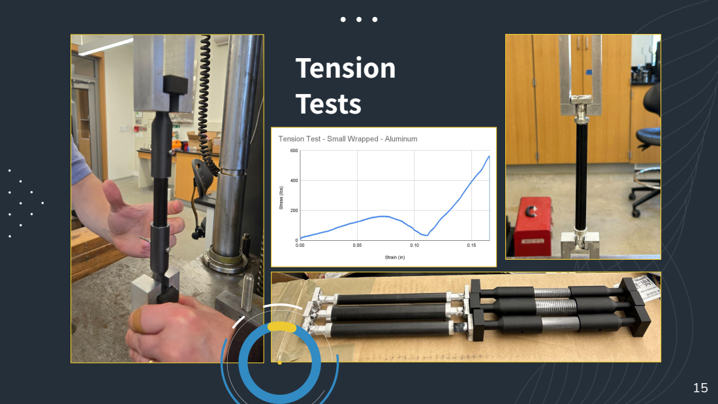
[picture p380: page 15]

# Tension Test Results

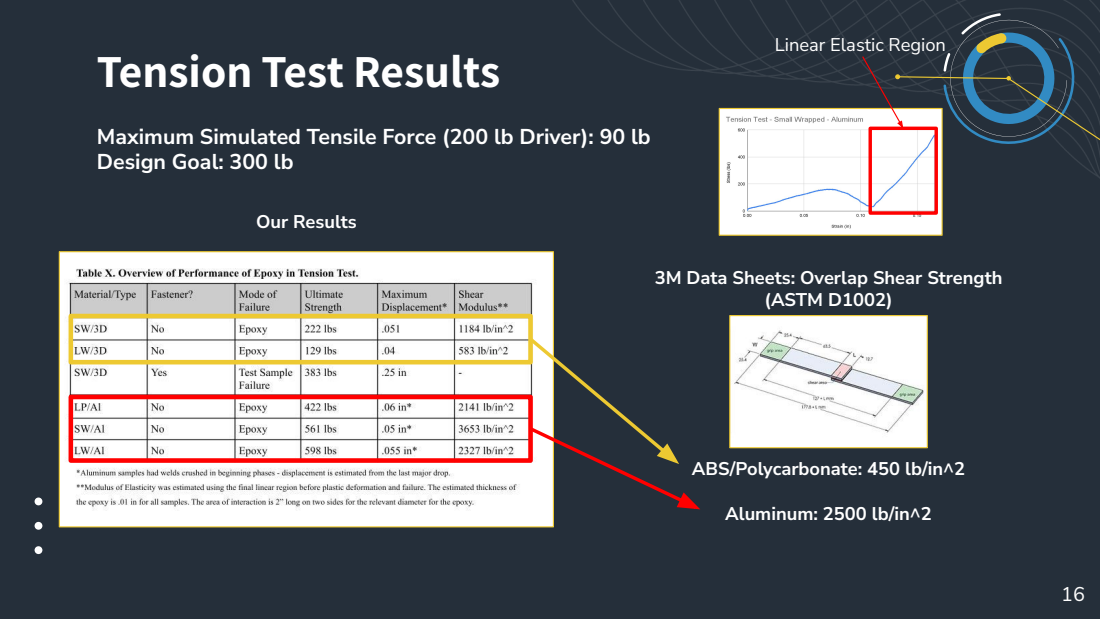
[picture p381: page 16]
Our Results; (ASTM D1002)

Linear Elastic Region

Maximum Simulated Tensile Force (200 lb Driver): 90 lb
Design Goal: 300 lb

3M Data Sheets: Overlap Shear Strength

ABS/Polycarbonate: 450 lb/in^2

Aluminum: 2500 lb/in^2

# Bending Results - On Joint

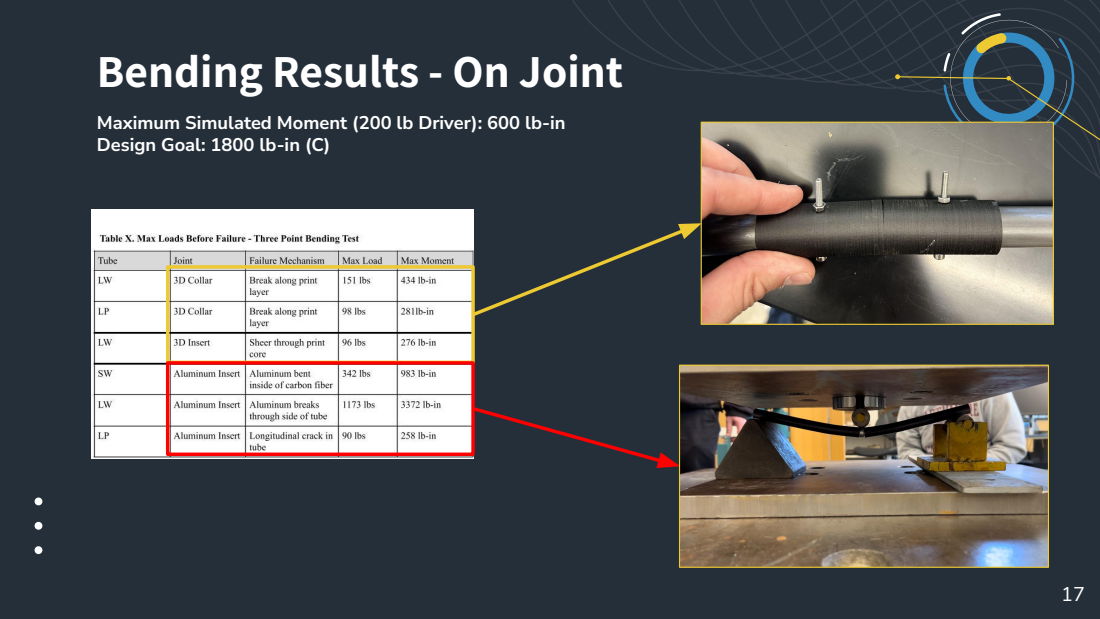
[picture p382: page 17]

Maximum Simulated Moment (200 lb Driver): 600 lb-in

Design Goal: 1800 lb-in (C)

# Costs of Weight Reduction & Efficiency Gain

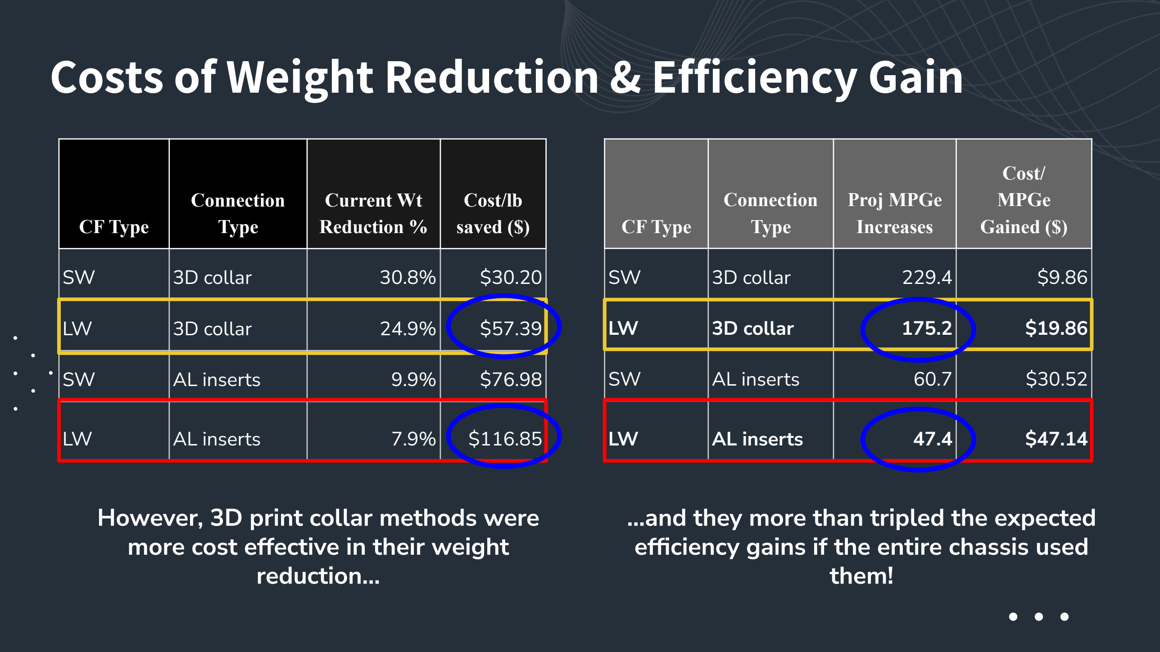
[picture p383: page 18]

CF Type

Connection
Type

Current Wt
Reduction %

Cost/lb
saved ($)
SW | 3D collar | 30.8% | $30.20
LW | 3D collar | 24.9% | $57.39
SW | AL inserts | 9.9% | $76.98
LW | AL inserts | 7.9% | $116.85

CF Type

Connection
Type

Proj MPGe
Increases

Cost/
MPGe
Gained ($)
SW | 3D collar | 229.4 | $9.86
LW | 3D collar | 175.2 | $19.86
SW | AL inserts | 60.7 | $30.52
LW | AL inserts | 47.4 | $47.14

### However, 3D print collar methods were more cost effective in their weight reduction…

### …and they more than tripled the expected efficiency gains if the entire chassis used them!

# A Combination of Inserts & Collars

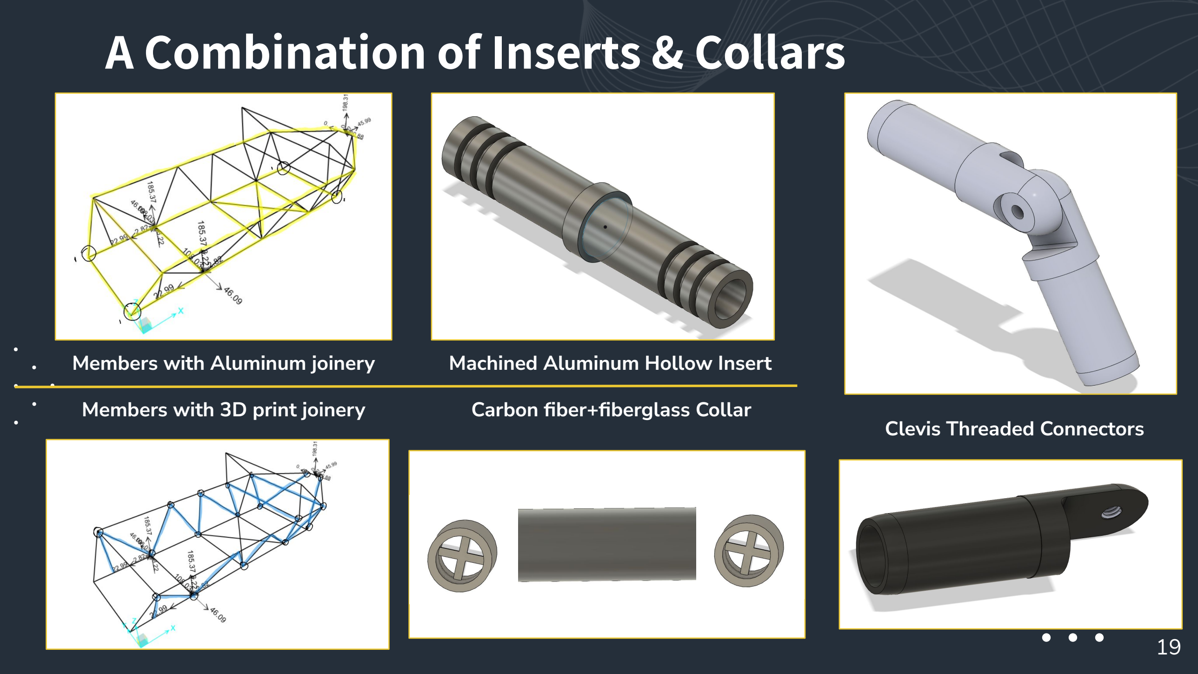
[picture p384: page 19]

Connector
pieces
Members with 3D print joinery | Carbon fiber+fiberglass Collar
Members with Aluminum joinery | Machined Aluminum Hollow Insert

Clevis Threaded Connectors

03:

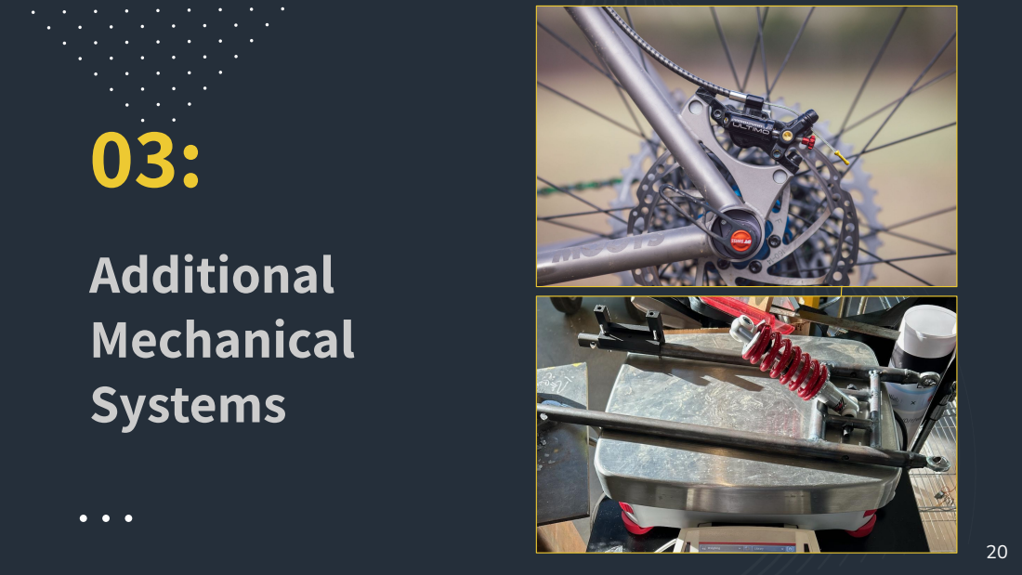
[picture p385: page 20]
Additional Mechanical Systems

# Suspension Design, Fabrication, and Install

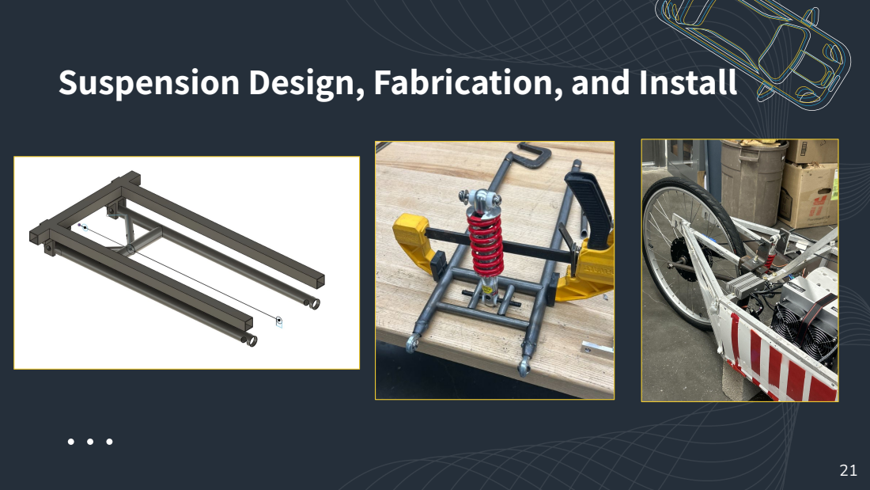
[picture p386: page 21]

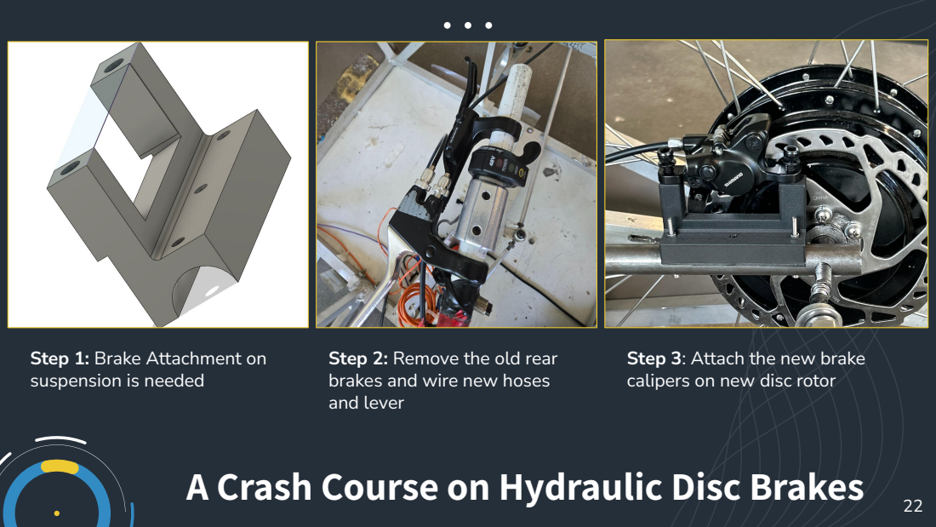
[picture p387: page 22]
A Crash Course on Hydraulic Disc Brakes

Step 1: Brake Attachment on
suspension is needed

Step 2: Remove the old rear
brakes and wire new hoses
and lever

Step 3: Attach the new brake
calipers on new disc rotor

04:

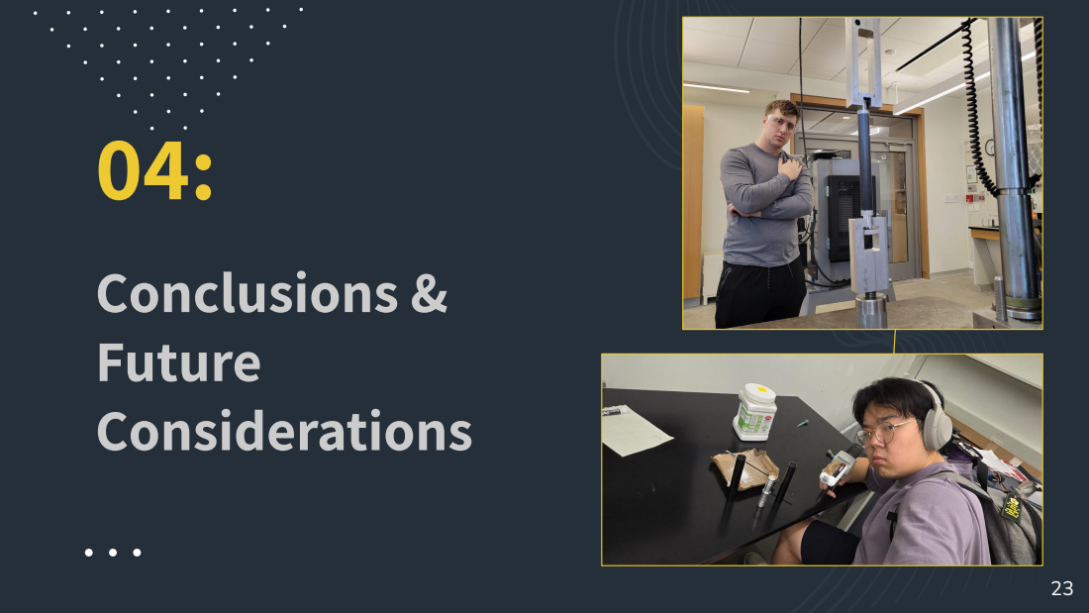
[picture p388: page 23]
Conclusions & Future Considerations

# The Playbook for the Future

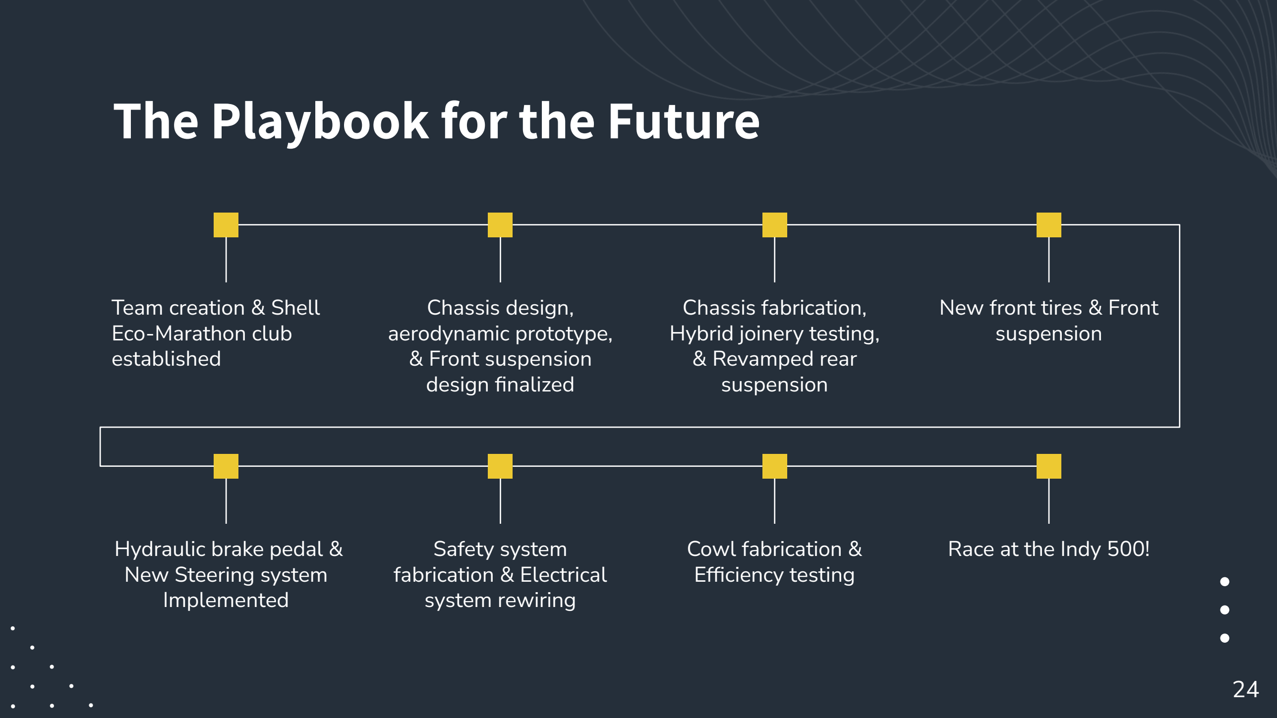
[picture p389: page 24]

Team creation & Shell
Eco-Marathon club
established

Chassis design,
aerodynamic prototype,
& Front suspension
design finalized

Chassis fabrication,
Hybrid joinery testing,
& Revamped rear
suspension

New front tires & Front
suspension

Hydraulic brake pedal &
New Steering system
Implemented

Safety system
fabrication & Electrical
system rewiring

Cowl fabrication &
Efficiency testing

Race at the Indy 500!

# Acknowledgments & Reflections

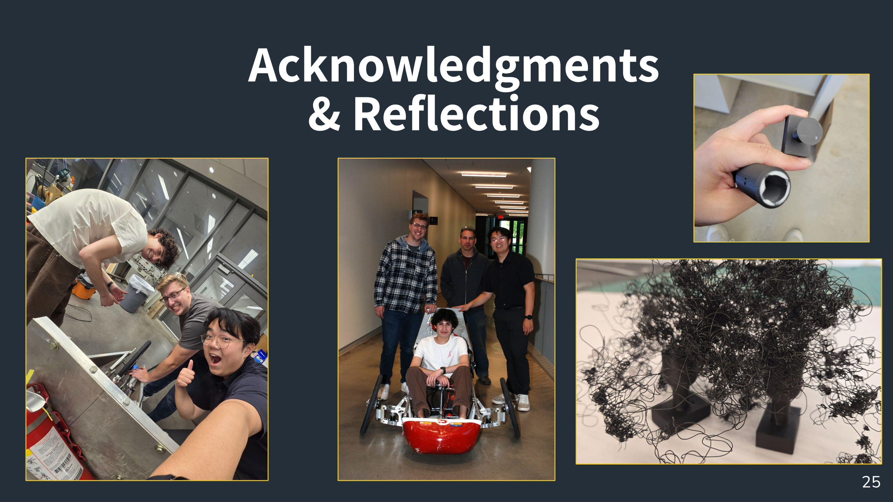
[picture p390: page 25]

# Thanks!

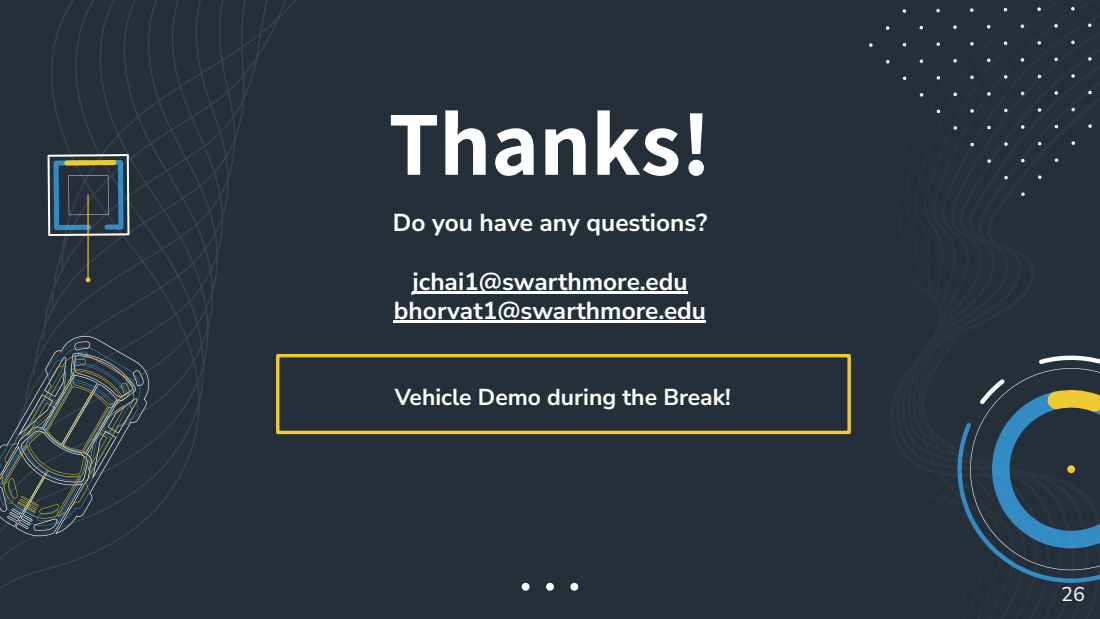
[picture p391: page 26]
bhorvat1@swarthmore.edu

Do you have any questions?
jchai1@swarthmore.edu

Vehicle Demo during the Break!

CREDITS: This presentation template was created by Slidesgo, (https://bit.ly/3A1uf1Q) and includes

icons by Flaticon, (http://bit.ly/2TyoMsr) and infographics & images by Freepik (http://bit.ly/2TtBDfr)

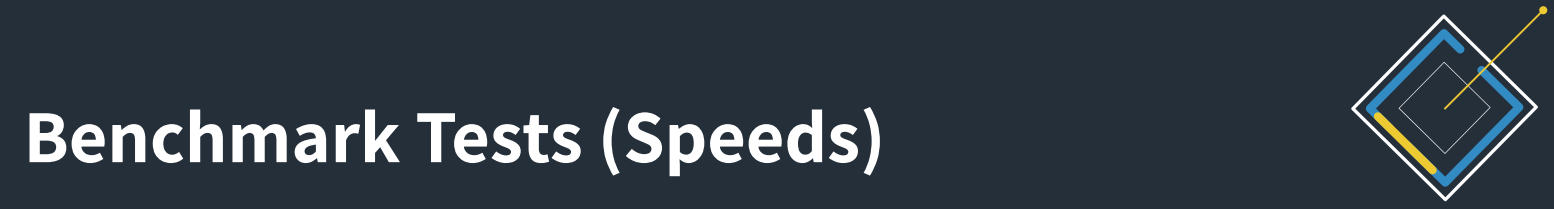
[picture p392: figure]
Benchmark Tests (Speeds)
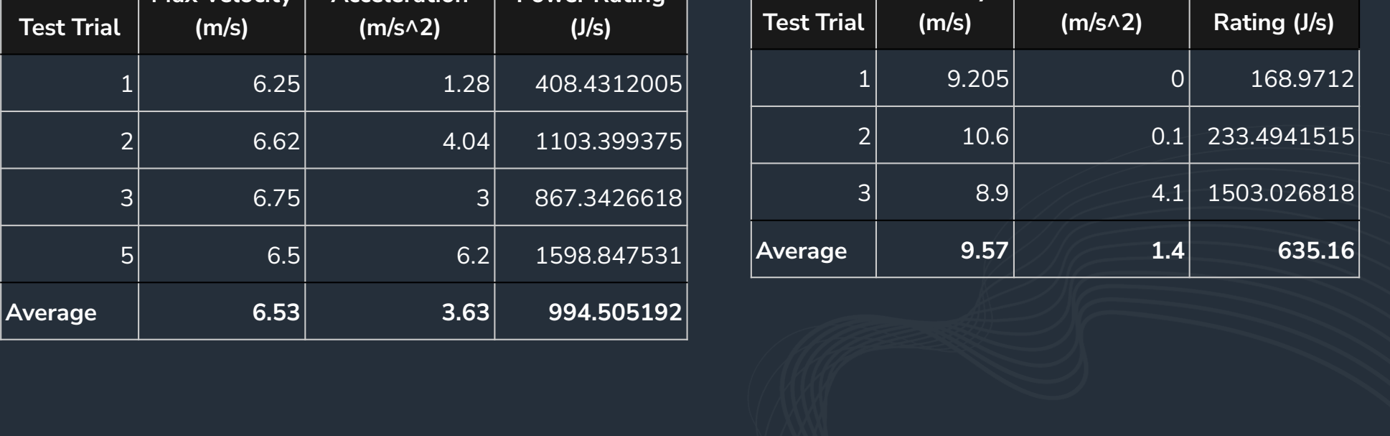
[picture p393: figure]
Test Trial; Average; Rating (J/s)

Max Velocity

Max
Acceleration

Estimated
Power Rating

Inside Benchmark Speed Tests with a power error margin of 0.55%

Max
Velocity

Max
Acceleration

Estimated
Power

Outside Benchmark Speed Tests with a power error margin of 36,48%

# Fuel Cell Renewal & Feasibility Assessment

## How does a HFCV work?

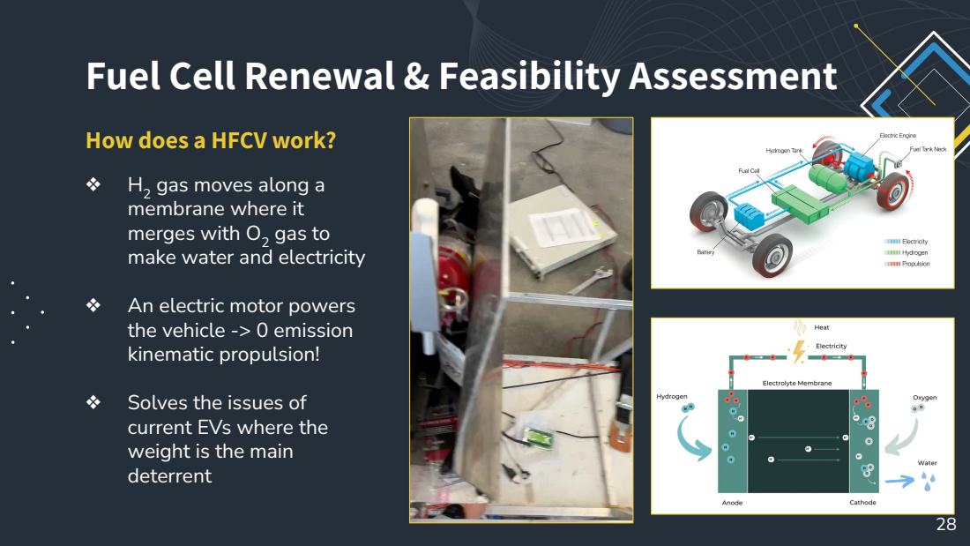
[picture p394: page 28]
gas to; An electric motor powers; Solves the issues of

membrane where it
merges with O2
make water and electricity
the vehicle -> 0 emission
kinematic propulsion!
current EVs where the
weight is the main
deterrent

gas moves along a

# Efficiency and Kinematics Simulation

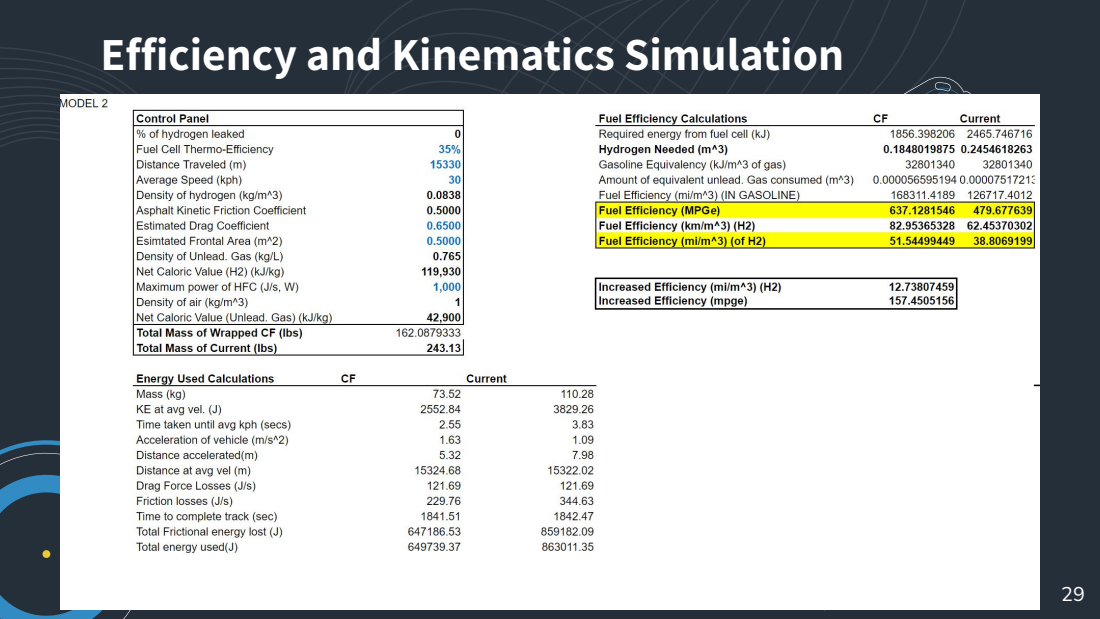
[picture p395: page 29]
