JeffreyLiang3449/HFCV-Website/docs/2024 Summer Research/Chassis Sketches.pdf

T
&"

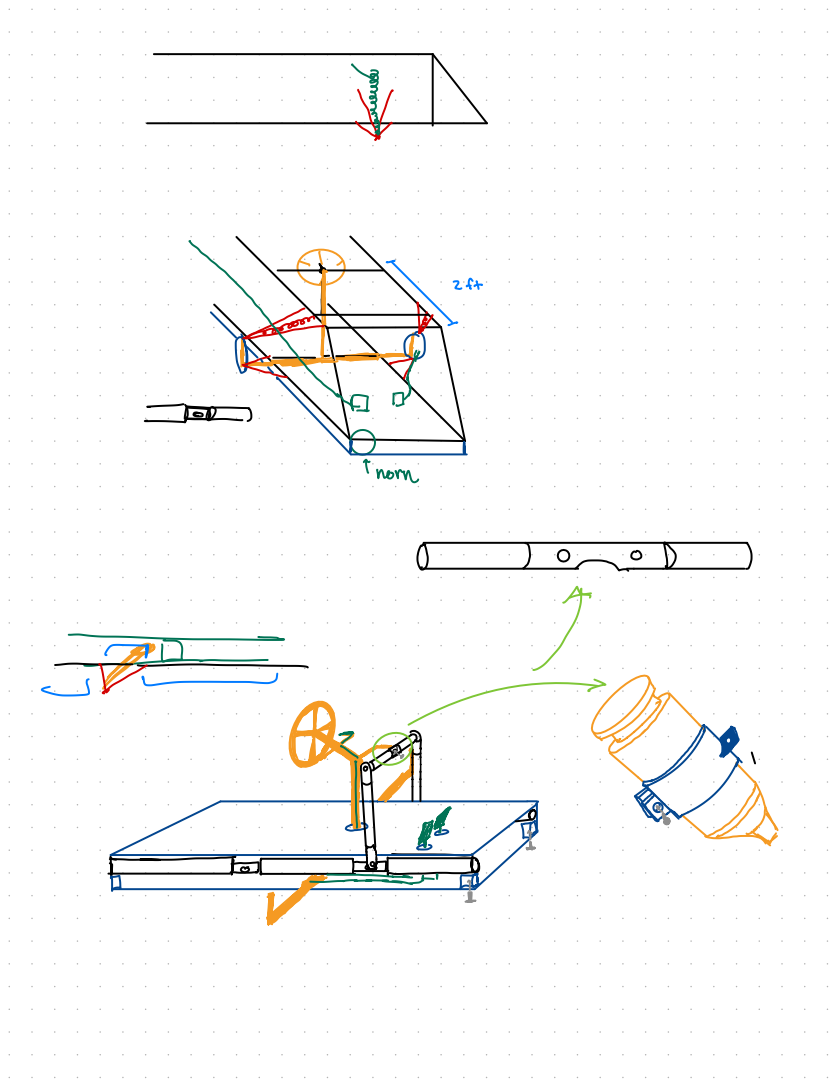
[picture p396: page 1]
"Tworn I; LoD)

Connection | Quantity Needed
# | 2

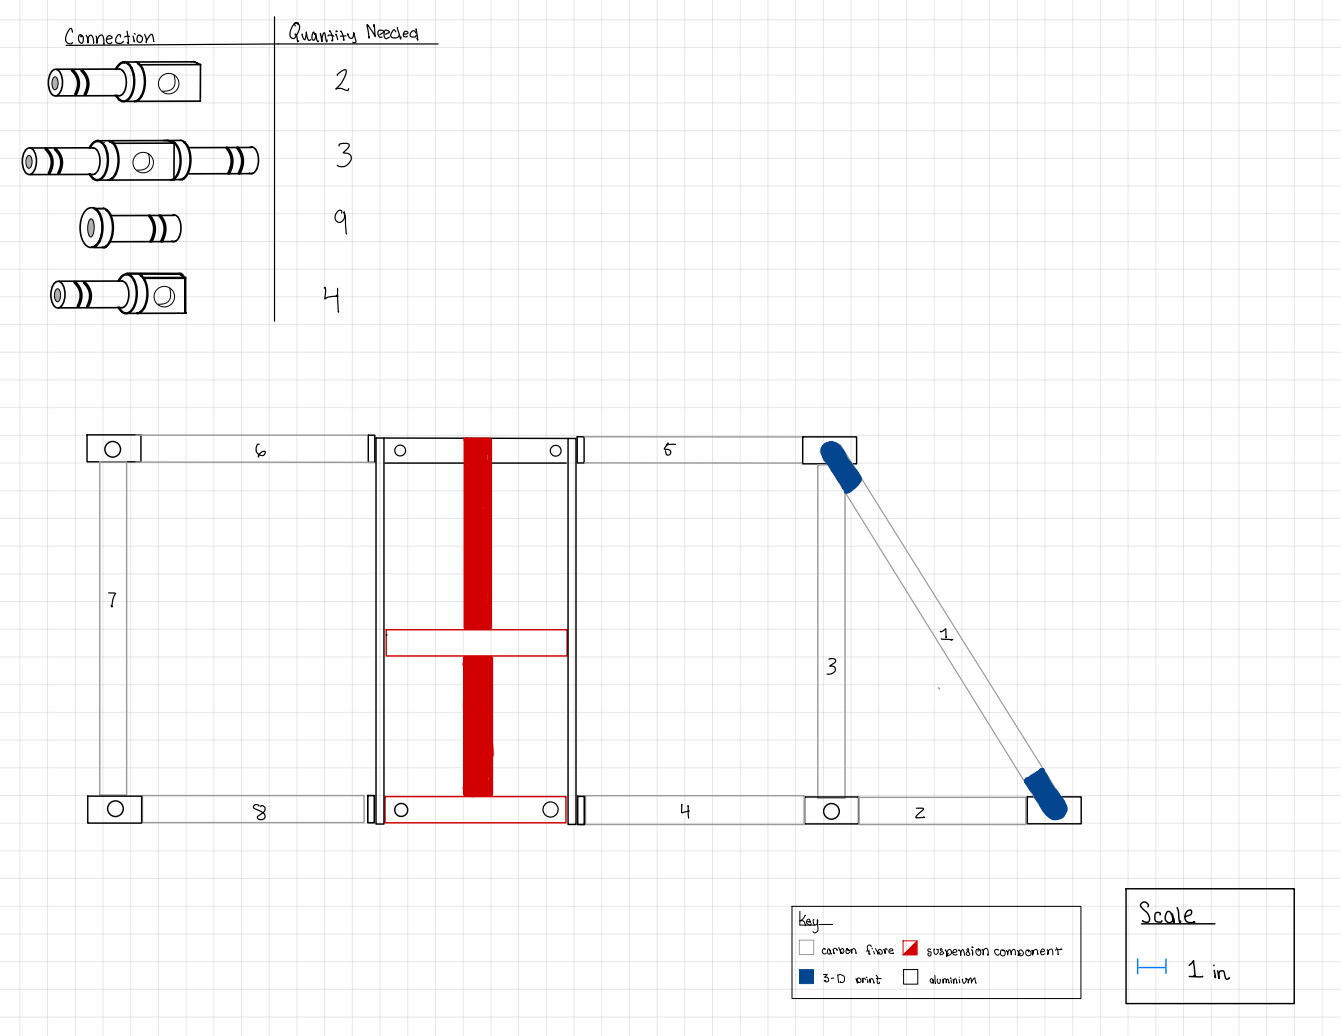
[picture p397: page 2]
Scale Sey; carbon; fibre suspension; component; print; aluminium

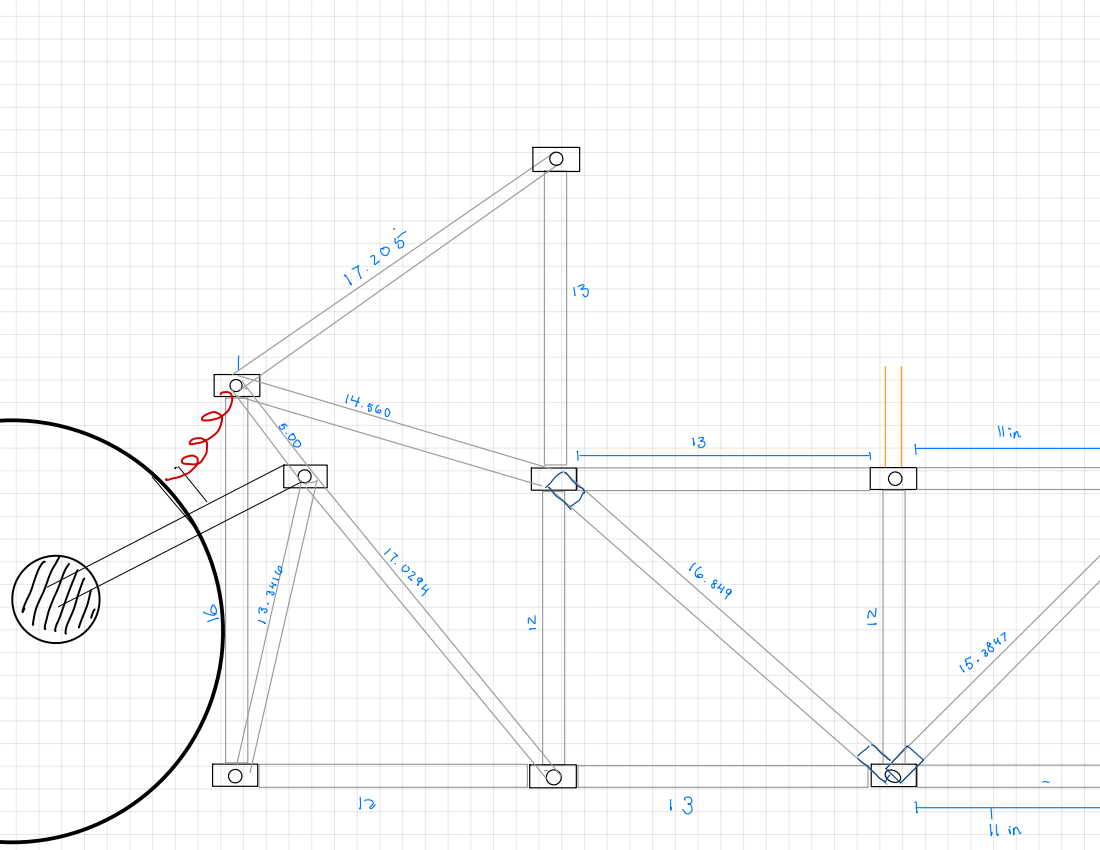
[picture p398: page 3]
IIIIIII

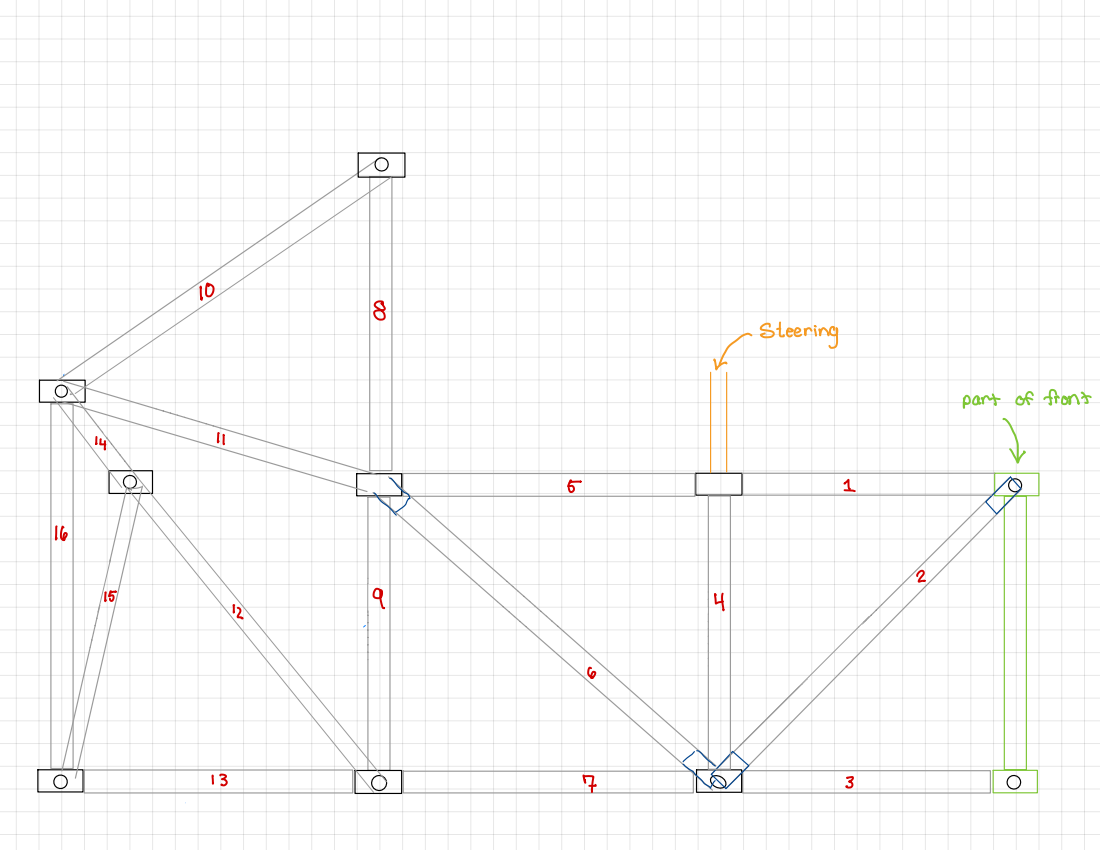
[picture p399: page 4]
/Steering M
