JeffreyLiang3449/HFCV-Website/2025 Summer Research/HFCV SummerPresentation_Jun25.pdf

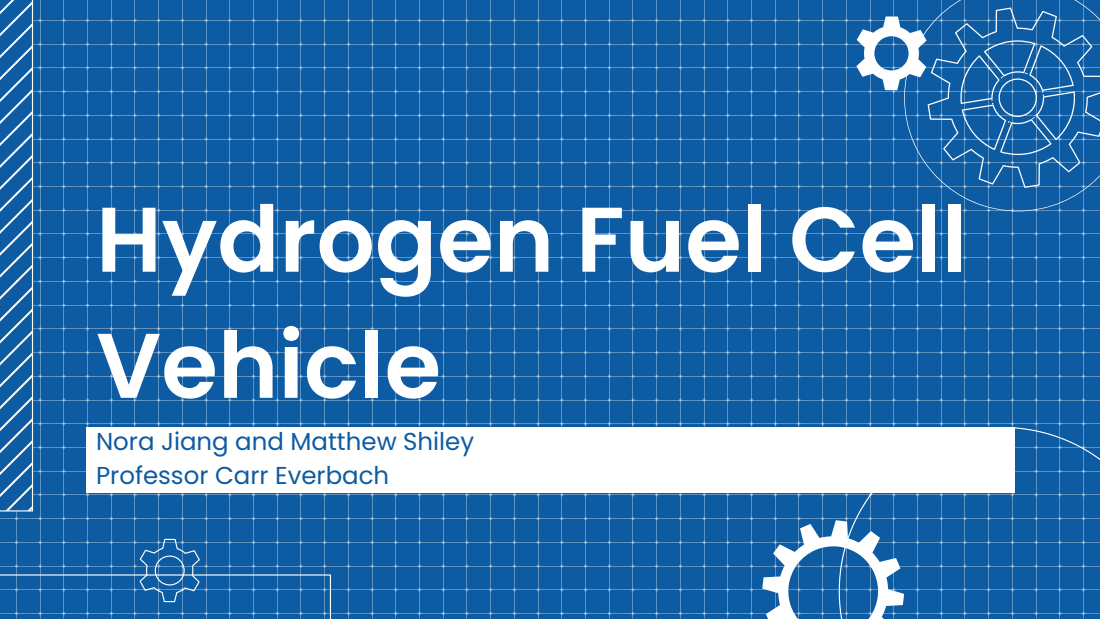
[picture p400: page 1]

Hydrogen Fuel Cell
Vehicle

Nora Jiang and Matthew Shiley
Professor Carr Everbach

# Table of contents

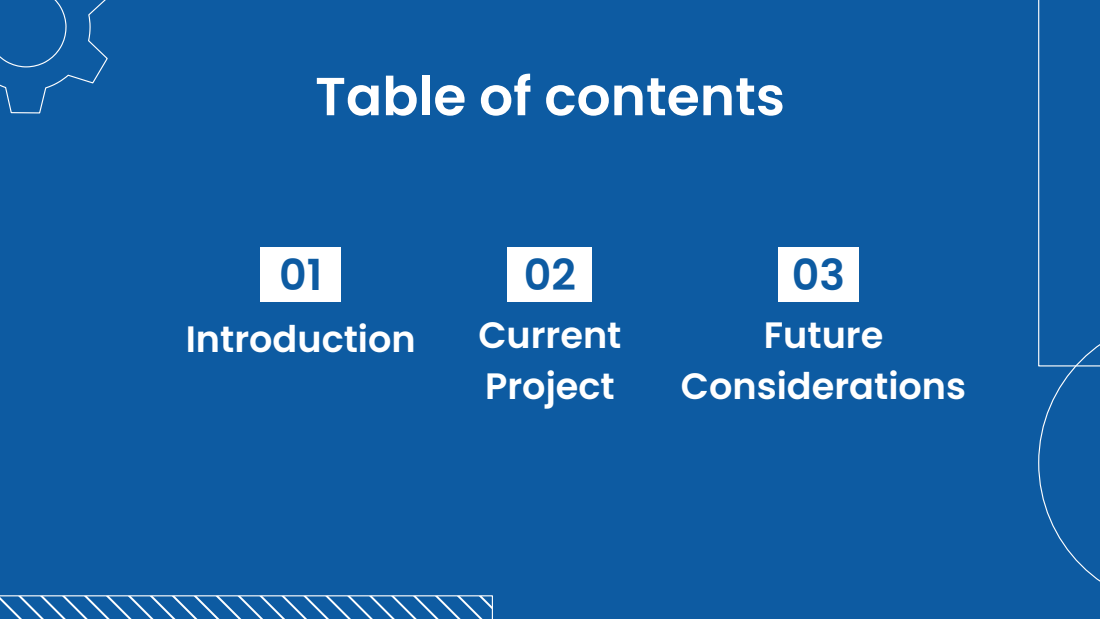
[picture p401: page 2]
03 Future Considerations; Introduction; Current; Project

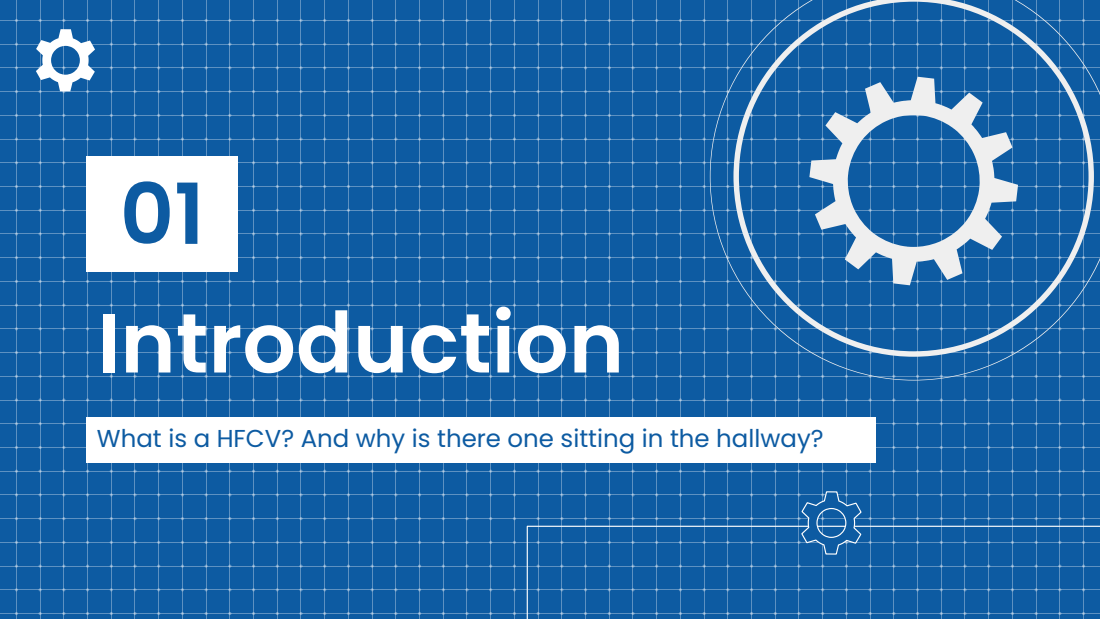
[picture p402: page 3]
Introduction

What is a HFCV? And why is there one sitting in the hallway?

# What you need to know first

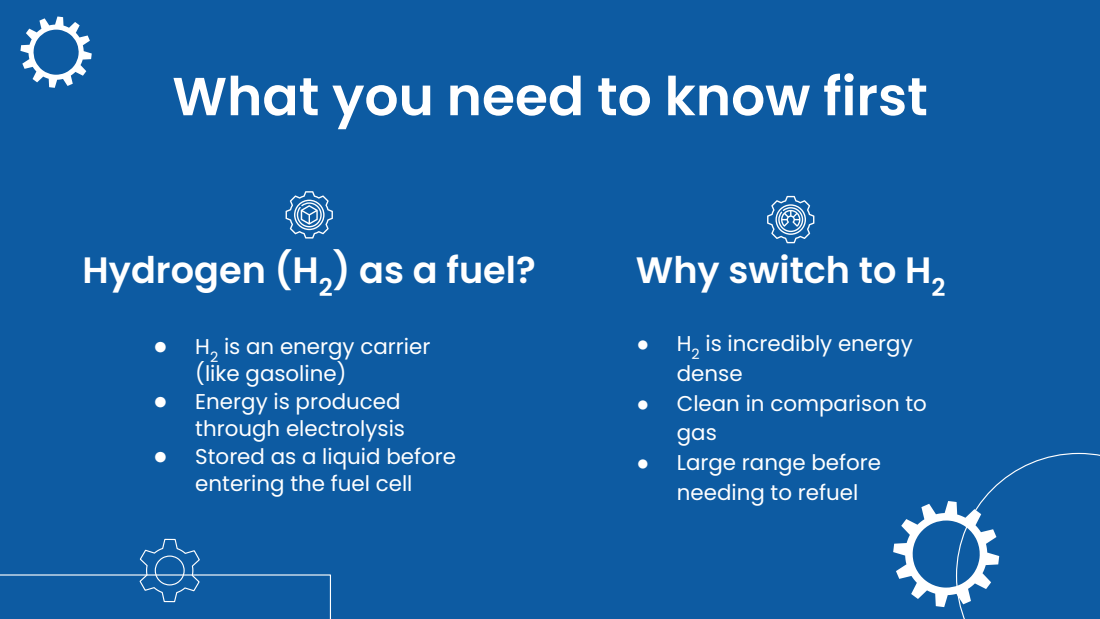
[picture p403: page 4]
Hydrogen (H2; ) as a fuel?

Why switch to H2

(like gasoline)
● Energy is produced
through electrolysis
● Stored as a liquid before
entering the fuel cell

is an energy carrier

dense
● Clean in comparison to
gas
● Large range before
needing to refuel

is incredibly energy

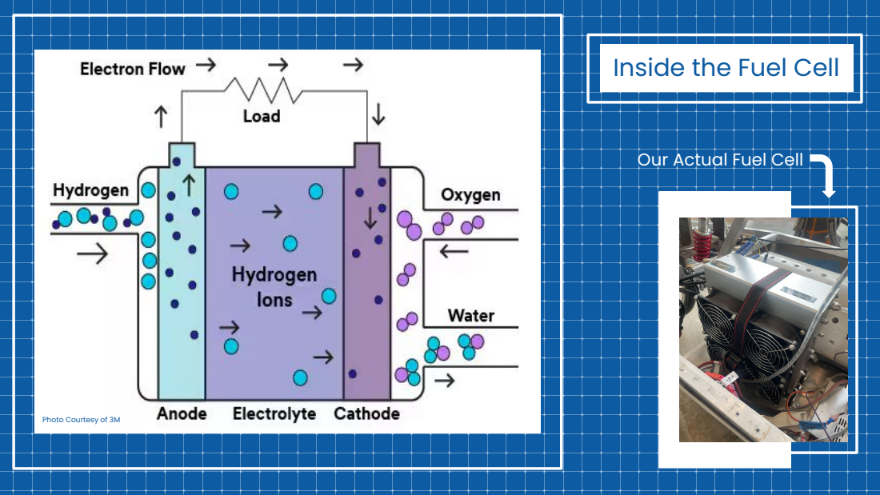
[picture p404: page 5]

Inside the Fuel Cell

Our Actual Fuel Cell

Photo Courtesy of 3M

# Shell Eco Marathon

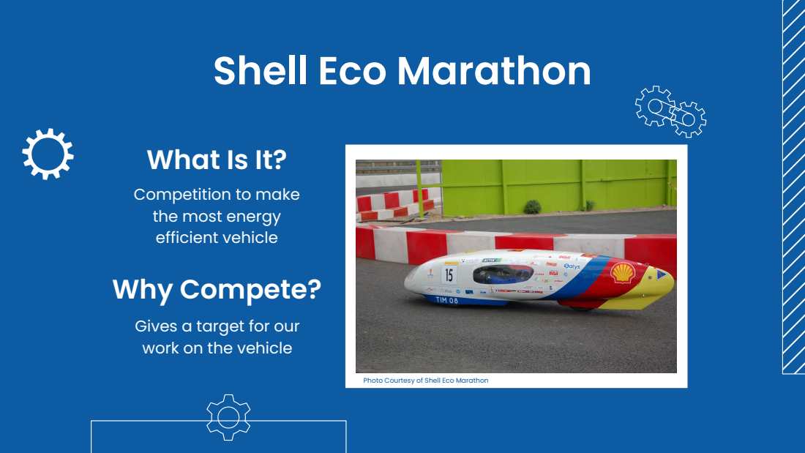
[picture p405: page 6]

What Is It?

Competition to make
the most energy
efficient vehicle
Why Compete?

Gives a target for our
work on the vehicle

Photo Courtesy of Shell Eco Marathon

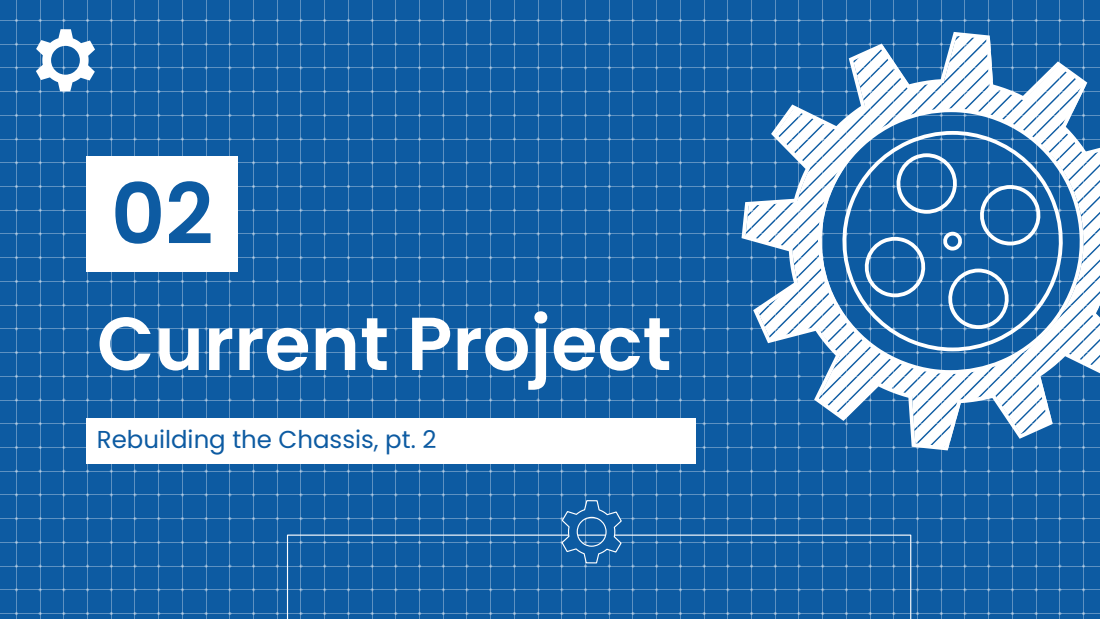
[picture p406: page 7]
Current Project

Rebuilding the Chassis, pt. 2

# Before This Summer

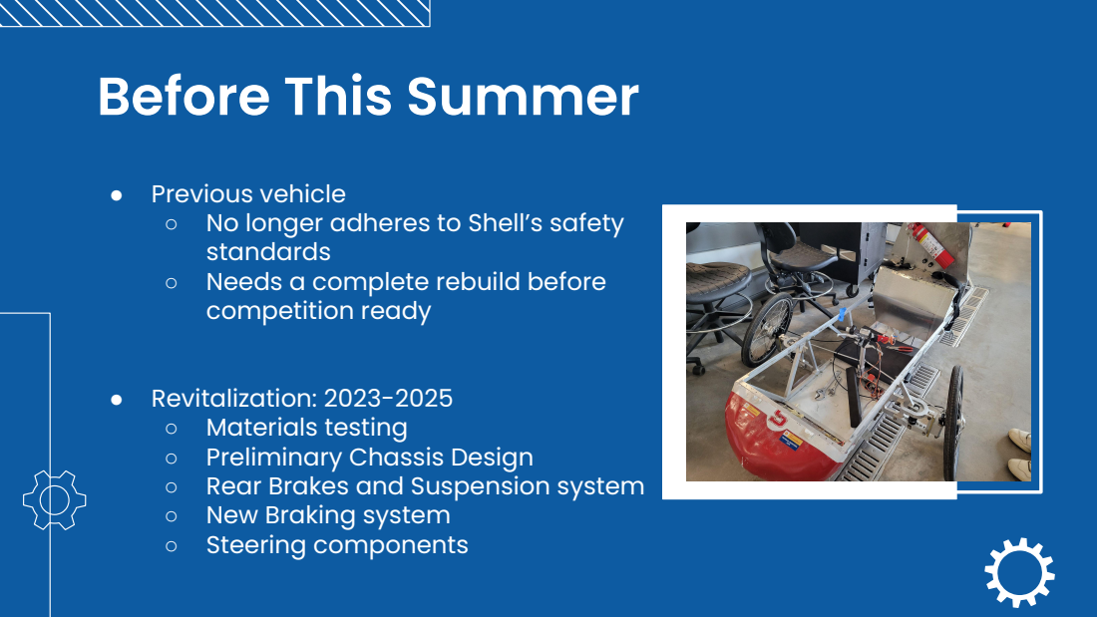
[picture p407: page 8]
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

# Progress So Far!

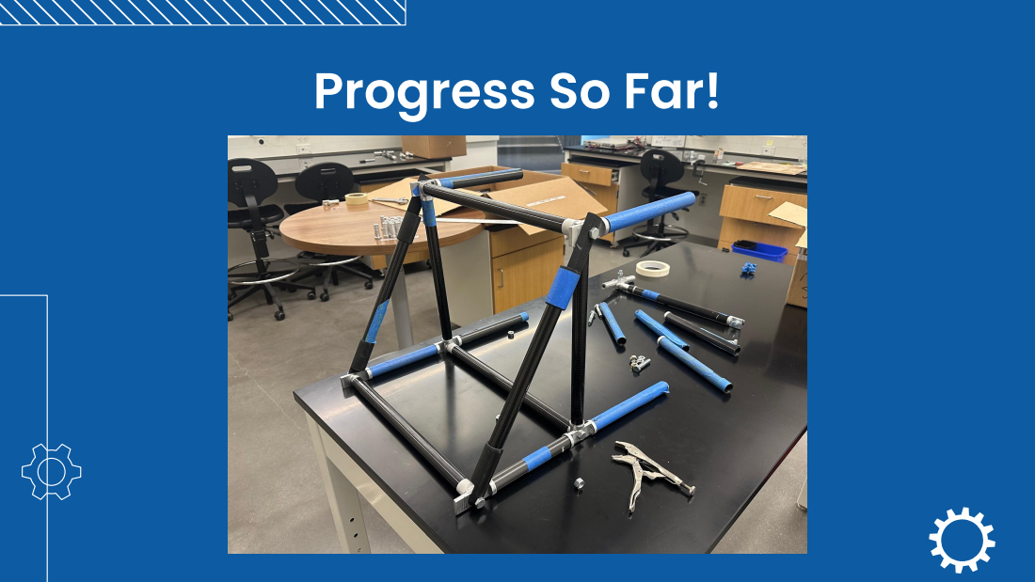
[picture p408: page 9]

# Rough Chassis Design Plan

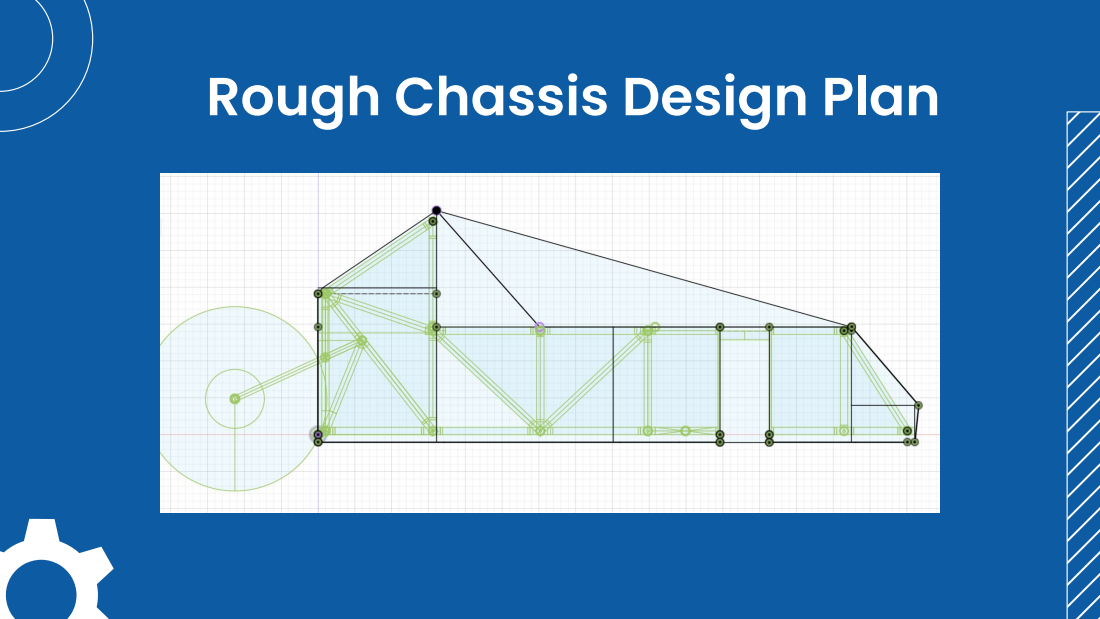
[picture p409: page 10]

# 3D Printed Clips

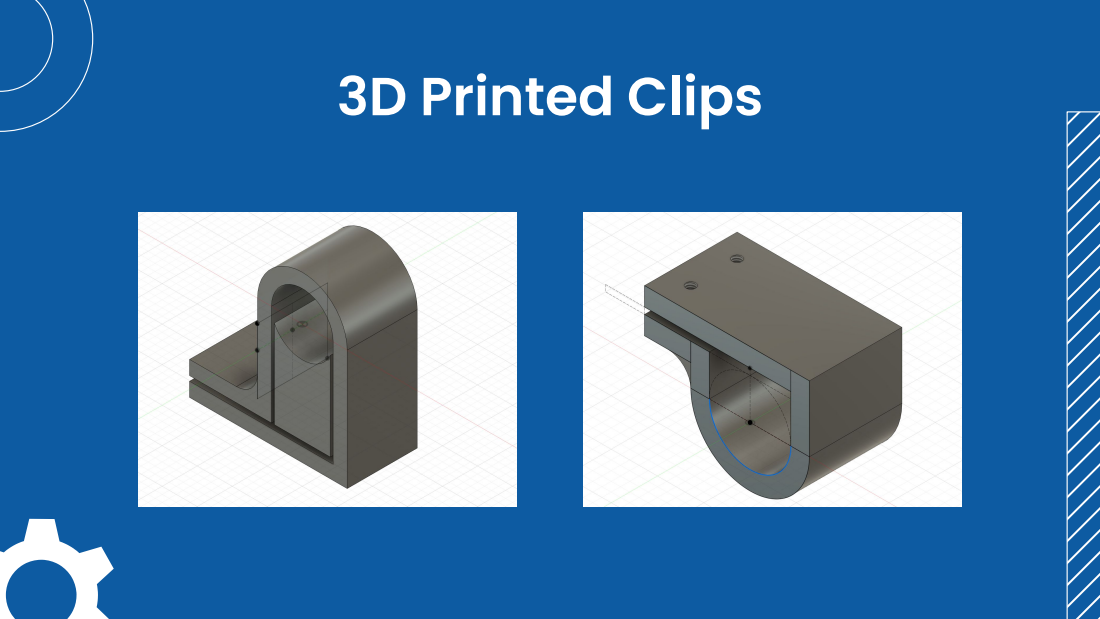
[picture p410: page 11]

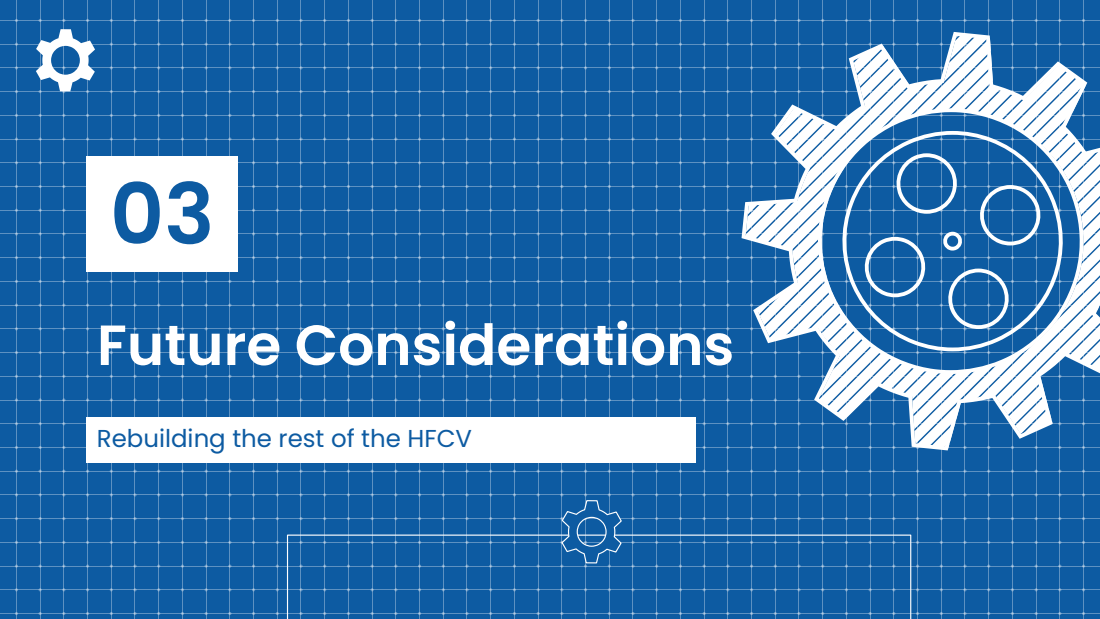
[picture p411: page 12]
Future Considerations

Rebuilding the rest of the HFCV

# The Next Year (or so)

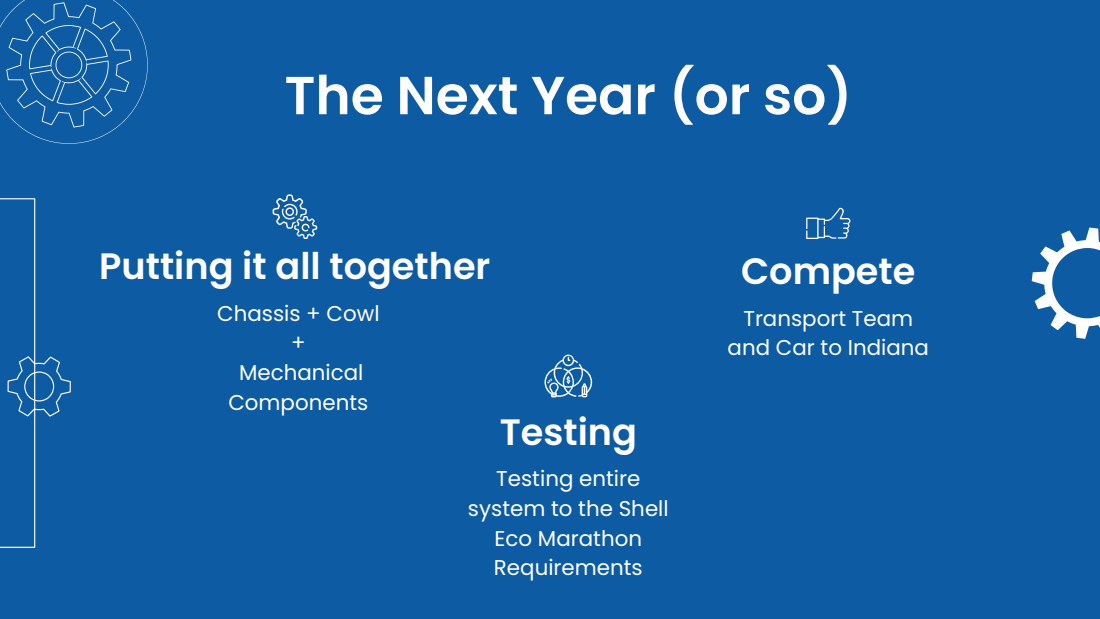
[picture p412: page 13]
Chassis + Cowl + Mechanical Components; Compete; Testing

Putting it all together

Transport Team
and Car to Indiana

Testing entire
system to the Shell
Eco Marathon
Requirements

# Thank you for

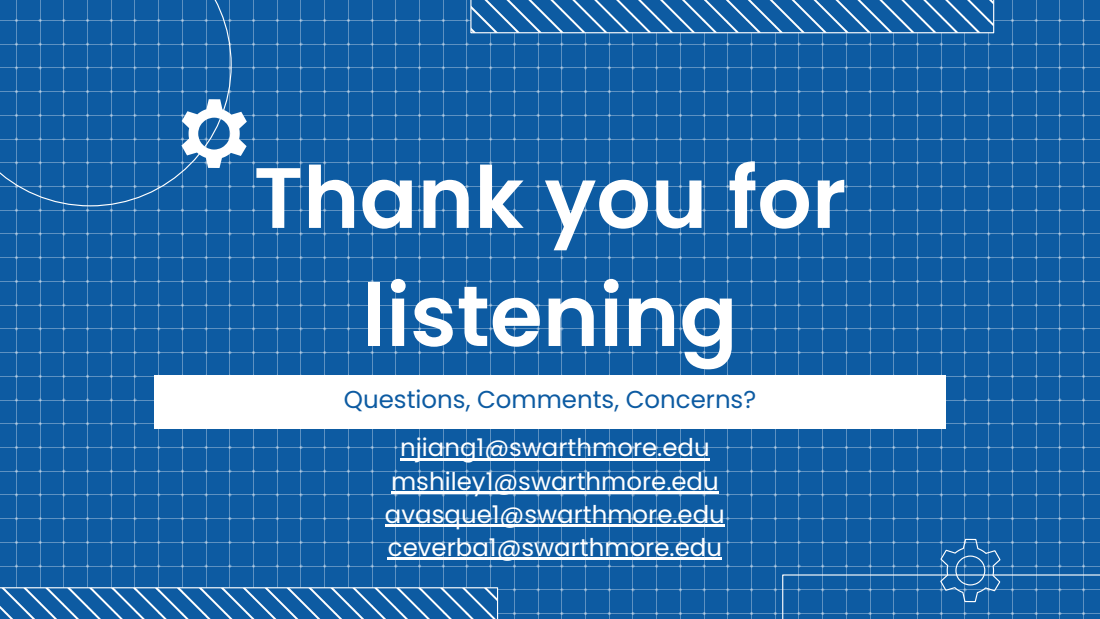
[picture p413: page 14]
listening

Questions, Comments, Concerns?
njiang1@swarthmore.edu
mshiley1@swarthmore.edu
avasque1@swarthmore.edu
ceverba1@swarthmore.edu
