JeffreyLiang3449/HFCV-Website/2024 E90 work/Chassis Model/3D collar Large Wrapped with clevis Drawing v2.pdf

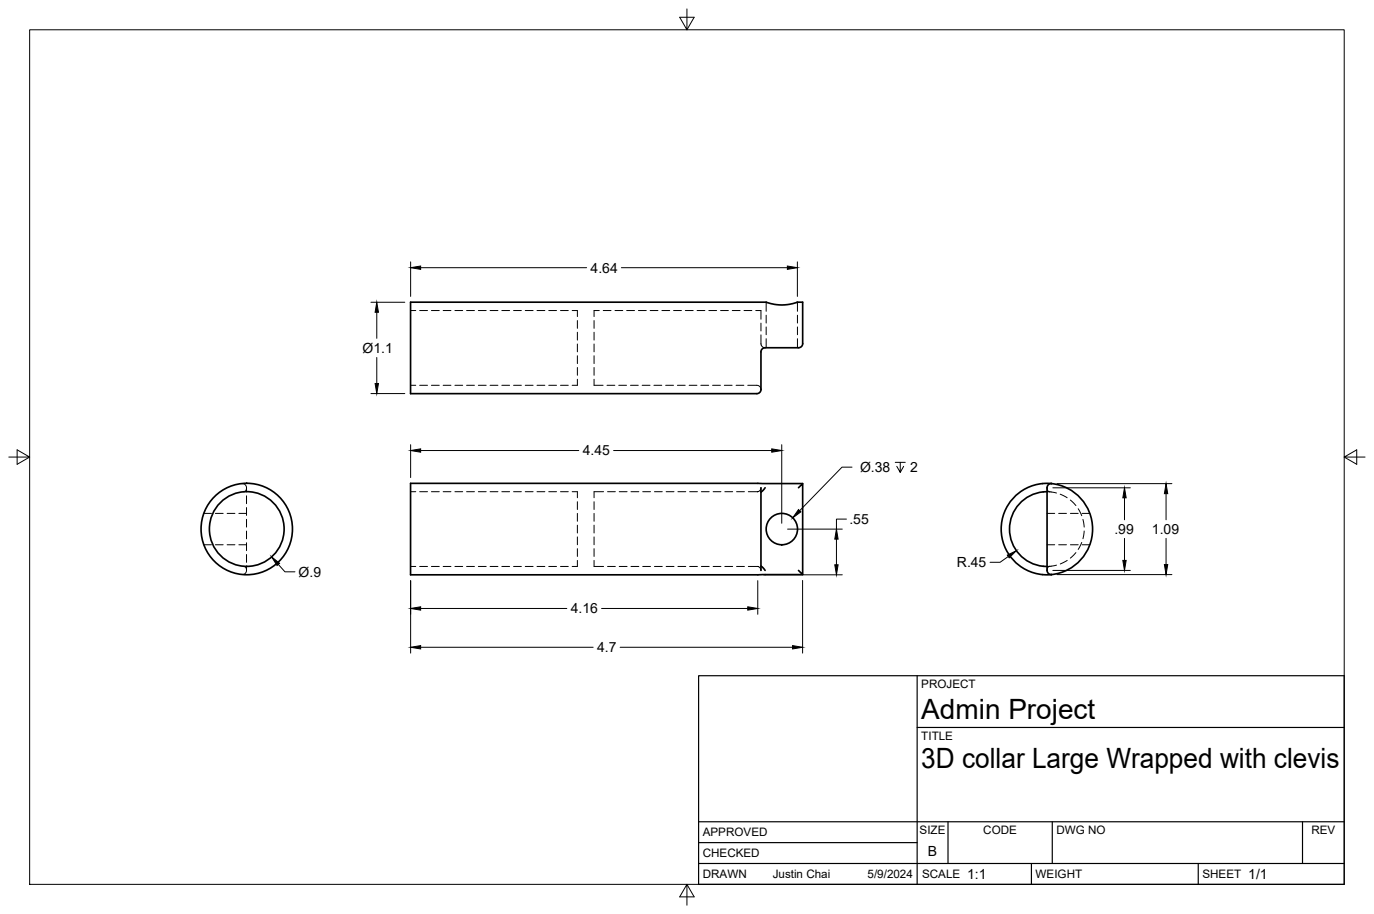
[picture p414: page 1]
SIZE; CODE; DWG NO; REV; Justin Chai

PROJECT
Admin Project
3D collar Large Wrapped with clevis
