JeffreyLiang3449/HFCV-Website/2024 E90 work/Chassis Model/Chassis Drawn Design.pdf

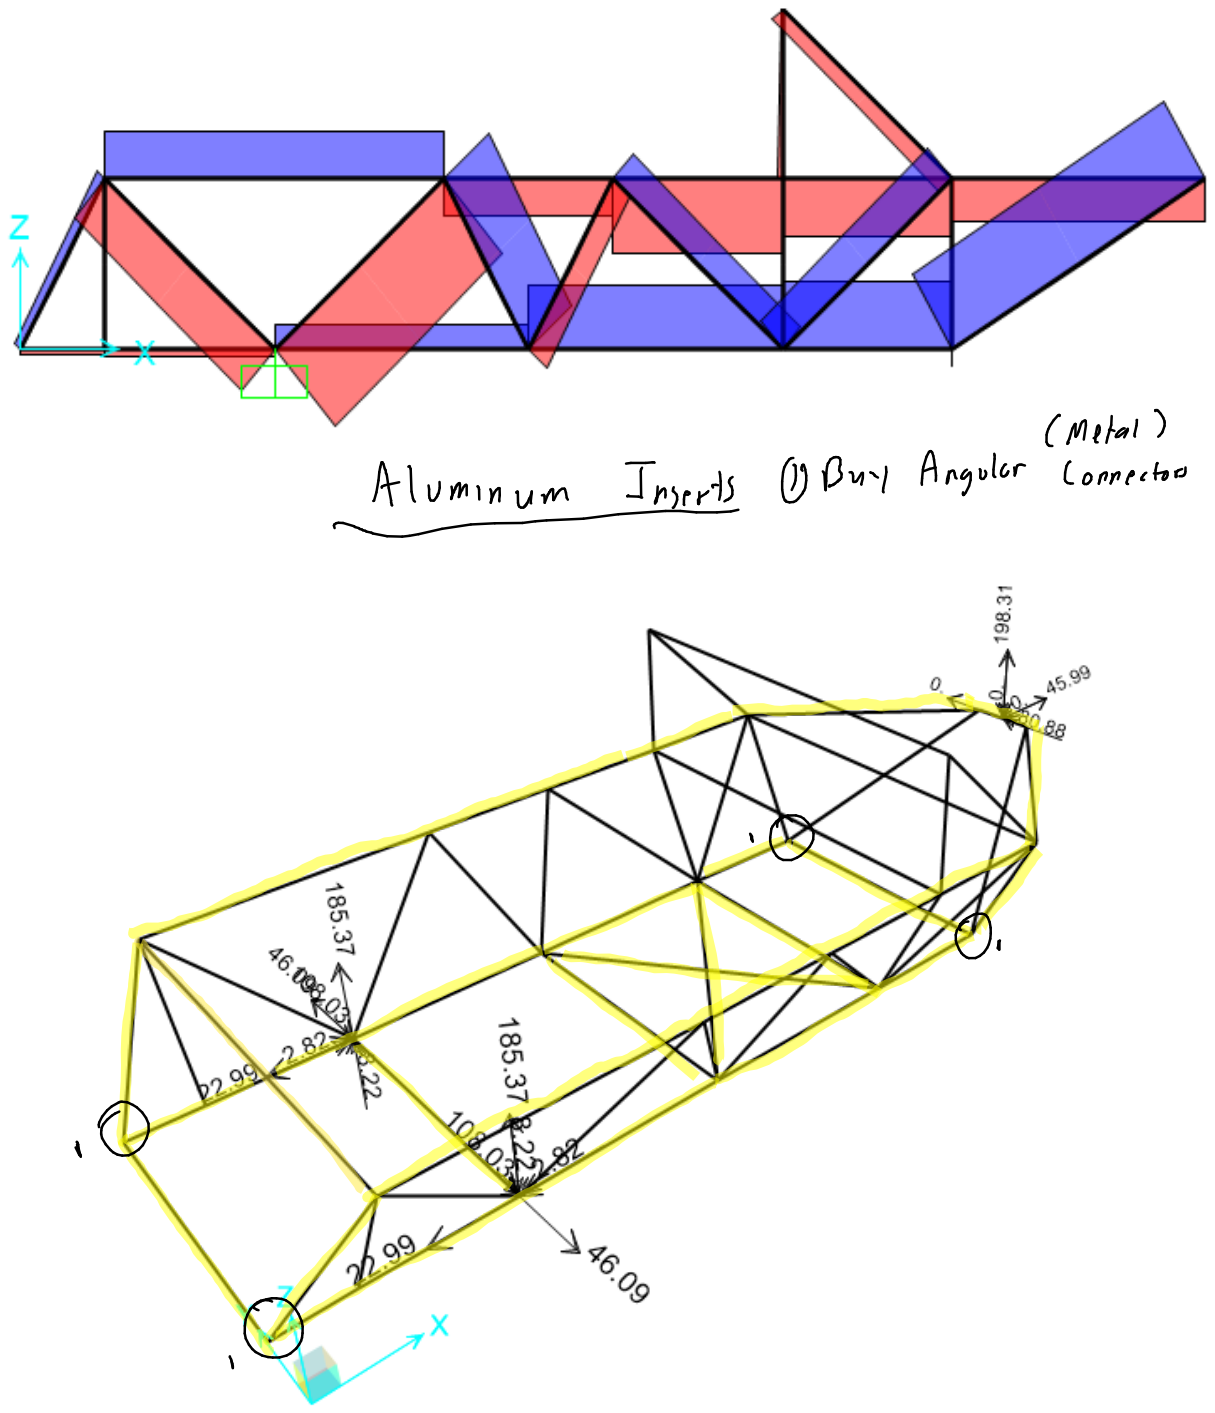
[picture p415: page 1]

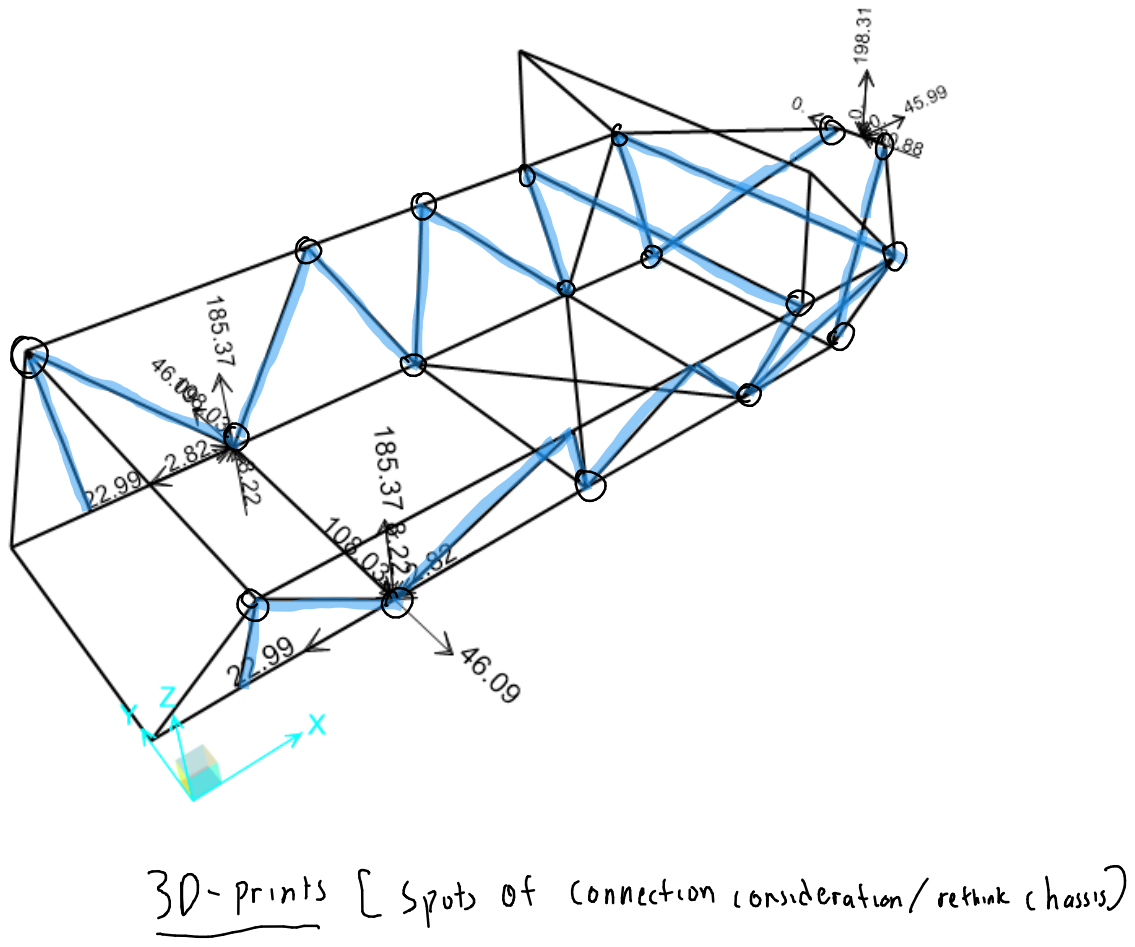
[picture p416: page 2]
