JeffreyLiang3449/HFCV-Website/2025 E90 work/Designs/Brake/Pedal Stand Drawing v1.pdf

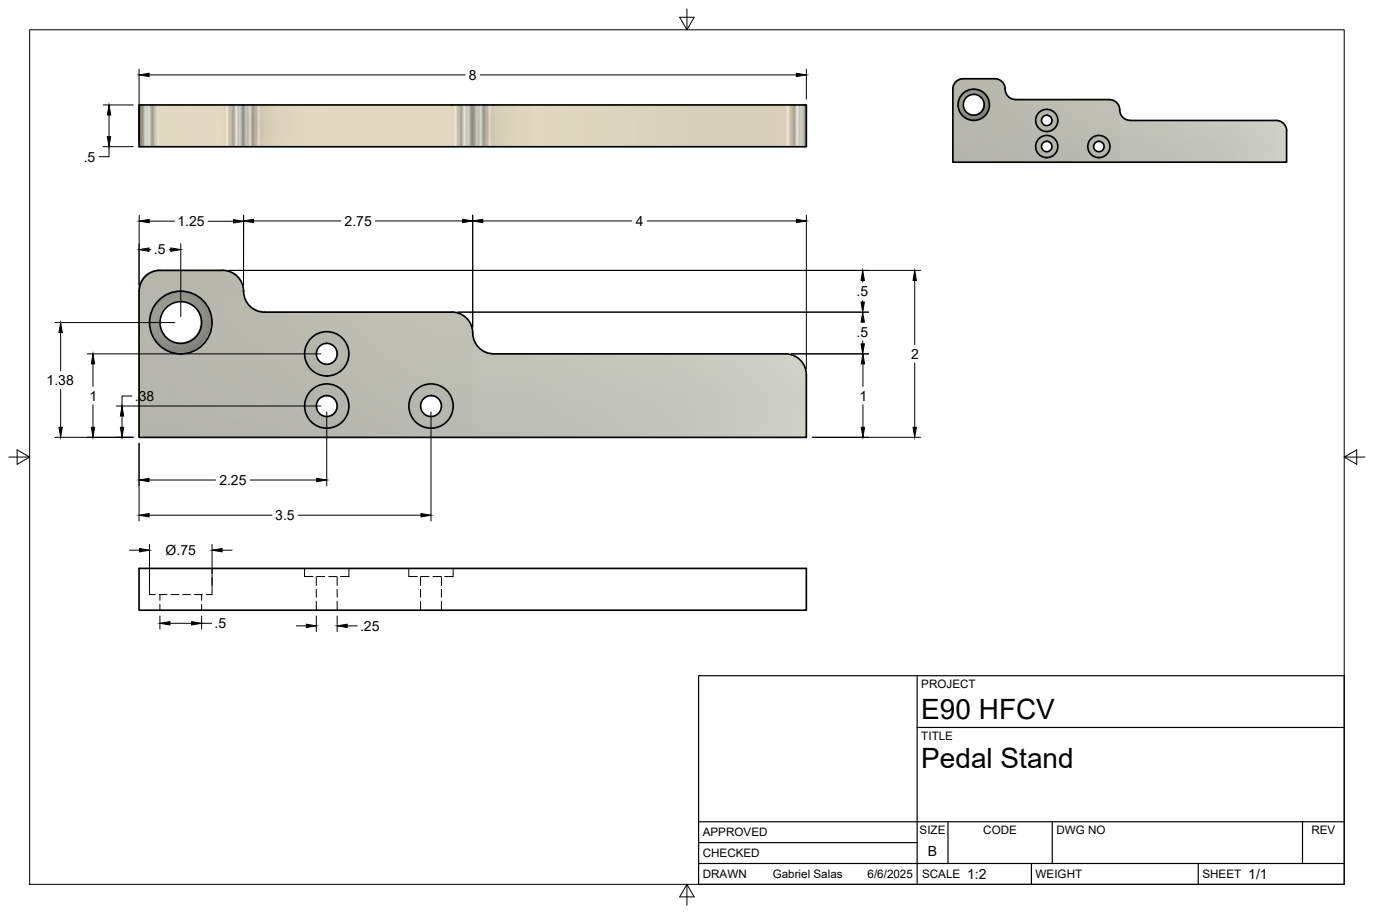
[picture p417: page 1]
SIZE; CODE; DWG NO; REV; Gabriel Salas; E90 HFCV; Pedal Stand
