JeffreyLiang3449/HFCV-Website/docs/2024 E90 work/Chassis Model/CAR DIMS.pdf

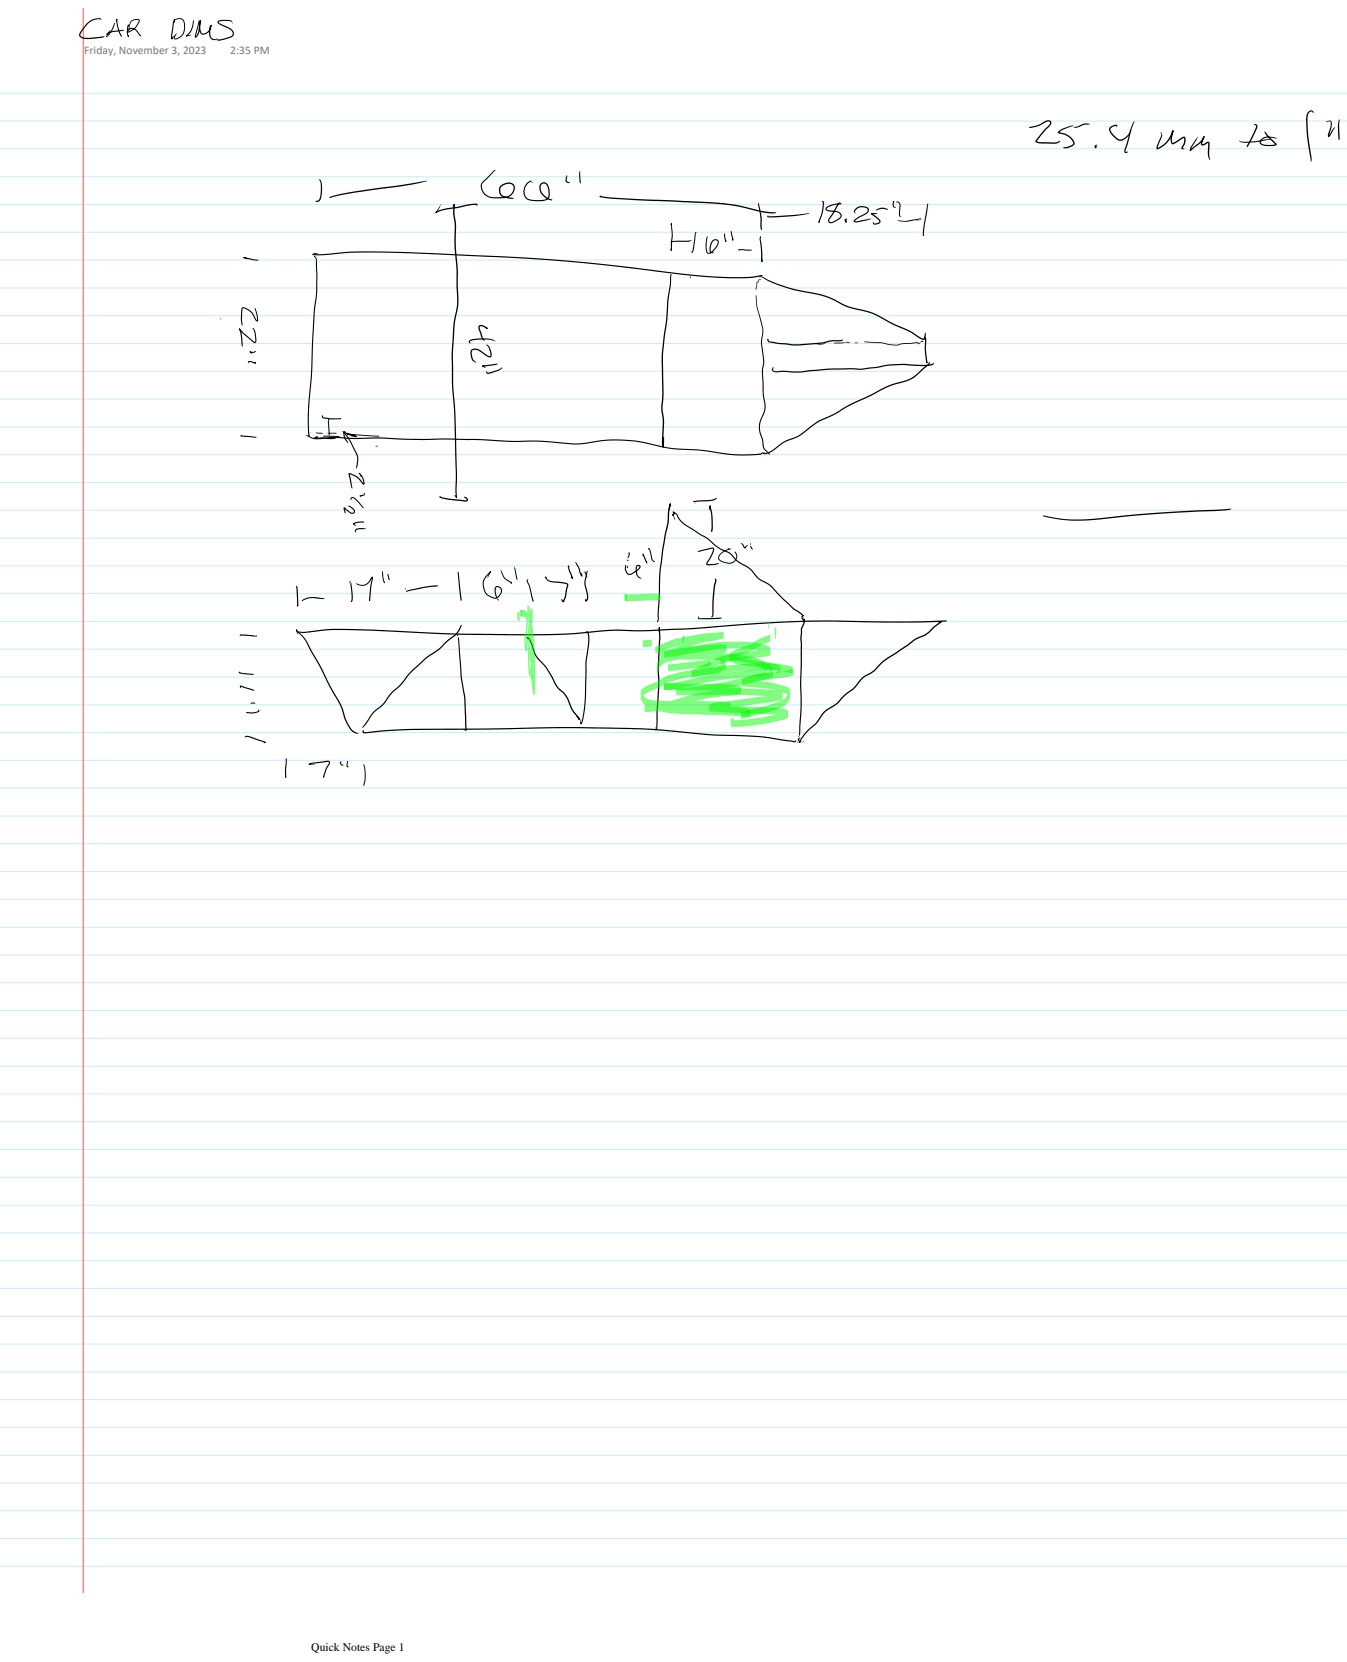
[picture p418: page 1]
Friday, November 3, 2023

Quick Notes Page 1
