JeffreyLiang3449/HFCV-Website/docs/2024 E90 work/Chassis Model/Chassis Drawn Design(1).pdf

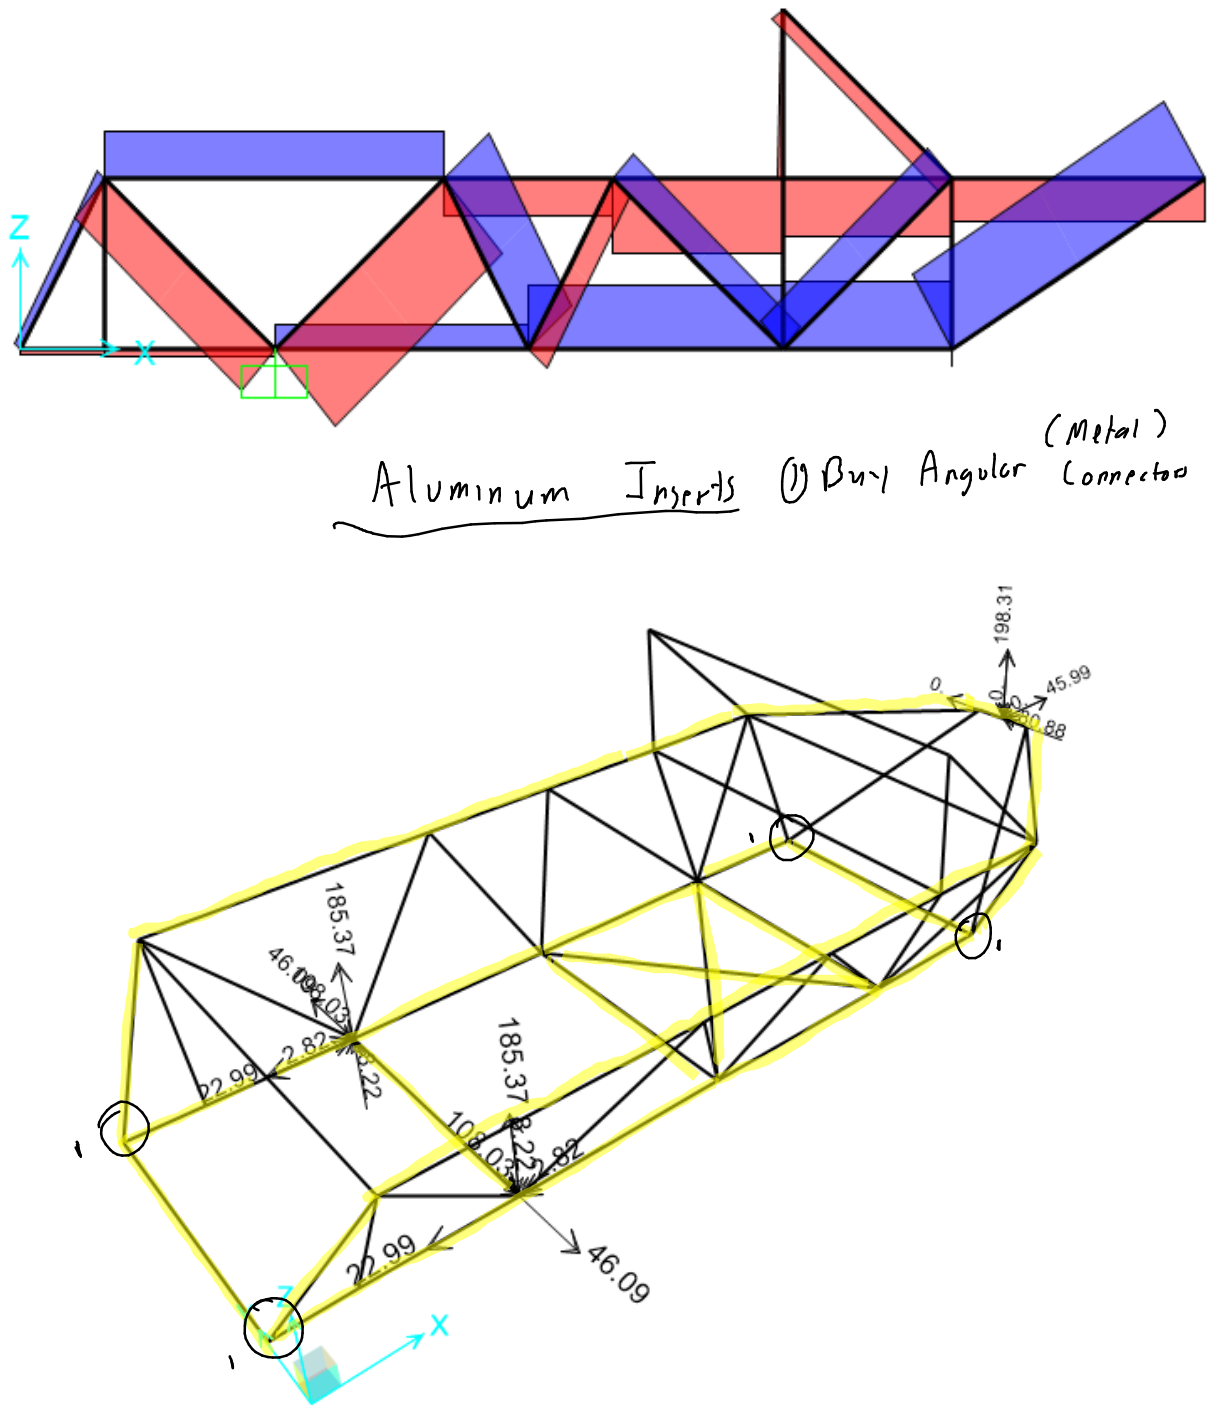
[picture p419: page 1]

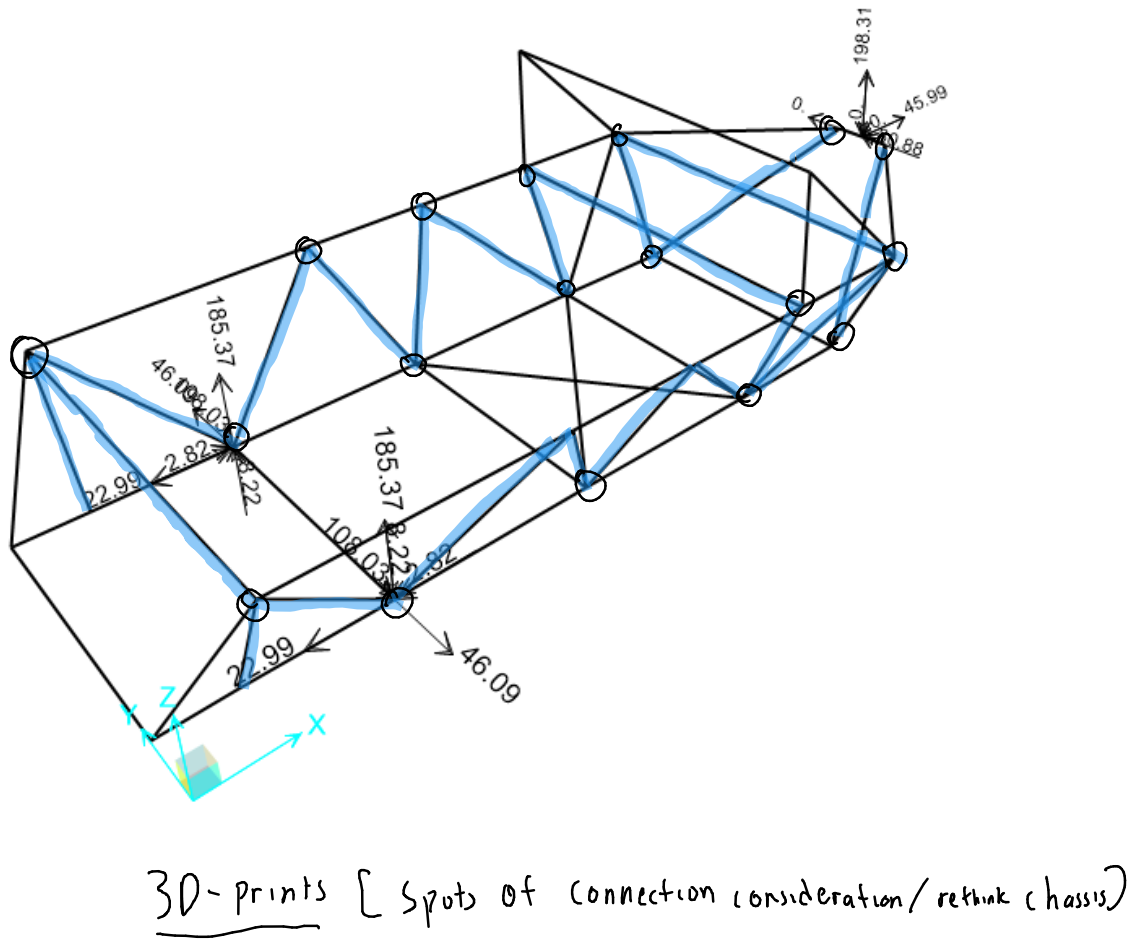
[picture p420: page 2]
