JeffreyLiang3449/HFCV-Website/(commit log)

2026-09-14 track big mp4 files
2026-09-14 initial commit for non-large files
    [3D collar Large Wrapped with clevis v1.f3d, Angled Modular Tube Connectors v1 v1.f3d, Brake Stand v22.f3d, Copy of HFCV PartsList 8_2.xlsx, Cowl_Jul18.f3d, Cowl_Jun23.f3d, E90 Budget + Cost Analysis.xlsx, E90 Calc Excel (OLD).xlsx]
