JeffreyLiang3449/HFCV-Website/2025 E90 work/Photos/20250411_135416.jpg

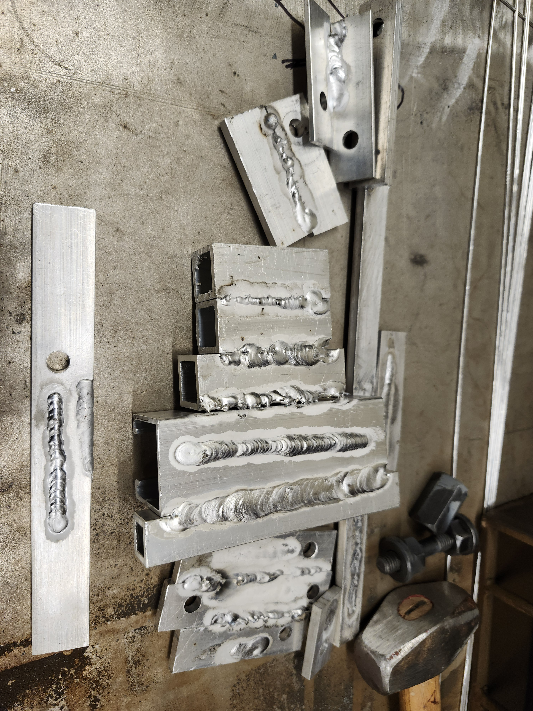
2025 E90 work/Photos/20250411_135416.jpg
